docquantum/skrach-synth/code/skrach_core/skrach_core.runs/impl_1/.init_design.begin.rst

<?xml version="1.0"?>
<ProcessHandle Version="1" Minor="0">
    <Process Command=".planAhead." Owner="docquantum" Host="" Pid="888812">
    </Process>
</ProcessHandle>
