docquantum/skrach-synth/code/Skrach/Skrach.runs/skrach_design_axi_smc_0_synth_1/.vivado.begin.rst

<?xml version="1.0"?>
<ProcessHandle Version="1" Minor="0">
    <Process Command="vivado" Owner="docquantum" Host="QuantumNet-L4" Pid="184551" HostCore="8" HostMemory="16304656">
    </Process>
</ProcessHandle>
