docquantum/skrach-synth/code/Skrach/Skrach.runs/skrach_design_axi_uartlite_0_3_synth_1/.vivado.begin.rst

<?xml version="1.0"?>
<ProcessHandle Version="1" Minor="0">
    <Process Command="vivado" Owner="docquantum" Host="QuantumNet-L4" Pid="186545" HostCore="8" HostMemory="16304656">
    </Process>
</ProcessHandle>
