docquantum/skrach-synth/docs/img/datapath_control.odp

Nexys Video FPGA

(Block Design)

UARTLite

MicroBlaze

Control

Skrach Core (AXI Lite)

Operator

(12 ops@16bits)

Audio Codec

PMOD

ScanCode

32x8

phase

Oscillator

waveSel

Status

Q9.7

2

32

ADSR

ADSR

Console Output

8x4

Ampl

USB
UART

UARTLite

8

Mixer

L/R Out

Codec clocks, etc

DAC_DATA
