docquantum/skrach-synth/docs/img/level_1_diagram.odp

Audio to headphones or speaker

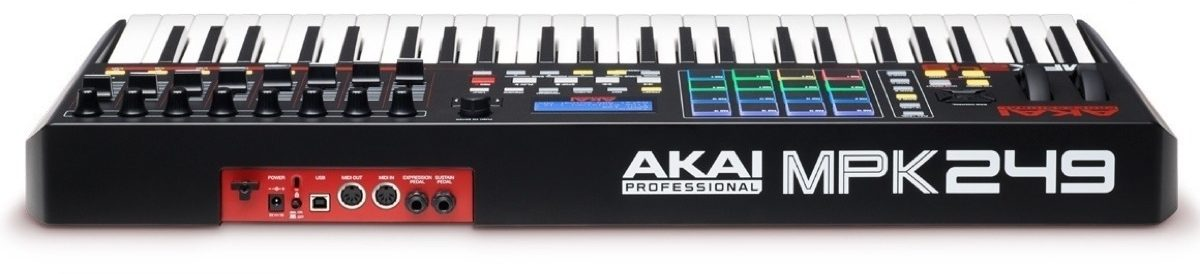
[picture p18: figure]
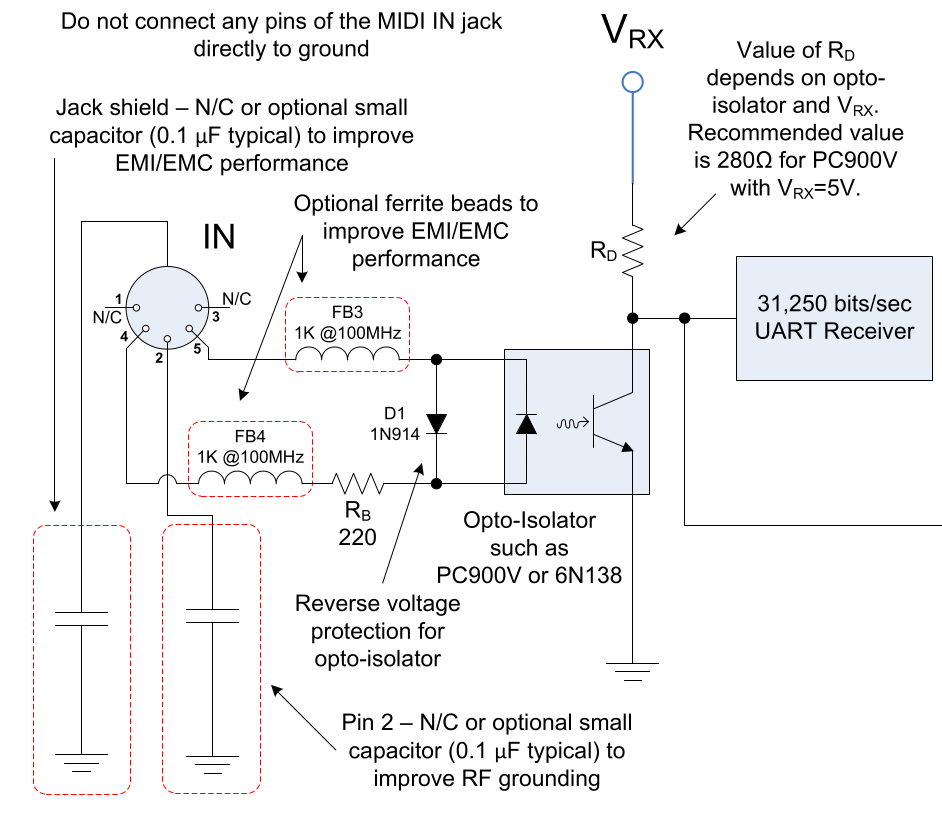
[picture p19: figure]
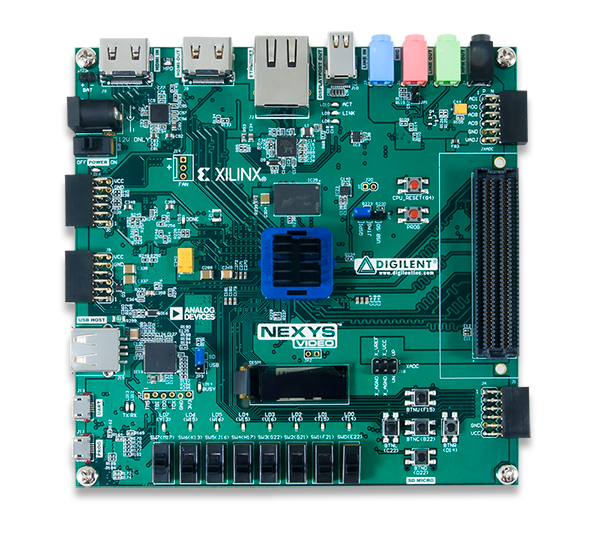
[picture p20: figure]

PMOD into board which implements the UART Receiver

Computer Control
