docquantum/skrach-synth/docs/img/fpga_connections.png

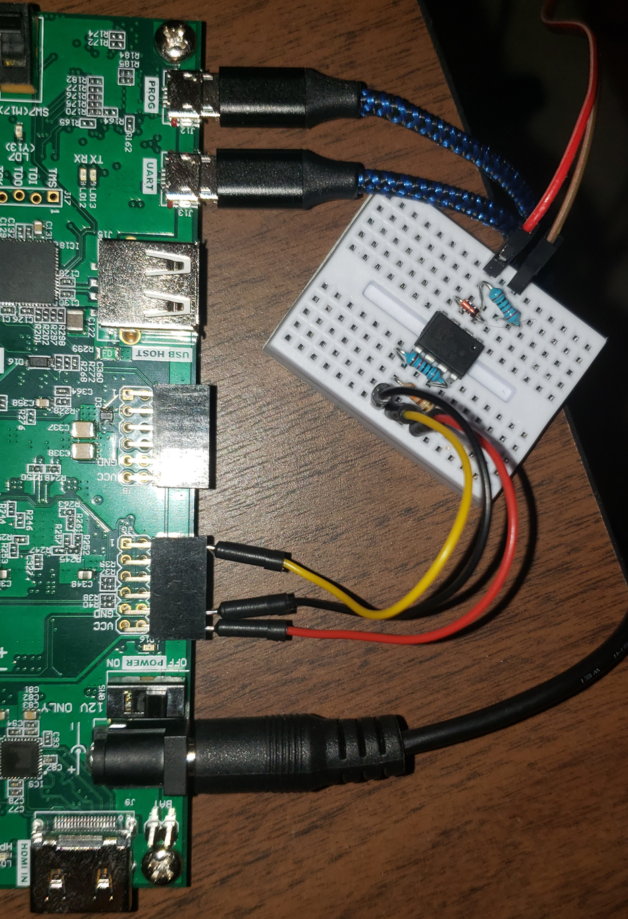
docs/img/fpga_connections.png
