docquantum/skrach-synth/(list of files, drawings)

Other design files:
docs/img/midiIn.fzz
