docquantum/skrach-synth/code/Skrach/Skrach.runs/skrach_design_axi_smc_0_synth_1/.Xil/skrach_design_axi_smc_0_propImpl.xdc

set_property SRC_FILE_INFO {cfile:/opt/Xilinx/Vivado/2019.1/data/ip/xpm/xpm_cdc/tcl/xpm_cdc_gray.tcl rfile:../../../../../../../../opt/Xilinx/Vivado/2019.1/data/ip/xpm/xpm_cdc/tcl/xpm_cdc_gray.tcl id:1 order:LATE scoped_inst:inst/m00_nodes/m00_ar_node/inst/inst_mi_handler/gen_normal_area.inst_fifo_node_payld/gen_xpm_memory_fifo.inst_fifo/gen_async_clocks.inst_cdc_addra_to_rd_clk unmanaged:yes} [current_design]
set_property SRC_FILE_INFO {cfile:/opt/Xilinx/Vivado/2019.1/data/ip/xpm/xpm_cdc/tcl/xpm_cdc_gray.tcl rfile:../../../../../../../../opt/Xilinx/Vivado/2019.1/data/ip/xpm/xpm_cdc/tcl/xpm_cdc_gray.tcl id:2 order:LATE scoped_inst:inst/m00_nodes/m00_ar_node/inst/inst_mi_handler/gen_normal_area.inst_fifo_node_payld/gen_xpm_memory_fifo.inst_fifo/gen_async_clocks.inst_cdc_addrb_to_wr_clk unmanaged:yes} [current_design]
set_property SRC_FILE_INFO {cfile:/opt/Xilinx/Vivado/2019.1/data/ip/xpm/xpm_cdc/tcl/xpm_cdc_gray.tcl rfile:../../../../../../../../opt/Xilinx/Vivado/2019.1/data/ip/xpm/xpm_cdc/tcl/xpm_cdc_gray.tcl id:3 order:LATE scoped_inst:inst/m00_nodes/m00_aw_node/inst/inst_mi_handler/gen_normal_area.inst_fifo_node_payld/gen_xpm_memory_fifo.inst_fifo/gen_async_clocks.inst_cdc_addra_to_rd_clk unmanaged:yes} [current_design]
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
set_property SRC_FILE_INFO {cfile:/opt/Xilinx/Vivado/2019.1/data/ip/xpm/xpm_memory/tcl/xpm_memory_xdc.tcl rfile:../../../../../../../../opt/Xilinx/Vivado/2019.1/data/ip/xpm/xpm_memory/tcl/xpm_memory_xdc.tcl id:22 order:LATE scoped_inst:{inst/m00_nodes/m00_w_node/inst/inst_si_handler/gen_si_handler.gen_request_fifos.gen_req_fifo[0].inst_req_fifo/gen_xpm_memory_fifo.inst_fifo/gen_mem_rep[0].inst_xpm_memory} unmanaged:yes} [current_design]
set_property SRC_FILE_INFO {cfile:/opt/Xilinx/Vivado/2019.1/data/ip/xpm/xpm_memory/tcl/xpm_memory_xdc.tcl rfile:../../../../../../../../opt/Xilinx/Vivado/2019.1/data/ip/xpm/xpm_memory/tcl/xpm_memory_xdc.tcl id:23 order:LATE scoped_inst:{inst/m00_nodes/m00_w_node/inst/inst_si_handler/gen_si_handler.gen_request_fifos.gen_req_fifo[1].inst_req_fifo/gen_xpm_memory_fifo.inst_fifo/gen_mem_rep[0].inst_xpm_memory} unmanaged:yes} [current_design]
set_property SRC_FILE_INFO {cfile:/opt/Xilinx/Vivado/2019.1/data/ip/xpm/xpm_memory/tcl/xpm_memory_xdc.tcl rfile:../../../../../../../../opt/Xilinx/Vivado/2019.1/data/ip/xpm/xpm_memory/tcl/xpm_memory_xdc.tcl id:24 order:LATE scoped_inst:{inst/m00_nodes/m00_w_node/inst/inst_mi_handler/gen_normal_area.inst_fifo_node_payld/gen_xpm_memory_fifo.inst_fifo/gen_mem_rep[0].inst_xpm_memory} unmanaged:yes} [current_design]
set_property SRC_FILE_INFO {cfile:/opt/Xilinx/Vivado/2019.1/data/ip/xpm/xpm_memory/tcl/xpm_memory_xdc.tcl rfile:../../../../../../../../opt/Xilinx/Vivado/2019.1/data/ip/xpm/xpm_memory/tcl/xpm_memory_xdc.tcl id:25 order:LATE scoped_inst:{inst/s00_nodes/s00_ar_node/inst/inst_mi_handler/gen_normal_area.gen_fifo_req.inst_fifo_req/gen_xpm_memory_fifo.inst_fifo/gen_mem_rep[0].inst_xpm_memory} unmanaged:yes} [current_design]
set_property SRC_FILE_INFO {cfile:/opt/Xilinx/Vivado/2019.1/data/ip/xpm/xpm_memory/tcl/xpm_memory_xdc.tcl rfile:../../../../../../../../opt/Xilinx/Vivado/2019.1/data/ip/xpm/xpm_memory/tcl/xpm_memory_xdc.tcl id:26 order:LATE scoped_inst:{inst/s00_nodes/s00_aw_node/inst/inst_mi_handler/gen_normal_area.gen_fifo_req.inst_fifo_req/gen_xpm_memory_fifo.inst_fifo/gen_mem_rep[0].inst_xpm_memory} unmanaged:yes} [current_design]
set_property SRC_FILE_INFO {cfile:/opt/Xilinx/Vivado/2019.1/data/ip/xpm/xpm_memory/tcl/xpm_memory_xdc.tcl rfile:../../../../../../../../opt/Xilinx/Vivado/2019.1/data/ip/xpm/xpm_memory/tcl/xpm_memory_xdc.tcl id:27 order:LATE scoped_inst:{inst/s00_nodes/s00_w_node/inst/inst_mi_handler/gen_normal_area.gen_fifo_req.inst_fifo_req/gen_xpm_memory_fifo.inst_fifo/gen_mem_rep[0].inst_xpm_memory} unmanaged:yes} [current_design]
set_property SRC_FILE_INFO {cfile:/opt/Xilinx/Vivado/2019.1/data/ip/xpm/xpm_memory/tcl/xpm_memory_xdc.tcl rfile:../../../../../../../../opt/Xilinx/Vivado/2019.1/data/ip/xpm/xpm_memory/tcl/xpm_memory_xdc.tcl id:28 order:LATE scoped_inst:{inst/s01_nodes/s01_ar_node/inst/inst_mi_handler/gen_normal_area.gen_fifo_req.inst_fifo_req/gen_xpm_memory_fifo.inst_fifo/gen_mem_rep[0].inst_xpm_memory} unmanaged:yes} [current_design]
set_property SRC_FILE_INFO {cfile:/opt/Xilinx/Vivado/2019.1/data/ip/xpm/xpm_memory/tcl/xpm_memory_xdc.tcl rfile:../../../../../../../../opt/Xilinx/Vivado/2019.1/data/ip/xpm/xpm_memory/tcl/xpm_memory_xdc.tcl id:29 order:LATE scoped_inst:{inst/s00_nodes/s00_ar_node/inst/inst_mi_handler/gen_normal_area.inst_fifo_node_payld/gen_xpm_memory_fifo.inst_fifo/gen_mem_rep[0].inst_xpm_memory} unmanaged:yes} [current_design]
set_property SRC_FILE_INFO {cfile:/opt/Xilinx/Vivado/2019.1/data/ip/xpm/xpm_memory/tcl/xpm_memory_xdc.tcl rfile:../../../../../../../../opt/Xilinx/Vivado/2019.1/data/ip/xpm/xpm_memory/tcl/xpm_memory_xdc.tcl id:30 order:LATE scoped_inst:{inst/s00_nodes/s00_aw_node/inst/inst_mi_handler/gen_normal_area.inst_fifo_node_payld/gen_xpm_memory_fifo.inst_fifo/gen_mem_rep[0].inst_xpm_memory} unmanaged:yes} [current_design]
set_property SRC_FILE_INFO {cfile:/opt/Xilinx/Vivado/2019.1/data/ip/xpm/xpm_memory/tcl/xpm_memory_xdc.tcl rfile:../../../../../../../../opt/Xilinx/Vivado/2019.1/data/ip/xpm/xpm_memory/tcl/xpm_memory_xdc.tcl id:31 order:LATE scoped_inst:{inst/s01_nodes/s01_ar_node/inst/inst_mi_handler/gen_normal_area.inst_fifo_node_payld/gen_xpm_memory_fifo.inst_fifo/gen_mem_rep[0].inst_xpm_memory} unmanaged:yes} [current_design]
set_property SRC_FILE_INFO {cfile:/opt/Xilinx/Vivado/2019.1/data/ip/xpm/xpm_memory/tcl/xpm_memory_xdc.tcl rfile:../../../../../../../../opt/Xilinx/Vivado/2019.1/data/ip/xpm/xpm_memory/tcl/xpm_memory_xdc.tcl id:32 order:LATE scoped_inst:{inst/s00_nodes/s00_b_node/inst/inst_mi_handler/gen_normal_area.gen_node_prog_full.inst_node_prog_full/gen_xpm_memory_fifo.inst_fifo/gen_mem_rep[0].inst_xpm_memory} unmanaged:yes} [current_design]
set_property SRC_FILE_INFO {cfile:/opt/Xilinx/Vivado/2019.1/data/ip/xpm/xpm_memory/tcl/xpm_memory_xdc.tcl rfile:../../../../../../../../opt/Xilinx/Vivado/2019.1/data/ip/xpm/xpm_memory/tcl/xpm_memory_xdc.tcl id:33 order:LATE scoped_inst:{inst/s00_nodes/s00_r_node/inst/inst_mi_handler/gen_normal_area.gen_node_prog_full.inst_node_prog_full/gen_xpm_memory_fifo.inst_fifo/gen_mem_rep[0].inst_xpm_memory} unmanaged:yes} [current_design]
set_property SRC_FILE_INFO {cfile:/opt/Xilinx/Vivado/2019.1/data/ip/xpm/xpm_memory/tcl/xpm_memory_xdc.tcl rfile:../../../../../../../../opt/Xilinx/Vivado/2019.1/data/ip/xpm/xpm_memory/tcl/xpm_memory_xdc.tcl id:34 order:LATE scoped_inst:{inst/s01_nodes/s01_r_node/inst/inst_mi_handler/gen_normal_area.gen_node_prog_full.inst_node_prog_full/gen_xpm_memory_fifo.inst_fifo/gen_mem_rep[0].inst_xpm_memory} unmanaged:yes} [current_design]
set_property SRC_FILE_INFO {cfile:/opt/Xilinx/Vivado/2019.1/data/ip/xpm/xpm_memory/tcl/xpm_memory_xdc.tcl rfile:../../../../../../../../opt/Xilinx/Vivado/2019.1/data/ip/xpm/xpm_memory/tcl/xpm_memory_xdc.tcl id:35 order:LATE scoped_inst:{inst/s00_nodes/s00_b_node/inst/inst_mi_handler/gen_normal_area.inst_fifo_node_payld/gen_xpm_memory_fifo.inst_fifo/gen_mem_rep[0].inst_xpm_memory} unmanaged:yes} [current_design]
set_property SRC_FILE_INFO {cfile:/opt/Xilinx/Vivado/2019.1/data/ip/xpm/xpm_memory/tcl/xpm_memory_xdc.tcl rfile:../../../../../../../../opt/Xilinx/Vivado/2019.1/data/ip/xpm/xpm_memory/tcl/xpm_memory_xdc.tcl id:36 order:LATE scoped_inst:{inst/s00_nodes/s00_r_node/inst/inst_mi_handler/gen_normal_area.inst_fifo_node_payld/gen_xpm_memory_fifo.inst_fifo/gen_mem_rep[0].inst_xpm_memory} unmanaged:yes} [current_design]
set_property SRC_FILE_INFO {cfile:/opt/Xilinx/Vivado/2019.1/data/ip/xpm/xpm_memory/tcl/xpm_memory_xdc.tcl rfile:../../../../../../../../opt/Xilinx/Vivado/2019.1/data/ip/xpm/xpm_memory/tcl/xpm_memory_xdc.tcl id:37 order:LATE scoped_inst:{inst/s01_nodes/s01_r_node/inst/inst_mi_handler/gen_normal_area.inst_fifo_node_payld/gen_xpm_memory_fifo.inst_fifo/gen_mem_rep[0].inst_xpm_memory} unmanaged:yes} [current_design]
current_instance inst/m00_nodes/m00_ar_node/inst/inst_mi_handler/gen_normal_area.inst_fifo_node_payld/gen_xpm_memory_fifo.inst_fifo/gen_async_clocks.inst_cdc_addra_to_rd_clk
set_property src_info {type:SCOPED_XDC file:1 line:23 export:INPUT save:NONE read:READ} [current_design]
create_waiver -internal -scoped -type CDC -id {CDC-6} -user "xpm_cdc" -tags "1009444" -desc "The CDC-6 warning is waived as it is safe in the context of XPM_CDC_GRAY." -from [get_pins -quiet {src_gray_ff_reg*/C}] -to [get_pins -quiet {dest_graysync_ff_reg*/D}]
current_instance
current_instance inst/m00_nodes/m00_ar_node/inst/inst_mi_handler/gen_normal_area.inst_fifo_node_payld/gen_xpm_memory_fifo.inst_fifo/gen_async_clocks.inst_cdc_addrb_to_wr_clk
set_property src_info {type:SCOPED_XDC file:2 line:23 export:INPUT save:NONE read:READ} [current_design]
create_waiver -internal -scoped -type CDC -id {CDC-6} -user "xpm_cdc" -tags "1009444" -desc "The CDC-6 warning is waived as it is safe in the context of XPM_CDC_GRAY." -from [get_pins -quiet {src_gray_ff_reg*/C}] -to [get_pins -quiet {dest_graysync_ff_reg*/D}]
current_instance
current_instance inst/m00_nodes/m00_aw_node/inst/inst_mi_handler/gen_normal_area.inst_fifo_node_payld/gen_xpm_memory_fifo.inst_fifo/gen_async_clocks.inst_cdc_addra_to_rd_clk
set_property src_info {type:SCOPED_XDC file:3 line:23 export:INPUT save:NONE read:READ} [current_design]
create_waiver -internal -scoped -type CDC -id {CDC-6} -user "xpm_cdc" -tags "1009444" -desc "The CDC-6 warning is waived as it is safe in the context of XPM_CDC_GRAY." -from [get_pins -quiet {src_gray_ff_reg*/C}] -to [get_pins -quiet {dest_graysync_ff_reg*/D}]
current_instance
current_instance inst/m00_nodes/m00_aw_node/inst/inst_mi_handler/gen_normal_area.inst_fifo_node_payld/gen_xpm_memory_fifo.inst_fifo/gen_async_clocks.inst_cdc_addrb_to_wr_clk
set_property src_info {type:SCOPED_XDC file:4 line:23 export:INPUT save:NONE read:READ} [current_design]
create_waiver -internal -scoped -type CDC -id {CDC-6} -user "xpm_cdc" -tags "1009444" -desc "The CDC-6 warning is waived as it is safe in the context of XPM_CDC_GRAY." -from [get_pins -quiet {src_gray_ff_reg*/C}] -to [get_pins -quiet {dest_graysync_ff_reg*/D}]
current_instance
current_instance inst/m00_nodes/m00_b_node/inst/inst_mi_handler/gen_normal_area.gen_fifo_req.inst_fifo_req/gen_xpm_memory_fifo.inst_fifo/gen_async_clocks.inst_cdc_addra_to_rd_clk
set_property src_info {type:SCOPED_XDC file:5 line:23 export:INPUT save:NONE read:READ} [current_design]
create_waiver -internal -scoped -type CDC -id {CDC-6} -user "xpm_cdc" -tags "1009444" -desc "The CDC-6 warning is waived as it is safe in the context of XPM_CDC_GRAY." -from [get_pins -quiet {src_gray_ff_reg*/C}] -to [get_pins -quiet {dest_graysync_ff_reg*/D}]
current_instance
current_instance inst/m00_nodes/m00_b_node/inst/inst_mi_handler/gen_normal_area.gen_fifo_req.inst_fifo_req/gen_xpm_memory_fifo.inst_fifo/gen_async_clocks.inst_cdc_addrb_to_wr_clk
set_property src_info {type:SCOPED_XDC file:6 line:23 export:INPUT save:NONE read:READ} [current_design]
create_waiver -internal -scoped -type CDC -id {CDC-6} -user "xpm_cdc" -tags "1009444" -desc "The CDC-6 warning is waived as it is safe in the context of XPM_CDC_GRAY." -from [get_pins -quiet {src_gray_ff_reg*/C}] -to [get_pins -quiet {dest_graysync_ff_reg*/D}]
current_instance
current_instance inst/m00_nodes/m00_b_node/inst/inst_mi_handler/gen_normal_area.inst_fifo_node_payld/gen_xpm_memory_fifo.inst_fifo/gen_async_clocks.inst_cdc_addra_to_rd_clk
set_property src_info {type:SCOPED_XDC file:7 line:23 export:INPUT save:NONE read:READ} [current_design]
create_waiver -internal -scoped -type CDC -id {CDC-6} -user "xpm_cdc" -tags "1009444" -desc "The CDC-6 warning is waived as it is safe in the context of XPM_CDC_GRAY." -from [get_pins -quiet {src_gray_ff_reg*/C}] -to [get_pins -quiet {dest_graysync_ff_reg*/D}]
current_instance
current_instance inst/m00_nodes/m00_b_node/inst/inst_mi_handler/gen_normal_area.inst_fifo_node_payld/gen_xpm_memory_fifo.inst_fifo/gen_async_clocks.inst_cdc_addrb_to_wr_clk
set_property src_info {type:SCOPED_XDC file:8 line:23 export:INPUT save:NONE read:READ} [current_design]
create_waiver -internal -scoped -type CDC -id {CDC-6} -user "xpm_cdc" -tags "1009444" -desc "The CDC-6 warning is waived as it is safe in the context of XPM_CDC_GRAY." -from [get_pins -quiet {src_gray_ff_reg*/C}] -to [get_pins -quiet {dest_graysync_ff_reg*/D}]
current_instance
current_instance inst/m00_nodes/m00_r_node/inst/inst_mi_handler/gen_normal_area.gen_fifo_req.inst_fifo_req/gen_xpm_memory_fifo.inst_fifo/gen_async_clocks.inst_cdc_addra_to_rd_clk
set_property src_info {type:SCOPED_XDC file:9 line:23 export:INPUT save:NONE read:READ} [current_design]
create_waiver -internal -scoped -type CDC -id {CDC-6} -user "xpm_cdc" -tags "1009444" -desc "The CDC-6 warning is waived as it is safe in the context of XPM_CDC_GRAY." -from [get_pins -quiet {src_gray_ff_reg*/C}] -to [get_pins -quiet {dest_graysync_ff_reg*/D}]
current_instance
current_instance inst/m00_nodes/m00_r_node/inst/inst_mi_handler/gen_normal_area.gen_fifo_req.inst_fifo_req/gen_xpm_memory_fifo.inst_fifo/gen_async_clocks.inst_cdc_addrb_to_wr_clk
set_property src_info {type:SCOPED_XDC file:10 line:23 export:INPUT save:NONE read:READ} [current_design]
create_waiver -internal -scoped -type CDC -id {CDC-6} -user "xpm_cdc" -tags "1009444" -desc "The CDC-6 warning is waived as it is safe in the context of XPM_CDC_GRAY." -from [get_pins -quiet {src_gray_ff_reg*/C}] -to [get_pins -quiet {dest_graysync_ff_reg*/D}]
current_instance
current_instance inst/m00_nodes/m00_r_node/inst/inst_mi_handler/gen_normal_area.inst_fifo_node_payld/gen_xpm_memory_fifo.inst_fifo/gen_async_clocks.inst_cdc_addra_to_rd_clk
set_property src_info {type:SCOPED_XDC file:11 line:23 export:INPUT save:NONE read:READ} [current_design]
create_waiver -internal -scoped -type CDC -id {CDC-6} -user "xpm_cdc" -tags "1009444" -desc "The CDC-6 warning is waived as it is safe in the context of XPM_CDC_GRAY." -from [get_pins -quiet {src_gray_ff_reg*/C}] -to [get_pins -quiet {dest_graysync_ff_reg*/D}]
current_instance
current_instance inst/m00_nodes/m00_r_node/inst/inst_mi_handler/gen_normal_area.inst_fifo_node_payld/gen_xpm_memory_fifo.inst_fifo/gen_async_clocks.inst_cdc_addrb_to_wr_clk
set_property src_info {type:SCOPED_XDC file:12 line:23 export:INPUT save:NONE read:READ} [current_design]
create_waiver -internal -scoped -type CDC -id {CDC-6} -user "xpm_cdc" -tags "1009444" -desc "The CDC-6 warning is waived as it is safe in the context of XPM_CDC_GRAY." -from [get_pins -quiet {src_gray_ff_reg*/C}] -to [get_pins -quiet {dest_graysync_ff_reg*/D}]
current_instance
current_instance inst/m00_nodes/m00_w_node/inst/inst_mi_handler/gen_normal_area.inst_fifo_node_payld/gen_xpm_memory_fifo.inst_fifo/gen_async_clocks.inst_cdc_addra_to_rd_clk
set_property src_info {type:SCOPED_XDC file:13 line:23 export:INPUT save:NONE read:READ} [current_design]
create_waiver -internal -scoped -type CDC -id {CDC-6} -user "xpm_cdc" -tags "1009444" -desc "The CDC-6 warning is waived as it is safe in the context of XPM_CDC_GRAY." -from [get_pins -quiet {src_gray_ff_reg*/C}] -to [get_pins -quiet {dest_graysync_ff_reg*/D}]
current_instance
current_instance inst/m00_nodes/m00_w_node/inst/inst_mi_handler/gen_normal_area.inst_fifo_node_payld/gen_xpm_memory_fifo.inst_fifo/gen_async_clocks.inst_cdc_addrb_to_wr_clk
set_property src_info {type:SCOPED_XDC file:14 line:23 export:INPUT save:NONE read:READ} [current_design]
create_waiver -internal -scoped -type CDC -id {CDC-6} -user "xpm_cdc" -tags "1009444" -desc "The CDC-6 warning is waived as it is safe in the context of XPM_CDC_GRAY." -from [get_pins -quiet {src_gray_ff_reg*/C}] -to [get_pins -quiet {dest_graysync_ff_reg*/D}]
current_instance
current_instance {inst/m00_nodes/m00_ar_node/inst/inst_mi_handler/gen_normal_area.inst_fifo_node_payld/gen_xpm_memory_fifo.inst_fifo/gen_mem_rep[0].inst_xpm_memory}
set_property src_info {type:SCOPED_XDC file:15 line:3 export:INPUT save:NONE read:READ} [current_design]
set my_var [get_property dram_emb_xdc [get_cells -hier  -filter {PRIMITIVE_SUBGROUP==LUTRAM || PRIMITIVE_SUBGROUP==dram || PRIMITIVE_SUBGROUP==uram || PRIMITIVE_SUBGROUP==BRAM}]]
current_instance
current_instance {inst/m00_nodes/m00_aw_node/inst/inst_mi_handler/gen_normal_area.inst_fifo_node_payld/gen_xpm_memory_fifo.inst_fifo/gen_mem_rep[0].inst_xpm_memory}
set_property src_info {type:SCOPED_XDC file:16 line:3 export:INPUT save:NONE read:READ} [current_design]
set my_var [get_property dram_emb_xdc [get_cells -hier  -filter {PRIMITIVE_SUBGROUP==LUTRAM || PRIMITIVE_SUBGROUP==dram || PRIMITIVE_SUBGROUP==uram || PRIMITIVE_SUBGROUP==BRAM}]]
current_instance
current_instance {inst/m00_nodes/m00_b_node/inst/inst_mi_handler/gen_normal_area.gen_fifo_req.inst_fifo_req/gen_xpm_memory_fifo.inst_fifo/gen_mem_rep[0].inst_xpm_memory}
set_property src_info {type:SCOPED_XDC file:17 line:3 export:INPUT save:NONE read:READ} [current_design]
set my_var [get_property dram_emb_xdc [get_cells -hier  -filter {PRIMITIVE_SUBGROUP==LUTRAM || PRIMITIVE_SUBGROUP==dram || PRIMITIVE_SUBGROUP==uram || PRIMITIVE_SUBGROUP==BRAM}]]
current_instance
current_instance {inst/m00_nodes/m00_r_node/inst/inst_mi_handler/gen_normal_area.gen_fifo_req.inst_fifo_req/gen_xpm_memory_fifo.inst_fifo/gen_mem_rep[0].inst_xpm_memory}
set_property src_info {type:SCOPED_XDC file:18 line:3 export:INPUT save:NONE read:READ} [current_design]
set my_var [get_property dram_emb_xdc [get_cells -hier  -filter {PRIMITIVE_SUBGROUP==LUTRAM || PRIMITIVE_SUBGROUP==dram || PRIMITIVE_SUBGROUP==uram || PRIMITIVE_SUBGROUP==BRAM}]]
current_instance
current_instance {inst/m00_nodes/m00_b_node/inst/inst_mi_handler/gen_normal_area.inst_fifo_node_payld/gen_xpm_memory_fifo.inst_fifo/gen_mem_rep[0].inst_xpm_memory}
set_property src_info {type:SCOPED_XDC file:19 line:3 export:INPUT save:NONE read:READ} [current_design]
set my_var [get_property dram_emb_xdc [get_cells -hier  -filter {PRIMITIVE_SUBGROUP==LUTRAM || PRIMITIVE_SUBGROUP==dram || PRIMITIVE_SUBGROUP==uram || PRIMITIVE_SUBGROUP==BRAM}]]
current_instance
current_instance {inst/s00_nodes/s00_w_node/inst/inst_mi_handler/gen_normal_area.inst_fifo_node_payld/gen_xpm_memory_fifo.inst_fifo/gen_mem_rep[0].inst_xpm_memory}
set_property src_info {type:SCOPED_XDC file:20 line:3 export:INPUT save:NONE read:READ} [current_design]
set my_var [get_property dram_emb_xdc [get_cells -hier  -filter {PRIMITIVE_SUBGROUP==LUTRAM || PRIMITIVE_SUBGROUP==dram || PRIMITIVE_SUBGROUP==uram || PRIMITIVE_SUBGROUP==BRAM}]]
current_instance
current_instance {inst/m00_nodes/m00_r_node/inst/inst_mi_handler/gen_normal_area.inst_fifo_node_payld/gen_xpm_memory_fifo.inst_fifo/gen_mem_rep[0].inst_xpm_memory}
set_property src_info {type:SCOPED_XDC file:21 line:3 export:INPUT save:NONE read:READ} [current_design]
set my_var [get_property dram_emb_xdc [get_cells -hier  -filter {PRIMITIVE_SUBGROUP==LUTRAM || PRIMITIVE_SUBGROUP==dram || PRIMITIVE_SUBGROUP==uram || PRIMITIVE_SUBGROUP==BRAM}]]
current_instance
current_instance {inst/m00_nodes/m00_w_node/inst/inst_si_handler/gen_si_handler.gen_request_fifos.gen_req_fifo[0].inst_req_fifo/gen_xpm_memory_fifo.inst_fifo/gen_mem_rep[0].inst_xpm_memory}
set_property src_info {type:SCOPED_XDC file:22 line:3 export:INPUT save:NONE read:READ} [current_design]
set my_var [get_property dram_emb_xdc [get_cells -hier  -filter {PRIMITIVE_SUBGROUP==LUTRAM || PRIMITIVE_SUBGROUP==dram || PRIMITIVE_SUBGROUP==uram || PRIMITIVE_SUBGROUP==BRAM}]]
current_instance
current_instance {inst/m00_nodes/m00_w_node/inst/inst_si_handler/gen_si_handler.gen_request_fifos.gen_req_fifo[1].inst_req_fifo/gen_xpm_memory_fifo.inst_fifo/gen_mem_rep[0].inst_xpm_memory}
set_property src_info {type:SCOPED_XDC file:23 line:3 export:INPUT save:NONE read:READ} [current_design]
set my_var [get_property dram_emb_xdc [get_cells -hier  -filter {PRIMITIVE_SUBGROUP==LUTRAM || PRIMITIVE_SUBGROUP==dram || PRIMITIVE_SUBGROUP==uram || PRIMITIVE_SUBGROUP==BRAM}]]
current_instance
current_instance {inst/m00_nodes/m00_w_node/inst/inst_mi_handler/gen_normal_area.inst_fifo_node_payld/gen_xpm_memory_fifo.inst_fifo/gen_mem_rep[0].inst_xpm_memory}
set_property src_info {type:SCOPED_XDC file:24 line:3 export:INPUT save:NONE read:READ} [current_design]
set my_var [get_property dram_emb_xdc [get_cells -hier  -filter {PRIMITIVE_SUBGROUP==LUTRAM || PRIMITIVE_SUBGROUP==dram || PRIMITIVE_SUBGROUP==uram || PRIMITIVE_SUBGROUP==BRAM}]]
current_instance
current_instance {inst/s00_nodes/s00_ar_node/inst/inst_mi_handler/gen_normal_area.gen_fifo_req.inst_fifo_req/gen_xpm_memory_fifo.inst_fifo/gen_mem_rep[0].inst_xpm_memory}
set_property src_info {type:SCOPED_XDC file:25 line:3 export:INPUT save:NONE read:READ} [current_design]
set my_var [get_property dram_emb_xdc [get_cells -hier  -filter {PRIMITIVE_SUBGROUP==LUTRAM || PRIMITIVE_SUBGROUP==dram || PRIMITIVE_SUBGROUP==uram || PRIMITIVE_SUBGROUP==BRAM}]]
current_instance
current_instance {inst/s00_nodes/s00_aw_node/inst/inst_mi_handler/gen_normal_area.gen_fifo_req.inst_fifo_req/gen_xpm_memory_fifo.inst_fifo/gen_mem_rep[0].inst_xpm_memory}
set_property src_info {type:SCOPED_XDC file:26 line:3 export:INPUT save:NONE read:READ} [current_design]
set my_var [get_property dram_emb_xdc [get_cells -hier  -filter {PRIMITIVE_SUBGROUP==LUTRAM || PRIMITIVE_SUBGROUP==dram || PRIMITIVE_SUBGROUP==uram || PRIMITIVE_SUBGROUP==BRAM}]]
current_instance
current_instance {inst/s00_nodes/s00_w_node/inst/inst_mi_handler/gen_normal_area.gen_fifo_req.inst_fifo_req/gen_xpm_memory_fifo.inst_fifo/gen_mem_rep[0].inst_xpm_memory}
set_property src_info {type:SCOPED_XDC file:27 line:3 export:INPUT save:NONE read:READ} [current_design]
set my_var [get_property dram_emb_xdc [get_cells -hier  -filter {PRIMITIVE_SUBGROUP==LUTRAM || PRIMITIVE_SUBGROUP==dram || PRIMITIVE_SUBGROUP==uram || PRIMITIVE_SUBGROUP==BRAM}]]
current_instance
current_instance {inst/s01_nodes/s01_ar_node/inst/inst_mi_handler/gen_normal_area.gen_fifo_req.inst_fifo_req/gen_xpm_memory_fifo.inst_fifo/gen_mem_rep[0].inst_xpm_memory}
set_property src_info {type:SCOPED_XDC file:28 line:3 export:INPUT save:NONE read:READ} [current_design]
set my_var [get_property dram_emb_xdc [get_cells -hier  -filter {PRIMITIVE_SUBGROUP==LUTRAM || PRIMITIVE_SUBGROUP==dram || PRIMITIVE_SUBGROUP==uram || PRIMITIVE_SUBGROUP==BRAM}]]
current_instance
current_instance {inst/s00_nodes/s00_ar_node/inst/inst_mi_handler/gen_normal_area.inst_fifo_node_payld/gen_xpm_memory_fifo.inst_fifo/gen_mem_rep[0].inst_xpm_memory}
set_property src_info {type:SCOPED_XDC file:29 line:3 export:INPUT save:NONE read:READ} [current_design]
set my_var [get_property dram_emb_xdc [get_cells -hier  -filter {PRIMITIVE_SUBGROUP==LUTRAM || PRIMITIVE_SUBGROUP==dram || PRIMITIVE_SUBGROUP==uram || PRIMITIVE_SUBGROUP==BRAM}]]
current_instance
current_instance {inst/s00_nodes/s00_aw_node/inst/inst_mi_handler/gen_normal_area.inst_fifo_node_payld/gen_xpm_memory_fifo.inst_fifo/gen_mem_rep[0].inst_xpm_memory}
set_property src_info {type:SCOPED_XDC file:30 line:3 export:INPUT save:NONE read:READ} [current_design]
set my_var [get_property dram_emb_xdc [get_cells -hier  -filter {PRIMITIVE_SUBGROUP==LUTRAM || PRIMITIVE_SUBGROUP==dram || PRIMITIVE_SUBGROUP==uram || PRIMITIVE_SUBGROUP==BRAM}]]
current_instance
current_instance {inst/s01_nodes/s01_ar_node/inst/inst_mi_handler/gen_normal_area.inst_fifo_node_payld/gen_xpm_memory_fifo.inst_fifo/gen_mem_rep[0].inst_xpm_memory}
set_property src_info {type:SCOPED_XDC file:31 line:3 export:INPUT save:NONE read:READ} [current_design]
set my_var [get_property dram_emb_xdc [get_cells -hier  -filter {PRIMITIVE_SUBGROUP==LUTRAM || PRIMITIVE_SUBGROUP==dram || PRIMITIVE_SUBGROUP==uram || PRIMITIVE_SUBGROUP==BRAM}]]
current_instance
current_instance {inst/s00_nodes/s00_b_node/inst/inst_mi_handler/gen_normal_area.gen_node_prog_full.inst_node_prog_full/gen_xpm_memory_fifo.inst_fifo/gen_mem_rep[0].inst_xpm_memory}
set_property src_info {type:SCOPED_XDC file:32 line:3 export:INPUT save:NONE read:READ} [current_design]
set my_var [get_property dram_emb_xdc [get_cells -hier  -filter {PRIMITIVE_SUBGROUP==LUTRAM || PRIMITIVE_SUBGROUP==dram || PRIMITIVE_SUBGROUP==uram || PRIMITIVE_SUBGROUP==BRAM}]]
current_instance
current_instance {inst/s00_nodes/s00_r_node/inst/inst_mi_handler/gen_normal_area.gen_node_prog_full.inst_node_prog_full/gen_xpm_memory_fifo.inst_fifo/gen_mem_rep[0].inst_xpm_memory}
set_property src_info {type:SCOPED_XDC file:33 line:3 export:INPUT save:NONE read:READ} [current_design]
set my_var [get_property dram_emb_xdc [get_cells -hier  -filter {PRIMITIVE_SUBGROUP==LUTRAM || PRIMITIVE_SUBGROUP==dram || PRIMITIVE_SUBGROUP==uram || PRIMITIVE_SUBGROUP==BRAM}]]
current_instance
current_instance {inst/s01_nodes/s01_r_node/inst/inst_mi_handler/gen_normal_area.gen_node_prog_full.inst_node_prog_full/gen_xpm_memory_fifo.inst_fifo/gen_mem_rep[0].inst_xpm_memory}
set_property src_info {type:SCOPED_XDC file:34 line:3 export:INPUT save:NONE read:READ} [current_design]
set my_var [get_property dram_emb_xdc [get_cells -hier  -filter {PRIMITIVE_SUBGROUP==LUTRAM || PRIMITIVE_SUBGROUP==dram || PRIMITIVE_SUBGROUP==uram || PRIMITIVE_SUBGROUP==BRAM}]]
current_instance
current_instance {inst/s00_nodes/s00_b_node/inst/inst_mi_handler/gen_normal_area.inst_fifo_node_payld/gen_xpm_memory_fifo.inst_fifo/gen_mem_rep[0].inst_xpm_memory}
set_property src_info {type:SCOPED_XDC file:35 line:3 export:INPUT save:NONE read:READ} [current_design]
set my_var [get_property dram_emb_xdc [get_cells -hier  -filter {PRIMITIVE_SUBGROUP==LUTRAM || PRIMITIVE_SUBGROUP==dram || PRIMITIVE_SUBGROUP==uram || PRIMITIVE_SUBGROUP==BRAM}]]
current_instance
current_instance {inst/s00_nodes/s00_r_node/inst/inst_mi_handler/gen_normal_area.inst_fifo_node_payld/gen_xpm_memory_fifo.inst_fifo/gen_mem_rep[0].inst_xpm_memory}
set_property src_info {type:SCOPED_XDC file:36 line:3 export:INPUT save:NONE read:READ} [current_design]
set my_var [get_property dram_emb_xdc [get_cells -hier  -filter {PRIMITIVE_SUBGROUP==LUTRAM || PRIMITIVE_SUBGROUP==dram || PRIMITIVE_SUBGROUP==uram || PRIMITIVE_SUBGROUP==BRAM}]]
current_instance
current_instance {inst/s01_nodes/s01_r_node/inst/inst_mi_handler/gen_normal_area.inst_fifo_node_payld/gen_xpm_memory_fifo.inst_fifo/gen_mem_rep[0].inst_xpm_memory}
set_property src_info {type:SCOPED_XDC file:37 line:3 export:INPUT save:NONE read:READ} [current_design]
set my_var [get_property dram_emb_xdc [get_cells -hier  -filter {PRIMITIVE_SUBGROUP==LUTRAM || PRIMITIVE_SUBGROUP==dram || PRIMITIVE_SUBGROUP==uram || PRIMITIVE_SUBGROUP==BRAM}]]
