docquantum/skrach-synth/code/Skrach/Skrach.runs/skrach_design_microblaze_0_3_synth_1/.Xil/skrach_design_microblaze_0_3_propImpl.xdc

set_property SRC_FILE_INFO {cfile:/home/docquantum/ce446_solovey/final/code/Skrach.srcs/sources_1/bd/skrach_design/ip/skrach_design_microblaze_0_3/skrach_design_microblaze_0_3.xdc rfile:../../../Skrach.srcs/sources_1/bd/skrach_design/ip/skrach_design_microblaze_0_3/skrach_design_microblaze_0_3.xdc id:1 order:EARLY scoped_inst:U0} [current_design]
current_instance U0
set_property src_info {type:SCOPED_XDC file:1 line:2 export:INPUT save:INPUT read:READ} [current_design]
create_waiver -internal -quiet -user microblaze -tags 12436 -type CDC -id CDC-26 -description "Invalid LUTRAM collision warning" -to [get_pins -quiet "LOCKSTEP_Out_reg\[*\]/R"]
set_property src_info {type:SCOPED_XDC file:1 line:4 export:INPUT save:INPUT read:READ} [current_design]
create_waiver -internal -quiet -user microblaze -tags 12436 -type CDC -id CDC-26 -description "Invalid LUTRAM collision warning" -to [get_pins -quiet "MicroBlaze_Core_I/*Interrupt_DFF/Single_Synchronize.use_sync_reset.sync_reg/D"]
set_property src_info {type:SCOPED_XDC file:1 line:8 export:INPUT save:INPUT read:READ} [current_design]
create_waiver -internal -quiet -user microblaze -tags 12436 -type DRC -id DPIP-2 -description "Non-pipelined by design" -objects [get_cells -hierarchical *DSP48E1_I1] -objects [get_pins -quiet -filter {REF_PIN_NAME=~A[*]} -of [get_cells -hierarchical *DSP48E1_I1]]
set_property src_info {type:SCOPED_XDC file:1 line:11 export:INPUT save:INPUT read:READ} [current_design]
create_waiver -internal -quiet -user microblaze -tags 12436 -type DRC -id DPIP-2 -description "Non-pipelined by design" -objects [get_cells -hierarchical *DSP48E1_I1] -objects [get_pins -quiet -filter {REF_PIN_NAME=~B[*]} -of [get_cells -hierarchical *DSP48E1_I1]]
set_property src_info {type:SCOPED_XDC file:1 line:14 export:INPUT save:INPUT read:READ} [current_design]
create_waiver -internal -quiet -user microblaze -tags 12436 -type DRC -id DPOP-3 -description "Non-pipelined by design" -objects [get_cells -hierarchical *DSP48E1_I1] -objects [get_pins -quiet -filter {REF_PIN_NAME=~P*} -of [get_cells -hierarchical *DSP48E1_I1]]
set_property src_info {type:SCOPED_XDC file:1 line:17 export:INPUT save:INPUT read:READ} [current_design]
create_waiver -internal -quiet -user microblaze -tags 12436 -type DRC -id DPOP-3 -description "Non-pipelined by design" -objects [get_cells -hierarchical *DSP48E1_I1] -objects [get_pins -quiet -filter {REF_PIN_NAME=~PATTERN*} -of [get_cells -hierarchical *DSP48E1_I1]]
set_property src_info {type:SCOPED_XDC file:1 line:20 export:INPUT save:INPUT read:READ} [current_design]
create_waiver -internal -quiet -user microblaze -tags 12436 -type DRC -id DPOP-3 -description "Non-pipelined by design" -objects [get_cells -hierarchical *DSP48E1_I1] -objects [get_pins -quiet -filter {REF_PIN_NAME=~*OUT*} -of [get_cells -hierarchical *DSP48E1_I1]]
set_property src_info {type:SCOPED_XDC file:1 line:23 export:INPUT save:INPUT read:READ} [current_design]
create_waiver -internal -quiet -user microblaze -tags 12436 -type DRC -id DPOP-4 -description "Non-pipelined by design" -objects [get_cells -hierarchical *DSP48E1_I1] -objects [get_pins -quiet -filter {REF_PIN_NAME=~P[*]} -of [get_cells -hierarchical *DSP48E1_I1]]
set_property src_info {type:SCOPED_XDC file:1 line:26 export:INPUT save:INPUT read:READ} [current_design]
create_waiver -internal -quiet -user microblaze -tags 12436 -type DRC -id DPOP-4 -description "Non-pipelined by design" -objects [get_cells -hierarchical *DSP48E1_I1] -objects [get_pins -quiet -filter {REF_PIN_NAME=~PATTERN*} -of [get_cells -hierarchical *DSP48E1_I1]]
set_property src_info {type:SCOPED_XDC file:1 line:29 export:INPUT save:INPUT read:READ} [current_design]
create_waiver -internal -quiet -user microblaze -tags 12436 -type DRC -id DPOP-4 -description "Non-pipelined by design" -objects [get_cells -hierarchical *DSP48E1_I1] -objects [get_pins -quiet -filter {REF_PIN_NAME=~*OUT*} -of [get_cells -hierarchical *DSP48E1_I1]]
set_property src_info {type:SCOPED_XDC file:1 line:34 export:INPUT save:INPUT read:READ} [current_design]
create_waiver -internal -quiet -user microblaze -tags 12436 -type CDC -id CDC-10 -description "Asynchronous reset" -to [get_pins -quiet "MicroBlaze_Core_I/Reset_DFF/Synchronize.use_sync_reset.sync_reg\[1\]/D"]
set_property src_info {type:SCOPED_XDC file:1 line:38 export:INPUT save:INPUT read:READ} [current_design]
create_waiver -internal -quiet -user microblaze -tags 12436 -type CDC -id CDC-1 -description "Debug protocol ensures stable signals" -from *PIN -to   [get_pins -quiet MicroBlaze_Core_I/*.Core/*Debug_Logic.Master_Core.Debug*/Serial_Dbg_Intf.capture_1_reg/D]
set_property src_info {type:SCOPED_XDC file:1 line:41 export:INPUT save:INPUT read:READ} [current_design]
create_waiver -internal -quiet -user microblaze -tags 12436 -type CDC -id CDC-1 -description "Debug protocol ensures stable signals" -from *PIN -to   [get_pins -quiet MicroBlaze_Core_I/*.Core/*Debug_Logic.Master_Core.Debug*/Serial_Dbg_Intf.data_read_reg_reg\[*\]/CE]
set_property src_info {type:SCOPED_XDC file:1 line:44 export:INPUT save:INPUT read:READ} [current_design]
create_waiver -internal -quiet -user microblaze -tags 12436 -type CDC -id CDC-1 -description "Debug protocol ensures stable signals" -from *PIN -to   [get_pins -quiet MicroBlaze_Core_I/*.Core/*Debug_Logic.Master_Core.Debug*/Serial_Dbg_Intf.instr_read_reg_reg\[*\]/CE]
set_property src_info {type:SCOPED_XDC file:1 line:47 export:INPUT save:INPUT read:READ} [current_design]
create_waiver -internal -quiet -user microblaze -tags 12436 -type CDC -id CDC-1 -description "Debug protocol ensures stable signals" -from *PIN -to   [get_pins -quiet MicroBlaze_Core_I/*.Core/*Debug_Logic.Master_Core.Debug*/Serial_Dbg_Intf.shift_count_reg\[*\]/D]
set_property src_info {type:SCOPED_XDC file:1 line:50 export:INPUT save:INPUT read:READ} [current_design]
create_waiver -internal -quiet -user microblaze -tags 12436 -type CDC -id CDC-1 -description "Debug protocol ensures stable signals" -from *PIN -to   [get_pins -quiet MicroBlaze_Core_I/*.Core/*Debug_Logic.Master_Core.Debug*/Serial_Dbg_Intf.status_reg_reg\[*\]/CE]
set_property src_info {type:SCOPED_XDC file:1 line:53 export:INPUT save:INPUT read:READ} [current_design]
create_waiver -internal -quiet -user microblaze -tags 12436 -type CDC -id CDC-1 -description "Debug protocol ensures stable signals" -from *PIN -to   [get_pins -quiet MicroBlaze_Core_I/*.Core/*Debug_Logic.Master_Core.Debug*/Serial_Dbg_Intf.Instr_Insert_Reg_En_1_reg/D]
set_property src_info {type:SCOPED_XDC file:1 line:56 export:INPUT save:INPUT read:READ} [current_design]
create_waiver -internal -quiet -user microblaze -tags 12436 -type CDC -id CDC-1 -description "Debug protocol ensures stable signals" -from *PIN -to   [get_pins -quiet MicroBlaze_Core_I/*.Core/*Debug_Logic.Master_Core.Debug*/Serial_Dbg_Intf.New_Dbg_Instr*_TCK_reg/D]
set_property src_info {type:SCOPED_XDC file:1 line:59 export:INPUT save:INPUT read:READ} [current_design]
create_waiver -internal -quiet -user microblaze -tags 12436 -type CDC -id CDC-1 -description "Debug protocol ensures stable signals" -from *PIN -to   [get_pins -quiet MicroBlaze_Core_I/*.Core/*Debug_Logic.Master_Core.Debug*/Serial_Dbg_Intf.New_Dbg_Instr_TCK_reg\[*\]/CE]
set_property src_info {type:SCOPED_XDC file:1 line:62 export:INPUT save:INPUT read:READ} [current_design]
create_waiver -internal -quiet -user microblaze -tags 12436 -type CDC -id CDC-1 -description "Debug protocol ensures stable signals" -from *PIN -to   [get_pins -quiet MicroBlaze_Core_I/*.Core/*Debug_Logic.Master_Core.Debug*/Serial_Dbg_Intf.unchanged_reg/D]
set_property src_info {type:SCOPED_XDC file:1 line:65 export:INPUT save:INPUT read:READ} [current_design]
create_waiver -internal -quiet -user microblaze -tags 12436 -type CDC -id CDC-1 -description "Debug protocol ensures stable signals" -from *PIN -to   [get_pins -quiet MicroBlaze_Core_I/*.Core/*Debug_Logic.Master_Core.Debug*/Serial_Dbg_Intf.command_reg_reg\[*\]/CE]
set_property src_info {type:SCOPED_XDC file:1 line:68 export:INPUT save:INPUT read:READ} [current_design]
create_waiver -internal -quiet -user microblaze -tags 12436 -type CDC -id CDC-1 -description "Debug protocol ensures stable signals" -from *PIN -to   [get_pins -quiet MicroBlaze_Core_I/*.Core/*Debug_Logic.Master_Core.Debug*/Serial_Dbg_Intf.continue_from_brk_TClk_reg/CE]
set_property src_info {type:SCOPED_XDC file:1 line:71 export:INPUT save:INPUT read:READ} [current_design]
create_waiver -internal -quiet -user microblaze -tags 12436 -type CDC -id CDC-1 -description "Debug protocol ensures stable signals" -from *PIN -to   [get_pins -quiet MicroBlaze_Core_I/*.Core/*Debug_Logic.Master_Core.Debug*/Serial_Dbg_Intf.control_reg_reg\[*\]/CE]
set_property src_info {type:SCOPED_XDC file:1 line:74 export:INPUT save:INPUT read:READ} [current_design]
create_waiver -internal -quiet -user microblaze -tags 12436 -type CDC -id CDC-1 -description "Debug protocol ensures stable signals" -from *PIN -to   [get_pins -quiet MicroBlaze_Core_I/*.Core/*Debug_Logic.Master_Core.Debug*/Serial_Dbg_Intf.dbg_wakeup_i_reg/CE]
set_property src_info {type:SCOPED_XDC file:1 line:77 export:INPUT save:INPUT read:READ} [current_design]
create_waiver -internal -quiet -user microblaze -tags 12436 -type CDC -id CDC-1 -description "Debug protocol ensures stable signals" -from *PIN -to   [get_pins -quiet MicroBlaze_Core_I/*.Core/*Debug_Logic.Master_Core.Debug*/Serial_Dbg_Intf.force_stop_TClk_reg/CE]
set_property src_info {type:SCOPED_XDC file:1 line:80 export:INPUT save:INPUT read:READ} [current_design]
create_waiver -internal -quiet -user microblaze -tags 12436 -type CDC -id CDC-1 -description "Debug protocol ensures stable signals" -from *PIN -to   [get_pins -quiet MicroBlaze_Core_I/*.Core/*Debug_Logic.Master_Core.Debug*/Serial_Dbg_Intf.normal_stop_TClk_reg/CE]
set_property src_info {type:SCOPED_XDC file:1 line:83 export:INPUT save:INPUT read:READ} [current_design]
create_waiver -internal -quiet -user microblaze -tags 12436 -type CDC -id CDC-1 -description "Debug protocol ensures stable signals" -from *PIN -to   [get_pins -quiet MicroBlaze_Core_I/*.Core/*Debug_Logic.Master_Core.Debug*/Serial_Dbg_Intf.single_Step_TClk_reg/CE]
set_property src_info {type:SCOPED_XDC file:1 line:86 export:INPUT save:INPUT read:READ} [current_design]
create_waiver -internal -quiet -user microblaze -tags 12436 -type CDC -id CDC-1 -description "Debug protocol ensures stable signals" -from [get_pins -quiet MicroBlaze_Core_I/*.Core/*Debug_Logic.Master_Core.Debug*/Serial_Dbg_Intf.Instr_Insert_Reg_En_1_reg/C] -to   [get_pins -quiet MicroBlaze_Core_I/*.Core/*Debug_Logic.Master_Core.Debug*/Serial_Dbg_Intf.new_dbg_instr_shifting_CLK_reg/D]
set_property src_info {type:SCOPED_XDC file:1 line:89 export:INPUT save:INPUT read:READ} [current_design]
create_waiver -internal -quiet -user microblaze -tags 12436 -type CDC -id CDC-1 -description "Debug protocol ensures stable signals" -from [get_pins -quiet MicroBlaze_Core_I/*.Core/*Debug_Logic.Master_Core.Debug*/Serial_Dbg_Intf.New_Instr_Reg_TCK_reg\[*\]/C] -to   *PIN
set_property src_info {type:SCOPED_XDC file:1 line:92 export:INPUT save:INPUT read:READ} [current_design]
create_waiver -internal -quiet -user microblaze -tags 12436 -type CDC -id CDC-1 -description "Debug protocol ensures stable signals" -from *PIN -to   [get_pins -quiet MicroBlaze_Core_I/*.Core/*Debug_Logic.Master_Core.Debug*/Serial_Dbg_Intf.New_Instr_Reg_TCK_reg\[*\]/CE]
set_property src_info {type:SCOPED_XDC file:1 line:95 export:INPUT save:INPUT read:READ} [current_design]
create_waiver -internal -quiet -user microblaze -tags 12436 -type CDC -id CDC-1 -description "Debug protocol ensures stable signals" -from [get_pins -quiet MicroBlaze_Core_I/*.Core/*Debug_Logic.Master_Core.Debug*/Serial_Dbg_Intf.control_reg_reg\[*\]/C] -to *PIN
set_property src_info {type:SCOPED_XDC file:1 line:98 export:INPUT save:INPUT read:READ} [current_design]
create_waiver -internal -quiet -user microblaze -tags 12436 -type CDC -id CDC-1 -description "Debug protocol ensures stable signals" -from *PIN -to   [get_pins -quiet MicroBlaze_Core_I/*.Core/*Debug_Logic.Master_Core.Debug*/Serial_Dbg_Intf.instr_read_reg_reg\[*\]/D]
set_property src_info {type:SCOPED_XDC file:1 line:101 export:INPUT save:INPUT read:READ} [current_design]
create_waiver -internal -quiet -user microblaze -tags 12436 -type CDC -id CDC-1 -description "Debug protocol ensures stable signals" -from *PIN -to   [get_pins -quiet MicroBlaze_Core_I/*.Core/*Debug_Logic.Master_Core.Debug*/Serial_Dbg_Intf.status_reg_reg\[*\]/D]
set_property src_info {type:SCOPED_XDC file:1 line:104 export:INPUT save:INPUT read:READ} [current_design]
create_waiver -internal -quiet -user microblaze -tags 12436 -type CDC -id CDC-1 -description "Debug protocol ensures stable signals" -from [get_pins -quiet MicroBlaze_Core_I/*.Core/*Debug_Logic.Master_Core.Debug*/running_clock_reg/C] -to   [get_pins -quiet MicroBlaze_Core_I/*.Core/*Debug_Logic.Master_Core.Debug*/Serial_Dbg_Intf.sync_running_clock/Single_Synchronize.use_async_reset.sync_reg/D]
set_property src_info {type:SCOPED_XDC file:1 line:107 export:INPUT save:INPUT read:READ} [current_design]
create_waiver -internal -quiet -user microblaze -tags 12436 -type CDC -id CDC-1 -description "Debug protocol ensures stable signals" -from [get_pins -quiet MicroBlaze_Core_I/*.Core/*Debug_Logic.Master_Core.Debug*/Serial_Dbg_Intf.dbg_wakeup_i_reg/C] -to   [get_pins -quiet MicroBlaze_Core_I/*.Core/*Debug_Logic.Master_Core.Debug*/Serial_Dbg_Intf.sync_dbg_wakeup/Single_Synchronize.use_sync_reset.sync_reg/D]
set_property src_info {type:SCOPED_XDC file:1 line:110 export:INPUT save:INPUT read:READ} [current_design]
create_waiver -internal -quiet -user microblaze -tags 12436 -type CDC -id CDC-1 -description "Debug protocol ensures stable signals" -from *PIN -to   [get_pins -quiet MicroBlaze_Core_I/*.Core/*Debug_Logic.Master_Core.Debug*/Serial_Dbg_Intf.sync_sleep/Single_Synchronize.use_async_reset.sync_reg/D]
set_property src_info {type:SCOPED_XDC file:1 line:113 export:INPUT save:INPUT read:READ} [current_design]
create_waiver -internal -quiet -user microblaze -tags 12436 -type CDC -id CDC-1 -description "Debug protocol ensures stable signals" -from [get_pins -quiet MicroBlaze_Core_I/*.Core/*Debug_Logic.Master_Core.Debug*/*Debug_Control.dbg_brki_hit_reg/C] -to   [get_pins -quiet MicroBlaze_Core_I/*.Core/*Debug_Logic.Master_Core.Debug*/Serial_Dbg_Intf.sync_dbg_brk_hit/Single_Synchronize.use_async_reset.sync_reg/D]
set_property src_info {type:SCOPED_XDC file:1 line:116 export:INPUT save:INPUT read:READ} [current_design]
create_waiver -internal -quiet -user microblaze -tags 12436 -type CDC -id CDC-1 -description "Debug protocol ensures stable signals" -from [get_pins -quiet MicroBlaze_Core_I/*.Core/*Debug_Logic.Master_Core.Debug*/*Debug_Control.dbg_hit_reg\[*\]/C] -to   [get_pins -quiet MicroBlaze_Core_I/*.Core/*Debug_Logic.Master_Core.Debug*/Serial_Dbg_Intf.sync_dbg_hit/*/Single_Synchronize.use_async_reset.sync_reg/D]
set_property src_info {type:SCOPED_XDC file:1 line:119 export:INPUT save:INPUT read:READ} [current_design]
create_waiver -internal -quiet -user microblaze -tags 12436 -type CDC -id CDC-1 -description "Debug protocol ensures stable signals" -from *PIN -to   [get_pins -quiet MicroBlaze_Core_I/*.Core/*Debug_Logic.Master_Core.Debug*/Serial_Dbg_Intf.shift_datain_reg\[*\]/D]
set_property src_info {type:SCOPED_XDC file:1 line:122 export:INPUT save:INPUT read:READ} [current_design]
create_waiver -internal -quiet -user microblaze -tags 12436 -type CDC -id CDC-1 -description "Debug protocol ensures stable signals" -from [get_pins -quiet MicroBlaze_Core_I/*.Core/*Debug_Logic.Master_Core.Debug*/*stack_violation_occurence_reg/C] -to   [get_pins -quiet MicroBlaze_Core_I/*.Core/*Debug_Logic.Master_Core.Debug*/Serial_Dbg_Intf.sync_stack_violation_occurence/Single_Synchronize.use_async_reset.sync_reg/D]
set_property src_info {type:SCOPED_XDC file:1 line:125 export:INPUT save:INPUT read:READ} [current_design]
create_waiver -internal -quiet -user microblaze -tags 12436 -type CDC -id CDC-4 -description "Debug protocol ensures stable signals" -from [get_pins -quiet MicroBlaze_Core_I/*.Core/*Debug_Logic.Master_Core.Debug*/data_rd_reg_reg\[*\]/C] -to   [get_pins -quiet MicroBlaze_Core_I/*.Core/*Debug_Logic.Master_Core.Debug*/Serial_Dbg_Intf.data_read_reg_reg\[*\]/D]
set_property src_info {type:SCOPED_XDC file:1 line:128 export:INPUT save:INPUT read:READ} [current_design]
create_waiver -internal -quiet -user microblaze -tags 12436 -type CDC -id CDC-7 -description "Debug protocol ensures stable signals" -from [get_pins -quiet MicroBlaze_Core_I/*.Core/*Debug_Logic.Master_Core.Debug*/Serial_Dbg_Intf.capture_1_reg/C] -to   [get_pins -quiet MicroBlaze_Core_I/*.Core/*Debug_Logic.Master_Core.Debug*/running_clock_reg/CLR]
set_property src_info {type:SCOPED_XDC file:1 line:131 export:INPUT save:INPUT read:READ} [current_design]
create_waiver -internal -quiet -user microblaze -tags 12436 -type CDC -id CDC-7 -description "Debug protocol ensures stable signals" -from [get_pins -quiet MicroBlaze_Core_I/*.Core/*Debug_Logic.Master_Core.Debug*/command_reg_clear_reg/C] -to   [get_pins -quiet MicroBlaze_Core_I/*.Core/*Debug_Logic.Master_Core.Debug*/Serial_Dbg_Intf.command_reg_reg\[*\]/CLR]
set_property src_info {type:SCOPED_XDC file:1 line:134 export:INPUT save:INPUT read:READ} [current_design]
create_waiver -internal -quiet -user microblaze -tags 12436 -type CDC -id CDC-7 -description "Debug protocol ensures stable signals" -from [get_pins -quiet MicroBlaze_Core_I/*.Core/*Debug_Logic.Master_Core.Debug*/Serial_Dbg_Intf.continue_from_brk_reg/C] -to   [get_pins -quiet MicroBlaze_Core_I/*.Core/*Debug_Logic.Master_Core.Debug*/Serial_Dbg_Intf.continue_from_brk_TClk_reg/CLR]
set_property src_info {type:SCOPED_XDC file:1 line:137 export:INPUT save:INPUT read:READ} [current_design]
create_waiver -internal -quiet -user microblaze -tags 12436 -type CDC -id CDC-7 -description "Debug protocol ensures stable signals" -from [get_pins -quiet MicroBlaze_Core_I/*.Core/*Debug_Logic.Master_Core.Debug*/start_single_step_reg/C] -to   [get_pins -quiet MicroBlaze_Core_I/*.Core/*Debug_Logic.Master_Core.Debug*/Serial_Dbg_Intf.single_Step_TClk_reg/CLR]
set_property src_info {type:SCOPED_XDC file:1 line:140 export:INPUT save:INPUT read:READ} [current_design]
create_waiver -internal -quiet -user microblaze -tags 12436 -type CDC -id CDC-7 -description "Debug protocol ensures stable signals" -from *PIN -to   [get_pins -quiet MicroBlaze_Core_I/*.Core/*Debug_Logic.Master_Core.Debug*/Serial_Dbg_Intf.dbg_wakeup_i_reg/CLR]
set_property src_info {type:SCOPED_XDC file:1 line:143 export:INPUT save:INPUT read:READ} [current_design]
create_waiver -internal -quiet -user microblaze -tags 12436 -type CDC -id CDC-7 -description "Debug protocol ensures stable signals" -from [get_pins -quiet MicroBlaze_Core_I/*.Core/*Debug_Logic.Master_Core.Debug*/Serial_Dbg_Intf.force_stop_cmd_i_reg/C] -to   [get_pins -quiet MicroBlaze_Core_I/*.Core/*Debug_Logic.Master_Core.Debug*/Serial_Dbg_Intf.force_stop_TClk_reg/CLR]
set_property src_info {type:SCOPED_XDC file:1 line:146 export:INPUT save:INPUT read:READ} [current_design]
create_waiver -internal -quiet -user microblaze -tags 12436 -type CDC -id CDC-7 -description "Debug protocol ensures stable signals" -from [get_pins -quiet MicroBlaze_Core_I/*.Core/*Debug_Logic.Master_Core.Debug*/Serial_Dbg_Intf.normal_stop_cmd_i_reg/C] -to   [get_pins -quiet MicroBlaze_Core_I/*.Core/*Debug_Logic.Master_Core.Debug*/Serial_Dbg_Intf.normal_stop_TClk_reg/CLR]
set_property src_info {type:SCOPED_XDC file:1 line:149 export:INPUT save:INPUT read:READ} [current_design]
create_waiver -internal -quiet -user microblaze -tags 12436 -type CDC -id CDC-13 -description "Debug protocol ensures stable signals" -from [get_pins -quiet MicroBlaze_Core_I/*.Core/*Debug_Logic.Master_Core.Debug*/Serial_Dbg_Intf.New_Instr_Reg_TCK_reg\[*\]/C] -to   *PIN
set_property src_info {type:SCOPED_XDC file:1 line:152 export:INPUT save:INPUT read:READ} [current_design]
create_waiver -internal -quiet -user microblaze -tags 12436 -type CDC -id CDC-15 -description "Debug protocol ensures stable signals" -from *PIN -to   [get_pins -quiet MicroBlaze_Core_I/*.Core/*Debug_Logic.Master_Core.Debug*/Serial_Dbg_Intf.command_reg_reg\[*\]/D]
set_property src_info {type:SCOPED_XDC file:1 line:155 export:INPUT save:INPUT read:READ} [current_design]
create_waiver -internal -quiet -user microblaze -tags 12436 -type CDC -id CDC-15 -description "Debug protocol ensures stable signals" -from *PIN -to   [get_pins -quiet MicroBlaze_Core_I/*.Core/*Debug_Logic.Master_Core.Debug*/Serial_Dbg_Intf.continue_from_brk_TClk_reg/D]
set_property src_info {type:SCOPED_XDC file:1 line:158 export:INPUT save:INPUT read:READ} [current_design]
create_waiver -internal -quiet -user microblaze -tags 12436 -type CDC -id CDC-15 -description "Debug protocol ensures stable signals" -from *PIN -to   [get_pins -quiet MicroBlaze_Core_I/*.Core/*Debug_Logic.Master_Core.Debug*/Serial_Dbg_Intf.control_reg_reg\[*\]/D]
set_property src_info {type:SCOPED_XDC file:1 line:161 export:INPUT save:INPUT read:READ} [current_design]
create_waiver -internal -quiet -user microblaze -tags 12436 -type CDC -id CDC-15 -description "Debug protocol ensures stable signals" -from *PIN -to   [get_pins -quiet MicroBlaze_Core_I/*.Core/*Debug_Logic.Master_Core.Debug*/Serial_Dbg_Intf.dbg_wakeup_i_reg/D]
set_property src_info {type:SCOPED_XDC file:1 line:164 export:INPUT save:INPUT read:READ} [current_design]
create_waiver -internal -quiet -user microblaze -tags 12436 -type CDC -id CDC-15 -description "Debug protocol ensures stable signals" -from *PIN -to   [get_pins -quiet MicroBlaze_Core_I/*.Core/*Debug_Logic.Master_Core.Debug*/Serial_Dbg_Intf.force_stop_TClk_reg/D]
set_property src_info {type:SCOPED_XDC file:1 line:167 export:INPUT save:INPUT read:READ} [current_design]
create_waiver -internal -quiet -user microblaze -tags 12436 -type CDC -id CDC-15 -description "Debug protocol ensures stable signals" -from *PIN -to   [get_pins -quiet MicroBlaze_Core_I/*.Core/*Debug_Logic.Master_Core.Debug*/Serial_Dbg_Intf.normal_stop_TClk_reg/D]
set_property src_info {type:SCOPED_XDC file:1 line:170 export:INPUT save:INPUT read:READ} [current_design]
create_waiver -internal -quiet -user microblaze -tags 12436 -type CDC -id CDC-15 -description "Debug protocol ensures stable signals" -from *PIN -to   [get_pins -quiet MicroBlaze_Core_I/*.Core/*Debug_Logic.Master_Core.Debug*/Serial_Dbg_Intf.single_Step_TClk_reg/D]
set_property src_info {type:SCOPED_XDC file:1 line:173 export:INPUT save:INPUT read:READ} [current_design]
create_waiver -internal -quiet -user microblaze -tags 12436 -type CDC -id CDC-15 -description "Debug protocol ensures stable signals" -from [get_pins -quiet MicroBlaze_Core_I/*.Core/*Debug_Logic.Master_Core.Debug*/Serial_Dbg_Intf.control_reg_reg\[*\]/C] -to   *PIN
set_property src_info {type:SCOPED_XDC file:1 line:176 export:INPUT save:INPUT read:READ} [current_design]
create_waiver -internal -quiet -user microblaze -tags 12436 -type CDC -id CDC-15 -description "Debug protocol ensures stable signals" -from [get_pins -quiet MicroBlaze_Core_I/*.Core/*Debug_Logic.Master_Core.Debug*/command_reg_clear_reg/C] -to   [get_pins -quiet MicroBlaze_Core_I/*.Core/*Debug_Logic.Master_Core.Debug*/Serial_Dbg_Intf.command_reg_reg\[*\]/CLR]
set_property src_info {type:SCOPED_XDC file:1 line:179 export:INPUT save:INPUT read:READ} [current_design]
create_waiver -internal -quiet -user microblaze -tags 12436 -type CDC -id CDC-15 -description "Debug protocol ensures stable signals" -from [get_pins -quiet MicroBlaze_Core_I/*.Core/*Debug_Logic.Master_Core.Debug*/Serial_Dbg_Intf.continue_from_brk_reg/C] -to   [get_pins -quiet MicroBlaze_Core_I/*.Core/*Debug_Logic.Master_Core.Debug*/Serial_Dbg_Intf.continue_from_brk_TClk_reg/CLR]
set_property src_info {type:SCOPED_XDC file:1 line:182 export:INPUT save:INPUT read:READ} [current_design]
create_waiver -internal -quiet -user microblaze -tags 12436 -type CDC -id CDC-15 -description "Debug protocol ensures stable signals" -from [get_pins -quiet MicroBlaze_Core_I/*.Core/*Debug_Logic.Master_Core.Debug*/Serial_Dbg_Intf.force_stop_cmd_i_reg/C] -to   [get_pins -quiet MicroBlaze_Core_I/*.Core/*Debug_Logic.Master_Core.Debug*/Serial_Dbg_Intf.force_stop_TClk_reg/CLR]
set_property src_info {type:SCOPED_XDC file:1 line:185 export:INPUT save:INPUT read:READ} [current_design]
create_waiver -internal -quiet -user microblaze -tags 12436 -type CDC -id CDC-15 -description "Debug protocol ensures stable signals" -from [get_pins -quiet MicroBlaze_Core_I/*.Core/*Debug_Logic.Master_Core.Debug*/Serial_Dbg_Intf.normal_stop_cmd_i_reg/C] -to   [get_pins -quiet MicroBlaze_Core_I/*.Core/*Debug_Logic.Master_Core.Debug*/Serial_Dbg_Intf.normal_stop_TClk_reg/CLR]
set_property src_info {type:SCOPED_XDC file:1 line:188 export:INPUT save:INPUT read:READ} [current_design]
create_waiver -internal -quiet -user microblaze -tags 12436 -type CDC -id CDC-15 -description "Debug protocol ensures stable signals" -from [get_pins -quiet MicroBlaze_Core_I/*.Core/*Debug_Logic.Master_Core.Debug*/start_single_step_reg/C] -to   [get_pins -quiet MicroBlaze_Core_I/*.Core/*Debug_Logic.Master_Core.Debug*/Serial_Dbg_Intf.single_Step_TClk_reg/CLR]
set_property src_info {type:SCOPED_XDC file:1 line:191 export:INPUT save:INPUT read:READ} [current_design]
create_waiver -internal -quiet -user microblaze -tags 12436 -type CDC -id CDC-15 -description "Debug protocol ensures stable signals" -from *PIN -to   [get_pins -quiet MicroBlaze_Core_I/*.Core/*Debug_Logic.Master_Core.Debug*/Serial_Dbg_Intf.dbg_wakeup_i_reg/CLR]
set_property src_info {type:SCOPED_XDC file:1 line:194 export:INPUT save:INPUT read:READ} [current_design]
create_waiver -internal -quiet -user microblaze -tags 12436 -type CDC -id CDC-15 -description "Debug protocol ensures stable signals" -from *PIN -to   [get_pins -quiet MicroBlaze_Core_I/*.Core/*Debug_Logic.Master_Core.Debug*/Serial_Dbg_Intf.New_Dbg_Instr_TCK_reg\[*\]/D]
set_property src_info {type:SCOPED_XDC file:1 line:197 export:INPUT save:INPUT read:READ} [current_design]
create_waiver -internal -quiet -user microblaze -tags 12436 -type CDC -id CDC-15 -description "Debug protocol ensures stable signals" -from *PIN -to   [get_pins -quiet MicroBlaze_Core_I/*.Core/*Debug_Logic.Master_Core.Debug*/Serial_Dbg_Intf.New_Instr_Reg_TCK_reg\[*\]/D]
set_property src_info {type:SCOPED_XDC file:1 line:200 export:INPUT save:INPUT read:READ} [current_design]
create_waiver -internal -quiet -user microblaze -tags 12436 -type CDC -id CDC-1 -description "Debug protocol ensures stable signals" -from [get_pins -quiet MicroBlaze_Core_I/*.Core/*Debug_Logic.Master_Core.Debug*/Using_*_Breakpoints.All_*\[*\].*/*Compare\[*\].*/*/CLK] -to   *PIN
set_property src_info {type:SCOPED_XDC file:1 line:203 export:INPUT save:INPUT read:READ} [current_design]
create_waiver -internal -quiet -user microblaze -tags 12436 -type CDC -id CDC-10 -description "Debug protocol ensures stable signals" -from [get_pins -quiet MicroBlaze_Core_I/*.Core/*Debug_Logic.Master_Core.Debug*/Using_*_Breakpoints.All_*\[*\].*/*Compare\[*\].*/*/CLK] -to   *PIN
set_property src_info {type:SCOPED_XDC file:1 line:206 export:INPUT save:INPUT read:READ} [current_design]
create_waiver -internal -quiet -user microblaze -tags 12436 -type CDC -id CDC-13 -description "Debug protocol ensures stable signals" -from [get_pins -quiet MicroBlaze_Core_I/*.Core/*Debug_Logic.Master_Core.Debug*/Using_*_Breakpoints.All_*\[*\].*/*Compare\[*\].*/*/CLK] -to   *PIN
set_property src_info {type:SCOPED_XDC file:1 line:209 export:INPUT save:INPUT read:READ} [current_design]
create_waiver -internal -quiet -user microblaze -tags 12436 -type CDC -id CDC-13 -description "Debug protocol ensures stable signals" -from *PIN -to   [get_pins -quiet MicroBlaze_Core_I/*.Core/*Debug_Logic.Master_Core.Debug*/Using_*_Breakpoints.All_*\[*\].*/*Compare\[*\].*/*/D]
set_property src_info {type:SCOPED_XDC file:1 line:212 export:INPUT save:INPUT read:READ} [current_design]
create_waiver -internal -quiet -user microblaze -tags 12436 -type CDC -id CDC-15 -description "Debug protocol ensures stable signals" -from [get_pins -quiet MicroBlaze_Core_I/*.Core/*Debug_Logic.Master_Core.Debug*/Using_*_Breakpoints.All_*\[*\].*/*Compare\[*\].*/*/CLK] -to   *PIN
set_property src_info {type:SCOPED_XDC file:1 line:215 export:INPUT save:INPUT read:READ} [current_design]
create_waiver -internal -quiet -user microblaze -tags 12436 -type CDC -id CDC-1 -description "Debug protocol ensures stable signals" -from [get_pins -quiet MicroBlaze_Core_I/Performance.Core/Decode_I/ex_sleep_i_reg/C] -to   [get_pins -quiet MicroBlaze_Core_I/*.Core/*Debug_Logic.Master_Core.Debug*/Serial_Dbg_Intf.sync_sleep/Single_Synchronize.use_async_reset.sync_reg/D]
set_property src_info {type:SCOPED_XDC file:1 line:218 export:INPUT save:INPUT read:READ} [current_design]
create_waiver -internal -quiet -user microblaze -tags 12436 -type CDC -id CDC-1 -description "Debug protocol ensures stable signals" -from [get_pins -quiet MicroBlaze_Core_I/*.Core/*Debug_Logic.Master_Core.Debug*/*Debug_Control.dbg_stop_instr_fetch_nohalt_reg/C] -to   [get_pins -quiet MicroBlaze_Core_I/*.Core/*Debug_Logic.Master_Core.Debug*/Serial_Dbg_Intf.sync_stop_CPU/Single_Synchronize.use_async_reset.sync_reg/D]
