docquantum/skrach-synth/code/Skrach/Skrach.runs/synth_1/.Xil/skrach_design_wrapper_propImpl.xdc

set_property SRC_FILE_INFO {cfile:/home/docquantum/ce446_solovey/final/code/Skrach.srcs/constrs_1/new/skrach.xdc rfile:../../../Skrach.srcs/constrs_1/new/skrach.xdc id:1} [current_design]
set_property src_info {type:XDC file:1 line:42 export:INPUT save:INPUT read:READ} [current_design]
set_property -dict { PACKAGE_PIN T4    IOSTANDARD LVCMOS33 } [get_ports { ac_adc_sdata_0 }]; #IO_L13N_T2_MRCC_34 Sch=ac_adc_sdata #SDATA_IN
set_property src_info {type:XDC file:1 line:43 export:INPUT save:INPUT read:READ} [current_design]
set_property -dict { PACKAGE_PIN T5    IOSTANDARD LVCMOS33 } [get_ports { ac_bclk_0 }]; #IO_L14P_T2_SRCC_34 Sch=ac_bclk #BIT_CLK
set_property src_info {type:XDC file:1 line:44 export:INPUT save:INPUT read:READ} [current_design]
set_property -dict { PACKAGE_PIN W6    IOSTANDARD LVCMOS33 } [get_ports { ac_dac_sdata_0 }]; #IO_L15P_T2_DQS_34 Sch=ac_dac_sdata #SDATA_OUT
set_property src_info {type:XDC file:1 line:45 export:INPUT save:INPUT read:READ} [current_design]
set_property -dict { PACKAGE_PIN U5    IOSTANDARD LVCMOS33 } [get_ports { ac_lrclk_0 }]; #IO_L14N_T2_SRCC_34 Sch=ac_lrclk #LRCLK
set_property src_info {type:XDC file:1 line:46 export:INPUT save:INPUT read:READ} [current_design]
set_property -dict { PACKAGE_PIN U6    IOSTANDARD LVCMOS33 } [get_ports { ac_mclk_0 }]; #IO_L16P_T2_34 Sch=ac_mclk #mclk
set_property src_info {type:XDC file:1 line:72 export:INPUT save:INPUT read:READ} [current_design]
set_property -dict { PACKAGE_PIN Y6    IOSTANDARD LVCMOS33 } [get_ports { rx_0 }]; #IO_L18P_T2_34 Sch=jc_p[1]
set_property src_info {type:XDC file:1 line:82 export:INPUT save:INPUT read:READ} [current_design]
set_property -dict {PACKAGE_PIN W5 IOSTANDARD LVCMOS33} [get_ports {scl_0}]
set_property src_info {type:XDC file:1 line:83 export:INPUT save:INPUT read:READ} [current_design]
set_property -dict {PACKAGE_PIN V5 IOSTANDARD LVCMOS33} [get_ports {sda_0}]
