docquantum/skrach-synth/code/Skrach/Skrach.srcs/sources_1/bd/skrach_design/ipshared/8f92/src/oscillator.vhd

--------------------------------------------------------------------------------
-- Name:	Daria Solovey
-- Updated:	2020/05/01
-- File:    oscillator.vhd
-- Module:	Skrach Core
-- Pupr:	Using LUTs and basic math, generates signals as output. Can create
--          Sine, Triangle, Saw, and Square data at 2048, 16 bit samples.
--
-- Notes:   With system clock rates, requires for the "nextSample" signal
--          to be high to increment throught the LUT or through processes for
--          the count. This is to match your Audio Codec's data rate or LRClock.
--          
--          Another aproach would be to set the input clock to the same rate
--          as the LRclock which is calcuted as:
--          SamplingRate * Bits per channel * no of channels.
-- 	
-- Academic Integrity Statement: I certify that, while others may have 
-- assisted me in brain storming, debugging and validating this program, 
-- the program itself is my own work. I understand that submitting code 
-- which is the work of other individuals is a violation of the honor   
-- code.  I also understand that if I knowingly give my original work to 
-- another individual is also a violation of the honor code. 
--------------------------------------------------------------------------------


library IEEE;
use IEEE.STD_LOGIC_1164.ALL;
use IEEE.NUMERIC_STD.ALL;

Library UNISIM;
use UNISIM.vcomponents.all;

Library UNIMACRO;
use UNIMACRO.vcomponents.all;

use work.skrach_parts.all;


entity oscillator is
    Port (
        -- 100 MHz clk
        clk: in std_logic;
        -- Active low reset, should be handled in sync with other OSCs
        reset_n: in std_logic;
        -- sine, triangle, saw, square
        waveSel: in std_logic_vector(1 downto 0);
        -- Q9.7, adjust the increment for sample data
        phaseInc: in unsigned(15 downto 0);
        -- read's next sample
        nextSample: in std_logic;
        -- Signed PCM data
        wavformOut: out signed(15 downto 0)
    );
end oscillator;

architecture implementation of oscillator is
    signal reset: std_logic := NOT reset_n;
    signal LUTSine: std_logic_vector(15 downto 0);
    signal LUTAddr: std_logic_vector(10 downto 0);
    signal sine, saw, triangle, square: signed(15 downto 0) := to_signed(0, 16);
    signal sampleCount, counterPhase: unsigned(17 downto 0); -- Q11.7
    signal counterCtrl: std_logic_vector(1 downto 0);
    signal triangle_sig: signed(31 downto 0):= to_signed(0, 32);
begin

    ----------------------------------------------------------------------------
    -- Waveform Mux: selects the desired waveform using 'waveSel' signal
    ----------------------------------------------------------------------------
    wavformOut <= 
        sine when waveSel = "00" else
        triangle when waveSel = "01" else
        saw when waveSel = "10" else
        square when waveSel = "11" else
        (others => '0');
    
    ----------------------------------------------------------------------------
    -- Sample Counter: increments when nextSample is high by the phaseInc value.
    ----------------------------------------------------------------------------
    counterPhase <= "00" & phaseInc;
    counterCtrl <= nextSample & '0';
    sample_counter: counter
    generic map (
        WIDTH => 18 -- Q11.7
    )
    port map (
        clk => clk,
        reset_n => reset_n,
        cw => counterCtrl,
        D => counterPhase,
        count => sampleCount
    );
    LUTAddr <= std_logic_vector(sampleCount(17 downto 7)); 
    ----------------------------------------------------------------------------
    -- Saw wave: Simply the sample counter's output 
    ----------------------------------------------------------------------------
    saw <= signed(sampleCount(17 downto 2) - 32768);
    
    ----------------------------------------------------------------------------
    -- Square wave: Low for 1024 samples, High for the other 1024
    ----------------------------------------------------------------------------
    square <=
        to_signed(-32767, 16) when (sampleCount < 2**17) else
        to_signed(32767, 16);
    
    ----------------------------------------------------------------------------
    -- Triangle wave: 2 * phaseInc up for 1024 samples, down for the other 1024
    ----------------------------------------------------------------------------
    triangle <= triangle_sig(15 downto 0) when (sampleCount < 2**17) else
        -triangle_sig(15 downto 0);
    triangle_sig <= signed(2*sampleCount(17 downto 2) - 32768);
    
    ----------------------------------------------------------------------------
    -- Sine wave: Grabs sample from look up table via sample count index
    ----------------------------------------------------------------------------

    sine_lut_inst: BRAM_SINGLE_MACRO
    generic map
    (
        BRAM_SIZE => "36Kb",
        DEVICE => "7SERIES",
        DO_REG => 0,
        INIT => x"0000",
        INIT_FILE => "NONE",
        WRITE_WIDTH => 16,
        READ_WIDTH => 16,
        SRVAL => x"0000",
        WRITE_MODE => "READ_FIRST",   
        INIT_00 => x"05E3057E051A04B6045103ED0388032402BF025B01F60192012D00C900640000",
        INIT_01 => x"0C270BC30B5F0AFB0A970A3209CE096A090608A1083D07D90774071006AC0647",
        INIT_02 => x"12641200119D113910D61072100E0FAB0F470EE30E7F0E1B0DB70D530CEF0C8B",
        INIT_03 => x"1895183317D0176D170A16A7164415E1157E151B14B8145513F2138E132B12C7",
        INIT_04 => x"1EB81E561DF41D931D311CCF1C6D1C0B1BA91B461AE41A821A2019BD195B18F8",
        INIT_05 => x"24C72467240623A6234522E42284222321C221612100209F203D1FDC1F7B1F19",
        INIT_06 => x"2AC02A612A0229A3294428E52885282627C62767270726A7264725E725872527",
        INIT_07 => x"309E30412FE42F862F292ECC2E6E2E102DB22D542CF62C982C3A2BDB2B7D2B1E",
        INIT_08 => x"365E360335A8354D34F13496343A33DE3382332632CA326D321131B4315830FB",
        INIT_09 => x"3BFD3BA43B4B3AF23A993A3F39E6398C393238D8387E382437C9376F371436B9",
        INIT_0A => x"4177412040CA4073401C3FC53F6E3F163EBF3E673E0F3DB73D5F3D073CAE3C56",
        INIT_0B => x"46C84674462045CC4578452344CF447A442543D0437A432542CF4279422341CD",
        INIT_0C => x"4BEE4B9D4B4C4AFA4AA94A574A0549B34961490E48BC4869481647C3476F471C",
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
        ADDR => LUTaddr,  -- Input address, width defined by read/write port depth
        CLK => clk,    -- 1-bit input clock
        DI => (others => '0'),      -- Input data port, width defined by WRITE_WIDTH parameter
        EN => '1',      -- 1-bit input RAM enable
        REGCE => '1', -- 1-bit input output register enable
        RST => reset,    -- 1-bit input reset
        WE => "00"       -- Input write enable, width defined by write port depth
    );
    
    sine <= signed(LUTSine);
    
end implementation;
