docquantum/skrach-synth/code/Skrach/Skrach.srcs/sources_1/bd/skrach_design/synth/skrach_design.vhd

--Copyright 1986-2019 Xilinx, Inc. All Rights Reserved.
----------------------------------------------------------------------------------
--Tool Version: Vivado v.2019.1 (lin64) Build 2552052 Fri May 24 14:47:09 MDT 2019
--Date        : Fri May  1 01:48:59 2020
--Host        : QuantumNet-L4 running 64-bit Arch Linux
--Command     : generate_target skrach_design.bd
--Design      : skrach_design
--Purpose     : IP block netlist
----------------------------------------------------------------------------------
library IEEE;
use IEEE.STD_LOGIC_1164.ALL;
library UNISIM;
use UNISIM.VCOMPONENTS.ALL;
entity m00_couplers_imp_C4LHUS is
  port (
    M_ACLK : in STD_LOGIC;
    M_ARESETN : in STD_LOGIC;
    M_AXI_araddr : out STD_LOGIC_VECTOR ( 31 downto 0 );
    M_AXI_arready : in STD_LOGIC_VECTOR ( 0 to 0 );
    M_AXI_arvalid : out STD_LOGIC_VECTOR ( 0 to 0 );
    M_AXI_awaddr : out STD_LOGIC_VECTOR ( 31 downto 0 );
    M_AXI_awready : in STD_LOGIC_VECTOR ( 0 to 0 );
    M_AXI_awvalid : out STD_LOGIC_VECTOR ( 0 to 0 );
    M_AXI_bready : out STD_LOGIC_VECTOR ( 0 to 0 );
    M_AXI_bresp : in STD_LOGIC_VECTOR ( 1 downto 0 );
    M_AXI_bvalid : in STD_LOGIC_VECTOR ( 0 to 0 );
    M_AXI_rdata : in STD_LOGIC_VECTOR ( 31 downto 0 );
    M_AXI_rready : out STD_LOGIC_VECTOR ( 0 to 0 );
    M_AXI_rresp : in STD_LOGIC_VECTOR ( 1 downto 0 );
    M_AXI_rvalid : in STD_LOGIC_VECTOR ( 0 to 0 );
    M_AXI_wdata : out STD_LOGIC_VECTOR ( 31 downto 0 );
    M_AXI_wready : in STD_LOGIC_VECTOR ( 0 to 0 );
    M_AXI_wstrb : out STD_LOGIC_VECTOR ( 3 downto 0 );
    M_AXI_wvalid : out STD_LOGIC_VECTOR ( 0 to 0 );
    S_ACLK : in STD_LOGIC;
    S_ARESETN : in STD_LOGIC;
    S_AXI_araddr : in STD_LOGIC_VECTOR ( 31 downto 0 );
    S_AXI_arready : out STD_LOGIC_VECTOR ( 0 to 0 );
    S_AXI_arvalid : in STD_LOGIC_VECTOR ( 0 to 0 );
    S_AXI_awaddr : in STD_LOGIC_VECTOR ( 31 downto 0 );
    S_AXI_awready : out STD_LOGIC_VECTOR ( 0 to 0 );
    S_AXI_awvalid : in STD_LOGIC_VECTOR ( 0 to 0 );
    S_AXI_bready : in STD_LOGIC_VECTOR ( 0 to 0 );
    S_AXI_bresp : out STD_LOGIC_VECTOR ( 1 downto 0 );
    S_AXI_bvalid : out STD_LOGIC_VECTOR ( 0 to 0 );
    S_AXI_rdata : out STD_LOGIC_VECTOR ( 31 downto 0 );
    S_AXI_rready : in STD_LOGIC_VECTOR ( 0 to 0 );
    S_AXI_rresp : out STD_LOGIC_VECTOR ( 1 downto 0 );
    S_AXI_rvalid : out STD_LOGIC_VECTOR ( 0 to 0 );
    S_AXI_wdata : in STD_LOGIC_VECTOR ( 31 downto 0 );
    S_AXI_wready : out STD_LOGIC_VECTOR ( 0 to 0 );
    S_AXI_wstrb : in STD_LOGIC_VECTOR ( 3 downto 0 );
    S_AXI_wvalid : in STD_LOGIC_VECTOR ( 0 to 0 )
  );
end m00_couplers_imp_C4LHUS;

architecture STRUCTURE of m00_couplers_imp_C4LHUS is
  signal m00_couplers_to_m00_couplers_ARADDR : STD_LOGIC_VECTOR ( 31 downto 0 );
  signal m00_couplers_to_m00_couplers_ARREADY : STD_LOGIC_VECTOR ( 0 to 0 );
  signal m00_couplers_to_m00_couplers_ARVALID : STD_LOGIC_VECTOR ( 0 to 0 );
  signal m00_couplers_to_m00_couplers_AWADDR : STD_LOGIC_VECTOR ( 31 downto 0 );
  signal m00_couplers_to_m00_couplers_AWREADY : STD_LOGIC_VECTOR ( 0 to 0 );
  signal m00_couplers_to_m00_couplers_AWVALID : STD_LOGIC_VECTOR ( 0 to 0 );
  signal m00_couplers_to_m00_couplers_BREADY : STD_LOGIC_VECTOR ( 0 to 0 );
  signal m00_couplers_to_m00_couplers_BRESP : STD_LOGIC_VECTOR ( 1 downto 0 );
  signal m00_couplers_to_m00_couplers_BVALID : STD_LOGIC_VECTOR ( 0 to 0 );
  signal m00_couplers_to_m00_couplers_RDATA : STD_LOGIC_VECTOR ( 31 downto 0 );
  signal m00_couplers_to_m00_couplers_RREADY : STD_LOGIC_VECTOR ( 0 to 0 );
  signal m00_couplers_to_m00_couplers_RRESP : STD_LOGIC_VECTOR ( 1 downto 0 );
  signal m00_couplers_to_m00_couplers_RVALID : STD_LOGIC_VECTOR ( 0 to 0 );
  signal m00_couplers_to_m00_couplers_WDATA : STD_LOGIC_VECTOR ( 31 downto 0 );
  signal m00_couplers_to_m00_couplers_WREADY : STD_LOGIC_VECTOR ( 0 to 0 );
  signal m00_couplers_to_m00_couplers_WSTRB : STD_LOGIC_VECTOR ( 3 downto 0 );
  signal m00_couplers_to_m00_couplers_WVALID : STD_LOGIC_VECTOR ( 0 to 0 );
begin
  M_AXI_araddr(31 downto 0) <= m00_couplers_to_m00_couplers_ARADDR(31 downto 0);
  M_AXI_arvalid(0) <= m00_couplers_to_m00_couplers_ARVALID(0);
  M_AXI_awaddr(31 downto 0) <= m00_couplers_to_m00_couplers_AWADDR(31 downto 0);
  M_AXI_awvalid(0) <= m00_couplers_to_m00_couplers_AWVALID(0);
  M_AXI_bready(0) <= m00_couplers_to_m00_couplers_BREADY(0);
  M_AXI_rready(0) <= m00_couplers_to_m00_couplers_RREADY(0);
  M_AXI_wdata(31 downto 0) <= m00_couplers_to_m00_couplers_WDATA(31 downto 0);
  M_AXI_wstrb(3 downto 0) <= m00_couplers_to_m00_couplers_WSTRB(3 downto 0);
  M_AXI_wvalid(0) <= m00_couplers_to_m00_couplers_WVALID(0);
  S_AXI_arready(0) <= m00_couplers_to_m00_couplers_ARREADY(0);
  S_AXI_awready(0) <= m00_couplers_to_m00_couplers_AWREADY(0);
  S_AXI_bresp(1 downto 0) <= m00_couplers_to_m00_couplers_BRESP(1 downto 0);
  S_AXI_bvalid(0) <= m00_couplers_to_m00_couplers_BVALID(0);
  S_AXI_rdata(31 downto 0) <= m00_couplers_to_m00_couplers_RDATA(31 downto 0);
  S_AXI_rresp(1 downto 0) <= m00_couplers_to_m00_couplers_RRESP(1 downto 0);
  S_AXI_rvalid(0) <= m00_couplers_to_m00_couplers_RVALID(0);
  S_AXI_wready(0) <= m00_couplers_to_m00_couplers_WREADY(0);
  m00_couplers_to_m00_couplers_ARADDR(31 downto 0) <= S_AXI_araddr(31 downto 0);
  m00_couplers_to_m00_couplers_ARREADY(0) <= M_AXI_arready(0);
  m00_couplers_to_m00_couplers_ARVALID(0) <= S_AXI_arvalid(0);
  m00_couplers_to_m00_couplers_AWADDR(31 downto 0) <= S_AXI_awaddr(31 downto 0);
  m00_couplers_to_m00_couplers_AWREADY(0) <= M_AXI_awready(0);
  m00_couplers_to_m00_couplers_AWVALID(0) <= S_AXI_awvalid(0);
  m00_couplers_to_m00_couplers_BREADY(0) <= S_AXI_bready(0);
  m00_couplers_to_m00_couplers_BRESP(1 downto 0) <= M_AXI_bresp(1 downto 0);
  m00_couplers_to_m00_couplers_BVALID(0) <= M_AXI_bvalid(0);
  m00_couplers_to_m00_couplers_RDATA(31 downto 0) <= M_AXI_rdata(31 downto 0);
  m00_couplers_to_m00_couplers_RREADY(0) <= S_AXI_rready(0);
  m00_couplers_to_m00_couplers_RRESP(1 downto 0) <= M_AXI_rresp(1 downto 0);
  m00_couplers_to_m00_couplers_RVALID(0) <= M_AXI_rvalid(0);
  m00_couplers_to_m00_couplers_WDATA(31 downto 0) <= S_AXI_wdata(31 downto 0);
  m00_couplers_to_m00_couplers_WREADY(0) <= M_AXI_wready(0);
  m00_couplers_to_m00_couplers_WSTRB(3 downto 0) <= S_AXI_wstrb(3 downto 0);
  m00_couplers_to_m00_couplers_WVALID(0) <= S_AXI_wvalid(0);
end STRUCTURE;
library IEEE;
use IEEE.STD_LOGIC_1164.ALL;
library UNISIM;
use UNISIM.VCOMPONENTS.ALL;
entity m01_couplers_imp_1D1R90W is
  port (
    M_ACLK : in STD_LOGIC;
    M_ARESETN : in STD_LOGIC;
    M_AXI_araddr : out STD_LOGIC_VECTOR ( 31 downto 0 );
    M_AXI_arready : in STD_LOGIC_VECTOR ( 0 to 0 );
    M_AXI_arvalid : out STD_LOGIC_VECTOR ( 0 to 0 );
    M_AXI_awaddr : out STD_LOGIC_VECTOR ( 31 downto 0 );
    M_AXI_awready : in STD_LOGIC_VECTOR ( 0 to 0 );
    M_AXI_awvalid : out STD_LOGIC_VECTOR ( 0 to 0 );
    M_AXI_bready : out STD_LOGIC_VECTOR ( 0 to 0 );
    M_AXI_bresp : in STD_LOGIC_VECTOR ( 1 downto 0 );
    M_AXI_bvalid : in STD_LOGIC_VECTOR ( 0 to 0 );
    M_AXI_rdata : in STD_LOGIC_VECTOR ( 31 downto 0 );
    M_AXI_rready : out STD_LOGIC_VECTOR ( 0 to 0 );
    M_AXI_rresp : in STD_LOGIC_VECTOR ( 1 downto 0 );
    M_AXI_rvalid : in STD_LOGIC_VECTOR ( 0 to 0 );
    M_AXI_wdata : out STD_LOGIC_VECTOR ( 31 downto 0 );
    M_AXI_wready : in STD_LOGIC_VECTOR ( 0 to 0 );
    M_AXI_wstrb : out STD_LOGIC_VECTOR ( 3 downto 0 );
    M_AXI_wvalid : out STD_LOGIC_VECTOR ( 0 to 0 );
    S_ACLK : in STD_LOGIC;
    S_ARESETN : in STD_LOGIC;
    S_AXI_araddr : in STD_LOGIC_VECTOR ( 31 downto 0 );
    S_AXI_arready : out STD_LOGIC_VECTOR ( 0 to 0 );
    S_AXI_arvalid : in STD_LOGIC_VECTOR ( 0 to 0 );
    S_AXI_awaddr : in STD_LOGIC_VECTOR ( 31 downto 0 );
    S_AXI_awready : out STD_LOGIC_VECTOR ( 0 to 0 );
    S_AXI_awvalid : in STD_LOGIC_VECTOR ( 0 to 0 );
    S_AXI_bready : in STD_LOGIC_VECTOR ( 0 to 0 );
    S_AXI_bresp : out STD_LOGIC_VECTOR ( 1 downto 0 );
    S_AXI_bvalid : out STD_LOGIC_VECTOR ( 0 to 0 );
    S_AXI_rdata : out STD_LOGIC_VECTOR ( 31 downto 0 );
    S_AXI_rready : in STD_LOGIC_VECTOR ( 0 to 0 );
    S_AXI_rresp : out STD_LOGIC_VECTOR ( 1 downto 0 );
    S_AXI_rvalid : out STD_LOGIC_VECTOR ( 0 to 0 );
    S_AXI_wdata : in STD_LOGIC_VECTOR ( 31 downto 0 );
    S_AXI_wready : out STD_LOGIC_VECTOR ( 0 to 0 );
    S_AXI_wstrb : in STD_LOGIC_VECTOR ( 3 downto 0 );
    S_AXI_wvalid : in STD_LOGIC_VECTOR ( 0 to 0 )
  );
end m01_couplers_imp_1D1R90W;

architecture STRUCTURE of m01_couplers_imp_1D1R90W is
  signal m01_couplers_to_m01_couplers_ARADDR : STD_LOGIC_VECTOR ( 31 downto 0 );
  signal m01_couplers_to_m01_couplers_ARREADY : STD_LOGIC_VECTOR ( 0 to 0 );
  signal m01_couplers_to_m01_couplers_ARVALID : STD_LOGIC_VECTOR ( 0 to 0 );
  signal m01_couplers_to_m01_couplers_AWADDR : STD_LOGIC_VECTOR ( 31 downto 0 );
  signal m01_couplers_to_m01_couplers_AWREADY : STD_LOGIC_VECTOR ( 0 to 0 );
  signal m01_couplers_to_m01_couplers_AWVALID : STD_LOGIC_VECTOR ( 0 to 0 );
  signal m01_couplers_to_m01_couplers_BREADY : STD_LOGIC_VECTOR ( 0 to 0 );
  signal m01_couplers_to_m01_couplers_BRESP : STD_LOGIC_VECTOR ( 1 downto 0 );
  signal m01_couplers_to_m01_couplers_BVALID : STD_LOGIC_VECTOR ( 0 to 0 );
  signal m01_couplers_to_m01_couplers_RDATA : STD_LOGIC_VECTOR ( 31 downto 0 );
  signal m01_couplers_to_m01_couplers_RREADY : STD_LOGIC_VECTOR ( 0 to 0 );
  signal m01_couplers_to_m01_couplers_RRESP : STD_LOGIC_VECTOR ( 1 downto 0 );
  signal m01_couplers_to_m01_couplers_RVALID : STD_LOGIC_VECTOR ( 0 to 0 );
  signal m01_couplers_to_m01_couplers_WDATA : STD_LOGIC_VECTOR ( 31 downto 0 );
  signal m01_couplers_to_m01_couplers_WREADY : STD_LOGIC_VECTOR ( 0 to 0 );
  signal m01_couplers_to_m01_couplers_WSTRB : STD_LOGIC_VECTOR ( 3 downto 0 );
  signal m01_couplers_to_m01_couplers_WVALID : STD_LOGIC_VECTOR ( 0 to 0 );
begin
  M_AXI_araddr(31 downto 0) <= m01_couplers_to_m01_couplers_ARADDR(31 downto 0);
  M_AXI_arvalid(0) <= m01_couplers_to_m01_couplers_ARVALID(0);
  M_AXI_awaddr(31 downto 0) <= m01_couplers_to_m01_couplers_AWADDR(31 downto 0);
  M_AXI_awvalid(0) <= m01_couplers_to_m01_couplers_AWVALID(0);
  M_AXI_bready(0) <= m01_couplers_to_m01_couplers_BREADY(0);
  M_AXI_rready(0) <= m01_couplers_to_m01_couplers_RREADY(0);
  M_AXI_wdata(31 downto 0) <= m01_couplers_to_m01_couplers_WDATA(31 downto 0);
  M_AXI_wstrb(3 downto 0) <= m01_couplers_to_m01_couplers_WSTRB(3 downto 0);
  M_AXI_wvalid(0) <= m01_couplers_to_m01_couplers_WVALID(0);
  S_AXI_arready(0) <= m01_couplers_to_m01_couplers_ARREADY(0);
  S_AXI_awready(0) <= m01_couplers_to_m01_couplers_AWREADY(0);
  S_AXI_bresp(1 downto 0) <= m01_couplers_to_m01_couplers_BRESP(1 downto 0);
  S_AXI_bvalid(0) <= m01_couplers_to_m01_couplers_BVALID(0);
  S_AXI_rdata(31 downto 0) <= m01_couplers_to_m01_couplers_RDATA(31 downto 0);
  S_AXI_rresp(1 downto 0) <= m01_couplers_to_m01_couplers_RRESP(1 downto 0);
  S_AXI_rvalid(0) <= m01_couplers_to_m01_couplers_RVALID(0);
  S_AXI_wready(0) <= m01_couplers_to_m01_couplers_WREADY(0);
  m01_couplers_to_m01_couplers_ARADDR(31 downto 0) <= S_AXI_araddr(31 downto 0);
  m01_couplers_to_m01_couplers_ARREADY(0) <= M_AXI_arready(0);
  m01_couplers_to_m01_couplers_ARVALID(0) <= S_AXI_arvalid(0);
  m01_couplers_to_m01_couplers_AWADDR(31 downto 0) <= S_AXI_awaddr(31 downto 0);
  m01_couplers_to_m01_couplers_AWREADY(0) <= M_AXI_awready(0);
  m01_couplers_to_m01_couplers_AWVALID(0) <= S_AXI_awvalid(0);
  m01_couplers_to_m01_couplers_BREADY(0) <= S_AXI_bready(0);
  m01_couplers_to_m01_couplers_BRESP(1 downto 0) <= M_AXI_bresp(1 downto 0);
  m01_couplers_to_m01_couplers_BVALID(0) <= M_AXI_bvalid(0);
  m01_couplers_to_m01_couplers_RDATA(31 downto 0) <= M_AXI_rdata(31 downto 0);
  m01_couplers_to_m01_couplers_RREADY(0) <= S_AXI_rready(0);
  m01_couplers_to_m01_couplers_RRESP(1 downto 0) <= M_AXI_rresp(1 downto 0);
  m01_couplers_to_m01_couplers_RVALID(0) <= M_AXI_rvalid(0);
  m01_couplers_to_m01_couplers_WDATA(31 downto 0) <= S_AXI_wdata(31 downto 0);
  m01_couplers_to_m01_couplers_WREADY(0) <= M_AXI_wready(0);
  m01_couplers_to_m01_couplers_WSTRB(3 downto 0) <= S_AXI_wstrb(3 downto 0);
  m01_couplers_to_m01_couplers_WVALID(0) <= S_AXI_wvalid(0);
end STRUCTURE;
library IEEE;
use IEEE.STD_LOGIC_1164.ALL;
library UNISIM;
use UNISIM.VCOMPONENTS.ALL;
entity m02_couplers_imp_1IZ57WT is
  port (
    M_ACLK : in STD_LOGIC;
    M_ARESETN : in STD_LOGIC;
    M_AXI_araddr : out STD_LOGIC_VECTOR ( 31 downto 0 );
    M_AXI_arprot : out STD_LOGIC_VECTOR ( 2 downto 0 );
    M_AXI_arready : in STD_LOGIC;
    M_AXI_arvalid : out STD_LOGIC;
    M_AXI_awaddr : out STD_LOGIC_VECTOR ( 31 downto 0 );
    M_AXI_awprot : out STD_LOGIC_VECTOR ( 2 downto 0 );
    M_AXI_awready : in STD_LOGIC;
    M_AXI_awvalid : out STD_LOGIC;
    M_AXI_bready : out STD_LOGIC;
    M_AXI_bresp : in STD_LOGIC_VECTOR ( 1 downto 0 );
    M_AXI_bvalid : in STD_LOGIC;
    M_AXI_rdata : in STD_LOGIC_VECTOR ( 31 downto 0 );
    M_AXI_rready : out STD_LOGIC;
    M_AXI_rresp : in STD_LOGIC_VECTOR ( 1 downto 0 );
    M_AXI_rvalid : in STD_LOGIC;
    M_AXI_wdata : out STD_LOGIC_VECTOR ( 31 downto 0 );
    M_AXI_wready : in STD_LOGIC;
    M_AXI_wstrb : out STD_LOGIC_VECTOR ( 3 downto 0 );
    M_AXI_wvalid : out STD_LOGIC;
    S_ACLK : in STD_LOGIC;
    S_ARESETN : in STD_LOGIC;
    S_AXI_araddr : in STD_LOGIC_VECTOR ( 31 downto 0 );
    S_AXI_arprot : in STD_LOGIC_VECTOR ( 2 downto 0 );
    S_AXI_arready : out STD_LOGIC;
    S_AXI_arvalid : in STD_LOGIC;
    S_AXI_awaddr : in STD_LOGIC_VECTOR ( 31 downto 0 );
    S_AXI_awprot : in STD_LOGIC_VECTOR ( 2 downto 0 );
    S_AXI_awready : out STD_LOGIC;
    S_AXI_awvalid : in STD_LOGIC;
    S_AXI_bready : in STD_LOGIC;
    S_AXI_bresp : out STD_LOGIC_VECTOR ( 1 downto 0 );
    S_AXI_bvalid : out STD_LOGIC;
    S_AXI_rdata : out STD_LOGIC_VECTOR ( 31 downto 0 );
    S_AXI_rready : in STD_LOGIC;
    S_AXI_rresp : out STD_LOGIC_VECTOR ( 1 downto 0 );
    S_AXI_rvalid : out STD_LOGIC;
    S_AXI_wdata : in STD_LOGIC_VECTOR ( 31 downto 0 );
    S_AXI_wready : out STD_LOGIC;
    S_AXI_wstrb : in STD_LOGIC_VECTOR ( 3 downto 0 );
    S_AXI_wvalid : in STD_LOGIC
  );
end m02_couplers_imp_1IZ57WT;

architecture STRUCTURE of m02_couplers_imp_1IZ57WT is
  signal m02_couplers_to_m02_couplers_ARADDR : STD_LOGIC_VECTOR ( 31 downto 0 );
  signal m02_couplers_to_m02_couplers_ARPROT : STD_LOGIC_VECTOR ( 2 downto 0 );
  signal m02_couplers_to_m02_couplers_ARREADY : STD_LOGIC;
  signal m02_couplers_to_m02_couplers_ARVALID : STD_LOGIC;
  signal m02_couplers_to_m02_couplers_AWADDR : STD_LOGIC_VECTOR ( 31 downto 0 );
  signal m02_couplers_to_m02_couplers_AWPROT : STD_LOGIC_VECTOR ( 2 downto 0 );
  signal m02_couplers_to_m02_couplers_AWREADY : STD_LOGIC;
  signal m02_couplers_to_m02_couplers_AWVALID : STD_LOGIC;
  signal m02_couplers_to_m02_couplers_BREADY : STD_LOGIC;
  signal m02_couplers_to_m02_couplers_BRESP : STD_LOGIC_VECTOR ( 1 downto 0 );
  signal m02_couplers_to_m02_couplers_BVALID : STD_LOGIC;
  signal m02_couplers_to_m02_couplers_RDATA : STD_LOGIC_VECTOR ( 31 downto 0 );
  signal m02_couplers_to_m02_couplers_RREADY : STD_LOGIC;
  signal m02_couplers_to_m02_couplers_RRESP : STD_LOGIC_VECTOR ( 1 downto 0 );
  signal m02_couplers_to_m02_couplers_RVALID : STD_LOGIC;
  signal m02_couplers_to_m02_couplers_WDATA : STD_LOGIC_VECTOR ( 31 downto 0 );
  signal m02_couplers_to_m02_couplers_WREADY : STD_LOGIC;
  signal m02_couplers_to_m02_couplers_WSTRB : STD_LOGIC_VECTOR ( 3 downto 0 );
  signal m02_couplers_to_m02_couplers_WVALID : STD_LOGIC;
begin
  M_AXI_araddr(31 downto 0) <= m02_couplers_to_m02_couplers_ARADDR(31 downto 0);
  M_AXI_arprot(2 downto 0) <= m02_couplers_to_m02_couplers_ARPROT(2 downto 0);
  M_AXI_arvalid <= m02_couplers_to_m02_couplers_ARVALID;
  M_AXI_awaddr(31 downto 0) <= m02_couplers_to_m02_couplers_AWADDR(31 downto 0);
  M_AXI_awprot(2 downto 0) <= m02_couplers_to_m02_couplers_AWPROT(2 downto 0);
  M_AXI_awvalid <= m02_couplers_to_m02_couplers_AWVALID;
  M_AXI_bready <= m02_couplers_to_m02_couplers_BREADY;
  M_AXI_rready <= m02_couplers_to_m02_couplers_RREADY;
  M_AXI_wdata(31 downto 0) <= m02_couplers_to_m02_couplers_WDATA(31 downto 0);
  M_AXI_wstrb(3 downto 0) <= m02_couplers_to_m02_couplers_WSTRB(3 downto 0);
  M_AXI_wvalid <= m02_couplers_to_m02_couplers_WVALID;
  S_AXI_arready <= m02_couplers_to_m02_couplers_ARREADY;
  S_AXI_awready <= m02_couplers_to_m02_couplers_AWREADY;
  S_AXI_bresp(1 downto 0) <= m02_couplers_to_m02_couplers_BRESP(1 downto 0);
  S_AXI_bvalid <= m02_couplers_to_m02_couplers_BVALID;
  S_AXI_rdata(31 downto 0) <= m02_couplers_to_m02_couplers_RDATA(31 downto 0);
  S_AXI_rresp(1 downto 0) <= m02_couplers_to_m02_couplers_RRESP(1 downto 0);
  S_AXI_rvalid <= m02_couplers_to_m02_couplers_RVALID;
  S_AXI_wready <= m02_couplers_to_m02_couplers_WREADY;
  m02_couplers_to_m02_couplers_ARADDR(31 downto 0) <= S_AXI_araddr(31 downto 0);
  m02_couplers_to_m02_couplers_ARPROT(2 downto 0) <= S_AXI_arprot(2 downto 0);
  m02_couplers_to_m02_couplers_ARREADY <= M_AXI_arready;
  m02_couplers_to_m02_couplers_ARVALID <= S_AXI_arvalid;
  m02_couplers_to_m02_couplers_AWADDR(31 downto 0) <= S_AXI_awaddr(31 downto 0);
  m02_couplers_to_m02_couplers_AWPROT(2 downto 0) <= S_AXI_awprot(2 downto 0);
  m02_couplers_to_m02_couplers_AWREADY <= M_AXI_awready;
  m02_couplers_to_m02_couplers_AWVALID <= S_AXI_awvalid;
  m02_couplers_to_m02_couplers_BREADY <= S_AXI_bready;
  m02_couplers_to_m02_couplers_BRESP(1 downto 0) <= M_AXI_bresp(1 downto 0);
  m02_couplers_to_m02_couplers_BVALID <= M_AXI_bvalid;
  m02_couplers_to_m02_couplers_RDATA(31 downto 0) <= M_AXI_rdata(31 downto 0);
  m02_couplers_to_m02_couplers_RREADY <= S_AXI_rready;
  m02_couplers_to_m02_couplers_RRESP(1 downto 0) <= M_AXI_rresp(1 downto 0);
  m02_couplers_to_m02_couplers_RVALID <= M_AXI_rvalid;
  m02_couplers_to_m02_couplers_WDATA(31 downto 0) <= S_AXI_wdata(31 downto 0);
  m02_couplers_to_m02_couplers_WREADY <= M_AXI_wready;
  m02_couplers_to_m02_couplers_WSTRB(3 downto 0) <= S_AXI_wstrb(3 downto 0);
  m02_couplers_to_m02_couplers_WVALID <= S_AXI_wvalid;
end STRUCTURE;
library IEEE;
use IEEE.STD_LOGIC_1164.ALL;
library UNISIM;
use UNISIM.VCOMPONENTS.ALL;
entity microblaze_0_local_memory_imp_1WC3RE7 is
  port (
    DLMB_abus : in STD_LOGIC_VECTOR ( 0 to 31 );
    DLMB_addrstrobe : in STD_LOGIC;
    DLMB_be : in STD_LOGIC_VECTOR ( 0 to 3 );
    DLMB_ce : out STD_LOGIC;
    DLMB_readdbus : out STD_LOGIC_VECTOR ( 0 to 31 );
    DLMB_readstrobe : in STD_LOGIC;
    DLMB_ready : out STD_LOGIC;
    DLMB_ue : out STD_LOGIC;
    DLMB_wait : out STD_LOGIC;
    DLMB_writedbus : in STD_LOGIC_VECTOR ( 0 to 31 );
    DLMB_writestrobe : in STD_LOGIC;
    ILMB_abus : in STD_LOGIC_VECTOR ( 0 to 31 );
    ILMB_addrstrobe : in STD_LOGIC;
    ILMB_ce : out STD_LOGIC;
    ILMB_readdbus : out STD_LOGIC_VECTOR ( 0 to 31 );
    ILMB_readstrobe : in STD_LOGIC;
    ILMB_ready : out STD_LOGIC;
    ILMB_ue : out STD_LOGIC;
    ILMB_wait : out STD_LOGIC;
    LMB_Clk : in STD_LOGIC;
    SYS_Rst : in STD_LOGIC
  );
end microblaze_0_local_memory_imp_1WC3RE7;

architecture STRUCTURE of microblaze_0_local_memory_imp_1WC3RE7 is
  component skrach_design_dlmb_v10_3 is
  port (
    LMB_Clk : in STD_LOGIC;
    SYS_Rst : in STD_LOGIC;
    LMB_Rst : out STD_LOGIC;
    M_ABus : in STD_LOGIC_VECTOR ( 0 to 31 );
    M_ReadStrobe : in STD_LOGIC;
    M_WriteStrobe : in STD_LOGIC;
    M_AddrStrobe : in STD_LOGIC;
    M_DBus : in STD_LOGIC_VECTOR ( 0 to 31 );
    M_BE : in STD_LOGIC_VECTOR ( 0 to 3 );
    Sl_DBus : in STD_LOGIC_VECTOR ( 0 to 31 );
    Sl_Ready : in STD_LOGIC_VECTOR ( 0 to 0 );
    Sl_Wait : in STD_LOGIC_VECTOR ( 0 to 0 );
    Sl_UE : in STD_LOGIC_VECTOR ( 0 to 0 );
    Sl_CE : in STD_LOGIC_VECTOR ( 0 to 0 );
    LMB_ABus : out STD_LOGIC_VECTOR ( 0 to 31 );
    LMB_ReadStrobe : out STD_LOGIC;
    LMB_WriteStrobe : out STD_LOGIC;
    LMB_AddrStrobe : out STD_LOGIC;
    LMB_ReadDBus : out STD_LOGIC_VECTOR ( 0 to 31 );
    LMB_WriteDBus : out STD_LOGIC_VECTOR ( 0 to 31 );
    LMB_Ready : out STD_LOGIC;
    LMB_Wait : out STD_LOGIC;
    LMB_UE : out STD_LOGIC;
    LMB_CE : out STD_LOGIC;
    LMB_BE : out STD_LOGIC_VECTOR ( 0 to 3 )
  );
  end component skrach_design_dlmb_v10_3;
  component skrach_design_ilmb_v10_3 is
  port (
    LMB_Clk : in STD_LOGIC;
    SYS_Rst : in STD_LOGIC;
    LMB_Rst : out STD_LOGIC;
    M_ABus : in STD_LOGIC_VECTOR ( 0 to 31 );
    M_ReadStrobe : in STD_LOGIC;
    M_WriteStrobe : in STD_LOGIC;
    M_AddrStrobe : in STD_LOGIC;
    M_DBus : in STD_LOGIC_VECTOR ( 0 to 31 );
    M_BE : in STD_LOGIC_VECTOR ( 0 to 3 );
    Sl_DBus : in STD_LOGIC_VECTOR ( 0 to 31 );
    Sl_Ready : in STD_LOGIC_VECTOR ( 0 to 0 );
    Sl_Wait : in STD_LOGIC_VECTOR ( 0 to 0 );
    Sl_UE : in STD_LOGIC_VECTOR ( 0 to 0 );
    Sl_CE : in STD_LOGIC_VECTOR ( 0 to 0 );
    LMB_ABus : out STD_LOGIC_VECTOR ( 0 to 31 );
    LMB_ReadStrobe : out STD_LOGIC;
    LMB_WriteStrobe : out STD_LOGIC;
    LMB_AddrStrobe : out STD_LOGIC;
    LMB_ReadDBus : out STD_LOGIC_VECTOR ( 0 to 31 );
    LMB_WriteDBus : out STD_LOGIC_VECTOR ( 0 to 31 );
    LMB_Ready : out STD_LOGIC;
    LMB_Wait : out STD_LOGIC;
    LMB_UE : out STD_LOGIC;
    LMB_CE : out STD_LOGIC;
    LMB_BE : out STD_LOGIC_VECTOR ( 0 to 3 )
  );
  end component skrach_design_ilmb_v10_3;
  component skrach_design_dlmb_bram_if_cntlr_3 is
  port (
    LMB_Clk : in STD_LOGIC;
    LMB_Rst : in STD_LOGIC;
    LMB_ABus : in STD_LOGIC_VECTOR ( 0 to 31 );
    LMB_WriteDBus : in STD_LOGIC_VECTOR ( 0 to 31 );
    LMB_AddrStrobe : in STD_LOGIC;
    LMB_ReadStrobe : in STD_LOGIC;
    LMB_WriteStrobe : in STD_LOGIC;
    LMB_BE : in STD_LOGIC_VECTOR ( 0 to 3 );
    Sl_DBus : out STD_LOGIC_VECTOR ( 0 to 31 );
    Sl_Ready : out STD_LOGIC;
    Sl_Wait : out STD_LOGIC;
    Sl_UE : out STD_LOGIC;
    Sl_CE : out STD_LOGIC;
    BRAM_Rst_A : out STD_LOGIC;
    BRAM_Clk_A : out STD_LOGIC;
    BRAM_Addr_A : out STD_LOGIC_VECTOR ( 0 to 31 );
    BRAM_EN_A : out STD_LOGIC;
    BRAM_WEN_A : out STD_LOGIC_VECTOR ( 0 to 3 );
    BRAM_Dout_A : out STD_LOGIC_VECTOR ( 0 to 31 );
    BRAM_Din_A : in STD_LOGIC_VECTOR ( 0 to 31 )
  );
  end component skrach_design_dlmb_bram_if_cntlr_3;
  component skrach_design_ilmb_bram_if_cntlr_3 is
  port (
    LMB_Clk : in STD_LOGIC;
    LMB_Rst : in STD_LOGIC;
    LMB_ABus : in STD_LOGIC_VECTOR ( 0 to 31 );
    LMB_WriteDBus : in STD_LOGIC_VECTOR ( 0 to 31 );
    LMB_AddrStrobe : in STD_LOGIC;
    LMB_ReadStrobe : in STD_LOGIC;
    LMB_WriteStrobe : in STD_LOGIC;
    LMB_BE : in STD_LOGIC_VECTOR ( 0 to 3 );
    Sl_DBus : out STD_LOGIC_VECTOR ( 0 to 31 );
    Sl_Ready : out STD_LOGIC;
    Sl_Wait : out STD_LOGIC;
    Sl_UE : out STD_LOGIC;
    Sl_CE : out STD_LOGIC;
    BRAM_Rst_A : out STD_LOGIC;
    BRAM_Clk_A : out STD_LOGIC;
    BRAM_Addr_A : out STD_LOGIC_VECTOR ( 0 to 31 );
    BRAM_EN_A : out STD_LOGIC;
    BRAM_WEN_A : out STD_LOGIC_VECTOR ( 0 to 3 );
    BRAM_Dout_A : out STD_LOGIC_VECTOR ( 0 to 31 );
    BRAM_Din_A : in STD_LOGIC_VECTOR ( 0 to 31 )
  );
  end component skrach_design_ilmb_bram_if_cntlr_3;
  component skrach_design_lmb_bram_3 is
  port (
    clka : in STD_LOGIC;
    rsta : in STD_LOGIC;
    ena : in STD_LOGIC;
    wea : in STD_LOGIC_VECTOR ( 3 downto 0 );
    addra : in STD_LOGIC_VECTOR ( 31 downto 0 );
    dina : in STD_LOGIC_VECTOR ( 31 downto 0 );
    douta : out STD_LOGIC_VECTOR ( 31 downto 0 );
    clkb : in STD_LOGIC;
    rstb : in STD_LOGIC;
    enb : in STD_LOGIC;
    web : in STD_LOGIC_VECTOR ( 3 downto 0 );
    addrb : in STD_LOGIC_VECTOR ( 31 downto 0 );
    dinb : in STD_LOGIC_VECTOR ( 31 downto 0 );
    doutb : out STD_LOGIC_VECTOR ( 31 downto 0 );
    rsta_busy : out STD_LOGIC;
    rstb_busy : out STD_LOGIC
  );
  end component skrach_design_lmb_bram_3;
  signal SYS_Rst_1 : STD_LOGIC;
  signal microblaze_0_Clk : STD_LOGIC;
  signal microblaze_0_dlmb_ABUS : STD_LOGIC_VECTOR ( 0 to 31 );
  signal microblaze_0_dlmb_ADDRSTROBE : STD_LOGIC;
  signal microblaze_0_dlmb_BE : STD_LOGIC_VECTOR ( 0 to 3 );
  signal microblaze_0_dlmb_CE : STD_LOGIC;
  signal microblaze_0_dlmb_READDBUS : STD_LOGIC_VECTOR ( 0 to 31 );
  signal microblaze_0_dlmb_READSTROBE : STD_LOGIC;
  signal microblaze_0_dlmb_READY : STD_LOGIC;
  signal microblaze_0_dlmb_UE : STD_LOGIC;
  signal microblaze_0_dlmb_WAIT : STD_LOGIC;
  signal microblaze_0_dlmb_WRITEDBUS : STD_LOGIC_VECTOR ( 0 to 31 );
  signal microblaze_0_dlmb_WRITESTROBE : STD_LOGIC;
  signal microblaze_0_dlmb_bus_ABUS : STD_LOGIC_VECTOR ( 0 to 31 );
  signal microblaze_0_dlmb_bus_ADDRSTROBE : STD_LOGIC;
  signal microblaze_0_dlmb_bus_BE : STD_LOGIC_VECTOR ( 0 to 3 );
  signal microblaze_0_dlmb_bus_CE : STD_LOGIC;
  signal microblaze_0_dlmb_bus_READDBUS : STD_LOGIC_VECTOR ( 0 to 31 );
  signal microblaze_0_dlmb_bus_READSTROBE : STD_LOGIC;
  signal microblaze_0_dlmb_bus_READY : STD_LOGIC;
  signal microblaze_0_dlmb_bus_UE : STD_LOGIC;
  signal microblaze_0_dlmb_bus_WAIT : STD_LOGIC;
  signal microblaze_0_dlmb_bus_WRITEDBUS : STD_LOGIC_VECTOR ( 0 to 31 );
  signal microblaze_0_dlmb_bus_WRITESTROBE : STD_LOGIC;
  signal microblaze_0_dlmb_cntlr_ADDR : STD_LOGIC_VECTOR ( 0 to 31 );
  signal microblaze_0_dlmb_cntlr_CLK : STD_LOGIC;
  signal microblaze_0_dlmb_cntlr_DIN : STD_LOGIC_VECTOR ( 0 to 31 );
  signal microblaze_0_dlmb_cntlr_DOUT : STD_LOGIC_VECTOR ( 31 downto 0 );
  signal microblaze_0_dlmb_cntlr_EN : STD_LOGIC;
  signal microblaze_0_dlmb_cntlr_RST : STD_LOGIC;
  signal microblaze_0_dlmb_cntlr_WE : STD_LOGIC_VECTOR ( 0 to 3 );
  signal microblaze_0_ilmb_ABUS : STD_LOGIC_VECTOR ( 0 to 31 );
  signal microblaze_0_ilmb_ADDRSTROBE : STD_LOGIC;
  signal microblaze_0_ilmb_CE : STD_LOGIC;
  signal microblaze_0_ilmb_READDBUS : STD_LOGIC_VECTOR ( 0 to 31 );
  signal microblaze_0_ilmb_READSTROBE : STD_LOGIC;
  signal microblaze_0_ilmb_READY : STD_LOGIC;
  signal microblaze_0_ilmb_UE : STD_LOGIC;
  signal microblaze_0_ilmb_WAIT : STD_LOGIC;
  signal microblaze_0_ilmb_bus_ABUS : STD_LOGIC_VECTOR ( 0 to 31 );
  signal microblaze_0_ilmb_bus_ADDRSTROBE : STD_LOGIC;
  signal microblaze_0_ilmb_bus_BE : STD_LOGIC_VECTOR ( 0 to 3 );
  signal microblaze_0_ilmb_bus_CE : STD_LOGIC;
  signal microblaze_0_ilmb_bus_READDBUS : STD_LOGIC_VECTOR ( 0 to 31 );
  signal microblaze_0_ilmb_bus_READSTROBE : STD_LOGIC;
  signal microblaze_0_ilmb_bus_READY : STD_LOGIC;
  signal microblaze_0_ilmb_bus_UE : STD_LOGIC;
  signal microblaze_0_ilmb_bus_WAIT : STD_LOGIC;
  signal microblaze_0_ilmb_bus_WRITEDBUS : STD_LOGIC_VECTOR ( 0 to 31 );
  signal microblaze_0_ilmb_bus_WRITESTROBE : STD_LOGIC;
  signal microblaze_0_ilmb_cntlr_ADDR : STD_LOGIC_VECTOR ( 0 to 31 );
  signal microblaze_0_ilmb_cntlr_CLK : STD_LOGIC;
  signal microblaze_0_ilmb_cntlr_DIN : STD_LOGIC_VECTOR ( 0 to 31 );
  signal microblaze_0_ilmb_cntlr_DOUT : STD_LOGIC_VECTOR ( 31 downto 0 );
  signal microblaze_0_ilmb_cntlr_EN : STD_LOGIC;
  signal microblaze_0_ilmb_cntlr_RST : STD_LOGIC;
  signal microblaze_0_ilmb_cntlr_WE : STD_LOGIC_VECTOR ( 0 to 3 );
  signal NLW_dlmb_v10_LMB_Rst_UNCONNECTED : STD_LOGIC;
  signal NLW_ilmb_v10_LMB_Rst_UNCONNECTED : STD_LOGIC;
  signal NLW_lmb_bram_rsta_busy_UNCONNECTED : STD_LOGIC;
  signal NLW_lmb_bram_rstb_busy_UNCONNECTED : STD_LOGIC;
  attribute BMM_INFO_ADDRESS_SPACE : string;
  attribute BMM_INFO_ADDRESS_SPACE of dlmb_bram_if_cntlr : label is "byte  0x00000000 32 > skrach_design microblaze_0_local_memory/lmb_bram";
  attribute KEEP_HIERARCHY : string;
  attribute KEEP_HIERARCHY of dlmb_bram_if_cntlr : label is "yes";
begin
  DLMB_ce <= microblaze_0_dlmb_CE;
  DLMB_readdbus(0 to 31) <= microblaze_0_dlmb_READDBUS(0 to 31);
  DLMB_ready <= microblaze_0_dlmb_READY;
  DLMB_ue <= microblaze_0_dlmb_UE;
  DLMB_wait <= microblaze_0_dlmb_WAIT;
  ILMB_ce <= microblaze_0_ilmb_CE;
  ILMB_readdbus(0 to 31) <= microblaze_0_ilmb_READDBUS(0 to 31);
  ILMB_ready <= microblaze_0_ilmb_READY;
  ILMB_ue <= microblaze_0_ilmb_UE;
  ILMB_wait <= microblaze_0_ilmb_WAIT;
  SYS_Rst_1 <= SYS_Rst;
  microblaze_0_Clk <= LMB_Clk;
  microblaze_0_dlmb_ABUS(0 to 31) <= DLMB_abus(0 to 31);
  microblaze_0_dlmb_ADDRSTROBE <= DLMB_addrstrobe;
  microblaze_0_dlmb_BE(0 to 3) <= DLMB_be(0 to 3);
  microblaze_0_dlmb_READSTROBE <= DLMB_readstrobe;
  microblaze_0_dlmb_WRITEDBUS(0 to 31) <= DLMB_writedbus(0 to 31);
  microblaze_0_dlmb_WRITESTROBE <= DLMB_writestrobe;
  microblaze_0_ilmb_ABUS(0 to 31) <= ILMB_abus(0 to 31);
  microblaze_0_ilmb_ADDRSTROBE <= ILMB_addrstrobe;
  microblaze_0_ilmb_READSTROBE <= ILMB_readstrobe;
dlmb_bram_if_cntlr: component skrach_design_dlmb_bram_if_cntlr_3
     port map (
      BRAM_Addr_A(0 to 31) => microblaze_0_dlmb_cntlr_ADDR(0 to 31),
      BRAM_Clk_A => microblaze_0_dlmb_cntlr_CLK,
      BRAM_Din_A(0) => microblaze_0_dlmb_cntlr_DOUT(31),
      BRAM_Din_A(1) => microblaze_0_dlmb_cntlr_DOUT(30),
      BRAM_Din_A(2) => microblaze_0_dlmb_cntlr_DOUT(29),
      BRAM_Din_A(3) => microblaze_0_dlmb_cntlr_DOUT(28),
      BRAM_Din_A(4) => microblaze_0_dlmb_cntlr_DOUT(27),
      BRAM_Din_A(5) => microblaze_0_dlmb_cntlr_DOUT(26),
      BRAM_Din_A(6) => microblaze_0_dlmb_cntlr_DOUT(25),
      BRAM_Din_A(7) => microblaze_0_dlmb_cntlr_DOUT(24),
      BRAM_Din_A(8) => microblaze_0_dlmb_cntlr_DOUT(23),
      BRAM_Din_A(9) => microblaze_0_dlmb_cntlr_DOUT(22),
      BRAM_Din_A(10) => microblaze_0_dlmb_cntlr_DOUT(21),
      BRAM_Din_A(11) => microblaze_0_dlmb_cntlr_DOUT(20),
      BRAM_Din_A(12) => microblaze_0_dlmb_cntlr_DOUT(19),
      BRAM_Din_A(13) => microblaze_0_dlmb_cntlr_DOUT(18),
      BRAM_Din_A(14) => microblaze_0_dlmb_cntlr_DOUT(17),
      BRAM_Din_A(15) => microblaze_0_dlmb_cntlr_DOUT(16),
      BRAM_Din_A(16) => microblaze_0_dlmb_cntlr_DOUT(15),
      BRAM_Din_A(17) => microblaze_0_dlmb_cntlr_DOUT(14),
      BRAM_Din_A(18) => microblaze_0_dlmb_cntlr_DOUT(13),
      BRAM_Din_A(19) => microblaze_0_dlmb_cntlr_DOUT(12),
      BRAM_Din_A(20) => microblaze_0_dlmb_cntlr_DOUT(11),
      BRAM_Din_A(21) => microblaze_0_dlmb_cntlr_DOUT(10),
      BRAM_Din_A(22) => microblaze_0_dlmb_cntlr_DOUT(9),
      BRAM_Din_A(23) => microblaze_0_dlmb_cntlr_DOUT(8),
      BRAM_Din_A(24) => microblaze_0_dlmb_cntlr_DOUT(7),
      BRAM_Din_A(25) => microblaze_0_dlmb_cntlr_DOUT(6),
      BRAM_Din_A(26) => microblaze_0_dlmb_cntlr_DOUT(5),
      BRAM_Din_A(27) => microblaze_0_dlmb_cntlr_DOUT(4),
      BRAM_Din_A(28) => microblaze_0_dlmb_cntlr_DOUT(3),
      BRAM_Din_A(29) => microblaze_0_dlmb_cntlr_DOUT(2),
      BRAM_Din_A(30) => microblaze_0_dlmb_cntlr_DOUT(1),
      BRAM_Din_A(31) => microblaze_0_dlmb_cntlr_DOUT(0),
      BRAM_Dout_A(0 to 31) => microblaze_0_dlmb_cntlr_DIN(0 to 31),
      BRAM_EN_A => microblaze_0_dlmb_cntlr_EN,
      BRAM_Rst_A => microblaze_0_dlmb_cntlr_RST,
      BRAM_WEN_A(0 to 3) => microblaze_0_dlmb_cntlr_WE(0 to 3),
      LMB_ABus(0 to 31) => microblaze_0_dlmb_bus_ABUS(0 to 31),
      LMB_AddrStrobe => microblaze_0_dlmb_bus_ADDRSTROBE,
      LMB_BE(0 to 3) => microblaze_0_dlmb_bus_BE(0 to 3),
      LMB_Clk => microblaze_0_Clk,
      LMB_ReadStrobe => microblaze_0_dlmb_bus_READSTROBE,
      LMB_Rst => SYS_Rst_1,
      LMB_WriteDBus(0 to 31) => microblaze_0_dlmb_bus_WRITEDBUS(0 to 31),
      LMB_WriteStrobe => microblaze_0_dlmb_bus_WRITESTROBE,
      Sl_CE => microblaze_0_dlmb_bus_CE,
      Sl_DBus(0 to 31) => microblaze_0_dlmb_bus_READDBUS(0 to 31),
      Sl_Ready => microblaze_0_dlmb_bus_READY,
      Sl_UE => microblaze_0_dlmb_bus_UE,
      Sl_Wait => microblaze_0_dlmb_bus_WAIT
    );
dlmb_v10: component skrach_design_dlmb_v10_3
     port map (
      LMB_ABus(0 to 31) => microblaze_0_dlmb_bus_ABUS(0 to 31),
      LMB_AddrStrobe => microblaze_0_dlmb_bus_ADDRSTROBE,
      LMB_BE(0 to 3) => microblaze_0_dlmb_bus_BE(0 to 3),
      LMB_CE => microblaze_0_dlmb_CE,
      LMB_Clk => microblaze_0_Clk,
      LMB_ReadDBus(0 to 31) => microblaze_0_dlmb_READDBUS(0 to 31),
      LMB_ReadStrobe => microblaze_0_dlmb_bus_READSTROBE,
      LMB_Ready => microblaze_0_dlmb_READY,
      LMB_Rst => NLW_dlmb_v10_LMB_Rst_UNCONNECTED,
      LMB_UE => microblaze_0_dlmb_UE,
      LMB_Wait => microblaze_0_dlmb_WAIT,
      LMB_WriteDBus(0 to 31) => microblaze_0_dlmb_bus_WRITEDBUS(0 to 31),
      LMB_WriteStrobe => microblaze_0_dlmb_bus_WRITESTROBE,
      M_ABus(0 to 31) => microblaze_0_dlmb_ABUS(0 to 31),
      M_AddrStrobe => microblaze_0_dlmb_ADDRSTROBE,
      M_BE(0 to 3) => microblaze_0_dlmb_BE(0 to 3),
      M_DBus(0 to 31) => microblaze_0_dlmb_WRITEDBUS(0 to 31),
      M_ReadStrobe => microblaze_0_dlmb_READSTROBE,
      M_WriteStrobe => microblaze_0_dlmb_WRITESTROBE,
      SYS_Rst => SYS_Rst_1,
      Sl_CE(0) => microblaze_0_dlmb_bus_CE,
      Sl_DBus(0 to 31) => microblaze_0_dlmb_bus_READDBUS(0 to 31),
      Sl_Ready(0) => microblaze_0_dlmb_bus_READY,
      Sl_UE(0) => microblaze_0_dlmb_bus_UE,
      Sl_Wait(0) => microblaze_0_dlmb_bus_WAIT
    );
ilmb_bram_if_cntlr: component skrach_design_ilmb_bram_if_cntlr_3
     port map (
      BRAM_Addr_A(0 to 31) => microblaze_0_ilmb_cntlr_ADDR(0 to 31),
      BRAM_Clk_A => microblaze_0_ilmb_cntlr_CLK,
      BRAM_Din_A(0) => microblaze_0_ilmb_cntlr_DOUT(31),
      BRAM_Din_A(1) => microblaze_0_ilmb_cntlr_DOUT(30),
      BRAM_Din_A(2) => microblaze_0_ilmb_cntlr_DOUT(29),
      BRAM_Din_A(3) => microblaze_0_ilmb_cntlr_DOUT(28),
      BRAM_Din_A(4) => microblaze_0_ilmb_cntlr_DOUT(27),
      BRAM_Din_A(5) => microblaze_0_ilmb_cntlr_DOUT(26),
      BRAM_Din_A(6) => microblaze_0_ilmb_cntlr_DOUT(25),
      BRAM_Din_A(7) => microblaze_0_ilmb_cntlr_DOUT(24),
      BRAM_Din_A(8) => microblaze_0_ilmb_cntlr_DOUT(23),
      BRAM_Din_A(9) => microblaze_0_ilmb_cntlr_DOUT(22),
      BRAM_Din_A(10) => microblaze_0_ilmb_cntlr_DOUT(21),
      BRAM_Din_A(11) => microblaze_0_ilmb_cntlr_DOUT(20),
      BRAM_Din_A(12) => microblaze_0_ilmb_cntlr_DOUT(19),
      BRAM_Din_A(13) => microblaze_0_ilmb_cntlr_DOUT(18),
      BRAM_Din_A(14) => microblaze_0_ilmb_cntlr_DOUT(17),
      BRAM_Din_A(15) => microblaze_0_ilmb_cntlr_DOUT(16),
      BRAM_Din_A(16) => microblaze_0_ilmb_cntlr_DOUT(15),
      BRAM_Din_A(17) => microblaze_0_ilmb_cntlr_DOUT(14),
      BRAM_Din_A(18) => microblaze_0_ilmb_cntlr_DOUT(13),
      BRAM_Din_A(19) => microblaze_0_ilmb_cntlr_DOUT(12),
      BRAM_Din_A(20) => microblaze_0_ilmb_cntlr_DOUT(11),
      BRAM_Din_A(21) => microblaze_0_ilmb_cntlr_DOUT(10),
      BRAM_Din_A(22) => microblaze_0_ilmb_cntlr_DOUT(9),
      BRAM_Din_A(23) => microblaze_0_ilmb_cntlr_DOUT(8),
      BRAM_Din_A(24) => microblaze_0_ilmb_cntlr_DOUT(7),
      BRAM_Din_A(25) => microblaze_0_ilmb_cntlr_DOUT(6),
      BRAM_Din_A(26) => microblaze_0_ilmb_cntlr_DOUT(5),
      BRAM_Din_A(27) => microblaze_0_ilmb_cntlr_DOUT(4),
      BRAM_Din_A(28) => microblaze_0_ilmb_cntlr_DOUT(3),
      BRAM_Din_A(29) => microblaze_0_ilmb_cntlr_DOUT(2),
      BRAM_Din_A(30) => microblaze_0_ilmb_cntlr_DOUT(1),
      BRAM_Din_A(31) => microblaze_0_ilmb_cntlr_DOUT(0),
      BRAM_Dout_A(0 to 31) => microblaze_0_ilmb_cntlr_DIN(0 to 31),
      BRAM_EN_A => microblaze_0_ilmb_cntlr_EN,
      BRAM_Rst_A => microblaze_0_ilmb_cntlr_RST,
      BRAM_WEN_A(0 to 3) => microblaze_0_ilmb_cntlr_WE(0 to 3),
      LMB_ABus(0 to 31) => microblaze_0_ilmb_bus_ABUS(0 to 31),
      LMB_AddrStrobe => microblaze_0_ilmb_bus_ADDRSTROBE,
      LMB_BE(0 to 3) => microblaze_0_ilmb_bus_BE(0 to 3),
      LMB_Clk => microblaze_0_Clk,
      LMB_ReadStrobe => microblaze_0_ilmb_bus_READSTROBE,
      LMB_Rst => SYS_Rst_1,
      LMB_WriteDBus(0 to 31) => microblaze_0_ilmb_bus_WRITEDBUS(0 to 31),
      LMB_WriteStrobe => microblaze_0_ilmb_bus_WRITESTROBE,
      Sl_CE => microblaze_0_ilmb_bus_CE,
      Sl_DBus(0 to 31) => microblaze_0_ilmb_bus_READDBUS(0 to 31),
      Sl_Ready => microblaze_0_ilmb_bus_READY,
      Sl_UE => microblaze_0_ilmb_bus_UE,
      Sl_Wait => microblaze_0_ilmb_bus_WAIT
    );
ilmb_v10: component skrach_design_ilmb_v10_3
     port map (
      LMB_ABus(0 to 31) => microblaze_0_ilmb_bus_ABUS(0 to 31),
      LMB_AddrStrobe => microblaze_0_ilmb_bus_ADDRSTROBE,
      LMB_BE(0 to 3) => microblaze_0_ilmb_bus_BE(0 to 3),
      LMB_CE => microblaze_0_ilmb_CE,
      LMB_Clk => microblaze_0_Clk,
      LMB_ReadDBus(0 to 31) => microblaze_0_ilmb_READDBUS(0 to 31),
      LMB_ReadStrobe => microblaze_0_ilmb_bus_READSTROBE,
      LMB_Ready => microblaze_0_ilmb_READY,
      LMB_Rst => NLW_ilmb_v10_LMB_Rst_UNCONNECTED,
      LMB_UE => microblaze_0_ilmb_UE,
      LMB_Wait => microblaze_0_ilmb_WAIT,
      LMB_WriteDBus(0 to 31) => microblaze_0_ilmb_bus_WRITEDBUS(0 to 31),
      LMB_WriteStrobe => microblaze_0_ilmb_bus_WRITESTROBE,
      M_ABus(0 to 31) => microblaze_0_ilmb_ABUS(0 to 31),
      M_AddrStrobe => microblaze_0_ilmb_ADDRSTROBE,
      M_BE(0 to 3) => B"0000",
      M_DBus(0 to 31) => B"00000000000000000000000000000000",
      M_ReadStrobe => microblaze_0_ilmb_READSTROBE,
      M_WriteStrobe => '0',
      SYS_Rst => SYS_Rst_1,
      Sl_CE(0) => microblaze_0_ilmb_bus_CE,
      Sl_DBus(0 to 31) => microblaze_0_ilmb_bus_READDBUS(0 to 31),
      Sl_Ready(0) => microblaze_0_ilmb_bus_READY,
      Sl_UE(0) => microblaze_0_ilmb_bus_UE,
      Sl_Wait(0) => microblaze_0_ilmb_bus_WAIT
    );
lmb_bram: component skrach_design_lmb_bram_3
     port map (
      addra(31) => microblaze_0_dlmb_cntlr_ADDR(0),
      addra(30) => microblaze_0_dlmb_cntlr_ADDR(1),
      addra(29) => microblaze_0_dlmb_cntlr_ADDR(2),
      addra(28) => microblaze_0_dlmb_cntlr_ADDR(3),
      addra(27) => microblaze_0_dlmb_cntlr_ADDR(4),
      addra(26) => microblaze_0_dlmb_cntlr_ADDR(5),
      addra(25) => microblaze_0_dlmb_cntlr_ADDR(6),
      addra(24) => microblaze_0_dlmb_cntlr_ADDR(7),
      addra(23) => microblaze_0_dlmb_cntlr_ADDR(8),
      addra(22) => microblaze_0_dlmb_cntlr_ADDR(9),
      addra(21) => microblaze_0_dlmb_cntlr_ADDR(10),
      addra(20) => microblaze_0_dlmb_cntlr_ADDR(11),
      addra(19) => microblaze_0_dlmb_cntlr_ADDR(12),
      addra(18) => microblaze_0_dlmb_cntlr_ADDR(13),
      addra(17) => microblaze_0_dlmb_cntlr_ADDR(14),
      addra(16) => microblaze_0_dlmb_cntlr_ADDR(15),
      addra(15) => microblaze_0_dlmb_cntlr_ADDR(16),
      addra(14) => microblaze_0_dlmb_cntlr_ADDR(17),
      addra(13) => microblaze_0_dlmb_cntlr_ADDR(18),
      addra(12) => microblaze_0_dlmb_cntlr_ADDR(19),
      addra(11) => microblaze_0_dlmb_cntlr_ADDR(20),
      addra(10) => microblaze_0_dlmb_cntlr_ADDR(21),
      addra(9) => microblaze_0_dlmb_cntlr_ADDR(22),
      addra(8) => microblaze_0_dlmb_cntlr_ADDR(23),
      addra(7) => microblaze_0_dlmb_cntlr_ADDR(24),
      addra(6) => microblaze_0_dlmb_cntlr_ADDR(25),
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
      dinb(20) => microblaze_0_ilmb_cntlr_DIN(11),
      dinb(19) => microblaze_0_ilmb_cntlr_DIN(12),
      dinb(18) => microblaze_0_ilmb_cntlr_DIN(13),
      dinb(17) => microblaze_0_ilmb_cntlr_DIN(14),
      dinb(16) => microblaze_0_ilmb_cntlr_DIN(15),
      dinb(15) => microblaze_0_ilmb_cntlr_DIN(16),
      dinb(14) => microblaze_0_ilmb_cntlr_DIN(17),
      dinb(13) => microblaze_0_ilmb_cntlr_DIN(18),
      dinb(12) => microblaze_0_ilmb_cntlr_DIN(19),
      dinb(11) => microblaze_0_ilmb_cntlr_DIN(20),
      dinb(10) => microblaze_0_ilmb_cntlr_DIN(21),
      dinb(9) => microblaze_0_ilmb_cntlr_DIN(22),
      dinb(8) => microblaze_0_ilmb_cntlr_DIN(23),
      dinb(7) => microblaze_0_ilmb_cntlr_DIN(24),
      dinb(6) => microblaze_0_ilmb_cntlr_DIN(25),
      dinb(5) => microblaze_0_ilmb_cntlr_DIN(26),
      dinb(4) => microblaze_0_ilmb_cntlr_DIN(27),
      dinb(3) => microblaze_0_ilmb_cntlr_DIN(28),
      dinb(2) => microblaze_0_ilmb_cntlr_DIN(29),
      dinb(1) => microblaze_0_ilmb_cntlr_DIN(30),
      dinb(0) => microblaze_0_ilmb_cntlr_DIN(31),
      douta(31 downto 0) => microblaze_0_dlmb_cntlr_DOUT(31 downto 0),
      doutb(31 downto 0) => microblaze_0_ilmb_cntlr_DOUT(31 downto 0),
      ena => microblaze_0_dlmb_cntlr_EN,
      enb => microblaze_0_ilmb_cntlr_EN,
      rsta => microblaze_0_dlmb_cntlr_RST,
      rsta_busy => NLW_lmb_bram_rsta_busy_UNCONNECTED,
      rstb => microblaze_0_ilmb_cntlr_RST,
      rstb_busy => NLW_lmb_bram_rstb_busy_UNCONNECTED,
      wea(3) => microblaze_0_dlmb_cntlr_WE(0),
      wea(2) => microblaze_0_dlmb_cntlr_WE(1),
      wea(1) => microblaze_0_dlmb_cntlr_WE(2),
      wea(0) => microblaze_0_dlmb_cntlr_WE(3),
      web(3) => microblaze_0_ilmb_cntlr_WE(0),
      web(2) => microblaze_0_ilmb_cntlr_WE(1),
      web(1) => microblaze_0_ilmb_cntlr_WE(2),
      web(0) => microblaze_0_ilmb_cntlr_WE(3)
    );
end STRUCTURE;
library IEEE;
use IEEE.STD_LOGIC_1164.ALL;
library UNISIM;
use UNISIM.VCOMPONENTS.ALL;
entity s00_couplers_imp_EJVIE3 is
  port (
    M_ACLK : in STD_LOGIC;
    M_ARESETN : in STD_LOGIC;
    M_AXI_araddr : out STD_LOGIC_VECTOR ( 31 downto 0 );
    M_AXI_arprot : out STD_LOGIC_VECTOR ( 2 downto 0 );
    M_AXI_arready : in STD_LOGIC_VECTOR ( 0 to 0 );
    M_AXI_arvalid : out STD_LOGIC_VECTOR ( 0 to 0 );
    M_AXI_awaddr : out STD_LOGIC_VECTOR ( 31 downto 0 );
    M_AXI_awprot : out STD_LOGIC_VECTOR ( 2 downto 0 );
    M_AXI_awready : in STD_LOGIC_VECTOR ( 0 to 0 );
    M_AXI_awvalid : out STD_LOGIC_VECTOR ( 0 to 0 );
    M_AXI_bready : out STD_LOGIC_VECTOR ( 0 to 0 );
    M_AXI_bresp : in STD_LOGIC_VECTOR ( 1 downto 0 );
    M_AXI_bvalid : in STD_LOGIC_VECTOR ( 0 to 0 );
    M_AXI_rdata : in STD_LOGIC_VECTOR ( 31 downto 0 );
    M_AXI_rready : out STD_LOGIC_VECTOR ( 0 to 0 );
    M_AXI_rresp : in STD_LOGIC_VECTOR ( 1 downto 0 );
    M_AXI_rvalid : in STD_LOGIC_VECTOR ( 0 to 0 );
    M_AXI_wdata : out STD_LOGIC_VECTOR ( 31 downto 0 );
    M_AXI_wready : in STD_LOGIC_VECTOR ( 0 to 0 );
    M_AXI_wstrb : out STD_LOGIC_VECTOR ( 3 downto 0 );
    M_AXI_wvalid : out STD_LOGIC_VECTOR ( 0 to 0 );
    S_ACLK : in STD_LOGIC;
    S_ARESETN : in STD_LOGIC;
    S_AXI_araddr : in STD_LOGIC_VECTOR ( 31 downto 0 );
    S_AXI_arprot : in STD_LOGIC_VECTOR ( 2 downto 0 );
    S_AXI_arready : out STD_LOGIC_VECTOR ( 0 to 0 );
    S_AXI_arvalid : in STD_LOGIC_VECTOR ( 0 to 0 );
    S_AXI_awaddr : in STD_LOGIC_VECTOR ( 31 downto 0 );
    S_AXI_awprot : in STD_LOGIC_VECTOR ( 2 downto 0 );
    S_AXI_awready : out STD_LOGIC_VECTOR ( 0 to 0 );
    S_AXI_awvalid : in STD_LOGIC_VECTOR ( 0 to 0 );
    S_AXI_bready : in STD_LOGIC_VECTOR ( 0 to 0 );
    S_AXI_bresp : out STD_LOGIC_VECTOR ( 1 downto 0 );
    S_AXI_bvalid : out STD_LOGIC_VECTOR ( 0 to 0 );
    S_AXI_rdata : out STD_LOGIC_VECTOR ( 31 downto 0 );
    S_AXI_rready : in STD_LOGIC_VECTOR ( 0 to 0 );
    S_AXI_rresp : out STD_LOGIC_VECTOR ( 1 downto 0 );
    S_AXI_rvalid : out STD_LOGIC_VECTOR ( 0 to 0 );
    S_AXI_wdata : in STD_LOGIC_VECTOR ( 31 downto 0 );
    S_AXI_wready : out STD_LOGIC_VECTOR ( 0 to 0 );
    S_AXI_wstrb : in STD_LOGIC_VECTOR ( 3 downto 0 );
    S_AXI_wvalid : in STD_LOGIC_VECTOR ( 0 to 0 )
  );
end s00_couplers_imp_EJVIE3;

architecture STRUCTURE of s00_couplers_imp_EJVIE3 is
  signal s00_couplers_to_s00_couplers_ARADDR : STD_LOGIC_VECTOR ( 31 downto 0 );
  signal s00_couplers_to_s00_couplers_ARPROT : STD_LOGIC_VECTOR ( 2 downto 0 );
  signal s00_couplers_to_s00_couplers_ARREADY : STD_LOGIC_VECTOR ( 0 to 0 );
  signal s00_couplers_to_s00_couplers_ARVALID : STD_LOGIC_VECTOR ( 0 to 0 );
  signal s00_couplers_to_s00_couplers_AWADDR : STD_LOGIC_VECTOR ( 31 downto 0 );
  signal s00_couplers_to_s00_couplers_AWPROT : STD_LOGIC_VECTOR ( 2 downto 0 );
  signal s00_couplers_to_s00_couplers_AWREADY : STD_LOGIC_VECTOR ( 0 to 0 );
  signal s00_couplers_to_s00_couplers_AWVALID : STD_LOGIC_VECTOR ( 0 to 0 );
  signal s00_couplers_to_s00_couplers_BREADY : STD_LOGIC_VECTOR ( 0 to 0 );
  signal s00_couplers_to_s00_couplers_BRESP : STD_LOGIC_VECTOR ( 1 downto 0 );
  signal s00_couplers_to_s00_couplers_BVALID : STD_LOGIC_VECTOR ( 0 to 0 );
  signal s00_couplers_to_s00_couplers_RDATA : STD_LOGIC_VECTOR ( 31 downto 0 );
  signal s00_couplers_to_s00_couplers_RREADY : STD_LOGIC_VECTOR ( 0 to 0 );
  signal s00_couplers_to_s00_couplers_RRESP : STD_LOGIC_VECTOR ( 1 downto 0 );
  signal s00_couplers_to_s00_couplers_RVALID : STD_LOGIC_VECTOR ( 0 to 0 );
  signal s00_couplers_to_s00_couplers_WDATA : STD_LOGIC_VECTOR ( 31 downto 0 );
  signal s00_couplers_to_s00_couplers_WREADY : STD_LOGIC_VECTOR ( 0 to 0 );
  signal s00_couplers_to_s00_couplers_WSTRB : STD_LOGIC_VECTOR ( 3 downto 0 );
  signal s00_couplers_to_s00_couplers_WVALID : STD_LOGIC_VECTOR ( 0 to 0 );
begin
  M_AXI_araddr(31 downto 0) <= s00_couplers_to_s00_couplers_ARADDR(31 downto 0);
  M_AXI_arprot(2 downto 0) <= s00_couplers_to_s00_couplers_ARPROT(2 downto 0);
  M_AXI_arvalid(0) <= s00_couplers_to_s00_couplers_ARVALID(0);
  M_AXI_awaddr(31 downto 0) <= s00_couplers_to_s00_couplers_AWADDR(31 downto 0);
  M_AXI_awprot(2 downto 0) <= s00_couplers_to_s00_couplers_AWPROT(2 downto 0);
  M_AXI_awvalid(0) <= s00_couplers_to_s00_couplers_AWVALID(0);
  M_AXI_bready(0) <= s00_couplers_to_s00_couplers_BREADY(0);
  M_AXI_rready(0) <= s00_couplers_to_s00_couplers_RREADY(0);
  M_AXI_wdata(31 downto 0) <= s00_couplers_to_s00_couplers_WDATA(31 downto 0);
  M_AXI_wstrb(3 downto 0) <= s00_couplers_to_s00_couplers_WSTRB(3 downto 0);
  M_AXI_wvalid(0) <= s00_couplers_to_s00_couplers_WVALID(0);
  S_AXI_arready(0) <= s00_couplers_to_s00_couplers_ARREADY(0);
  S_AXI_awready(0) <= s00_couplers_to_s00_couplers_AWREADY(0);
  S_AXI_bresp(1 downto 0) <= s00_couplers_to_s00_couplers_BRESP(1 downto 0);
  S_AXI_bvalid(0) <= s00_couplers_to_s00_couplers_BVALID(0);
  S_AXI_rdata(31 downto 0) <= s00_couplers_to_s00_couplers_RDATA(31 downto 0);
  S_AXI_rresp(1 downto 0) <= s00_couplers_to_s00_couplers_RRESP(1 downto 0);
  S_AXI_rvalid(0) <= s00_couplers_to_s00_couplers_RVALID(0);
  S_AXI_wready(0) <= s00_couplers_to_s00_couplers_WREADY(0);
  s00_couplers_to_s00_couplers_ARADDR(31 downto 0) <= S_AXI_araddr(31 downto 0);
  s00_couplers_to_s00_couplers_ARPROT(2 downto 0) <= S_AXI_arprot(2 downto 0);
  s00_couplers_to_s00_couplers_ARREADY(0) <= M_AXI_arready(0);
  s00_couplers_to_s00_couplers_ARVALID(0) <= S_AXI_arvalid(0);
  s00_couplers_to_s00_couplers_AWADDR(31 downto 0) <= S_AXI_awaddr(31 downto 0);
  s00_couplers_to_s00_couplers_AWPROT(2 downto 0) <= S_AXI_awprot(2 downto 0);
  s00_couplers_to_s00_couplers_AWREADY(0) <= M_AXI_awready(0);
  s00_couplers_to_s00_couplers_AWVALID(0) <= S_AXI_awvalid(0);
  s00_couplers_to_s00_couplers_BREADY(0) <= S_AXI_bready(0);
  s00_couplers_to_s00_couplers_BRESP(1 downto 0) <= M_AXI_bresp(1 downto 0);
  s00_couplers_to_s00_couplers_BVALID(0) <= M_AXI_bvalid(0);
  s00_couplers_to_s00_couplers_RDATA(31 downto 0) <= M_AXI_rdata(31 downto 0);
  s00_couplers_to_s00_couplers_RREADY(0) <= S_AXI_rready(0);
  s00_couplers_to_s00_couplers_RRESP(1 downto 0) <= M_AXI_rresp(1 downto 0);
  s00_couplers_to_s00_couplers_RVALID(0) <= M_AXI_rvalid(0);
  s00_couplers_to_s00_couplers_WDATA(31 downto 0) <= S_AXI_wdata(31 downto 0);
  s00_couplers_to_s00_couplers_WREADY(0) <= M_AXI_wready(0);
  s00_couplers_to_s00_couplers_WSTRB(3 downto 0) <= S_AXI_wstrb(3 downto 0);
  s00_couplers_to_s00_couplers_WVALID(0) <= S_AXI_wvalid(0);
end STRUCTURE;
library IEEE;
use IEEE.STD_LOGIC_1164.ALL;
library UNISIM;
use UNISIM.VCOMPONENTS.ALL;
entity skrach_design_microblaze_0_axi_periph_3 is
  port (
    ACLK : in STD_LOGIC;
    ARESETN : in STD_LOGIC;
    M00_ACLK : in STD_LOGIC;
    M00_ARESETN : in STD_LOGIC;
    M00_AXI_araddr : out STD_LOGIC_VECTOR ( 31 downto 0 );
    M00_AXI_arready : in STD_LOGIC_VECTOR ( 0 to 0 );
    M00_AXI_arvalid : out STD_LOGIC_VECTOR ( 0 to 0 );
    M00_AXI_awaddr : out STD_LOGIC_VECTOR ( 31 downto 0 );
    M00_AXI_awready : in STD_LOGIC_VECTOR ( 0 to 0 );
    M00_AXI_awvalid : out STD_LOGIC_VECTOR ( 0 to 0 );
    M00_AXI_bready : out STD_LOGIC_VECTOR ( 0 to 0 );
    M00_AXI_bresp : in STD_LOGIC_VECTOR ( 1 downto 0 );
    M00_AXI_bvalid : in STD_LOGIC_VECTOR ( 0 to 0 );
    M00_AXI_rdata : in STD_LOGIC_VECTOR ( 31 downto 0 );
    M00_AXI_rready : out STD_LOGIC_VECTOR ( 0 to 0 );
    M00_AXI_rresp : in STD_LOGIC_VECTOR ( 1 downto 0 );
    M00_AXI_rvalid : in STD_LOGIC_VECTOR ( 0 to 0 );
    M00_AXI_wdata : out STD_LOGIC_VECTOR ( 31 downto 0 );
    M00_AXI_wready : in STD_LOGIC_VECTOR ( 0 to 0 );
    M00_AXI_wstrb : out STD_LOGIC_VECTOR ( 3 downto 0 );
    M00_AXI_wvalid : out STD_LOGIC_VECTOR ( 0 to 0 );
    M01_ACLK : in STD_LOGIC;
    M01_ARESETN : in STD_LOGIC;
    M01_AXI_araddr : out STD_LOGIC_VECTOR ( 31 downto 0 );
    M01_AXI_arready : in STD_LOGIC_VECTOR ( 0 to 0 );
    M01_AXI_arvalid : out STD_LOGIC_VECTOR ( 0 to 0 );
    M01_AXI_awaddr : out STD_LOGIC_VECTOR ( 31 downto 0 );
    M01_AXI_awready : in STD_LOGIC_VECTOR ( 0 to 0 );
    M01_AXI_awvalid : out STD_LOGIC_VECTOR ( 0 to 0 );
    M01_AXI_bready : out STD_LOGIC_VECTOR ( 0 to 0 );
    M01_AXI_bresp : in STD_LOGIC_VECTOR ( 1 downto 0 );
    M01_AXI_bvalid : in STD_LOGIC_VECTOR ( 0 to 0 );
    M01_AXI_rdata : in STD_LOGIC_VECTOR ( 31 downto 0 );
    M01_AXI_rready : out STD_LOGIC_VECTOR ( 0 to 0 );
    M01_AXI_rresp : in STD_LOGIC_VECTOR ( 1 downto 0 );
    M01_AXI_rvalid : in STD_LOGIC_VECTOR ( 0 to 0 );
    M01_AXI_wdata : out STD_LOGIC_VECTOR ( 31 downto 0 );
    M01_AXI_wready : in STD_LOGIC_VECTOR ( 0 to 0 );
    M01_AXI_wstrb : out STD_LOGIC_VECTOR ( 3 downto 0 );
    M01_AXI_wvalid : out STD_LOGIC_VECTOR ( 0 to 0 );
    M02_ACLK : in STD_LOGIC;
    M02_ARESETN : in STD_LOGIC;
    M02_AXI_araddr : out STD_LOGIC_VECTOR ( 31 downto 0 );
    M02_AXI_arprot : out STD_LOGIC_VECTOR ( 2 downto 0 );
    M02_AXI_arready : in STD_LOGIC;
    M02_AXI_arvalid : out STD_LOGIC;
    M02_AXI_awaddr : out STD_LOGIC_VECTOR ( 31 downto 0 );
    M02_AXI_awprot : out STD_LOGIC_VECTOR ( 2 downto 0 );
    M02_AXI_awready : in STD_LOGIC;
    M02_AXI_awvalid : out STD_LOGIC;
    M02_AXI_bready : out STD_LOGIC;
    M02_AXI_bresp : in STD_LOGIC_VECTOR ( 1 downto 0 );
    M02_AXI_bvalid : in STD_LOGIC;
    M02_AXI_rdata : in STD_LOGIC_VECTOR ( 31 downto 0 );
    M02_AXI_rready : out STD_LOGIC;
    M02_AXI_rresp : in STD_LOGIC_VECTOR ( 1 downto 0 );
    M02_AXI_rvalid : in STD_LOGIC;
    M02_AXI_wdata : out STD_LOGIC_VECTOR ( 31 downto 0 );
    M02_AXI_wready : in STD_LOGIC;
    M02_AXI_wstrb : out STD_LOGIC_VECTOR ( 3 downto 0 );
    M02_AXI_wvalid : out STD_LOGIC;
    S00_ACLK : in STD_LOGIC;
    S00_ARESETN : in STD_LOGIC;
    S00_AXI_araddr : in STD_LOGIC_VECTOR ( 31 downto 0 );
    S00_AXI_arprot : in STD_LOGIC_VECTOR ( 2 downto 0 );
    S00_AXI_arready : out STD_LOGIC_VECTOR ( 0 to 0 );
    S00_AXI_arvalid : in STD_LOGIC_VECTOR ( 0 to 0 );
    S00_AXI_awaddr : in STD_LOGIC_VECTOR ( 31 downto 0 );
    S00_AXI_awprot : in STD_LOGIC_VECTOR ( 2 downto 0 );
    S00_AXI_awready : out STD_LOGIC_VECTOR ( 0 to 0 );
    S00_AXI_awvalid : in STD_LOGIC_VECTOR ( 0 to 0 );
    S00_AXI_bready : in STD_LOGIC_VECTOR ( 0 to 0 );
    S00_AXI_bresp : out STD_LOGIC_VECTOR ( 1 downto 0 );
    S00_AXI_bvalid : out STD_LOGIC_VECTOR ( 0 to 0 );
    S00_AXI_rdata : out STD_LOGIC_VECTOR ( 31 downto 0 );
    S00_AXI_rready : in STD_LOGIC_VECTOR ( 0 to 0 );
    S00_AXI_rresp : out STD_LOGIC_VECTOR ( 1 downto 0 );
    S00_AXI_rvalid : out STD_LOGIC_VECTOR ( 0 to 0 );
    S00_AXI_wdata : in STD_LOGIC_VECTOR ( 31 downto 0 );
    S00_AXI_wready : out STD_LOGIC_VECTOR ( 0 to 0 );
    S00_AXI_wstrb : in STD_LOGIC_VECTOR ( 3 downto 0 );
    S00_AXI_wvalid : in STD_LOGIC_VECTOR ( 0 to 0 )
  );
end skrach_design_microblaze_0_axi_periph_3;

architecture STRUCTURE of skrach_design_microblaze_0_axi_periph_3 is
  component skrach_design_xbar_3 is
  port (
    aclk : in STD_LOGIC;
    aresetn : in STD_LOGIC;
    s_axi_awaddr : in STD_LOGIC_VECTOR ( 31 downto 0 );
    s_axi_awprot : in STD_LOGIC_VECTOR ( 2 downto 0 );
    s_axi_awvalid : in STD_LOGIC_VECTOR ( 0 to 0 );
    s_axi_awready : out STD_LOGIC_VECTOR ( 0 to 0 );
    s_axi_wdata : in STD_LOGIC_VECTOR ( 31 downto 0 );
    s_axi_wstrb : in STD_LOGIC_VECTOR ( 3 downto 0 );
    s_axi_wvalid : in STD_LOGIC_VECTOR ( 0 to 0 );
    s_axi_wready : out STD_LOGIC_VECTOR ( 0 to 0 );
    s_axi_bresp : out STD_LOGIC_VECTOR ( 1 downto 0 );
    s_axi_bvalid : out STD_LOGIC_VECTOR ( 0 to 0 );
    s_axi_bready : in STD_LOGIC_VECTOR ( 0 to 0 );
    s_axi_araddr : in STD_LOGIC_VECTOR ( 31 downto 0 );
    s_axi_arprot : in STD_LOGIC_VECTOR ( 2 downto 0 );
    s_axi_arvalid : in STD_LOGIC_VECTOR ( 0 to 0 );
    s_axi_arready : out STD_LOGIC_VECTOR ( 0 to 0 );
    s_axi_rdata : out STD_LOGIC_VECTOR ( 31 downto 0 );
    s_axi_rresp : out STD_LOGIC_VECTOR ( 1 downto 0 );
    s_axi_rvalid : out STD_LOGIC_VECTOR ( 0 to 0 );
    s_axi_rready : in STD_LOGIC_VECTOR ( 0 to 0 );
    m_axi_awaddr : out STD_LOGIC_VECTOR ( 95 downto 0 );
    m_axi_awprot : out STD_LOGIC_VECTOR ( 8 downto 0 );
    m_axi_awvalid : out STD_LOGIC_VECTOR ( 2 downto 0 );
    m_axi_awready : in STD_LOGIC_VECTOR ( 2 downto 0 );
    m_axi_wdata : out STD_LOGIC_VECTOR ( 95 downto 0 );
    m_axi_wstrb : out STD_LOGIC_VECTOR ( 11 downto 0 );
    m_axi_wvalid : out STD_LOGIC_VECTOR ( 2 downto 0 );
    m_axi_wready : in STD_LOGIC_VECTOR ( 2 downto 0 );
    m_axi_bresp : in STD_LOGIC_VECTOR ( 5 downto 0 );
    m_axi_bvalid : in STD_LOGIC_VECTOR ( 2 downto 0 );
    m_axi_bready : out STD_LOGIC_VECTOR ( 2 downto 0 );
    m_axi_araddr : out STD_LOGIC_VECTOR ( 95 downto 0 );
    m_axi_arprot : out STD_LOGIC_VECTOR ( 8 downto 0 );
    m_axi_arvalid : out STD_LOGIC_VECTOR ( 2 downto 0 );
    m_axi_arready : in STD_LOGIC_VECTOR ( 2 downto 0 );
    m_axi_rdata : in STD_LOGIC_VECTOR ( 95 downto 0 );
    m_axi_rresp : in STD_LOGIC_VECTOR ( 5 downto 0 );
    m_axi_rvalid : in STD_LOGIC_VECTOR ( 2 downto 0 );
    m_axi_rready : out STD_LOGIC_VECTOR ( 2 downto 0 )
  );
  end component skrach_design_xbar_3;
  signal m00_couplers_to_microblaze_0_axi_periph_ARADDR : STD_LOGIC_VECTOR ( 31 downto 0 );
  signal m00_couplers_to_microblaze_0_axi_periph_ARREADY : STD_LOGIC_VECTOR ( 0 to 0 );
  signal m00_couplers_to_microblaze_0_axi_periph_ARVALID : STD_LOGIC_VECTOR ( 0 to 0 );
  signal m00_couplers_to_microblaze_0_axi_periph_AWADDR : STD_LOGIC_VECTOR ( 31 downto 0 );
  signal m00_couplers_to_microblaze_0_axi_periph_AWREADY : STD_LOGIC_VECTOR ( 0 to 0 );
  signal m00_couplers_to_microblaze_0_axi_periph_AWVALID : STD_LOGIC_VECTOR ( 0 to 0 );
  signal m00_couplers_to_microblaze_0_axi_periph_BREADY : STD_LOGIC_VECTOR ( 0 to 0 );
  signal m00_couplers_to_microblaze_0_axi_periph_BRESP : STD_LOGIC_VECTOR ( 1 downto 0 );
  signal m00_couplers_to_microblaze_0_axi_periph_BVALID : STD_LOGIC_VECTOR ( 0 to 0 );
  signal m00_couplers_to_microblaze_0_axi_periph_RDATA : STD_LOGIC_VECTOR ( 31 downto 0 );
  signal m00_couplers_to_microblaze_0_axi_periph_RREADY : STD_LOGIC_VECTOR ( 0 to 0 );
  signal m00_couplers_to_microblaze_0_axi_periph_RRESP : STD_LOGIC_VECTOR ( 1 downto 0 );
  signal m00_couplers_to_microblaze_0_axi_periph_RVALID : STD_LOGIC_VECTOR ( 0 to 0 );
  signal m00_couplers_to_microblaze_0_axi_periph_WDATA : STD_LOGIC_VECTOR ( 31 downto 0 );
  signal m00_couplers_to_microblaze_0_axi_periph_WREADY : STD_LOGIC_VECTOR ( 0 to 0 );
  signal m00_couplers_to_microblaze_0_axi_periph_WSTRB : STD_LOGIC_VECTOR ( 3 downto 0 );
  signal m00_couplers_to_microblaze_0_axi_periph_WVALID : STD_LOGIC_VECTOR ( 0 to 0 );
  signal m01_couplers_to_microblaze_0_axi_periph_ARADDR : STD_LOGIC_VECTOR ( 31 downto 0 );
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
  signal xbar_to_m00_couplers_WVALID : STD_LOGIC_VECTOR ( 0 to 0 );
  signal xbar_to_m01_couplers_ARADDR : STD_LOGIC_VECTOR ( 63 downto 32 );
  signal xbar_to_m01_couplers_ARREADY : STD_LOGIC_VECTOR ( 0 to 0 );
  signal xbar_to_m01_couplers_ARVALID : STD_LOGIC_VECTOR ( 1 to 1 );
  signal xbar_to_m01_couplers_AWADDR : STD_LOGIC_VECTOR ( 63 downto 32 );
  signal xbar_to_m01_couplers_AWREADY : STD_LOGIC_VECTOR ( 0 to 0 );
  signal xbar_to_m01_couplers_AWVALID : STD_LOGIC_VECTOR ( 1 to 1 );
  signal xbar_to_m01_couplers_BREADY : STD_LOGIC_VECTOR ( 1 to 1 );
  signal xbar_to_m01_couplers_BRESP : STD_LOGIC_VECTOR ( 1 downto 0 );
  signal xbar_to_m01_couplers_BVALID : STD_LOGIC_VECTOR ( 0 to 0 );
  signal xbar_to_m01_couplers_RDATA : STD_LOGIC_VECTOR ( 31 downto 0 );
  signal xbar_to_m01_couplers_RREADY : STD_LOGIC_VECTOR ( 1 to 1 );
  signal xbar_to_m01_couplers_RRESP : STD_LOGIC_VECTOR ( 1 downto 0 );
  signal xbar_to_m01_couplers_RVALID : STD_LOGIC_VECTOR ( 0 to 0 );
  signal xbar_to_m01_couplers_WDATA : STD_LOGIC_VECTOR ( 63 downto 32 );
  signal xbar_to_m01_couplers_WREADY : STD_LOGIC_VECTOR ( 0 to 0 );
  signal xbar_to_m01_couplers_WSTRB : STD_LOGIC_VECTOR ( 7 downto 4 );
  signal xbar_to_m01_couplers_WVALID : STD_LOGIC_VECTOR ( 1 to 1 );
  signal xbar_to_m02_couplers_ARADDR : STD_LOGIC_VECTOR ( 95 downto 64 );
  signal xbar_to_m02_couplers_ARPROT : STD_LOGIC_VECTOR ( 8 downto 6 );
  signal xbar_to_m02_couplers_ARREADY : STD_LOGIC;
  signal xbar_to_m02_couplers_ARVALID : STD_LOGIC_VECTOR ( 2 to 2 );
  signal xbar_to_m02_couplers_AWADDR : STD_LOGIC_VECTOR ( 95 downto 64 );
  signal xbar_to_m02_couplers_AWPROT : STD_LOGIC_VECTOR ( 8 downto 6 );
  signal xbar_to_m02_couplers_AWREADY : STD_LOGIC;
  signal xbar_to_m02_couplers_AWVALID : STD_LOGIC_VECTOR ( 2 to 2 );
  signal xbar_to_m02_couplers_BREADY : STD_LOGIC_VECTOR ( 2 to 2 );
  signal xbar_to_m02_couplers_BRESP : STD_LOGIC_VECTOR ( 1 downto 0 );
  signal xbar_to_m02_couplers_BVALID : STD_LOGIC;
  signal xbar_to_m02_couplers_RDATA : STD_LOGIC_VECTOR ( 31 downto 0 );
  signal xbar_to_m02_couplers_RREADY : STD_LOGIC_VECTOR ( 2 to 2 );
  signal xbar_to_m02_couplers_RRESP : STD_LOGIC_VECTOR ( 1 downto 0 );
  signal xbar_to_m02_couplers_RVALID : STD_LOGIC;
  signal xbar_to_m02_couplers_WDATA : STD_LOGIC_VECTOR ( 95 downto 64 );
  signal xbar_to_m02_couplers_WREADY : STD_LOGIC;
  signal xbar_to_m02_couplers_WSTRB : STD_LOGIC_VECTOR ( 11 downto 8 );
  signal xbar_to_m02_couplers_WVALID : STD_LOGIC_VECTOR ( 2 to 2 );
  signal NLW_xbar_m_axi_arprot_UNCONNECTED : STD_LOGIC_VECTOR ( 5 downto 0 );
  signal NLW_xbar_m_axi_awprot_UNCONNECTED : STD_LOGIC_VECTOR ( 5 downto 0 );
begin
  M00_AXI_araddr(31 downto 0) <= m00_couplers_to_microblaze_0_axi_periph_ARADDR(31 downto 0);
  M00_AXI_arvalid(0) <= m00_couplers_to_microblaze_0_axi_periph_ARVALID(0);
  M00_AXI_awaddr(31 downto 0) <= m00_couplers_to_microblaze_0_axi_periph_AWADDR(31 downto 0);
  M00_AXI_awvalid(0) <= m00_couplers_to_microblaze_0_axi_periph_AWVALID(0);
  M00_AXI_bready(0) <= m00_couplers_to_microblaze_0_axi_periph_BREADY(0);
  M00_AXI_rready(0) <= m00_couplers_to_microblaze_0_axi_periph_RREADY(0);
  M00_AXI_wdata(31 downto 0) <= m00_couplers_to_microblaze_0_axi_periph_WDATA(31 downto 0);
  M00_AXI_wstrb(3 downto 0) <= m00_couplers_to_microblaze_0_axi_periph_WSTRB(3 downto 0);
  M00_AXI_wvalid(0) <= m00_couplers_to_microblaze_0_axi_periph_WVALID(0);
  M01_AXI_araddr(31 downto 0) <= m01_couplers_to_microblaze_0_axi_periph_ARADDR(31 downto 0);
  M01_AXI_arvalid(0) <= m01_couplers_to_microblaze_0_axi_periph_ARVALID(0);
  M01_AXI_awaddr(31 downto 0) <= m01_couplers_to_microblaze_0_axi_periph_AWADDR(31 downto 0);
  M01_AXI_awvalid(0) <= m01_couplers_to_microblaze_0_axi_periph_AWVALID(0);
  M01_AXI_bready(0) <= m01_couplers_to_microblaze_0_axi_periph_BREADY(0);
  M01_AXI_rready(0) <= m01_couplers_to_microblaze_0_axi_periph_RREADY(0);
  M01_AXI_wdata(31 downto 0) <= m01_couplers_to_microblaze_0_axi_periph_WDATA(31 downto 0);
  M01_AXI_wstrb(3 downto 0) <= m01_couplers_to_microblaze_0_axi_periph_WSTRB(3 downto 0);
  M01_AXI_wvalid(0) <= m01_couplers_to_microblaze_0_axi_periph_WVALID(0);
  M02_AXI_araddr(31 downto 0) <= m02_couplers_to_microblaze_0_axi_periph_ARADDR(31 downto 0);
  M02_AXI_arprot(2 downto 0) <= m02_couplers_to_microblaze_0_axi_periph_ARPROT(2 downto 0);
  M02_AXI_arvalid <= m02_couplers_to_microblaze_0_axi_periph_ARVALID;
  M02_AXI_awaddr(31 downto 0) <= m02_couplers_to_microblaze_0_axi_periph_AWADDR(31 downto 0);
  M02_AXI_awprot(2 downto 0) <= m02_couplers_to_microblaze_0_axi_periph_AWPROT(2 downto 0);
  M02_AXI_awvalid <= m02_couplers_to_microblaze_0_axi_periph_AWVALID;
  M02_AXI_bready <= m02_couplers_to_microblaze_0_axi_periph_BREADY;
  M02_AXI_rready <= m02_couplers_to_microblaze_0_axi_periph_RREADY;
  M02_AXI_wdata(31 downto 0) <= m02_couplers_to_microblaze_0_axi_periph_WDATA(31 downto 0);
  M02_AXI_wstrb(3 downto 0) <= m02_couplers_to_microblaze_0_axi_periph_WSTRB(3 downto 0);
  M02_AXI_wvalid <= m02_couplers_to_microblaze_0_axi_periph_WVALID;
  S00_AXI_arready(0) <= microblaze_0_axi_periph_to_s00_couplers_ARREADY(0);
  S00_AXI_awready(0) <= microblaze_0_axi_periph_to_s00_couplers_AWREADY(0);
  S00_AXI_bresp(1 downto 0) <= microblaze_0_axi_periph_to_s00_couplers_BRESP(1 downto 0);
  S00_AXI_bvalid(0) <= microblaze_0_axi_periph_to_s00_couplers_BVALID(0);
  S00_AXI_rdata(31 downto 0) <= microblaze_0_axi_periph_to_s00_couplers_RDATA(31 downto 0);
  S00_AXI_rresp(1 downto 0) <= microblaze_0_axi_periph_to_s00_couplers_RRESP(1 downto 0);
  S00_AXI_rvalid(0) <= microblaze_0_axi_periph_to_s00_couplers_RVALID(0);
  S00_AXI_wready(0) <= microblaze_0_axi_periph_to_s00_couplers_WREADY(0);
  m00_couplers_to_microblaze_0_axi_periph_ARREADY(0) <= M00_AXI_arready(0);
  m00_couplers_to_microblaze_0_axi_periph_AWREADY(0) <= M00_AXI_awready(0);
  m00_couplers_to_microblaze_0_axi_periph_BRESP(1 downto 0) <= M00_AXI_bresp(1 downto 0);
  m00_couplers_to_microblaze_0_axi_periph_BVALID(0) <= M00_AXI_bvalid(0);
  m00_couplers_to_microblaze_0_axi_periph_RDATA(31 downto 0) <= M00_AXI_rdata(31 downto 0);
  m00_couplers_to_microblaze_0_axi_periph_RRESP(1 downto 0) <= M00_AXI_rresp(1 downto 0);
  m00_couplers_to_microblaze_0_axi_periph_RVALID(0) <= M00_AXI_rvalid(0);
  m00_couplers_to_microblaze_0_axi_periph_WREADY(0) <= M00_AXI_wready(0);
  m01_couplers_to_microblaze_0_axi_periph_ARREADY(0) <= M01_AXI_arready(0);
  m01_couplers_to_microblaze_0_axi_periph_AWREADY(0) <= M01_AXI_awready(0);
  m01_couplers_to_microblaze_0_axi_periph_BRESP(1 downto 0) <= M01_AXI_bresp(1 downto 0);
  m01_couplers_to_microblaze_0_axi_periph_BVALID(0) <= M01_AXI_bvalid(0);
  m01_couplers_to_microblaze_0_axi_periph_RDATA(31 downto 0) <= M01_AXI_rdata(31 downto 0);
  m01_couplers_to_microblaze_0_axi_periph_RRESP(1 downto 0) <= M01_AXI_rresp(1 downto 0);
  m01_couplers_to_microblaze_0_axi_periph_RVALID(0) <= M01_AXI_rvalid(0);
  m01_couplers_to_microblaze_0_axi_periph_WREADY(0) <= M01_AXI_wready(0);
  m02_couplers_to_microblaze_0_axi_periph_ARREADY <= M02_AXI_arready;
  m02_couplers_to_microblaze_0_axi_periph_AWREADY <= M02_AXI_awready;
  m02_couplers_to_microblaze_0_axi_periph_BRESP(1 downto 0) <= M02_AXI_bresp(1 downto 0);
  m02_couplers_to_microblaze_0_axi_periph_BVALID <= M02_AXI_bvalid;
  m02_couplers_to_microblaze_0_axi_periph_RDATA(31 downto 0) <= M02_AXI_rdata(31 downto 0);
  m02_couplers_to_microblaze_0_axi_periph_RRESP(1 downto 0) <= M02_AXI_rresp(1 downto 0);
  m02_couplers_to_microblaze_0_axi_periph_RVALID <= M02_AXI_rvalid;
  m02_couplers_to_microblaze_0_axi_periph_WREADY <= M02_AXI_wready;
  microblaze_0_axi_periph_ACLK_net <= ACLK;
  microblaze_0_axi_periph_ARESETN_net <= ARESETN;
  microblaze_0_axi_periph_to_s00_couplers_ARADDR(31 downto 0) <= S00_AXI_araddr(31 downto 0);
  microblaze_0_axi_periph_to_s00_couplers_ARPROT(2 downto 0) <= S00_AXI_arprot(2 downto 0);
  microblaze_0_axi_periph_to_s00_couplers_ARVALID(0) <= S00_AXI_arvalid(0);
  microblaze_0_axi_periph_to_s00_couplers_AWADDR(31 downto 0) <= S00_AXI_awaddr(31 downto 0);
  microblaze_0_axi_periph_to_s00_couplers_AWPROT(2 downto 0) <= S00_AXI_awprot(2 downto 0);
  microblaze_0_axi_periph_to_s00_couplers_AWVALID(0) <= S00_AXI_awvalid(0);
  microblaze_0_axi_periph_to_s00_couplers_BREADY(0) <= S00_AXI_bready(0);
  microblaze_0_axi_periph_to_s00_couplers_RREADY(0) <= S00_AXI_rready(0);
  microblaze_0_axi_periph_to_s00_couplers_WDATA(31 downto 0) <= S00_AXI_wdata(31 downto 0);
  microblaze_0_axi_periph_to_s00_couplers_WSTRB(3 downto 0) <= S00_AXI_wstrb(3 downto 0);
  microblaze_0_axi_periph_to_s00_couplers_WVALID(0) <= S00_AXI_wvalid(0);
m00_couplers: entity work.m00_couplers_imp_C4LHUS
     port map (
      M_ACLK => microblaze_0_axi_periph_ACLK_net,
      M_ARESETN => microblaze_0_axi_periph_ARESETN_net,
      M_AXI_araddr(31 downto 0) => m00_couplers_to_microblaze_0_axi_periph_ARADDR(31 downto 0),
      M_AXI_arready(0) => m00_couplers_to_microblaze_0_axi_periph_ARREADY(0),
      M_AXI_arvalid(0) => m00_couplers_to_microblaze_0_axi_periph_ARVALID(0),
      M_AXI_awaddr(31 downto 0) => m00_couplers_to_microblaze_0_axi_periph_AWADDR(31 downto 0),
      M_AXI_awready(0) => m00_couplers_to_microblaze_0_axi_periph_AWREADY(0),
      M_AXI_awvalid(0) => m00_couplers_to_microblaze_0_axi_periph_AWVALID(0),
      M_AXI_bready(0) => m00_couplers_to_microblaze_0_axi_periph_BREADY(0),
      M_AXI_bresp(1 downto 0) => m00_couplers_to_microblaze_0_axi_periph_BRESP(1 downto 0),
      M_AXI_bvalid(0) => m00_couplers_to_microblaze_0_axi_periph_BVALID(0),
      M_AXI_rdata(31 downto 0) => m00_couplers_to_microblaze_0_axi_periph_RDATA(31 downto 0),
      M_AXI_rready(0) => m00_couplers_to_microblaze_0_axi_periph_RREADY(0),
      M_AXI_rresp(1 downto 0) => m00_couplers_to_microblaze_0_axi_periph_RRESP(1 downto 0),
      M_AXI_rvalid(0) => m00_couplers_to_microblaze_0_axi_periph_RVALID(0),
      M_AXI_wdata(31 downto 0) => m00_couplers_to_microblaze_0_axi_periph_WDATA(31 downto 0),
      M_AXI_wready(0) => m00_couplers_to_microblaze_0_axi_periph_WREADY(0),
      M_AXI_wstrb(3 downto 0) => m00_couplers_to_microblaze_0_axi_periph_WSTRB(3 downto 0),
      M_AXI_wvalid(0) => m00_couplers_to_microblaze_0_axi_periph_WVALID(0),
      S_ACLK => microblaze_0_axi_periph_ACLK_net,
      S_ARESETN => microblaze_0_axi_periph_ARESETN_net,
      S_AXI_araddr(31 downto 0) => xbar_to_m00_couplers_ARADDR(31 downto 0),
      S_AXI_arready(0) => xbar_to_m00_couplers_ARREADY(0),
      S_AXI_arvalid(0) => xbar_to_m00_couplers_ARVALID(0),
      S_AXI_awaddr(31 downto 0) => xbar_to_m00_couplers_AWADDR(31 downto 0),
      S_AXI_awready(0) => xbar_to_m00_couplers_AWREADY(0),
      S_AXI_awvalid(0) => xbar_to_m00_couplers_AWVALID(0),
      S_AXI_bready(0) => xbar_to_m00_couplers_BREADY(0),
      S_AXI_bresp(1 downto 0) => xbar_to_m00_couplers_BRESP(1 downto 0),
      S_AXI_bvalid(0) => xbar_to_m00_couplers_BVALID(0),
      S_AXI_rdata(31 downto 0) => xbar_to_m00_couplers_RDATA(31 downto 0),
      S_AXI_rready(0) => xbar_to_m00_couplers_RREADY(0),
      S_AXI_rresp(1 downto 0) => xbar_to_m00_couplers_RRESP(1 downto 0),
      S_AXI_rvalid(0) => xbar_to_m00_couplers_RVALID(0),
      S_AXI_wdata(31 downto 0) => xbar_to_m00_couplers_WDATA(31 downto 0),
      S_AXI_wready(0) => xbar_to_m00_couplers_WREADY(0),
      S_AXI_wstrb(3 downto 0) => xbar_to_m00_couplers_WSTRB(3 downto 0),
      S_AXI_wvalid(0) => xbar_to_m00_couplers_WVALID(0)
    );
m01_couplers: entity work.m01_couplers_imp_1D1R90W
     port map (
      M_ACLK => microblaze_0_axi_periph_ACLK_net,
      M_ARESETN => microblaze_0_axi_periph_ARESETN_net,
      M_AXI_araddr(31 downto 0) => m01_couplers_to_microblaze_0_axi_periph_ARADDR(31 downto 0),
      M_AXI_arready(0) => m01_couplers_to_microblaze_0_axi_periph_ARREADY(0),
      M_AXI_arvalid(0) => m01_couplers_to_microblaze_0_axi_periph_ARVALID(0),
      M_AXI_awaddr(31 downto 0) => m01_couplers_to_microblaze_0_axi_periph_AWADDR(31 downto 0),
      M_AXI_awready(0) => m01_couplers_to_microblaze_0_axi_periph_AWREADY(0),
      M_AXI_awvalid(0) => m01_couplers_to_microblaze_0_axi_periph_AWVALID(0),
      M_AXI_bready(0) => m01_couplers_to_microblaze_0_axi_periph_BREADY(0),
      M_AXI_bresp(1 downto 0) => m01_couplers_to_microblaze_0_axi_periph_BRESP(1 downto 0),
      M_AXI_bvalid(0) => m01_couplers_to_microblaze_0_axi_periph_BVALID(0),
      M_AXI_rdata(31 downto 0) => m01_couplers_to_microblaze_0_axi_periph_RDATA(31 downto 0),
      M_AXI_rready(0) => m01_couplers_to_microblaze_0_axi_periph_RREADY(0),
      M_AXI_rresp(1 downto 0) => m01_couplers_to_microblaze_0_axi_periph_RRESP(1 downto 0),
      M_AXI_rvalid(0) => m01_couplers_to_microblaze_0_axi_periph_RVALID(0),
      M_AXI_wdata(31 downto 0) => m01_couplers_to_microblaze_0_axi_periph_WDATA(31 downto 0),
      M_AXI_wready(0) => m01_couplers_to_microblaze_0_axi_periph_WREADY(0),
      M_AXI_wstrb(3 downto 0) => m01_couplers_to_microblaze_0_axi_periph_WSTRB(3 downto 0),
      M_AXI_wvalid(0) => m01_couplers_to_microblaze_0_axi_periph_WVALID(0),
      S_ACLK => microblaze_0_axi_periph_ACLK_net,
      S_ARESETN => microblaze_0_axi_periph_ARESETN_net,
      S_AXI_araddr(31 downto 0) => xbar_to_m01_couplers_ARADDR(63 downto 32),
      S_AXI_arready(0) => xbar_to_m01_couplers_ARREADY(0),
      S_AXI_arvalid(0) => xbar_to_m01_couplers_ARVALID(1),
      S_AXI_awaddr(31 downto 0) => xbar_to_m01_couplers_AWADDR(63 downto 32),
      S_AXI_awready(0) => xbar_to_m01_couplers_AWREADY(0),
      S_AXI_awvalid(0) => xbar_to_m01_couplers_AWVALID(1),
      S_AXI_bready(0) => xbar_to_m01_couplers_BREADY(1),
      S_AXI_bresp(1 downto 0) => xbar_to_m01_couplers_BRESP(1 downto 0),
      S_AXI_bvalid(0) => xbar_to_m01_couplers_BVALID(0),
      S_AXI_rdata(31 downto 0) => xbar_to_m01_couplers_RDATA(31 downto 0),
      S_AXI_rready(0) => xbar_to_m01_couplers_RREADY(1),
      S_AXI_rresp(1 downto 0) => xbar_to_m01_couplers_RRESP(1 downto 0),
      S_AXI_rvalid(0) => xbar_to_m01_couplers_RVALID(0),
      S_AXI_wdata(31 downto 0) => xbar_to_m01_couplers_WDATA(63 downto 32),
      S_AXI_wready(0) => xbar_to_m01_couplers_WREADY(0),
      S_AXI_wstrb(3 downto 0) => xbar_to_m01_couplers_WSTRB(7 downto 4),
      S_AXI_wvalid(0) => xbar_to_m01_couplers_WVALID(1)
    );
m02_couplers: entity work.m02_couplers_imp_1IZ57WT
     port map (
      M_ACLK => microblaze_0_axi_periph_ACLK_net,
      M_ARESETN => microblaze_0_axi_periph_ARESETN_net,
      M_AXI_araddr(31 downto 0) => m02_couplers_to_microblaze_0_axi_periph_ARADDR(31 downto 0),
      M_AXI_arprot(2 downto 0) => m02_couplers_to_microblaze_0_axi_periph_ARPROT(2 downto 0),
      M_AXI_arready => m02_couplers_to_microblaze_0_axi_periph_ARREADY,
      M_AXI_arvalid => m02_couplers_to_microblaze_0_axi_periph_ARVALID,
      M_AXI_awaddr(31 downto 0) => m02_couplers_to_microblaze_0_axi_periph_AWADDR(31 downto 0),
      M_AXI_awprot(2 downto 0) => m02_couplers_to_microblaze_0_axi_periph_AWPROT(2 downto 0),
      M_AXI_awready => m02_couplers_to_microblaze_0_axi_periph_AWREADY,
      M_AXI_awvalid => m02_couplers_to_microblaze_0_axi_periph_AWVALID,
      M_AXI_bready => m02_couplers_to_microblaze_0_axi_periph_BREADY,
      M_AXI_bresp(1 downto 0) => m02_couplers_to_microblaze_0_axi_periph_BRESP(1 downto 0),
      M_AXI_bvalid => m02_couplers_to_microblaze_0_axi_periph_BVALID,
      M_AXI_rdata(31 downto 0) => m02_couplers_to_microblaze_0_axi_periph_RDATA(31 downto 0),
      M_AXI_rready => m02_couplers_to_microblaze_0_axi_periph_RREADY,
      M_AXI_rresp(1 downto 0) => m02_couplers_to_microblaze_0_axi_periph_RRESP(1 downto 0),
      M_AXI_rvalid => m02_couplers_to_microblaze_0_axi_periph_RVALID,
      M_AXI_wdata(31 downto 0) => m02_couplers_to_microblaze_0_axi_periph_WDATA(31 downto 0),
      M_AXI_wready => m02_couplers_to_microblaze_0_axi_periph_WREADY,
      M_AXI_wstrb(3 downto 0) => m02_couplers_to_microblaze_0_axi_periph_WSTRB(3 downto 0),
      M_AXI_wvalid => m02_couplers_to_microblaze_0_axi_periph_WVALID,
      S_ACLK => microblaze_0_axi_periph_ACLK_net,
      S_ARESETN => microblaze_0_axi_periph_ARESETN_net,
      S_AXI_araddr(31 downto 0) => xbar_to_m02_couplers_ARADDR(95 downto 64),
      S_AXI_arprot(2 downto 0) => xbar_to_m02_couplers_ARPROT(8 downto 6),
      S_AXI_arready => xbar_to_m02_couplers_ARREADY,
      S_AXI_arvalid => xbar_to_m02_couplers_ARVALID(2),
      S_AXI_awaddr(31 downto 0) => xbar_to_m02_couplers_AWADDR(95 downto 64),
      S_AXI_awprot(2 downto 0) => xbar_to_m02_couplers_AWPROT(8 downto 6),
      S_AXI_awready => xbar_to_m02_couplers_AWREADY,
      S_AXI_awvalid => xbar_to_m02_couplers_AWVALID(2),
      S_AXI_bready => xbar_to_m02_couplers_BREADY(2),
      S_AXI_bresp(1 downto 0) => xbar_to_m02_couplers_BRESP(1 downto 0),
      S_AXI_bvalid => xbar_to_m02_couplers_BVALID,
      S_AXI_rdata(31 downto 0) => xbar_to_m02_couplers_RDATA(31 downto 0),
      S_AXI_rready => xbar_to_m02_couplers_RREADY(2),
      S_AXI_rresp(1 downto 0) => xbar_to_m02_couplers_RRESP(1 downto 0),
      S_AXI_rvalid => xbar_to_m02_couplers_RVALID,
      S_AXI_wdata(31 downto 0) => xbar_to_m02_couplers_WDATA(95 downto 64),
      S_AXI_wready => xbar_to_m02_couplers_WREADY,
      S_AXI_wstrb(3 downto 0) => xbar_to_m02_couplers_WSTRB(11 downto 8),
      S_AXI_wvalid => xbar_to_m02_couplers_WVALID(2)
    );
s00_couplers: entity work.s00_couplers_imp_EJVIE3
     port map (
      M_ACLK => microblaze_0_axi_periph_ACLK_net,
      M_ARESETN => microblaze_0_axi_periph_ARESETN_net,
      M_AXI_araddr(31 downto 0) => s00_couplers_to_xbar_ARADDR(31 downto 0),
      M_AXI_arprot(2 downto 0) => s00_couplers_to_xbar_ARPROT(2 downto 0),
      M_AXI_arready(0) => s00_couplers_to_xbar_ARREADY(0),
      M_AXI_arvalid(0) => s00_couplers_to_xbar_ARVALID(0),
      M_AXI_awaddr(31 downto 0) => s00_couplers_to_xbar_AWADDR(31 downto 0),
      M_AXI_awprot(2 downto 0) => s00_couplers_to_xbar_AWPROT(2 downto 0),
      M_AXI_awready(0) => s00_couplers_to_xbar_AWREADY(0),
      M_AXI_awvalid(0) => s00_couplers_to_xbar_AWVALID(0),
      M_AXI_bready(0) => s00_couplers_to_xbar_BREADY(0),
      M_AXI_bresp(1 downto 0) => s00_couplers_to_xbar_BRESP(1 downto 0),
      M_AXI_bvalid(0) => s00_couplers_to_xbar_BVALID(0),
      M_AXI_rdata(31 downto 0) => s00_couplers_to_xbar_RDATA(31 downto 0),
      M_AXI_rready(0) => s00_couplers_to_xbar_RREADY(0),
      M_AXI_rresp(1 downto 0) => s00_couplers_to_xbar_RRESP(1 downto 0),
      M_AXI_rvalid(0) => s00_couplers_to_xbar_RVALID(0),
      M_AXI_wdata(31 downto 0) => s00_couplers_to_xbar_WDATA(31 downto 0),
      M_AXI_wready(0) => s00_couplers_to_xbar_WREADY(0),
      M_AXI_wstrb(3 downto 0) => s00_couplers_to_xbar_WSTRB(3 downto 0),
      M_AXI_wvalid(0) => s00_couplers_to_xbar_WVALID(0),
      S_ACLK => microblaze_0_axi_periph_ACLK_net,
      S_ARESETN => microblaze_0_axi_periph_ARESETN_net,
      S_AXI_araddr(31 downto 0) => microblaze_0_axi_periph_to_s00_couplers_ARADDR(31 downto 0),
      S_AXI_arprot(2 downto 0) => microblaze_0_axi_periph_to_s00_couplers_ARPROT(2 downto 0),
      S_AXI_arready(0) => microblaze_0_axi_periph_to_s00_couplers_ARREADY(0),
      S_AXI_arvalid(0) => microblaze_0_axi_periph_to_s00_couplers_ARVALID(0),
      S_AXI_awaddr(31 downto 0) => microblaze_0_axi_periph_to_s00_couplers_AWADDR(31 downto 0),
      S_AXI_awprot(2 downto 0) => microblaze_0_axi_periph_to_s00_couplers_AWPROT(2 downto 0),
      S_AXI_awready(0) => microblaze_0_axi_periph_to_s00_couplers_AWREADY(0),
      S_AXI_awvalid(0) => microblaze_0_axi_periph_to_s00_couplers_AWVALID(0),
      S_AXI_bready(0) => microblaze_0_axi_periph_to_s00_couplers_BREADY(0),
      S_AXI_bresp(1 downto 0) => microblaze_0_axi_periph_to_s00_couplers_BRESP(1 downto 0),
      S_AXI_bvalid(0) => microblaze_0_axi_periph_to_s00_couplers_BVALID(0),
      S_AXI_rdata(31 downto 0) => microblaze_0_axi_periph_to_s00_couplers_RDATA(31 downto 0),
      S_AXI_rready(0) => microblaze_0_axi_periph_to_s00_couplers_RREADY(0),
      S_AXI_rresp(1 downto 0) => microblaze_0_axi_periph_to_s00_couplers_RRESP(1 downto 0),
      S_AXI_rvalid(0) => microblaze_0_axi_periph_to_s00_couplers_RVALID(0),
      S_AXI_wdata(31 downto 0) => microblaze_0_axi_periph_to_s00_couplers_WDATA(31 downto 0),
      S_AXI_wready(0) => microblaze_0_axi_periph_to_s00_couplers_WREADY(0),
      S_AXI_wstrb(3 downto 0) => microblaze_0_axi_periph_to_s00_couplers_WSTRB(3 downto 0),
      S_AXI_wvalid(0) => microblaze_0_axi_periph_to_s00_couplers_WVALID(0)
    );
xbar: component skrach_design_xbar_3
     port map (
      aclk => microblaze_0_axi_periph_ACLK_net,
      aresetn => microblaze_0_axi_periph_ARESETN_net,
      m_axi_araddr(95 downto 64) => xbar_to_m02_couplers_ARADDR(95 downto 64),
      m_axi_araddr(63 downto 32) => xbar_to_m01_couplers_ARADDR(63 downto 32),
      m_axi_araddr(31 downto 0) => xbar_to_m00_couplers_ARADDR(31 downto 0),
      m_axi_arprot(8 downto 6) => xbar_to_m02_couplers_ARPROT(8 downto 6),
      m_axi_arprot(5 downto 0) => NLW_xbar_m_axi_arprot_UNCONNECTED(5 downto 0),
      m_axi_arready(2) => xbar_to_m02_couplers_ARREADY,
      m_axi_arready(1) => xbar_to_m01_couplers_ARREADY(0),
      m_axi_arready(0) => xbar_to_m00_couplers_ARREADY(0),
      m_axi_arvalid(2) => xbar_to_m02_couplers_ARVALID(2),
      m_axi_arvalid(1) => xbar_to_m01_couplers_ARVALID(1),
      m_axi_arvalid(0) => xbar_to_m00_couplers_ARVALID(0),
      m_axi_awaddr(95 downto 64) => xbar_to_m02_couplers_AWADDR(95 downto 64),
      m_axi_awaddr(63 downto 32) => xbar_to_m01_couplers_AWADDR(63 downto 32),
      m_axi_awaddr(31 downto 0) => xbar_to_m00_couplers_AWADDR(31 downto 0),
      m_axi_awprot(8 downto 6) => xbar_to_m02_couplers_AWPROT(8 downto 6),
      m_axi_awprot(5 downto 0) => NLW_xbar_m_axi_awprot_UNCONNECTED(5 downto 0),
      m_axi_awready(2) => xbar_to_m02_couplers_AWREADY,
      m_axi_awready(1) => xbar_to_m01_couplers_AWREADY(0),
      m_axi_awready(0) => xbar_to_m00_couplers_AWREADY(0),
      m_axi_awvalid(2) => xbar_to_m02_couplers_AWVALID(2),
      m_axi_awvalid(1) => xbar_to_m01_couplers_AWVALID(1),
      m_axi_awvalid(0) => xbar_to_m00_couplers_AWVALID(0),
      m_axi_bready(2) => xbar_to_m02_couplers_BREADY(2),
      m_axi_bready(1) => xbar_to_m01_couplers_BREADY(1),
      m_axi_bready(0) => xbar_to_m00_couplers_BREADY(0),
      m_axi_bresp(5 downto 4) => xbar_to_m02_couplers_BRESP(1 downto 0),
      m_axi_bresp(3 downto 2) => xbar_to_m01_couplers_BRESP(1 downto 0),
      m_axi_bresp(1 downto 0) => xbar_to_m00_couplers_BRESP(1 downto 0),
      m_axi_bvalid(2) => xbar_to_m02_couplers_BVALID,
      m_axi_bvalid(1) => xbar_to_m01_couplers_BVALID(0),
      m_axi_bvalid(0) => xbar_to_m00_couplers_BVALID(0),
      m_axi_rdata(95 downto 64) => xbar_to_m02_couplers_RDATA(31 downto 0),
      m_axi_rdata(63 downto 32) => xbar_to_m01_couplers_RDATA(31 downto 0),
      m_axi_rdata(31 downto 0) => xbar_to_m00_couplers_RDATA(31 downto 0),
      m_axi_rready(2) => xbar_to_m02_couplers_RREADY(2),
      m_axi_rready(1) => xbar_to_m01_couplers_RREADY(1),
      m_axi_rready(0) => xbar_to_m00_couplers_RREADY(0),
      m_axi_rresp(5 downto 4) => xbar_to_m02_couplers_RRESP(1 downto 0),
      m_axi_rresp(3 downto 2) => xbar_to_m01_couplers_RRESP(1 downto 0),
      m_axi_rresp(1 downto 0) => xbar_to_m00_couplers_RRESP(1 downto 0),
      m_axi_rvalid(2) => xbar_to_m02_couplers_RVALID,
      m_axi_rvalid(1) => xbar_to_m01_couplers_RVALID(0),
      m_axi_rvalid(0) => xbar_to_m00_couplers_RVALID(0),
      m_axi_wdata(95 downto 64) => xbar_to_m02_couplers_WDATA(95 downto 64),
      m_axi_wdata(63 downto 32) => xbar_to_m01_couplers_WDATA(63 downto 32),
      m_axi_wdata(31 downto 0) => xbar_to_m00_couplers_WDATA(31 downto 0),
      m_axi_wready(2) => xbar_to_m02_couplers_WREADY,
      m_axi_wready(1) => xbar_to_m01_couplers_WREADY(0),
      m_axi_wready(0) => xbar_to_m00_couplers_WREADY(0),
      m_axi_wstrb(11 downto 8) => xbar_to_m02_couplers_WSTRB(11 downto 8),
      m_axi_wstrb(7 downto 4) => xbar_to_m01_couplers_WSTRB(7 downto 4),
      m_axi_wstrb(3 downto 0) => xbar_to_m00_couplers_WSTRB(3 downto 0),
      m_axi_wvalid(2) => xbar_to_m02_couplers_WVALID(2),
      m_axi_wvalid(1) => xbar_to_m01_couplers_WVALID(1),
      m_axi_wvalid(0) => xbar_to_m00_couplers_WVALID(0),
      s_axi_araddr(31 downto 0) => s00_couplers_to_xbar_ARADDR(31 downto 0),
      s_axi_arprot(2 downto 0) => s00_couplers_to_xbar_ARPROT(2 downto 0),
      s_axi_arready(0) => s00_couplers_to_xbar_ARREADY(0),
      s_axi_arvalid(0) => s00_couplers_to_xbar_ARVALID(0),
      s_axi_awaddr(31 downto 0) => s00_couplers_to_xbar_AWADDR(31 downto 0),
      s_axi_awprot(2 downto 0) => s00_couplers_to_xbar_AWPROT(2 downto 0),
      s_axi_awready(0) => s00_couplers_to_xbar_AWREADY(0),
      s_axi_awvalid(0) => s00_couplers_to_xbar_AWVALID(0),
      s_axi_bready(0) => s00_couplers_to_xbar_BREADY(0),
      s_axi_bresp(1 downto 0) => s00_couplers_to_xbar_BRESP(1 downto 0),
      s_axi_bvalid(0) => s00_couplers_to_xbar_BVALID(0),
      s_axi_rdata(31 downto 0) => s00_couplers_to_xbar_RDATA(31 downto 0),
      s_axi_rready(0) => s00_couplers_to_xbar_RREADY(0),
      s_axi_rresp(1 downto 0) => s00_couplers_to_xbar_RRESP(1 downto 0),
      s_axi_rvalid(0) => s00_couplers_to_xbar_RVALID(0),
      s_axi_wdata(31 downto 0) => s00_couplers_to_xbar_WDATA(31 downto 0),
      s_axi_wready(0) => s00_couplers_to_xbar_WREADY(0),
      s_axi_wstrb(3 downto 0) => s00_couplers_to_xbar_WSTRB(3 downto 0),
      s_axi_wvalid(0) => s00_couplers_to_xbar_WVALID(0)
    );
end STRUCTURE;
library IEEE;
use IEEE.STD_LOGIC_1164.ALL;
library UNISIM;
use UNISIM.VCOMPONENTS.ALL;
entity skrach_design is
  port (
    DDR3_0_addr : out STD_LOGIC_VECTOR ( 14 downto 0 );
    DDR3_0_ba : out STD_LOGIC_VECTOR ( 2 downto 0 );
    DDR3_0_cas_n : out STD_LOGIC;
    DDR3_0_ck_n : out STD_LOGIC_VECTOR ( 0 to 0 );
    DDR3_0_ck_p : out STD_LOGIC_VECTOR ( 0 to 0 );
    DDR3_0_cke : out STD_LOGIC_VECTOR ( 0 to 0 );
    DDR3_0_dm : out STD_LOGIC_VECTOR ( 1 downto 0 );
    DDR3_0_dq : inout STD_LOGIC_VECTOR ( 15 downto 0 );
    DDR3_0_dqs_n : inout STD_LOGIC_VECTOR ( 1 downto 0 );
    DDR3_0_dqs_p : inout STD_LOGIC_VECTOR ( 1 downto 0 );
    DDR3_0_odt : out STD_LOGIC_VECTOR ( 0 to 0 );
    DDR3_0_ras_n : out STD_LOGIC;
    DDR3_0_reset_n : out STD_LOGIC;
    DDR3_0_we_n : out STD_LOGIC;
    ac_adc_sdata_0 : in STD_LOGIC;
    ac_bclk_0 : out STD_LOGIC;
    ac_dac_sdata_0 : out STD_LOGIC;
    ac_lrclk_0 : out STD_LOGIC;
    ac_mclk_0 : out STD_LOGIC;
    reset : in STD_LOGIC;
    rx_0 : in STD_LOGIC;
    scl_0 : inout STD_LOGIC;
    sda_0 : inout STD_LOGIC;
    sys_clock : in STD_LOGIC;
    usb_uart_rxd : in STD_LOGIC;
    usb_uart_txd : out STD_LOGIC
  );
  attribute CORE_GENERATION_INFO : string;
  attribute CORE_GENERATION_INFO of skrach_design : entity is "skrach_design,IP_Integrator,{x_ipVendor=xilinx.com,x_ipLibrary=BlockDiagram,x_ipName=skrach_design,x_ipVersion=1.00.a,x_ipLanguage=VHDL,numBlks=22,numReposBlks=16,numNonXlnxBlks=1,numHierBlks=6,maxHierDepth=1,numSysgenBlks=0,numHlsBlks=0,numHdlrefBlks=0,numPkgbdBlks=0,bdsource=USER,da_axi4_cnt=30,da_board_cnt=26,da_clkrst_cnt=9,da_mb_cnt=5,synth_mode=OOC_per_IP}";
  attribute HW_HANDOFF : string;
  attribute HW_HANDOFF of skrach_design : entity is "skrach_design.hwdef";
end skrach_design;
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
