docquantum/skrach-synth/code/Skrach/Skrach.srcs/sources_1/bd/skrach_design/ip/skrach_design_axi_smc_0/bd_0/synth/bd_cd63.v

//Copyright 1986-2019 Xilinx, Inc. All Rights Reserved.
//--------------------------------------------------------------------------------
//Command: generate_target bd_cd63.bd
//Design : bd_cd63
//Purpose: IP block netlist
//--------------------------------------------------------------------------------
`timescale 1 ps / 1 ps

(* CORE_GENERATION_INFO = "bd_cd63,IP_Integrator,{x_ipVendor=xilinx.com,x_ipLibrary=BlockDiagram,x_ipName=bd_cd63,x_ipVersion=1.00.a,x_ipLanguage=VERILOG,numBlks=39,numReposBlks=31,numNonXlnxBlks=0,numHierBlks=8,maxHierDepth=1,numSysgenBlks=0,numHlsBlks=0,numHdlrefBlks=0,numPkgbdBlks=0,bdsource=SBD,synth_mode=Global}" *) (* HW_HANDOFF = "skrach_design_axi_smc_0.hwdef" *) 
module bd_cd63
   (M00_AXI_araddr,
    M00_AXI_arburst,
    M00_AXI_arcache,
    M00_AXI_arlen,
    M00_AXI_arlock,
    M00_AXI_arprot,
    M00_AXI_arqos,
    M00_AXI_arready,
    M00_AXI_arsize,
    M00_AXI_arvalid,
    M00_AXI_awaddr,
    M00_AXI_awburst,
    M00_AXI_awcache,
    M00_AXI_awlen,
    M00_AXI_awlock,
    M00_AXI_awprot,
    M00_AXI_awqos,
    M00_AXI_awready,
    M00_AXI_awsize,
    M00_AXI_awvalid,
    M00_AXI_bready,
    M00_AXI_bresp,
    M00_AXI_bvalid,
    M00_AXI_rdata,
    M00_AXI_rlast,
    M00_AXI_rready,
    M00_AXI_rresp,
    M00_AXI_rvalid,
    M00_AXI_wdata,
    M00_AXI_wlast,
    M00_AXI_wready,
    M00_AXI_wstrb,
    M00_AXI_wvalid,
    S00_AXI_araddr,
    S00_AXI_arburst,
    S00_AXI_arcache,
    S00_AXI_arlen,
    S00_AXI_arlock,
    S00_AXI_arprot,
    S00_AXI_arqos,
    S00_AXI_arready,
    S00_AXI_arsize,
    S00_AXI_arvalid,
    S00_AXI_awaddr,
    S00_AXI_awburst,
    S00_AXI_awcache,
    S00_AXI_awlen,
    S00_AXI_awlock,
    S00_AXI_awprot,
    S00_AXI_awqos,
    S00_AXI_awready,
    S00_AXI_awsize,
    S00_AXI_awvalid,
    S00_AXI_bready,
    S00_AXI_bresp,
    S00_AXI_bvalid,
    S00_AXI_rdata,
    S00_AXI_rlast,
    S00_AXI_rready,
    S00_AXI_rresp,
    S00_AXI_rvalid,
    S00_AXI_wdata,
    S00_AXI_wlast,
    S00_AXI_wready,
    S00_AXI_wstrb,
    S00_AXI_wvalid,
    S01_AXI_araddr,
    S01_AXI_arburst,
    S01_AXI_arcache,
    S01_AXI_arlen,
    S01_AXI_arlock,
    S01_AXI_arprot,
    S01_AXI_arqos,
    S01_AXI_arready,
    S01_AXI_arsize,
    S01_AXI_arvalid,
    S01_AXI_rdata,
    S01_AXI_rlast,
    S01_AXI_rready,
    S01_AXI_rresp,
    S01_AXI_rvalid,
    aclk,
    aclk1,
    aresetn);
  (* X_INTERFACE_INFO = "xilinx.com:interface:aximm:1.0 M00_AXI ARADDR" *) (* X_INTERFACE_PARAMETER = "XIL_INTERFACENAME M00_AXI, ADDR_WIDTH 29, ARUSER_WIDTH 0, AWUSER_WIDTH 0, BUSER_WIDTH 0, CLK_DOMAIN skrach_design_mig_7series_0_3_ui_clk, DATA_WIDTH 32, FREQ_HZ 100000000, HAS_BRESP 1, HAS_BURST 1, HAS_CACHE 1, HAS_LOCK 1, HAS_PROT 1, HAS_QOS 1, HAS_REGION 0, HAS_RRESP 1, HAS_WSTRB 1, ID_WIDTH 0, INSERT_VIP 0, MAX_BURST_LENGTH 4, NUM_READ_OUTSTANDING 2, NUM_READ_THREADS 1, NUM_WRITE_OUTSTANDING 32, NUM_WRITE_THREADS 1, PHASE 0, PROTOCOL AXI4, READ_WRITE_MODE READ_WRITE, RUSER_BITS_PER_BYTE 0, RUSER_WIDTH 0, SUPPORTS_NARROW_BURST 0, WUSER_BITS_PER_BYTE 0, WUSER_WIDTH 0" *) output [28:0]M00_AXI_araddr;
  (* X_INTERFACE_INFO = "xilinx.com:interface:aximm:1.0 M00_AXI ARBURST" *) output [1:0]M00_AXI_arburst;
  (* X_INTERFACE_INFO = "xilinx.com:interface:aximm:1.0 M00_AXI ARCACHE" *) output [3:0]M00_AXI_arcache;
  (* X_INTERFACE_INFO = "xilinx.com:interface:aximm:1.0 M00_AXI ARLEN" *) output [7:0]M00_AXI_arlen;
  (* X_INTERFACE_INFO = "xilinx.com:interface:aximm:1.0 M00_AXI ARLOCK" *) output [0:0]M00_AXI_arlock;
  (* X_INTERFACE_INFO = "xilinx.com:interface:aximm:1.0 M00_AXI ARPROT" *) output [2:0]M00_AXI_arprot;
  (* X_INTERFACE_INFO = "xilinx.com:interface:aximm:1.0 M00_AXI ARQOS" *) output [3:0]M00_AXI_arqos;
  (* X_INTERFACE_INFO = "xilinx.com:interface:aximm:1.0 M00_AXI ARREADY" *) input M00_AXI_arready;
  (* X_INTERFACE_INFO = "xilinx.com:interface:aximm:1.0 M00_AXI ARSIZE" *) output [2:0]M00_AXI_arsize;
  (* X_INTERFACE_INFO = "xilinx.com:interface:aximm:1.0 M00_AXI ARVALID" *) output M00_AXI_arvalid;
  (* X_INTERFACE_INFO = "xilinx.com:interface:aximm:1.0 M00_AXI AWADDR" *) output [28:0]M00_AXI_awaddr;
  (* X_INTERFACE_INFO = "xilinx.com:interface:aximm:1.0 M00_AXI AWBURST" *) output [1:0]M00_AXI_awburst;
  (* X_INTERFACE_INFO = "xilinx.com:interface:aximm:1.0 M00_AXI AWCACHE" *) output [3:0]M00_AXI_awcache;
  (* X_INTERFACE_INFO = "xilinx.com:interface:aximm:1.0 M00_AXI AWLEN" *) output [7:0]M00_AXI_awlen;
  (* X_INTERFACE_INFO = "xilinx.com:interface:aximm:1.0 M00_AXI AWLOCK" *) output [0:0]M00_AXI_awlock;
  (* X_INTERFACE_INFO = "xilinx.com:interface:aximm:1.0 M00_AXI AWPROT" *) output [2:0]M00_AXI_awprot;
  (* X_INTERFACE_INFO = "xilinx.com:interface:aximm:1.0 M00_AXI AWQOS" *) output [3:0]M00_AXI_awqos;
  (* X_INTERFACE_INFO = "xilinx.com:interface:aximm:1.0 M00_AXI AWREADY" *) input M00_AXI_awready;
  (* X_INTERFACE_INFO = "xilinx.com:interface:aximm:1.0 M00_AXI AWSIZE" *) output [2:0]M00_AXI_awsize;
  (* X_INTERFACE_INFO = "xilinx.com:interface:aximm:1.0 M00_AXI AWVALID" *) output M00_AXI_awvalid;
  (* X_INTERFACE_INFO = "xilinx.com:interface:aximm:1.0 M00_AXI BREADY" *) output M00_AXI_bready;
  (* X_INTERFACE_INFO = "xilinx.com:interface:aximm:1.0 M00_AXI BRESP" *) input [1:0]M00_AXI_bresp;
  (* X_INTERFACE_INFO = "xilinx.com:interface:aximm:1.0 M00_AXI BVALID" *) input M00_AXI_bvalid;
  (* X_INTERFACE_INFO = "xilinx.com:interface:aximm:1.0 M00_AXI RDATA" *) input [31:0]M00_AXI_rdata;
  (* X_INTERFACE_INFO = "xilinx.com:interface:aximm:1.0 M00_AXI RLAST" *) input M00_AXI_rlast;
  (* X_INTERFACE_INFO = "xilinx.com:interface:aximm:1.0 M00_AXI RREADY" *) output M00_AXI_rready;
  (* X_INTERFACE_INFO = "xilinx.com:interface:aximm:1.0 M00_AXI RRESP" *) input [1:0]M00_AXI_rresp;
  (* X_INTERFACE_INFO = "xilinx.com:interface:aximm:1.0 M00_AXI RVALID" *) input M00_AXI_rvalid;
  (* X_INTERFACE_INFO = "xilinx.com:interface:aximm:1.0 M00_AXI WDATA" *) output [31:0]M00_AXI_wdata;
  (* X_INTERFACE_INFO = "xilinx.com:interface:aximm:1.0 M00_AXI WLAST" *) output M00_AXI_wlast;
  (* X_INTERFACE_INFO = "xilinx.com:interface:aximm:1.0 M00_AXI WREADY" *) input M00_AXI_wready;
  (* X_INTERFACE_INFO = "xilinx.com:interface:aximm:1.0 M00_AXI WSTRB" *) output [3:0]M00_AXI_wstrb;
  (* X_INTERFACE_INFO = "xilinx.com:interface:aximm:1.0 M00_AXI WVALID" *) output M00_AXI_wvalid;
  (* X_INTERFACE_INFO = "xilinx.com:interface:aximm:1.0 S00_AXI ARADDR" *) (* X_INTERFACE_PARAMETER = "XIL_INTERFACENAME S00_AXI, ADDR_WIDTH 32, ARUSER_WIDTH 0, AWUSER_WIDTH 0, BUSER_WIDTH 0, CLK_DOMAIN /clk_wiz_0_clk_out1, DATA_WIDTH 32, FREQ_HZ 100000000, HAS_BRESP 1, HAS_BURST 1, HAS_CACHE 1, HAS_LOCK 1, HAS_PROT 1, HAS_QOS 1, HAS_REGION 0, HAS_RRESP 1, HAS_WSTRB 1, ID_WIDTH 0, INSERT_VIP 0, MAX_BURST_LENGTH 4, NUM_READ_OUTSTANDING 2, NUM_READ_THREADS 1, NUM_WRITE_OUTSTANDING 32, NUM_WRITE_THREADS 1, PHASE 0.0, PROTOCOL AXI4, READ_WRITE_MODE READ_WRITE, RUSER_BITS_PER_BYTE 0, RUSER_WIDTH 0, SUPPORTS_NARROW_BURST 0, WUSER_BITS_PER_BYTE 0, WUSER_WIDTH 0" *) input [31:0]S00_AXI_araddr;
  (* X_INTERFACE_INFO = "xilinx.com:interface:aximm:1.0 S00_AXI ARBURST" *) input [1:0]S00_AXI_arburst;
  (* X_INTERFACE_INFO = "xilinx.com:interface:aximm:1.0 S00_AXI ARCACHE" *) input [3:0]S00_AXI_arcache;
  (* X_INTERFACE_INFO = "xilinx.com:interface:aximm:1.0 S00_AXI ARLEN" *) input [7:0]S00_AXI_arlen;
  (* X_INTERFACE_INFO = "xilinx.com:interface:aximm:1.0 S00_AXI ARLOCK" *) input [0:0]S00_AXI_arlock;
  (* X_INTERFACE_INFO = "xilinx.com:interface:aximm:1.0 S00_AXI ARPROT" *) input [2:0]S00_AXI_arprot;
  (* X_INTERFACE_INFO = "xilinx.com:interface:aximm:1.0 S00_AXI ARQOS" *) input [3:0]S00_AXI_arqos;
  (* X_INTERFACE_INFO = "xilinx.com:interface:aximm:1.0 S00_AXI ARREADY" *) output S00_AXI_arready;
  (* X_INTERFACE_INFO = "xilinx.com:interface:aximm:1.0 S00_AXI ARSIZE" *) input [2:0]S00_AXI_arsize;
  (* X_INTERFACE_INFO = "xilinx.com:interface:aximm:1.0 S00_AXI ARVALID" *) input S00_AXI_arvalid;
  (* X_INTERFACE_INFO = "xilinx.com:interface:aximm:1.0 S00_AXI AWADDR" *) input [31:0]S00_AXI_awaddr;
  (* X_INTERFACE_INFO = "xilinx.com:interface:aximm:1.0 S00_AXI AWBURST" *) input [1:0]S00_AXI_awburst;
  (* X_INTERFACE_INFO = "xilinx.com:interface:aximm:1.0 S00_AXI AWCACHE" *) input [3:0]S00_AXI_awcache;
  (* X_INTERFACE_INFO = "xilinx.com:interface:aximm:1.0 S00_AXI AWLEN" *) input [7:0]S00_AXI_awlen;
  (* X_INTERFACE_INFO = "xilinx.com:interface:aximm:1.0 S00_AXI AWLOCK" *) input [0:0]S00_AXI_awlock;
  (* X_INTERFACE_INFO = "xilinx.com:interface:aximm:1.0 S00_AXI AWPROT" *) input [2:0]S00_AXI_awprot;
  (* X_INTERFACE_INFO = "xilinx.com:interface:aximm:1.0 S00_AXI AWQOS" *) input [3:0]S00_AXI_awqos;
  (* X_INTERFACE_INFO = "xilinx.com:interface:aximm:1.0 S00_AXI AWREADY" *) output S00_AXI_awready;
  (* X_INTERFACE_INFO = "xilinx.com:interface:aximm:1.0 S00_AXI AWSIZE" *) input [2:0]S00_AXI_awsize;
  (* X_INTERFACE_INFO = "xilinx.com:interface:aximm:1.0 S00_AXI AWVALID" *) input S00_AXI_awvalid;
  (* X_INTERFACE_INFO = "xilinx.com:interface:aximm:1.0 S00_AXI BREADY" *) input S00_AXI_bready;
  (* X_INTERFACE_INFO = "xilinx.com:interface:aximm:1.0 S00_AXI BRESP" *) output [1:0]S00_AXI_bresp;
  (* X_INTERFACE_INFO = "xilinx.com:interface:aximm:1.0 S00_AXI BVALID" *) output S00_AXI_bvalid;
  (* X_INTERFACE_INFO = "xilinx.com:interface:aximm:1.0 S00_AXI RDATA" *) output [31:0]S00_AXI_rdata;
  (* X_INTERFACE_INFO = "xilinx.com:interface:aximm:1.0 S00_AXI RLAST" *) output S00_AXI_rlast;
  (* X_INTERFACE_INFO = "xilinx.com:interface:aximm:1.0 S00_AXI RREADY" *) input S00_AXI_rready;
  (* X_INTERFACE_INFO = "xilinx.com:interface:aximm:1.0 S00_AXI RRESP" *) output [1:0]S00_AXI_rresp;
  (* X_INTERFACE_INFO = "xilinx.com:interface:aximm:1.0 S00_AXI RVALID" *) output S00_AXI_rvalid;
  (* X_INTERFACE_INFO = "xilinx.com:interface:aximm:1.0 S00_AXI WDATA" *) input [31:0]S00_AXI_wdata;
  (* X_INTERFACE_INFO = "xilinx.com:interface:aximm:1.0 S00_AXI WLAST" *) input S00_AXI_wlast;
  (* X_INTERFACE_INFO = "xilinx.com:interface:aximm:1.0 S00_AXI WREADY" *) output S00_AXI_wready;
  (* X_INTERFACE_INFO = "xilinx.com:interface:aximm:1.0 S00_AXI WSTRB" *) input [3:0]S00_AXI_wstrb;
  (* X_INTERFACE_INFO = "xilinx.com:interface:aximm:1.0 S00_AXI WVALID" *) input S00_AXI_wvalid;
  (* X_INTERFACE_INFO = "xilinx.com:interface:aximm:1.0 S01_AXI ARADDR" *) (* X_INTERFACE_PARAMETER = "XIL_INTERFACENAME S01_AXI, ADDR_WIDTH 32, ARUSER_WIDTH 0, AWUSER_WIDTH 0, BUSER_WIDTH 0, CLK_DOMAIN /clk_wiz_0_clk_out1, DATA_WIDTH 32, FREQ_HZ 100000000, HAS_BRESP 0, HAS_BURST 1, HAS_CACHE 1, HAS_LOCK 0, HAS_PROT 1, HAS_QOS 1, HAS_REGION 0, HAS_RRESP 1, HAS_WSTRB 0, ID_WIDTH 0, INSERT_VIP 0, MAX_BURST_LENGTH 4, NUM_READ_OUTSTANDING 2, NUM_READ_THREADS 1, NUM_WRITE_OUTSTANDING 2, NUM_WRITE_THREADS 1, PHASE 0.0, PROTOCOL AXI4, READ_WRITE_MODE READ_ONLY, RUSER_BITS_PER_BYTE 0, RUSER_WIDTH 0, SUPPORTS_NARROW_BURST 0, WUSER_BITS_PER_BYTE 0, WUSER_WIDTH 0" *) input [31:0]S01_AXI_araddr;
  (* X_INTERFACE_INFO = "xilinx.com:interface:aximm:1.0 S01_AXI ARBURST" *) input [1:0]S01_AXI_arburst;
  (* X_INTERFACE_INFO = "xilinx.com:interface:aximm:1.0 S01_AXI ARCACHE" *) input [3:0]S01_AXI_arcache;
  (* X_INTERFACE_INFO = "xilinx.com:interface:aximm:1.0 S01_AXI ARLEN" *) input [7:0]S01_AXI_arlen;
  (* X_INTERFACE_INFO = "xilinx.com:interface:aximm:1.0 S01_AXI ARLOCK" *) input [0:0]S01_AXI_arlock;
  (* X_INTERFACE_INFO = "xilinx.com:interface:aximm:1.0 S01_AXI ARPROT" *) input [2:0]S01_AXI_arprot;
  (* X_INTERFACE_INFO = "xilinx.com:interface:aximm:1.0 S01_AXI ARQOS" *) input [3:0]S01_AXI_arqos;
  (* X_INTERFACE_INFO = "xilinx.com:interface:aximm:1.0 S01_AXI ARREADY" *) output S01_AXI_arready;
  (* X_INTERFACE_INFO = "xilinx.com:interface:aximm:1.0 S01_AXI ARSIZE" *) input [2:0]S01_AXI_arsize;
  (* X_INTERFACE_INFO = "xilinx.com:interface:aximm:1.0 S01_AXI ARVALID" *) input S01_AXI_arvalid;
  (* X_INTERFACE_INFO = "xilinx.com:interface:aximm:1.0 S01_AXI RDATA" *) output [31:0]S01_AXI_rdata;
  (* X_INTERFACE_INFO = "xilinx.com:interface:aximm:1.0 S01_AXI RLAST" *) output S01_AXI_rlast;
  (* X_INTERFACE_INFO = "xilinx.com:interface:aximm:1.0 S01_AXI RREADY" *) input S01_AXI_rready;
  (* X_INTERFACE_INFO = "xilinx.com:interface:aximm:1.0 S01_AXI RRESP" *) output [1:0]S01_AXI_rresp;
  (* X_INTERFACE_INFO = "xilinx.com:interface:aximm:1.0 S01_AXI RVALID" *) output S01_AXI_rvalid;
  (* X_INTERFACE_INFO = "xilinx.com:signal:clock:1.0 CLK.ACLK CLK" *) (* X_INTERFACE_PARAMETER = "XIL_INTERFACENAME CLK.ACLK, ASSOCIATED_BUSIF S00_AXI:S01_AXI, ASSOCIATED_CLKEN m_sc_aclken, CLK_DOMAIN /clk_wiz_0_clk_out1, FREQ_HZ 100000000, INSERT_VIP 0, PHASE 0.0" *) input aclk;
  (* X_INTERFACE_INFO = "xilinx.com:signal:clock:1.0 CLK.ACLK1 CLK" *) (* X_INTERFACE_PARAMETER = "XIL_INTERFACENAME CLK.ACLK1, ASSOCIATED_BUSIF M00_AXI, ASSOCIATED_CLKEN s_sc_aclken, CLK_DOMAIN skrach_design_mig_7series_0_3_ui_clk, FREQ_HZ 100000000, INSERT_VIP 0, PHASE 0" *) input aclk1;
  (* X_INTERFACE_INFO = "xilinx.com:signal:reset:1.0 RST.ARESETN RST" *) (* X_INTERFACE_PARAMETER = "XIL_INTERFACENAME RST.ARESETN, INSERT_VIP 0, POLARITY ACTIVE_LOW" *) input aresetn;

  wire [31:0]S00_AXI_1_ARADDR;
  wire [1:0]S00_AXI_1_ARBURST;
  wire [3:0]S00_AXI_1_ARCACHE;
  wire [7:0]S00_AXI_1_ARLEN;
  wire [0:0]S00_AXI_1_ARLOCK;
  wire [2:0]S00_AXI_1_ARPROT;
  wire [3:0]S00_AXI_1_ARQOS;
  wire S00_AXI_1_ARREADY;
  wire [2:0]S00_AXI_1_ARSIZE;
  wire S00_AXI_1_ARVALID;
  wire [31:0]S00_AXI_1_AWADDR;
  wire [1:0]S00_AXI_1_AWBURST;
  wire [3:0]S00_AXI_1_AWCACHE;
  wire [7:0]S00_AXI_1_AWLEN;
  wire [0:0]S00_AXI_1_AWLOCK;
  wire [2:0]S00_AXI_1_AWPROT;
  wire [3:0]S00_AXI_1_AWQOS;
  wire S00_AXI_1_AWREADY;
  wire [2:0]S00_AXI_1_AWSIZE;
  wire S00_AXI_1_AWVALID;
  wire S00_AXI_1_BREADY;
  wire [1:0]S00_AXI_1_BRESP;
  wire S00_AXI_1_BVALID;
  wire [31:0]S00_AXI_1_RDATA;
  wire S00_AXI_1_RLAST;
  wire S00_AXI_1_RREADY;
  wire [1:0]S00_AXI_1_RRESP;
  wire S00_AXI_1_RVALID;
  wire [31:0]S00_AXI_1_WDATA;
  wire S00_AXI_1_WLAST;
  wire S00_AXI_1_WREADY;
  wire [3:0]S00_AXI_1_WSTRB;
  wire S00_AXI_1_WVALID;
  wire [31:0]S01_AXI_1_ARADDR;
  wire [1:0]S01_AXI_1_ARBURST;
  wire [3:0]S01_AXI_1_ARCACHE;
  wire [7:0]S01_AXI_1_ARLEN;
  wire [0:0]S01_AXI_1_ARLOCK;
  wire [2:0]S01_AXI_1_ARPROT;
  wire [3:0]S01_AXI_1_ARQOS;
  wire S01_AXI_1_ARREADY;
  wire [2:0]S01_AXI_1_ARSIZE;
  wire S01_AXI_1_ARVALID;
  wire [31:0]S01_AXI_1_RDATA;
  wire S01_AXI_1_RLAST;
  wire S01_AXI_1_RREADY;
  wire [1:0]S01_AXI_1_RRESP;
  wire S01_AXI_1_RVALID;
  wire [0:0]S_SC_AR_1_INFO;
  wire [137:0]S_SC_AR_1_PAYLD;
  wire [0:0]S_SC_AR_1_RECV;
  wire S_SC_AR_1_REQ;
  wire S_SC_AR_1_SEND;
  wire [0:0]S_SC_AR_2_INFO;
  wire [137:0]S_SC_AR_2_PAYLD;
  wire [0:0]S_SC_AR_2_RECV;
  wire S_SC_AR_2_REQ;
  wire S_SC_AR_2_SEND;
  wire [1:0]S_SC_AR_3_INFO;
  wire [137:0]S_SC_AR_3_PAYLD;
  wire [1:0]S_SC_AR_3_RECV;
  wire [1:0]S_SC_AR_3_REQ;
  wire [1:0]S_SC_AR_3_SEND;
  wire [0:0]S_SC_AW_1_INFO;
  wire [137:0]S_SC_AW_1_PAYLD;
  wire [0:0]S_SC_AW_1_RECV;
  wire S_SC_AW_1_REQ;
  wire S_SC_AW_1_SEND;
  wire [1:0]S_SC_AW_2_INFO;
  wire [137:0]S_SC_AW_2_PAYLD;
  wire [1:0]S_SC_AW_2_RECV;
  wire [1:0]S_SC_AW_2_REQ;
  wire [1:0]S_SC_AW_2_SEND;
  wire [0:0]S_SC_B_1_INFO;
  wire [5:0]S_SC_B_1_PAYLD;
  wire [0:0]S_SC_B_1_RECV;
  wire [0:0]S_SC_B_1_REQ;
  wire [0:0]S_SC_B_1_SEND;
  wire [0:0]S_SC_B_2_INFO;
  wire [5:0]S_SC_B_2_PAYLD;
  wire [0:0]S_SC_B_2_RECV;
  wire S_SC_B_2_REQ;
  wire S_SC_B_2_SEND;
  wire [0:0]S_SC_R_1_INFO;
  wire [51:0]S_SC_R_1_PAYLD;
  wire [0:0]S_SC_R_1_RECV;
  wire [0:0]S_SC_R_1_REQ;
  wire [0:0]S_SC_R_1_SEND;
  wire [0:0]S_SC_R_2_INFO;
  wire [51:0]S_SC_R_2_PAYLD;
  wire [0:0]S_SC_R_2_RECV;
  wire [0:0]S_SC_R_2_REQ;
  wire [0:0]S_SC_R_2_SEND;
  wire [0:0]S_SC_R_3_INFO;
  wire [51:0]S_SC_R_3_PAYLD;
  wire [0:0]S_SC_R_3_RECV;
  wire S_SC_R_3_REQ;
  wire S_SC_R_3_SEND;
  wire [0:0]S_SC_W_1_INFO;
  wire [51:0]S_SC_W_1_PAYLD;
  wire [0:0]S_SC_W_1_RECV;
  wire S_SC_W_1_REQ;
  wire S_SC_W_1_SEND;
  wire [1:0]S_SC_W_2_INFO;
  wire [51:0]S_SC_W_2_PAYLD;
  wire [1:0]S_SC_W_2_RECV;
  wire [1:0]S_SC_W_2_REQ;
  wire [1:0]S_SC_W_2_SEND;
  wire aclk1_1;
  wire aclk_1;
  wire aclk_2;
  wire aclk_net;
  wire aresetn_1;
  wire [0:0]aresetn_2;
  wire [0:0]aresetn_3;
  wire aresetn_net;
  wire clk_map_M00_ACLK;
  wire [28:0]m00_exit_pipeline_m_axi_ARADDR;
  wire [1:0]m00_exit_pipeline_m_axi_ARBURST;
  wire [3:0]m00_exit_pipeline_m_axi_ARCACHE;
  wire [7:0]m00_exit_pipeline_m_axi_ARLEN;
  wire [0:0]m00_exit_pipeline_m_axi_ARLOCK;
  wire [2:0]m00_exit_pipeline_m_axi_ARPROT;
  wire [3:0]m00_exit_pipeline_m_axi_ARQOS;
  wire m00_exit_pipeline_m_axi_ARREADY;
  wire [2:0]m00_exit_pipeline_m_axi_ARSIZE;
  wire m00_exit_pipeline_m_axi_ARVALID;
  wire [28:0]m00_exit_pipeline_m_axi_AWADDR;
  wire [1:0]m00_exit_pipeline_m_axi_AWBURST;
  wire [3:0]m00_exit_pipeline_m_axi_AWCACHE;
  wire [7:0]m00_exit_pipeline_m_axi_AWLEN;
  wire [0:0]m00_exit_pipeline_m_axi_AWLOCK;
  wire [2:0]m00_exit_pipeline_m_axi_AWPROT;
  wire [3:0]m00_exit_pipeline_m_axi_AWQOS;
  wire m00_exit_pipeline_m_axi_AWREADY;
  wire [2:0]m00_exit_pipeline_m_axi_AWSIZE;
  wire m00_exit_pipeline_m_axi_AWVALID;
  wire m00_exit_pipeline_m_axi_BREADY;
  wire [1:0]m00_exit_pipeline_m_axi_BRESP;
  wire m00_exit_pipeline_m_axi_BVALID;
  wire [31:0]m00_exit_pipeline_m_axi_RDATA;
  wire m00_exit_pipeline_m_axi_RLAST;
  wire m00_exit_pipeline_m_axi_RREADY;
  wire [1:0]m00_exit_pipeline_m_axi_RRESP;
  wire m00_exit_pipeline_m_axi_RVALID;
  wire [31:0]m00_exit_pipeline_m_axi_WDATA;
  wire m00_exit_pipeline_m_axi_WLAST;
  wire m00_exit_pipeline_m_axi_WREADY;
  wire [3:0]m00_exit_pipeline_m_axi_WSTRB;
  wire m00_exit_pipeline_m_axi_WVALID;
  wire [0:0]m00_nodes_M_SC_AR_INFO;
  wire [137:0]m00_nodes_M_SC_AR_PAYLD;
  wire m00_nodes_M_SC_AR_RECV;
  wire [0:0]m00_nodes_M_SC_AR_REQ;
  wire [0:0]m00_nodes_M_SC_AR_SEND;
  wire [0:0]m00_nodes_M_SC_AW_INFO;
  wire [137:0]m00_nodes_M_SC_AW_PAYLD;
  wire m00_nodes_M_SC_AW_RECV;
  wire [0:0]m00_nodes_M_SC_AW_REQ;
  wire [0:0]m00_nodes_M_SC_AW_SEND;
  wire [1:0]m00_nodes_M_SC_B_INFO;
  wire [5:0]m00_nodes_M_SC_B_PAYLD;
  wire [1:0]m00_nodes_M_SC_B_RECV;
  wire [1:0]m00_nodes_M_SC_B_REQ;
  wire [1:0]m00_nodes_M_SC_B_SEND;
  wire [1:0]m00_nodes_M_SC_R_INFO;
  wire [51:0]m00_nodes_M_SC_R_PAYLD;
  wire [1:0]m00_nodes_M_SC_R_RECV;
  wire [1:0]m00_nodes_M_SC_R_REQ;
  wire [1:0]m00_nodes_M_SC_R_SEND;
  wire [0:0]m00_nodes_M_SC_W_INFO;
  wire [51:0]m00_nodes_M_SC_W_PAYLD;
  wire m00_nodes_M_SC_W_RECV;
  wire [0:0]m00_nodes_M_SC_W_REQ;
  wire [0:0]m00_nodes_M_SC_W_SEND;
  wire [28:0]m00_sc2axi_M_AXI_ARADDR;
  wire [3:0]m00_sc2axi_M_AXI_ARCACHE;
  wire [0:0]m00_sc2axi_M_AXI_ARID;
  wire [7:0]m00_sc2axi_M_AXI_ARLEN;
  wire [0:0]m00_sc2axi_M_AXI_ARLOCK;
  wire [2:0]m00_sc2axi_M_AXI_ARPROT;
  wire [3:0]m00_sc2axi_M_AXI_ARQOS;
  wire m00_sc2axi_M_AXI_ARREADY;
  wire [1023:0]m00_sc2axi_M_AXI_ARUSER;
  wire m00_sc2axi_M_AXI_ARVALID;
  wire [28:0]m00_sc2axi_M_AXI_AWADDR;
  wire [3:0]m00_sc2axi_M_AXI_AWCACHE;
  wire [0:0]m00_sc2axi_M_AXI_AWID;
  wire [7:0]m00_sc2axi_M_AXI_AWLEN;
  wire [0:0]m00_sc2axi_M_AXI_AWLOCK;
  wire [2:0]m00_sc2axi_M_AXI_AWPROT;
  wire [3:0]m00_sc2axi_M_AXI_AWQOS;
  wire m00_sc2axi_M_AXI_AWREADY;
  wire [1023:0]m00_sc2axi_M_AXI_AWUSER;
  wire m00_sc2axi_M_AXI_AWVALID;
  wire [0:0]m00_sc2axi_M_AXI_BID;
  wire m00_sc2axi_M_AXI_BREADY;
  wire [1:0]m00_sc2axi_M_AXI_BRESP;
  wire [1023:0]m00_sc2axi_M_AXI_BUSER;
  wire m00_sc2axi_M_AXI_BVALID;
  wire [31:0]m00_sc2axi_M_AXI_RDATA;
  wire [0:0]m00_sc2axi_M_AXI_RID;
  wire m00_sc2axi_M_AXI_RLAST;
  wire m00_sc2axi_M_AXI_RREADY;
  wire [1:0]m00_sc2axi_M_AXI_RRESP;
  wire [1023:0]m00_sc2axi_M_AXI_RUSER;
  wire m00_sc2axi_M_AXI_RVALID;
  wire [31:0]m00_sc2axi_M_AXI_WDATA;
  wire m00_sc2axi_M_AXI_WLAST;
  wire m00_sc2axi_M_AXI_WREADY;
  wire [3:0]m00_sc2axi_M_AXI_WSTRB;
  wire [1023:0]m00_sc2axi_M_AXI_WUSER;
  wire m00_sc2axi_M_AXI_WVALID;
  wire [0:0]m_axi_aresetn_1;
  wire [31:0]s00_entry_pipeline_m_axi_ARADDR;
  wire [3:0]s00_entry_pipeline_m_axi_ARCACHE;
  wire [0:0]s00_entry_pipeline_m_axi_ARID;
  wire [7:0]s00_entry_pipeline_m_axi_ARLEN;
  wire [0:0]s00_entry_pipeline_m_axi_ARLOCK;
  wire [2:0]s00_entry_pipeline_m_axi_ARPROT;
  wire [3:0]s00_entry_pipeline_m_axi_ARQOS;
  wire s00_entry_pipeline_m_axi_ARREADY;
  wire [1023:0]s00_entry_pipeline_m_axi_ARUSER;
  wire s00_entry_pipeline_m_axi_ARVALID;
  wire [31:0]s00_entry_pipeline_m_axi_AWADDR;
  wire [3:0]s00_entry_pipeline_m_axi_AWCACHE;
  wire [0:0]s00_entry_pipeline_m_axi_AWID;
  wire [7:0]s00_entry_pipeline_m_axi_AWLEN;
  wire [0:0]s00_entry_pipeline_m_axi_AWLOCK;
  wire [2:0]s00_entry_pipeline_m_axi_AWPROT;
  wire [3:0]s00_entry_pipeline_m_axi_AWQOS;
  wire s00_entry_pipeline_m_axi_AWREADY;
  wire [1023:0]s00_entry_pipeline_m_axi_AWUSER;
  wire s00_entry_pipeline_m_axi_AWVALID;
  wire [0:0]s00_entry_pipeline_m_axi_BID;
  wire s00_entry_pipeline_m_axi_BREADY;
  wire [1:0]s00_entry_pipeline_m_axi_BRESP;
  wire [1023:0]s00_entry_pipeline_m_axi_BUSER;
  wire s00_entry_pipeline_m_axi_BVALID;
  wire [31:0]s00_entry_pipeline_m_axi_RDATA;
  wire [0:0]s00_entry_pipeline_m_axi_RID;
  wire s00_entry_pipeline_m_axi_RLAST;
  wire s00_entry_pipeline_m_axi_RREADY;
  wire [1:0]s00_entry_pipeline_m_axi_RRESP;
  wire [1023:0]s00_entry_pipeline_m_axi_RUSER;
  wire s00_entry_pipeline_m_axi_RVALID;
  wire [31:0]s00_entry_pipeline_m_axi_WDATA;
  wire s00_entry_pipeline_m_axi_WLAST;
  wire s00_entry_pipeline_m_axi_WREADY;
  wire [3:0]s00_entry_pipeline_m_axi_WSTRB;
  wire [1023:0]s00_entry_pipeline_m_axi_WUSER;
  wire s00_entry_pipeline_m_axi_WVALID;
  wire [0:0]s00_nodes_M_SC_AR_INFO;
  wire [137:0]s00_nodes_M_SC_AR_PAYLD;
  wire [0:0]s00_nodes_M_SC_AR_RECV;
  wire [0:0]s00_nodes_M_SC_AR_REQ;
  wire [0:0]s00_nodes_M_SC_AR_SEND;
  wire [0:0]s00_nodes_M_SC_AW_INFO;
  wire [137:0]s00_nodes_M_SC_AW_PAYLD;
  wire [0:0]s00_nodes_M_SC_AW_RECV;
  wire [0:0]s00_nodes_M_SC_AW_REQ;
  wire [0:0]s00_nodes_M_SC_AW_SEND;
  wire [0:0]s00_nodes_M_SC_B_INFO;
  wire [5:0]s00_nodes_M_SC_B_PAYLD;
  wire s00_nodes_M_SC_B_RECV;
  wire [0:0]s00_nodes_M_SC_B_REQ;
  wire [0:0]s00_nodes_M_SC_B_SEND;
  wire [0:0]s00_nodes_M_SC_R_INFO;
  wire [51:0]s00_nodes_M_SC_R_PAYLD;
  wire s00_nodes_M_SC_R_RECV;
  wire [0:0]s00_nodes_M_SC_R_REQ;
  wire [0:0]s00_nodes_M_SC_R_SEND;
  wire [0:0]s00_nodes_M_SC_W_INFO;
  wire [51:0]s00_nodes_M_SC_W_PAYLD;
  wire [0:0]s00_nodes_M_SC_W_RECV;
  wire [0:0]s00_nodes_M_SC_W_REQ;
  wire [0:0]s00_nodes_M_SC_W_SEND;
  wire [31:0]s01_entry_pipeline_m_axi_ARADDR;
  wire [3:0]s01_entry_pipeline_m_axi_ARCACHE;
  wire [0:0]s01_entry_pipeline_m_axi_ARID;
  wire [7:0]s01_entry_pipeline_m_axi_ARLEN;
  wire [0:0]s01_entry_pipeline_m_axi_ARLOCK;
  wire [2:0]s01_entry_pipeline_m_axi_ARPROT;
  wire [3:0]s01_entry_pipeline_m_axi_ARQOS;
  wire s01_entry_pipeline_m_axi_ARREADY;
  wire [1023:0]s01_entry_pipeline_m_axi_ARUSER;
  wire s01_entry_pipeline_m_axi_ARVALID;
  wire [31:0]s01_entry_pipeline_m_axi_RDATA;
  wire [0:0]s01_entry_pipeline_m_axi_RID;
  wire s01_entry_pipeline_m_axi_RLAST;
  wire s01_entry_pipeline_m_axi_RREADY;
  wire [1:0]s01_entry_pipeline_m_axi_RRESP;
  wire [1023:0]s01_entry_pipeline_m_axi_RUSER;
  wire s01_entry_pipeline_m_axi_RVALID;
  wire [0:0]s01_nodes_M_SC_AR_INFO;
  wire [137:0]s01_nodes_M_SC_AR_PAYLD;
  wire [0:0]s01_nodes_M_SC_AR_RECV;
  wire [0:0]s01_nodes_M_SC_AR_REQ;
  wire [0:0]s01_nodes_M_SC_AR_SEND;
  wire [0:0]s01_nodes_M_SC_R_INFO;
  wire [51:0]s01_nodes_M_SC_R_PAYLD;
  wire s01_nodes_M_SC_R_RECV;
  wire [0:0]s01_nodes_M_SC_R_REQ;
  wire [0:0]s01_nodes_M_SC_R_SEND;
  wire swbd_aclk_net;
  wire [0:0]swbd_aresetn_net;

  assign M00_AXI_araddr[28:0] = m00_exit_pipeline_m_axi_ARADDR;
  assign M00_AXI_arburst[1:0] = m00_exit_pipeline_m_axi_ARBURST;
  assign M00_AXI_arcache[3:0] = m00_exit_pipeline_m_axi_ARCACHE;
  assign M00_AXI_arlen[7:0] = m00_exit_pipeline_m_axi_ARLEN;
  assign M00_AXI_arlock[0] = m00_exit_pipeline_m_axi_ARLOCK;
  assign M00_AXI_arprot[2:0] = m00_exit_pipeline_m_axi_ARPROT;
  assign M00_AXI_arqos[3:0] = m00_exit_pipeline_m_axi_ARQOS;
  assign M00_AXI_arsize[2:0] = m00_exit_pipeline_m_axi_ARSIZE;
  assign M00_AXI_arvalid = m00_exit_pipeline_m_axi_ARVALID;
  assign M00_AXI_awaddr[28:0] = m00_exit_pipeline_m_axi_AWADDR;
  assign M00_AXI_awburst[1:0] = m00_exit_pipeline_m_axi_AWBURST;
  assign M00_AXI_awcache[3:0] = m00_exit_pipeline_m_axi_AWCACHE;
  assign M00_AXI_awlen[7:0] = m00_exit_pipeline_m_axi_AWLEN;
  assign M00_AXI_awlock[0] = m00_exit_pipeline_m_axi_AWLOCK;
  assign M00_AXI_awprot[2:0] = m00_exit_pipeline_m_axi_AWPROT;
  assign M00_AXI_awqos[3:0] = m00_exit_pipeline_m_axi_AWQOS;
  assign M00_AXI_awsize[2:0] = m00_exit_pipeline_m_axi_AWSIZE;
  assign M00_AXI_awvalid = m00_exit_pipeline_m_axi_AWVALID;
  assign M00_AXI_bready = m00_exit_pipeline_m_axi_BREADY;
  assign M00_AXI_rready = m00_exit_pipeline_m_axi_RREADY;
  assign M00_AXI_wdata[31:0] = m00_exit_pipeline_m_axi_WDATA;
  assign M00_AXI_wlast = m00_exit_pipeline_m_axi_WLAST;
  assign M00_AXI_wstrb[3:0] = m00_exit_pipeline_m_axi_WSTRB;
  assign M00_AXI_wvalid = m00_exit_pipeline_m_axi_WVALID;
  assign S00_AXI_1_ARADDR = S00_AXI_araddr[31:0];
  assign S00_AXI_1_ARBURST = S00_AXI_arburst[1:0];
  assign S00_AXI_1_ARCACHE = S00_AXI_arcache[3:0];
  assign S00_AXI_1_ARLEN = S00_AXI_arlen[7:0];
  assign S00_AXI_1_ARLOCK = S00_AXI_arlock[0];
  assign S00_AXI_1_ARPROT = S00_AXI_arprot[2:0];
  assign S00_AXI_1_ARQOS = S00_AXI_arqos[3:0];
  assign S00_AXI_1_ARSIZE = S00_AXI_arsize[2:0];
  assign S00_AXI_1_ARVALID = S00_AXI_arvalid;
  assign S00_AXI_1_AWADDR = S00_AXI_awaddr[31:0];
  assign S00_AXI_1_AWBURST = S00_AXI_awburst[1:0];
  assign S00_AXI_1_AWCACHE = S00_AXI_awcache[3:0];
  assign S00_AXI_1_AWLEN = S00_AXI_awlen[7:0];
  assign S00_AXI_1_AWLOCK = S00_AXI_awlock[0];
  assign S00_AXI_1_AWPROT = S00_AXI_awprot[2:0];
  assign S00_AXI_1_AWQOS = S00_AXI_awqos[3:0];
  assign S00_AXI_1_AWSIZE = S00_AXI_awsize[2:0];
  assign S00_AXI_1_AWVALID = S00_AXI_awvalid;
  assign S00_AXI_1_BREADY = S00_AXI_bready;
  assign S00_AXI_1_RREADY = S00_AXI_rready;
  assign S00_AXI_1_WDATA = S00_AXI_wdata[31:0];
  assign S00_AXI_1_WLAST = S00_AXI_wlast;
  assign S00_AXI_1_WSTRB = S00_AXI_wstrb[3:0];
  assign S00_AXI_1_WVALID = S00_AXI_wvalid;
  assign S00_AXI_arready = S00_AXI_1_ARREADY;
  assign S00_AXI_awready = S00_AXI_1_AWREADY;
  assign S00_AXI_bresp[1:0] = S00_AXI_1_BRESP;
  assign S00_AXI_bvalid = S00_AXI_1_BVALID;
  assign S00_AXI_rdata[31:0] = S00_AXI_1_RDATA;
  assign S00_AXI_rlast = S00_AXI_1_RLAST;
  assign S00_AXI_rresp[1:0] = S00_AXI_1_RRESP;
  assign S00_AXI_rvalid = S00_AXI_1_RVALID;
  assign S00_AXI_wready = S00_AXI_1_WREADY;
  assign S01_AXI_1_ARADDR = S01_AXI_araddr[31:0];
  assign S01_AXI_1_ARBURST = S01_AXI_arburst[1:0];
  assign S01_AXI_1_ARCACHE = S01_AXI_arcache[3:0];
  assign S01_AXI_1_ARLEN = S01_AXI_arlen[7:0];
  assign S01_AXI_1_ARLOCK = S01_AXI_arlock[0];
  assign S01_AXI_1_ARPROT = S01_AXI_arprot[2:0];
  assign S01_AXI_1_ARQOS = S01_AXI_arqos[3:0];
  assign S01_AXI_1_ARSIZE = S01_AXI_arsize[2:0];
  assign S01_AXI_1_ARVALID = S01_AXI_arvalid;
  assign S01_AXI_1_RREADY = S01_AXI_rready;
  assign S01_AXI_arready = S01_AXI_1_ARREADY;
  assign S01_AXI_rdata[31:0] = S01_AXI_1_RDATA;
  assign S01_AXI_rlast = S01_AXI_1_RLAST;
  assign S01_AXI_rresp[1:0] = S01_AXI_1_RRESP;
  assign S01_AXI_rvalid = S01_AXI_1_RVALID;
  assign aclk1_1 = aclk1;
  assign aclk_net = aclk;
  assign aresetn_1 = aresetn;
  assign m00_exit_pipeline_m_axi_ARREADY = M00_AXI_arready;
  assign m00_exit_pipeline_m_axi_AWREADY = M00_AXI_awready;
  assign m00_exit_pipeline_m_axi_BRESP = M00_AXI_bresp[1:0];
  assign m00_exit_pipeline_m_axi_BVALID = M00_AXI_bvalid;
  assign m00_exit_pipeline_m_axi_RDATA = M00_AXI_rdata[31:0];
  assign m00_exit_pipeline_m_axi_RLAST = M00_AXI_rlast;
  assign m00_exit_pipeline_m_axi_RRESP = M00_AXI_rresp[1:0];
  assign m00_exit_pipeline_m_axi_RVALID = M00_AXI_rvalid;
  assign m00_exit_pipeline_m_axi_WREADY = M00_AXI_wready;
  clk_map_imp_Y6LIBS clk_map
       (.M00_ACLK(clk_map_M00_ACLK),
        .M00_ARESETN(m_axi_aresetn_1),
        .S00_ACLK(aclk_1),
        .S00_ARESETN(aresetn_2),
        .S01_ACLK(aclk_2),
        .S01_ARESETN(aresetn_3),
        .aclk(aclk_net),
        .aclk1(aclk1_1),
        .aresetn(aresetn_1),
        .aresetn_out(aresetn_net),
        .swbd_aclk(swbd_aclk_net),
        .swbd_aresetn(swbd_aresetn_net));
  m00_exit_pipeline_imp_10IOOUR m00_exit_pipeline
       (.aclk(clk_map_M00_ACLK),
        .aresetn(m_axi_aresetn_1),
        .m_axi_araddr(m00_exit_pipeline_m_axi_ARADDR),
        .m_axi_arburst(m00_exit_pipeline_m_axi_ARBURST),
        .m_axi_arcache(m00_exit_pipeline_m_axi_ARCACHE),
        .m_axi_arlen(m00_exit_pipeline_m_axi_ARLEN),
        .m_axi_arlock(m00_exit_pipeline_m_axi_ARLOCK),
        .m_axi_arprot(m00_exit_pipeline_m_axi_ARPROT),
        .m_axi_arqos(m00_exit_pipeline_m_axi_ARQOS),
        .m_axi_arready(m00_exit_pipeline_m_axi_ARREADY),
        .m_axi_arsize(m00_exit_pipeline_m_axi_ARSIZE),
        .m_axi_arvalid(m00_exit_pipeline_m_axi_ARVALID),
        .m_axi_awaddr(m00_exit_pipeline_m_axi_AWADDR),
        .m_axi_awburst(m00_exit_pipeline_m_axi_AWBURST),
        .m_axi_awcache(m00_exit_pipeline_m_axi_AWCACHE),
        .m_axi_awlen(m00_exit_pipeline_m_axi_AWLEN),
        .m_axi_awlock(m00_exit_pipeline_m_axi_AWLOCK),
        .m_axi_awprot(m00_exit_pipeline_m_axi_AWPROT),
        .m_axi_awqos(m00_exit_pipeline_m_axi_AWQOS),
        .m_axi_awready(m00_exit_pipeline_m_axi_AWREADY),
        .m_axi_awsize(m00_exit_pipeline_m_axi_AWSIZE),
        .m_axi_awvalid(m00_exit_pipeline_m_axi_AWVALID),
        .m_axi_bready(m00_exit_pipeline_m_axi_BREADY),
        .m_axi_bresp(m00_exit_pipeline_m_axi_BRESP),
        .m_axi_bvalid(m00_exit_pipeline_m_axi_BVALID),
        .m_axi_rdata(m00_exit_pipeline_m_axi_RDATA),
        .m_axi_rlast(m00_exit_pipeline_m_axi_RLAST),
        .m_axi_rready(m00_exit_pipeline_m_axi_RREADY),
        .m_axi_rresp(m00_exit_pipeline_m_axi_RRESP),
        .m_axi_rvalid(m00_exit_pipeline_m_axi_RVALID),
        .m_axi_wdata(m00_exit_pipeline_m_axi_WDATA),
        .m_axi_wlast(m00_exit_pipeline_m_axi_WLAST),
        .m_axi_wready(m00_exit_pipeline_m_axi_WREADY),
        .m_axi_wstrb(m00_exit_pipeline_m_axi_WSTRB),
        .m_axi_wvalid(m00_exit_pipeline_m_axi_WVALID),
        .s_axi_araddr(m00_sc2axi_M_AXI_ARADDR),
        .s_axi_arcache(m00_sc2axi_M_AXI_ARCACHE),
        .s_axi_arid(m00_sc2axi_M_AXI_ARID),
        .s_axi_arlen(m00_sc2axi_M_AXI_ARLEN),
        .s_axi_arlock(m00_sc2axi_M_AXI_ARLOCK),
        .s_axi_arprot(m00_sc2axi_M_AXI_ARPROT),
        .s_axi_arqos(m00_sc2axi_M_AXI_ARQOS),
        .s_axi_arready(m00_sc2axi_M_AXI_ARREADY),
        .s_axi_aruser(m00_sc2axi_M_AXI_ARUSER),
        .s_axi_arvalid(m00_sc2axi_M_AXI_ARVALID),
        .s_axi_awaddr(m00_sc2axi_M_AXI_AWADDR),
        .s_axi_awcache(m00_sc2axi_M_AXI_AWCACHE),
        .s_axi_awid(m00_sc2axi_M_AXI_AWID),
        .s_axi_awlen(m00_sc2axi_M_AXI_AWLEN),
        .s_axi_awlock(m00_sc2axi_M_AXI_AWLOCK),
        .s_axi_awprot(m00_sc2axi_M_AXI_AWPROT),
        .s_axi_awqos(m00_sc2axi_M_AXI_AWQOS),
        .s_axi_awready(m00_sc2axi_M_AXI_AWREADY),
        .s_axi_awuser(m00_sc2axi_M_AXI_AWUSER),
        .s_axi_awvalid(m00_sc2axi_M_AXI_AWVALID),
        .s_axi_bid(m00_sc2axi_M_AXI_BID),
        .s_axi_bready(m00_sc2axi_M_AXI_BREADY),
        .s_axi_bresp(m00_sc2axi_M_AXI_BRESP),
        .s_axi_buser(m00_sc2axi_M_AXI_BUSER),
        .s_axi_bvalid(m00_sc2axi_M_AXI_BVALID),
        .s_axi_rdata(m00_sc2axi_M_AXI_RDATA),
        .s_axi_rid(m00_sc2axi_M_AXI_RID),
        .s_axi_rlast(m00_sc2axi_M_AXI_RLAST),
        .s_axi_rready(m00_sc2axi_M_AXI_RREADY),
        .s_axi_rresp(m00_sc2axi_M_AXI_RRESP),
        .s_axi_ruser(m00_sc2axi_M_AXI_RUSER),
        .s_axi_rvalid(m00_sc2axi_M_AXI_RVALID),
        .s_axi_wdata(m00_sc2axi_M_AXI_WDATA),
        .s_axi_wlast(m00_sc2axi_M_AXI_WLAST),
        .s_axi_wready(m00_sc2axi_M_AXI_WREADY),
        .s_axi_wstrb(m00_sc2axi_M_AXI_WSTRB),
        .s_axi_wuser(m00_sc2axi_M_AXI_WUSER),
        .s_axi_wvalid(m00_sc2axi_M_AXI_WVALID));
  m00_nodes_imp_1MQ73SV m00_nodes
       (.M_SC_AR_info(m00_nodes_M_SC_AR_INFO),
        .M_SC_AR_payld(m00_nodes_M_SC_AR_PAYLD),
        .M_SC_AR_recv(m00_nodes_M_SC_AR_RECV),
        .M_SC_AR_req(m00_nodes_M_SC_AR_REQ),
        .M_SC_AR_send(m00_nodes_M_SC_AR_SEND),
        .M_SC_AW_info(m00_nodes_M_SC_AW_INFO),
        .M_SC_AW_payld(m00_nodes_M_SC_AW_PAYLD),
        .M_SC_AW_recv(m00_nodes_M_SC_AW_RECV),
        .M_SC_AW_req(m00_nodes_M_SC_AW_REQ),
        .M_SC_AW_send(m00_nodes_M_SC_AW_SEND),
        .M_SC_B_info(m00_nodes_M_SC_B_INFO),
        .M_SC_B_payld(m00_nodes_M_SC_B_PAYLD),
        .M_SC_B_recv(m00_nodes_M_SC_B_RECV),
        .M_SC_B_req(m00_nodes_M_SC_B_REQ),
        .M_SC_B_send(m00_nodes_M_SC_B_SEND),
        .M_SC_R_info(m00_nodes_M_SC_R_INFO),
        .M_SC_R_payld(m00_nodes_M_SC_R_PAYLD),
        .M_SC_R_recv(m00_nodes_M_SC_R_RECV),
        .M_SC_R_req(m00_nodes_M_SC_R_REQ),
        .M_SC_R_send(m00_nodes_M_SC_R_SEND),
        .M_SC_W_info(m00_nodes_M_SC_W_INFO),
        .M_SC_W_payld(m00_nodes_M_SC_W_PAYLD),
        .M_SC_W_recv(m00_nodes_M_SC_W_RECV),
        .M_SC_W_req(m00_nodes_M_SC_W_REQ),
        .M_SC_W_send(m00_nodes_M_SC_W_SEND),
        .S_SC_AR_info(S_SC_AR_3_INFO),
        .S_SC_AR_payld(S_SC_AR_3_PAYLD),
        .S_SC_AR_recv(S_SC_AR_3_RECV),
        .S_SC_AR_req(S_SC_AR_3_REQ),
        .S_SC_AR_send(S_SC_AR_3_SEND),
        .S_SC_AW_info(S_SC_AW_2_INFO),
        .S_SC_AW_payld(S_SC_AW_2_PAYLD),
        .S_SC_AW_recv(S_SC_AW_2_RECV),
        .S_SC_AW_req(S_SC_AW_2_REQ),
        .S_SC_AW_send(S_SC_AW_2_SEND),
        .S_SC_B_info(S_SC_B_2_INFO),
        .S_SC_B_payld(S_SC_B_2_PAYLD),
        .S_SC_B_recv(S_SC_B_2_RECV),
        .S_SC_B_req(S_SC_B_2_REQ),
        .S_SC_B_send(S_SC_B_2_SEND),
        .S_SC_R_info(S_SC_R_3_INFO),
        .S_SC_R_payld(S_SC_R_3_PAYLD),
        .S_SC_R_recv(S_SC_R_3_RECV),
        .S_SC_R_req(S_SC_R_3_REQ),
        .S_SC_R_send(S_SC_R_3_SEND),
        .S_SC_W_info(S_SC_W_2_INFO),
        .S_SC_W_payld(S_SC_W_2_PAYLD),
        .S_SC_W_recv(S_SC_W_2_RECV),
        .S_SC_W_req(S_SC_W_2_REQ),
        .S_SC_W_send(S_SC_W_2_SEND),
        .m_axi_aclk(clk_map_M00_ACLK),
        .m_axi_aresetn(m_axi_aresetn_1),
        .s_axi_aclk(swbd_aclk_net),
        .s_axi_aresetn(swbd_aresetn_net));
  bd_cd63_m00s2a_0 m00_sc2axi
       (.aclk(clk_map_M00_ACLK),
        .m_axi_araddr(m00_sc2axi_M_AXI_ARADDR),
        .m_axi_arcache(m00_sc2axi_M_AXI_ARCACHE),
        .m_axi_arid(m00_sc2axi_M_AXI_ARID),
        .m_axi_arlen(m00_sc2axi_M_AXI_ARLEN),
        .m_axi_arlock(m00_sc2axi_M_AXI_ARLOCK),
        .m_axi_arprot(m00_sc2axi_M_AXI_ARPROT),
        .m_axi_arqos(m00_sc2axi_M_AXI_ARQOS),
        .m_axi_arready(m00_sc2axi_M_AXI_ARREADY),
        .m_axi_aruser(m00_sc2axi_M_AXI_ARUSER),
        .m_axi_arvalid(m00_sc2axi_M_AXI_ARVALID),
        .m_axi_awaddr(m00_sc2axi_M_AXI_AWADDR),
        .m_axi_awcache(m00_sc2axi_M_AXI_AWCACHE),
        .m_axi_awid(m00_sc2axi_M_AXI_AWID),
        .m_axi_awlen(m00_sc2axi_M_AXI_AWLEN),
        .m_axi_awlock(m00_sc2axi_M_AXI_AWLOCK),
        .m_axi_awprot(m00_sc2axi_M_AXI_AWPROT),
        .m_axi_awqos(m00_sc2axi_M_AXI_AWQOS),
        .m_axi_awready(m00_sc2axi_M_AXI_AWREADY),
        .m_axi_awuser(m00_sc2axi_M_AXI_AWUSER),
        .m_axi_awvalid(m00_sc2axi_M_AXI_AWVALID),
        .m_axi_bid(m00_sc2axi_M_AXI_BID),
        .m_axi_bready(m00_sc2axi_M_AXI_BREADY),
        .m_axi_bresp(m00_sc2axi_M_AXI_BRESP),
        .m_axi_buser(m00_sc2axi_M_AXI_BUSER),
        .m_axi_bvalid(m00_sc2axi_M_AXI_BVALID),
        .m_axi_rdata(m00_sc2axi_M_AXI_RDATA),
        .m_axi_rid(m00_sc2axi_M_AXI_RID),
        .m_axi_rlast(m00_sc2axi_M_AXI_RLAST),
        .m_axi_rready(m00_sc2axi_M_AXI_RREADY),
        .m_axi_rresp(m00_sc2axi_M_AXI_RRESP),
        .m_axi_ruser(m00_sc2axi_M_AXI_RUSER),
        .m_axi_rvalid(m00_sc2axi_M_AXI_RVALID),
        .m_axi_wdata(m00_sc2axi_M_AXI_WDATA),
        .m_axi_wlast(m00_sc2axi_M_AXI_WLAST),
        .m_axi_wready(m00_sc2axi_M_AXI_WREADY),
        .m_axi_wstrb(m00_sc2axi_M_AXI_WSTRB),
        .m_axi_wuser(m00_sc2axi_M_AXI_WUSER),
        .m_axi_wvalid(m00_sc2axi_M_AXI_WVALID),
        .m_sc_b_info(S_SC_B_2_INFO),
        .m_sc_b_payld(S_SC_B_2_PAYLD),
        .m_sc_b_recv(S_SC_B_2_RECV),
        .m_sc_b_req(S_SC_B_2_REQ),
        .m_sc_b_send(S_SC_B_2_SEND),
        .m_sc_r_info(S_SC_R_3_INFO),
        .m_sc_r_payld(S_SC_R_3_PAYLD),
        .m_sc_r_recv(S_SC_R_3_RECV),
        .m_sc_r_req(S_SC_R_3_REQ),
        .m_sc_r_send(S_SC_R_3_SEND),
        .s_sc_ar_info(m00_nodes_M_SC_AR_INFO),
        .s_sc_ar_payld(m00_nodes_M_SC_AR_PAYLD),
        .s_sc_ar_recv(m00_nodes_M_SC_AR_RECV),
        .s_sc_ar_req(m00_nodes_M_SC_AR_REQ),
        .s_sc_ar_send(m00_nodes_M_SC_AR_SEND),
        .s_sc_aw_info(m00_nodes_M_SC_AW_INFO),
        .s_sc_aw_payld(m00_nodes_M_SC_AW_PAYLD),
        .s_sc_aw_recv(m00_nodes_M_SC_AW_RECV),
        .s_sc_aw_req(m00_nodes_M_SC_AW_REQ),
        .s_sc_aw_send(m00_nodes_M_SC_AW_SEND),
        .s_sc_w_info(m00_nodes_M_SC_W_INFO),
        .s_sc_w_payld(m00_nodes_M_SC_W_PAYLD),
        .s_sc_w_recv(m00_nodes_M_SC_W_RECV),
        .s_sc_w_req(m00_nodes_M_SC_W_REQ),
        .s_sc_w_send(m00_nodes_M_SC_W_SEND));
  bd_cd63_s00a2s_0 s00_axi2sc
       (.aclk(aclk_1),
        .m_sc_ar_info(S_SC_AR_1_INFO),
        .m_sc_ar_payld(S_SC_AR_1_PAYLD),
        .m_sc_ar_recv(S_SC_AR_1_RECV),
        .m_sc_ar_req(S_SC_AR_1_REQ),
        .m_sc_ar_send(S_SC_AR_1_SEND),
        .m_sc_aw_info(S_SC_AW_1_INFO),
        .m_sc_aw_payld(S_SC_AW_1_PAYLD),
        .m_sc_aw_recv(S_SC_AW_1_RECV),
        .m_sc_aw_req(S_SC_AW_1_REQ),
        .m_sc_aw_send(S_SC_AW_1_SEND),
        .m_sc_w_info(S_SC_W_1_INFO),
        .m_sc_w_payld(S_SC_W_1_PAYLD),
        .m_sc_w_recv(S_SC_W_1_RECV),
        .m_sc_w_req(S_SC_W_1_REQ),
        .m_sc_w_send(S_SC_W_1_SEND),
        .s_axi_araddr(s00_entry_pipeline_m_axi_ARADDR),
        .s_axi_arcache(s00_entry_pipeline_m_axi_ARCACHE),
        .s_axi_arid(s00_entry_pipeline_m_axi_ARID),
        .s_axi_arlen(s00_entry_pipeline_m_axi_ARLEN),
        .s_axi_arlock(s00_entry_pipeline_m_axi_ARLOCK),
        .s_axi_arprot(s00_entry_pipeline_m_axi_ARPROT),
        .s_axi_arqos(s00_entry_pipeline_m_axi_ARQOS),
        .s_axi_arready(s00_entry_pipeline_m_axi_ARREADY),
        .s_axi_aruser(s00_entry_pipeline_m_axi_ARUSER),
        .s_axi_arvalid(s00_entry_pipeline_m_axi_ARVALID),
        .s_axi_awaddr(s00_entry_pipeline_m_axi_AWADDR),
        .s_axi_awcache(s00_entry_pipeline_m_axi_AWCACHE),
        .s_axi_awid(s00_entry_pipeline_m_axi_AWID),
        .s_axi_awlen(s00_entry_pipeline_m_axi_AWLEN),
        .s_axi_awlock(s00_entry_pipeline_m_axi_AWLOCK),
        .s_axi_awprot(s00_entry_pipeline_m_axi_AWPROT),
        .s_axi_awqos(s00_entry_pipeline_m_axi_AWQOS),
        .s_axi_awready(s00_entry_pipeline_m_axi_AWREADY),
        .s_axi_awuser(s00_entry_pipeline_m_axi_AWUSER),
        .s_axi_awvalid(s00_entry_pipeline_m_axi_AWVALID),
        .s_axi_bid(s00_entry_pipeline_m_axi_BID),
        .s_axi_bready(s00_entry_pipeline_m_axi_BREADY),
        .s_axi_bresp(s00_entry_pipeline_m_axi_BRESP),
        .s_axi_buser(s00_entry_pipeline_m_axi_BUSER),
        .s_axi_bvalid(s00_entry_pipeline_m_axi_BVALID),
        .s_axi_rdata(s00_entry_pipeline_m_axi_RDATA),
        .s_axi_rid(s00_entry_pipeline_m_axi_RID),
        .s_axi_rlast(s00_entry_pipeline_m_axi_RLAST),
        .s_axi_rready(s00_entry_pipeline_m_axi_RREADY),
        .s_axi_rresp(s00_entry_pipeline_m_axi_RRESP),
        .s_axi_ruser(s00_entry_pipeline_m_axi_RUSER),
        .s_axi_rvalid(s00_entry_pipeline_m_axi_RVALID),
        .s_axi_wdata(s00_entry_pipeline_m_axi_WDATA),
        .s_axi_wlast(s00_entry_pipeline_m_axi_WLAST),
        .s_axi_wready(s00_entry_pipeline_m_axi_WREADY),
        .s_axi_wstrb(s00_entry_pipeline_m_axi_WSTRB),
        .s_axi_wuser(s00_entry_pipeline_m_axi_WUSER),
        .s_axi_wvalid(s00_entry_pipeline_m_axi_WVALID),
        .s_sc_b_info(s00_nodes_M_SC_B_INFO),
        .s_sc_b_payld(s00_nodes_M_SC_B_PAYLD),
        .s_sc_b_recv(s00_nodes_M_SC_B_RECV),
        .s_sc_b_req(s00_nodes_M_SC_B_REQ),
        .s_sc_b_send(s00_nodes_M_SC_B_SEND),
        .s_sc_r_info(s00_nodes_M_SC_R_INFO),
        .s_sc_r_payld(s00_nodes_M_SC_R_PAYLD),
        .s_sc_r_recv(s00_nodes_M_SC_R_RECV),
        .s_sc_r_req(s00_nodes_M_SC_R_REQ),
        .s_sc_r_send(s00_nodes_M_SC_R_SEND));
  s00_entry_pipeline_imp_70YJ4 s00_entry_pipeline
       (.aclk(aclk_1),
        .aresetn(aresetn_2),
        .m_axi_araddr(s00_entry_pipeline_m_axi_ARADDR),
        .m_axi_arcache(s00_entry_pipeline_m_axi_ARCACHE),
        .m_axi_arid(s00_entry_pipeline_m_axi_ARID),
        .m_axi_arlen(s00_entry_pipeline_m_axi_ARLEN),
        .m_axi_arlock(s00_entry_pipeline_m_axi_ARLOCK),
        .m_axi_arprot(s00_entry_pipeline_m_axi_ARPROT),
        .m_axi_arqos(s00_entry_pipeline_m_axi_ARQOS),
        .m_axi_arready(s00_entry_pipeline_m_axi_ARREADY),
        .m_axi_aruser(s00_entry_pipeline_m_axi_ARUSER),
        .m_axi_arvalid(s00_entry_pipeline_m_axi_ARVALID),
        .m_axi_awaddr(s00_entry_pipeline_m_axi_AWADDR),
        .m_axi_awcache(s00_entry_pipeline_m_axi_AWCACHE),
        .m_axi_awid(s00_entry_pipeline_m_axi_AWID),
        .m_axi_awlen(s00_entry_pipeline_m_axi_AWLEN),
        .m_axi_awlock(s00_entry_pipeline_m_axi_AWLOCK),
        .m_axi_awprot(s00_entry_pipeline_m_axi_AWPROT),
        .m_axi_awqos(s00_entry_pipeline_m_axi_AWQOS),
        .m_axi_awready(s00_entry_pipeline_m_axi_AWREADY),
        .m_axi_awuser(s00_entry_pipeline_m_axi_AWUSER),
        .m_axi_awvalid(s00_entry_pipeline_m_axi_AWVALID),
        .m_axi_bid(s00_entry_pipeline_m_axi_BID),
        .m_axi_bready(s00_entry_pipeline_m_axi_BREADY),
        .m_axi_bresp(s00_entry_pipeline_m_axi_BRESP),
        .m_axi_buser(s00_entry_pipeline_m_axi_BUSER),
        .m_axi_bvalid(s00_entry_pipeline_m_axi_BVALID),
        .m_axi_rdata(s00_entry_pipeline_m_axi_RDATA),
        .m_axi_rid(s00_entry_pipeline_m_axi_RID),
        .m_axi_rlast(s00_entry_pipeline_m_axi_RLAST),
        .m_axi_rready(s00_entry_pipeline_m_axi_RREADY),
        .m_axi_rresp(s00_entry_pipeline_m_axi_RRESP),
        .m_axi_ruser(s00_entry_pipeline_m_axi_RUSER),
        .m_axi_rvalid(s00_entry_pipeline_m_axi_RVALID),
        .m_axi_wdata(s00_entry_pipeline_m_axi_WDATA),
        .m_axi_wlast(s00_entry_pipeline_m_axi_WLAST),
        .m_axi_wready(s00_entry_pipeline_m_axi_WREADY),
        .m_axi_wstrb(s00_entry_pipeline_m_axi_WSTRB),
        .m_axi_wuser(s00_entry_pipeline_m_axi_WUSER),
        .m_axi_wvalid(s00_entry_pipeline_m_axi_WVALID),
        .s_axi_araddr(S00_AXI_1_ARADDR),
        .s_axi_arburst(S00_AXI_1_ARBURST),
        .s_axi_arcache(S00_AXI_1_ARCACHE),
        .s_axi_arlen(S00_AXI_1_ARLEN),
        .s_axi_arlock(S00_AXI_1_ARLOCK),
        .s_axi_arprot(S00_AXI_1_ARPROT),
        .s_axi_arqos(S00_AXI_1_ARQOS),
        .s_axi_arready(S00_AXI_1_ARREADY),
        .s_axi_arsize(S00_AXI_1_ARSIZE),
        .s_axi_arvalid(S00_AXI_1_ARVALID),
        .s_axi_awaddr(S00_AXI_1_AWADDR),
        .s_axi_awburst(S00_AXI_1_AWBURST),
        .s_axi_awcache(S00_AXI_1_AWCACHE),
        .s_axi_awlen(S00_AXI_1_AWLEN),
        .s_axi_awlock(S00_AXI_1_AWLOCK),
        .s_axi_awprot(S00_AXI_1_AWPROT),
        .s_axi_awqos(S00_AXI_1_AWQOS),
        .s_axi_awready(S00_AXI_1_AWREADY),
        .s_axi_awsize(S00_AXI_1_AWSIZE),
        .s_axi_awvalid(S00_AXI_1_AWVALID),
        .s_axi_bready(S00_AXI_1_BREADY),
        .s_axi_bresp(S00_AXI_1_BRESP),
        .s_axi_bvalid(S00_AXI_1_BVALID),
        .s_axi_rdata(S00_AXI_1_RDATA),
        .s_axi_rlast(S00_AXI_1_RLAST),
        .s_axi_rready(S00_AXI_1_RREADY),
        .s_axi_rresp(S00_AXI_1_RRESP),
        .s_axi_rvalid(S00_AXI_1_RVALID),
        .s_axi_wdata(S00_AXI_1_WDATA),
        .s_axi_wlast(S00_AXI_1_WLAST),
        .s_axi_wready(S00_AXI_1_WREADY),
        .s_axi_wstrb(S00_AXI_1_WSTRB),
        .s_axi_wvalid(S00_AXI_1_WVALID));
  s00_nodes_imp_5UA7YI s00_nodes
       (.M_SC_AR_info(s00_nodes_M_SC_AR_INFO),
        .M_SC_AR_payld(s00_nodes_M_SC_AR_PAYLD),
        .M_SC_AR_recv(s00_nodes_M_SC_AR_RECV),
        .M_SC_AR_req(s00_nodes_M_SC_AR_REQ),
        .M_SC_AR_send(s00_nodes_M_SC_AR_SEND),
        .M_SC_AW_info(s00_nodes_M_SC_AW_INFO),
        .M_SC_AW_payld(s00_nodes_M_SC_AW_PAYLD),
        .M_SC_AW_recv(s00_nodes_M_SC_AW_RECV),
        .M_SC_AW_req(s00_nodes_M_SC_AW_REQ),
        .M_SC_AW_send(s00_nodes_M_SC_AW_SEND),
        .M_SC_B_info(s00_nodes_M_SC_B_INFO),
        .M_SC_B_payld(s00_nodes_M_SC_B_PAYLD),
        .M_SC_B_recv(s00_nodes_M_SC_B_RECV),
        .M_SC_B_req(s00_nodes_M_SC_B_REQ),
        .M_SC_B_send(s00_nodes_M_SC_B_SEND),
        .M_SC_R_info(s00_nodes_M_SC_R_INFO),
        .M_SC_R_payld(s00_nodes_M_SC_R_PAYLD),
        .M_SC_R_recv(s00_nodes_M_SC_R_RECV),
        .M_SC_R_req(s00_nodes_M_SC_R_REQ),
        .M_SC_R_send(s00_nodes_M_SC_R_SEND),
        .M_SC_W_info(s00_nodes_M_SC_W_INFO),
        .M_SC_W_payld(s00_nodes_M_SC_W_PAYLD),
        .M_SC_W_recv(s00_nodes_M_SC_W_RECV),
        .M_SC_W_req(s00_nodes_M_SC_W_REQ),
        .M_SC_W_send(s00_nodes_M_SC_W_SEND),
        .S_SC_AR_info(S_SC_AR_1_INFO),
        .S_SC_AR_payld(S_SC_AR_1_PAYLD),
        .S_SC_AR_recv(S_SC_AR_1_RECV),
        .S_SC_AR_req(S_SC_AR_1_REQ),
        .S_SC_AR_send(S_SC_AR_1_SEND),
        .S_SC_AW_info(S_SC_AW_1_INFO),
        .S_SC_AW_payld(S_SC_AW_1_PAYLD),
        .S_SC_AW_recv(S_SC_AW_1_RECV),
        .S_SC_AW_req(S_SC_AW_1_REQ),
        .S_SC_AW_send(S_SC_AW_1_SEND),
        .S_SC_B_info(S_SC_B_1_INFO),
        .S_SC_B_payld(S_SC_B_1_PAYLD),
        .S_SC_B_recv(S_SC_B_1_RECV),
        .S_SC_B_req(S_SC_B_1_REQ),
        .S_SC_B_send(S_SC_B_1_SEND),
        .S_SC_R_info(S_SC_R_1_INFO),
        .S_SC_R_payld(S_SC_R_1_PAYLD),
        .S_SC_R_recv(S_SC_R_1_RECV),
        .S_SC_R_req(S_SC_R_1_REQ),
        .S_SC_R_send(S_SC_R_1_SEND),
        .S_SC_W_info(S_SC_W_1_INFO),
        .S_SC_W_payld(S_SC_W_1_PAYLD),
        .S_SC_W_recv(S_SC_W_1_RECV),
        .S_SC_W_req(S_SC_W_1_REQ),
        .S_SC_W_send(S_SC_W_1_SEND),
        .m_sc_clk(swbd_aclk_net),
        .m_sc_resetn(swbd_aresetn_net),
        .s_sc_clk(aclk_1),
        .s_sc_resetn(aresetn_2));
  bd_cd63_s01a2s_0 s01_axi2sc
       (.aclk(aclk_2),
        .m_sc_ar_info(S_SC_AR_2_INFO),
        .m_sc_ar_payld(S_SC_AR_2_PAYLD),
        .m_sc_ar_recv(S_SC_AR_2_RECV),
        .m_sc_ar_req(S_SC_AR_2_REQ),
        .m_sc_ar_send(S_SC_AR_2_SEND),
        .s_axi_araddr(s01_entry_pipeline_m_axi_ARADDR),
        .s_axi_arcache(s01_entry_pipeline_m_axi_ARCACHE),
        .s_axi_arid(s01_entry_pipeline_m_axi_ARID),
        .s_axi_arlen(s01_entry_pipeline_m_axi_ARLEN),
        .s_axi_arlock(s01_entry_pipeline_m_axi_ARLOCK),
        .s_axi_arprot(s01_entry_pipeline_m_axi_ARPROT),
        .s_axi_arqos(s01_entry_pipeline_m_axi_ARQOS),
        .s_axi_arready(s01_entry_pipeline_m_axi_ARREADY),
        .s_axi_aruser(s01_entry_pipeline_m_axi_ARUSER),
        .s_axi_arvalid(s01_entry_pipeline_m_axi_ARVALID),
        .s_axi_rdata(s01_entry_pipeline_m_axi_RDATA),
        .s_axi_rid(s01_entry_pipeline_m_axi_RID),
        .s_axi_rlast(s01_entry_pipeline_m_axi_RLAST),
        .s_axi_rready(s01_entry_pipeline_m_axi_RREADY),
        .s_axi_rresp(s01_entry_pipeline_m_axi_RRESP),
        .s_axi_ruser(s01_entry_pipeline_m_axi_RUSER),
        .s_axi_rvalid(s01_entry_pipeline_m_axi_RVALID),
        .s_sc_r_info(s01_nodes_M_SC_R_INFO),
        .s_sc_r_payld(s01_nodes_M_SC_R_PAYLD),
        .s_sc_r_recv(s01_nodes_M_SC_R_RECV),
        .s_sc_r_req(s01_nodes_M_SC_R_REQ),
        .s_sc_r_send(s01_nodes_M_SC_R_SEND));
  s01_entry_pipeline_imp_1781ZPG s01_entry_pipeline
       (.aclk(aclk_2),
        .aresetn(aresetn_3),
        .m_axi_araddr(s01_entry_pipeline_m_axi_ARADDR),
        .m_axi_arcache(s01_entry_pipeline_m_axi_ARCACHE),
        .m_axi_arid(s01_entry_pipeline_m_axi_ARID),
        .m_axi_arlen(s01_entry_pipeline_m_axi_ARLEN),
        .m_axi_arlock(s01_entry_pipeline_m_axi_ARLOCK),
        .m_axi_arprot(s01_entry_pipeline_m_axi_ARPROT),
        .m_axi_arqos(s01_entry_pipeline_m_axi_ARQOS),
        .m_axi_arready(s01_entry_pipeline_m_axi_ARREADY),
        .m_axi_aruser(s01_entry_pipeline_m_axi_ARUSER),
        .m_axi_arvalid(s01_entry_pipeline_m_axi_ARVALID),
        .m_axi_rdata(s01_entry_pipeline_m_axi_RDATA),
        .m_axi_rid(s01_entry_pipeline_m_axi_RID),
        .m_axi_rlast(s01_entry_pipeline_m_axi_RLAST),
        .m_axi_rready(s01_entry_pipeline_m_axi_RREADY),
        .m_axi_rresp(s01_entry_pipeline_m_axi_RRESP),
        .m_axi_ruser(s01_entry_pipeline_m_axi_RUSER),
        .m_axi_rvalid(s01_entry_pipeline_m_axi_RVALID),
        .s_axi_araddr(S01_AXI_1_ARADDR),
        .s_axi_arburst(S01_AXI_1_ARBURST),
        .s_axi_arcache(S01_AXI_1_ARCACHE),
        .s_axi_arlen(S01_AXI_1_ARLEN),
        .s_axi_arlock(S01_AXI_1_ARLOCK),
        .s_axi_arprot(S01_AXI_1_ARPROT),
        .s_axi_arqos(S01_AXI_1_ARQOS),
        .s_axi_arready(S01_AXI_1_ARREADY),
        .s_axi_arsize(S01_AXI_1_ARSIZE),
        .s_axi_arvalid(S01_AXI_1_ARVALID),
        .s_axi_rdata(S01_AXI_1_RDATA),
        .s_axi_rlast(S01_AXI_1_RLAST),
        .s_axi_rready(S01_AXI_1_RREADY),
        .s_axi_rresp(S01_AXI_1_RRESP),
        .s_axi_rvalid(S01_AXI_1_RVALID));
  s01_nodes_imp_11QKLVG s01_nodes
       (.M_SC_AR_info(s01_nodes_M_SC_AR_INFO),
        .M_SC_AR_payld(s01_nodes_M_SC_AR_PAYLD),
        .M_SC_AR_recv(s01_nodes_M_SC_AR_RECV),
        .M_SC_AR_req(s01_nodes_M_SC_AR_REQ),
        .M_SC_AR_send(s01_nodes_M_SC_AR_SEND),
        .M_SC_R_info(s01_nodes_M_SC_R_INFO),
        .M_SC_R_payld(s01_nodes_M_SC_R_PAYLD),
        .M_SC_R_recv(s01_nodes_M_SC_R_RECV),
        .M_SC_R_req(s01_nodes_M_SC_R_REQ),
        .M_SC_R_send(s01_nodes_M_SC_R_SEND),
        .S_SC_AR_info(S_SC_AR_2_INFO),
        .S_SC_AR_payld(S_SC_AR_2_PAYLD),
        .S_SC_AR_recv(S_SC_AR_2_RECV),
        .S_SC_AR_req(S_SC_AR_2_REQ),
        .S_SC_AR_send(S_SC_AR_2_SEND),
        .S_SC_R_info(S_SC_R_2_INFO),
        .S_SC_R_payld(S_SC_R_2_PAYLD),
        .S_SC_R_recv(S_SC_R_2_RECV),
        .S_SC_R_req(S_SC_R_2_REQ),
        .S_SC_R_send(S_SC_R_2_SEND),
        .m_sc_clk(swbd_aclk_net),
        .m_sc_resetn(swbd_aresetn_net),
        .s_sc_clk(aclk_2),
        .s_sc_resetn(aresetn_3));
  switchboards_imp_Z8D6FY switchboards
       (.M00_SC_AR_info(S_SC_AR_3_INFO),
        .M00_SC_AR_payld(S_SC_AR_3_PAYLD),
        .M00_SC_AR_recv(S_SC_AR_3_RECV),
        .M00_SC_AR_req(S_SC_AR_3_REQ),
        .M00_SC_AR_send(S_SC_AR_3_SEND),
        .M00_SC_AW_info(S_SC_AW_2_INFO),
        .M00_SC_AW_payld(S_SC_AW_2_PAYLD),
        .M00_SC_AW_recv(S_SC_AW_2_RECV),
        .M00_SC_AW_req(S_SC_AW_2_REQ),
        .M00_SC_AW_send(S_SC_AW_2_SEND),
        .M00_SC_B_info(S_SC_B_1_INFO),
        .M00_SC_B_payld(S_SC_B_1_PAYLD),
        .M00_SC_B_recv(S_SC_B_1_RECV),
        .M00_SC_B_req(S_SC_B_1_REQ),
        .M00_SC_B_send(S_SC_B_1_SEND),
        .M00_SC_R_info(S_SC_R_1_INFO),
        .M00_SC_R_payld(S_SC_R_1_PAYLD),
        .M00_SC_R_recv(S_SC_R_1_RECV),
        .M00_SC_R_req(S_SC_R_1_REQ),
        .M00_SC_R_send(S_SC_R_1_SEND),
        .M00_SC_W_info(S_SC_W_2_INFO),
        .M00_SC_W_payld(S_SC_W_2_PAYLD),
        .M00_SC_W_recv(S_SC_W_2_RECV),
        .M00_SC_W_req(S_SC_W_2_REQ),
        .M00_SC_W_send(S_SC_W_2_SEND),
        .M01_SC_B_recv(1'b0),
        .M01_SC_R_info(S_SC_R_2_INFO),
        .M01_SC_R_payld(S_SC_R_2_PAYLD),
        .M01_SC_R_recv(S_SC_R_2_RECV),
        .M01_SC_R_req(S_SC_R_2_REQ),
        .M01_SC_R_send(S_SC_R_2_SEND),
        .S00_SC_AR_info(s00_nodes_M_SC_AR_INFO),
        .S00_SC_AR_payld(s00_nodes_M_SC_AR_PAYLD),
        .S00_SC_AR_recv(s00_nodes_M_SC_AR_RECV),
        .S00_SC_AR_req(s00_nodes_M_SC_AR_REQ),
        .S00_SC_AR_send(s00_nodes_M_SC_AR_SEND),
        .S00_SC_AW_info(s00_nodes_M_SC_AW_INFO),
        .S00_SC_AW_payld(s00_nodes_M_SC_AW_PAYLD),
        .S00_SC_AW_recv(s00_nodes_M_SC_AW_RECV),
        .S00_SC_AW_req(s00_nodes_M_SC_AW_REQ),
        .S00_SC_AW_send(s00_nodes_M_SC_AW_SEND),
        .S00_SC_B_info(m00_nodes_M_SC_B_INFO),
        .S00_SC_B_payld(m00_nodes_M_SC_B_PAYLD),
        .S00_SC_B_recv(m00_nodes_M_SC_B_RECV),
        .S00_SC_B_req(m00_nodes_M_SC_B_REQ),
        .S00_SC_B_send(m00_nodes_M_SC_B_SEND),
        .S00_SC_R_info(m00_nodes_M_SC_R_INFO),
        .S00_SC_R_payld(m00_nodes_M_SC_R_PAYLD),
        .S00_SC_R_recv(m00_nodes_M_SC_R_RECV),
        .S00_SC_R_req(m00_nodes_M_SC_R_REQ),
        .S00_SC_R_send(m00_nodes_M_SC_R_SEND),
        .S00_SC_W_info(s00_nodes_M_SC_W_INFO),
        .S00_SC_W_payld(s00_nodes_M_SC_W_PAYLD),
        .S00_SC_W_recv(s00_nodes_M_SC_W_RECV),
        .S00_SC_W_req(s00_nodes_M_SC_W_REQ),
        .S00_SC_W_send(s00_nodes_M_SC_W_SEND),
        .S01_SC_AR_info(s01_nodes_M_SC_AR_INFO),
        .S01_SC_AR_payld(s01_nodes_M_SC_AR_PAYLD),
        .S01_SC_AR_recv(s01_nodes_M_SC_AR_RECV),
        .S01_SC_AR_req(s01_nodes_M_SC_AR_REQ),
        .S01_SC_AR_send(s01_nodes_M_SC_AR_SEND),
        .S01_SC_AW_info(1'b0),
        .S01_SC_AW_payld(1'b0),
        .S01_SC_AW_req(1'b0),
        .S01_SC_AW_send(1'b0),
        .S01_SC_W_info(1'b0),
        .S01_SC_W_payld(1'b0),
        .S01_SC_W_req(1'b0),
        .S01_SC_W_send(1'b0),
        .aclk(swbd_aclk_net),
        .aresetn(swbd_aresetn_net));
endmodule

module clk_map_imp_Y6LIBS
   (M00_ACLK,
    M00_ARESETN,
    S00_ACLK,
    S00_ARESETN,
    S01_ACLK,
    S01_ARESETN,
    aclk,
    aclk1,
    aresetn,
    aresetn_out,
    swbd_aclk,
    swbd_aresetn);
  output M00_ACLK;
  output [0:0]M00_ARESETN;
  output S00_ACLK;
  output [0:0]S00_ARESETN;
  output S01_ACLK;
  output [0:0]S01_ARESETN;
  input aclk;
  input aclk1;
  input aresetn;
  output aresetn_out;
  output swbd_aclk;
  output [0:0]swbd_aresetn;

  wire clk_map_aclk1_net;
  wire clk_map_aclk_net;
  wire clk_map_aresetn_net;
  wire [0:0]one_dout;
  wire [0:0]psr0_interconnect_aresetn;
  wire [0:0]psr_aclk1_interconnect_aresetn;
  wire [0:0]psr_aclk_interconnect_aresetn;

  assign M00_ACLK = clk_map_aclk1_net;
  assign M00_ARESETN[0] = psr_aclk1_interconnect_aresetn;
  assign S00_ACLK = clk_map_aclk_net;
  assign S00_ARESETN[0] = psr_aclk_interconnect_aresetn;
  assign S01_ACLK = clk_map_aclk_net;
  assign S01_ARESETN[0] = psr_aclk_interconnect_aresetn;
  assign clk_map_aclk1_net = aclk1;
  assign clk_map_aclk_net = aclk;
  assign clk_map_aresetn_net = aresetn;
  assign swbd_aclk = clk_map_aclk_net;
  assign swbd_aresetn[0] = psr_aclk_interconnect_aresetn;
  bd_cd63_one_0 one
       (.dout(one_dout));
  bd_cd63_psr0_0 psr0
       (.aux_reset_in(clk_map_aresetn_net),
        .dcm_locked(1'b1),
        .ext_reset_in(one_dout),
        .interconnect_aresetn(psr0_interconnect_aresetn),
        .mb_debug_sys_rst(1'b0),
        .slowest_sync_clk(clk_map_aclk1_net));
  bd_cd63_psr_aclk_0 psr_aclk
       (.aux_reset_in(clk_map_aresetn_net),
        .dcm_locked(1'b1),
        .ext_reset_in(psr0_interconnect_aresetn),
        .interconnect_aresetn(psr_aclk_interconnect_aresetn),
        .mb_debug_sys_rst(1'b0),
        .slowest_sync_clk(clk_map_aclk_net));
  bd_cd63_psr_aclk1_0 psr_aclk1
       (.aux_reset_in(clk_map_aresetn_net),
        .dcm_locked(1'b1),
        .ext_reset_in(psr0_interconnect_aresetn),
        .interconnect_aresetn(psr_aclk1_interconnect_aresetn),
        .mb_debug_sys_rst(1'b0),
        .slowest_sync_clk(clk_map_aclk1_net));
endmodule

module m00_exit_pipeline_imp_10IOOUR
   (aclk,
    aresetn,
    m_axi_araddr,
    m_axi_arburst,
    m_axi_arcache,
    m_axi_arlen,
    m_axi_arlock,
    m_axi_arprot,
    m_axi_arqos,
    m_axi_arready,
    m_axi_arsize,
    m_axi_arvalid,
    m_axi_awaddr,
    m_axi_awburst,
    m_axi_awcache,
    m_axi_awlen,
    m_axi_awlock,
    m_axi_awprot,
    m_axi_awqos,
    m_axi_awready,
    m_axi_awsize,
    m_axi_awvalid,
    m_axi_bready,
    m_axi_bresp,
    m_axi_bvalid,
    m_axi_rdata,
    m_axi_rlast,
    m_axi_rready,
    m_axi_rresp,
    m_axi_rvalid,
    m_axi_wdata,
    m_axi_wlast,
    m_axi_wready,
    m_axi_wstrb,
    m_axi_wvalid,
    s_axi_araddr,
    s_axi_arcache,
    s_axi_arid,
    s_axi_arlen,
    s_axi_arlock,
    s_axi_arprot,
    s_axi_arqos,
    s_axi_arready,
    s_axi_aruser,
    s_axi_arvalid,
    s_axi_awaddr,
    s_axi_awcache,
    s_axi_awid,
    s_axi_awlen,
    s_axi_awlock,
    s_axi_awprot,
    s_axi_awqos,
    s_axi_awready,
    s_axi_awuser,
    s_axi_awvalid,
    s_axi_bid,
    s_axi_bready,
    s_axi_bresp,
    s_axi_buser,
    s_axi_bvalid,
    s_axi_rdata,
    s_axi_rid,
    s_axi_rlast,
    s_axi_rready,
    s_axi_rresp,
    s_axi_ruser,
    s_axi_rvalid,
    s_axi_wdata,
    s_axi_wlast,
    s_axi_wready,
    s_axi_wstrb,
    s_axi_wuser,
    s_axi_wvalid);
  input aclk;
  input aresetn;
  output [28:0]m_axi_araddr;
  output [1:0]m_axi_arburst;
  output [3:0]m_axi_arcache;
  output [7:0]m_axi_arlen;
  output [0:0]m_axi_arlock;
  output [2:0]m_axi_arprot;
  output [3:0]m_axi_arqos;
  input m_axi_arready;
  output [2:0]m_axi_arsize;
  output m_axi_arvalid;
  output [28:0]m_axi_awaddr;
  output [1:0]m_axi_awburst;
  output [3:0]m_axi_awcache;
  output [7:0]m_axi_awlen;
  output [0:0]m_axi_awlock;
  output [2:0]m_axi_awprot;
  output [3:0]m_axi_awqos;
  input m_axi_awready;
  output [2:0]m_axi_awsize;
  output m_axi_awvalid;
  output m_axi_bready;
  input [1:0]m_axi_bresp;
  input m_axi_bvalid;
  input [31:0]m_axi_rdata;
  input m_axi_rlast;
  output m_axi_rready;
  input [1:0]m_axi_rresp;
  input m_axi_rvalid;
  output [31:0]m_axi_wdata;
  output m_axi_wlast;
  input m_axi_wready;
  output [3:0]m_axi_wstrb;
  output m_axi_wvalid;
  input [28:0]s_axi_araddr;
  input [3:0]s_axi_arcache;
  input [0:0]s_axi_arid;
  input [7:0]s_axi_arlen;
  input [0:0]s_axi_arlock;
  input [2:0]s_axi_arprot;
  input [3:0]s_axi_arqos;
  output s_axi_arready;
  input [1023:0]s_axi_aruser;
  input s_axi_arvalid;
  input [28:0]s_axi_awaddr;
  input [3:0]s_axi_awcache;
  input [0:0]s_axi_awid;
  input [7:0]s_axi_awlen;
  input [0:0]s_axi_awlock;
  input [2:0]s_axi_awprot;
  input [3:0]s_axi_awqos;
  output s_axi_awready;
  input [1023:0]s_axi_awuser;
  input s_axi_awvalid;
  output [0:0]s_axi_bid;
  input s_axi_bready;
  output [1:0]s_axi_bresp;
  output [1023:0]s_axi_buser;
  output s_axi_bvalid;
  output [31:0]s_axi_rdata;
  output [0:0]s_axi_rid;
  output s_axi_rlast;
  input s_axi_rready;
  output [1:0]s_axi_rresp;
  output [1023:0]s_axi_ruser;
  output s_axi_rvalid;
  input [31:0]s_axi_wdata;
  input s_axi_wlast;
  output s_axi_wready;
  input [3:0]s_axi_wstrb;
  input [1023:0]s_axi_wuser;
  input s_axi_wvalid;

  wire aclk_1;
  wire aresetn_1;
  wire [28:0]m00_exit_M_AXI_ARADDR;
  wire [1:0]m00_exit_M_AXI_ARBURST;
  wire [3:0]m00_exit_M_AXI_ARCACHE;
  wire [7:0]m00_exit_M_AXI_ARLEN;
  wire [0:0]m00_exit_M_AXI_ARLOCK;
  wire [2:0]m00_exit_M_AXI_ARPROT;
  wire [3:0]m00_exit_M_AXI_ARQOS;
  wire m00_exit_M_AXI_ARREADY;
  wire [2:0]m00_exit_M_AXI_ARSIZE;
  wire m00_exit_M_AXI_ARVALID;
  wire [28:0]m00_exit_M_AXI_AWADDR;
  wire [1:0]m00_exit_M_AXI_AWBURST;
  wire [3:0]m00_exit_M_AXI_AWCACHE;
  wire [7:0]m00_exit_M_AXI_AWLEN;
  wire [0:0]m00_exit_M_AXI_AWLOCK;
  wire [2:0]m00_exit_M_AXI_AWPROT;
  wire [3:0]m00_exit_M_AXI_AWQOS;
  wire m00_exit_M_AXI_AWREADY;
  wire [2:0]m00_exit_M_AXI_AWSIZE;
  wire m00_exit_M_AXI_AWVALID;
  wire m00_exit_M_AXI_BREADY;
  wire [1:0]m00_exit_M_AXI_BRESP;
  wire m00_exit_M_AXI_BVALID;
  wire [31:0]m00_exit_M_AXI_RDATA;
  wire m00_exit_M_AXI_RLAST;
  wire m00_exit_M_AXI_RREADY;
  wire [1:0]m00_exit_M_AXI_RRESP;
  wire m00_exit_M_AXI_RVALID;
  wire [31:0]m00_exit_M_AXI_WDATA;
  wire m00_exit_M_AXI_WLAST;
  wire m00_exit_M_AXI_WREADY;
  wire [3:0]m00_exit_M_AXI_WSTRB;
  wire m00_exit_M_AXI_WVALID;
  wire [28:0]s_axi_1_ARADDR;
  wire [3:0]s_axi_1_ARCACHE;
  wire [0:0]s_axi_1_ARID;
  wire [7:0]s_axi_1_ARLEN;
  wire [0:0]s_axi_1_ARLOCK;
  wire [2:0]s_axi_1_ARPROT;
  wire [3:0]s_axi_1_ARQOS;
  wire s_axi_1_ARREADY;
  wire [1023:0]s_axi_1_ARUSER;
  wire s_axi_1_ARVALID;
  wire [28:0]s_axi_1_AWADDR;
  wire [3:0]s_axi_1_AWCACHE;
  wire [0:0]s_axi_1_AWID;
  wire [7:0]s_axi_1_AWLEN;
  wire [0:0]s_axi_1_AWLOCK;
  wire [2:0]s_axi_1_AWPROT;
  wire [3:0]s_axi_1_AWQOS;
  wire s_axi_1_AWREADY;
  wire [1023:0]s_axi_1_AWUSER;
  wire s_axi_1_AWVALID;
  wire [0:0]s_axi_1_BID;
  wire s_axi_1_BREADY;
  wire [1:0]s_axi_1_BRESP;
  wire [1023:0]s_axi_1_BUSER;
  wire s_axi_1_BVALID;
  wire [31:0]s_axi_1_RDATA;
  wire [0:0]s_axi_1_RID;
  wire s_axi_1_RLAST;
  wire s_axi_1_RREADY;
  wire [1:0]s_axi_1_RRESP;
  wire [1023:0]s_axi_1_RUSER;
  wire s_axi_1_RVALID;
  wire [31:0]s_axi_1_WDATA;
  wire s_axi_1_WLAST;
  wire s_axi_1_WREADY;
  wire [3:0]s_axi_1_WSTRB;
  wire [1023:0]s_axi_1_WUSER;
  wire s_axi_1_WVALID;

  assign aclk_1 = aclk;
  assign aresetn_1 = aresetn;
  assign m00_exit_M_AXI_ARREADY = m_axi_arready;
  assign m00_exit_M_AXI_AWREADY = m_axi_awready;
  assign m00_exit_M_AXI_BRESP = m_axi_bresp[1:0];
  assign m00_exit_M_AXI_BVALID = m_axi_bvalid;
  assign m00_exit_M_AXI_RDATA = m_axi_rdata[31:0];
  assign m00_exit_M_AXI_RLAST = m_axi_rlast;
  assign m00_exit_M_AXI_RRESP = m_axi_rresp[1:0];
  assign m00_exit_M_AXI_RVALID = m_axi_rvalid;
  assign m00_exit_M_AXI_WREADY = m_axi_wready;
  assign m_axi_araddr[28:0] = m00_exit_M_AXI_ARADDR;
  assign m_axi_arburst[1:0] = m00_exit_M_AXI_ARBURST;
  assign m_axi_arcache[3:0] = m00_exit_M_AXI_ARCACHE;
  assign m_axi_arlen[7:0] = m00_exit_M_AXI_ARLEN;
  assign m_axi_arlock[0] = m00_exit_M_AXI_ARLOCK;
  assign m_axi_arprot[2:0] = m00_exit_M_AXI_ARPROT;
  assign m_axi_arqos[3:0] = m00_exit_M_AXI_ARQOS;
  assign m_axi_arsize[2:0] = m00_exit_M_AXI_ARSIZE;
  assign m_axi_arvalid = m00_exit_M_AXI_ARVALID;
  assign m_axi_awaddr[28:0] = m00_exit_M_AXI_AWADDR;
  assign m_axi_awburst[1:0] = m00_exit_M_AXI_AWBURST;
  assign m_axi_awcache[3:0] = m00_exit_M_AXI_AWCACHE;
  assign m_axi_awlen[7:0] = m00_exit_M_AXI_AWLEN;
  assign m_axi_awlock[0] = m00_exit_M_AXI_AWLOCK;
  assign m_axi_awprot[2:0] = m00_exit_M_AXI_AWPROT;
  assign m_axi_awqos[3:0] = m00_exit_M_AXI_AWQOS;
  assign m_axi_awsize[2:0] = m00_exit_M_AXI_AWSIZE;
  assign m_axi_awvalid = m00_exit_M_AXI_AWVALID;
  assign m_axi_bready = m00_exit_M_AXI_BREADY;
  assign m_axi_rready = m00_exit_M_AXI_RREADY;
  assign m_axi_wdata[31:0] = m00_exit_M_AXI_WDATA;
  assign m_axi_wlast = m00_exit_M_AXI_WLAST;
  assign m_axi_wstrb[3:0] = m00_exit_M_AXI_WSTRB;
  assign m_axi_wvalid = m00_exit_M_AXI_WVALID;
  assign s_axi_1_ARADDR = s_axi_araddr[28:0];
  assign s_axi_1_ARCACHE = s_axi_arcache[3:0];
  assign s_axi_1_ARID = s_axi_arid[0];
  assign s_axi_1_ARLEN = s_axi_arlen[7:0];
  assign s_axi_1_ARLOCK = s_axi_arlock[0];
  assign s_axi_1_ARPROT = s_axi_arprot[2:0];
  assign s_axi_1_ARQOS = s_axi_arqos[3:0];
  assign s_axi_1_ARUSER = s_axi_aruser[1023:0];
  assign s_axi_1_ARVALID = s_axi_arvalid;
  assign s_axi_1_AWADDR = s_axi_awaddr[28:0];
  assign s_axi_1_AWCACHE = s_axi_awcache[3:0];
  assign s_axi_1_AWID = s_axi_awid[0];
  assign s_axi_1_AWLEN = s_axi_awlen[7:0];
  assign s_axi_1_AWLOCK = s_axi_awlock[0];
  assign s_axi_1_AWPROT = s_axi_awprot[2:0];
  assign s_axi_1_AWQOS = s_axi_awqos[3:0];
  assign s_axi_1_AWUSER = s_axi_awuser[1023:0];
  assign s_axi_1_AWVALID = s_axi_awvalid;
  assign s_axi_1_BREADY = s_axi_bready;
  assign s_axi_1_RREADY = s_axi_rready;
  assign s_axi_1_WDATA = s_axi_wdata[31:0];
  assign s_axi_1_WLAST = s_axi_wlast;
  assign s_axi_1_WSTRB = s_axi_wstrb[3:0];
  assign s_axi_1_WUSER = s_axi_wuser[1023:0];
  assign s_axi_1_WVALID = s_axi_wvalid;
  assign s_axi_arready = s_axi_1_ARREADY;
  assign s_axi_awready = s_axi_1_AWREADY;
  assign s_axi_bid[0] = s_axi_1_BID;
  assign s_axi_bresp[1:0] = s_axi_1_BRESP;
  assign s_axi_buser[1023:0] = s_axi_1_BUSER;
  assign s_axi_bvalid = s_axi_1_BVALID;
  assign s_axi_rdata[31:0] = s_axi_1_RDATA;
  assign s_axi_rid[0] = s_axi_1_RID;
  assign s_axi_rlast = s_axi_1_RLAST;
  assign s_axi_rresp[1:0] = s_axi_1_RRESP;
  assign s_axi_ruser[1023:0] = s_axi_1_RUSER;
  assign s_axi_rvalid = s_axi_1_RVALID;
  assign s_axi_wready = s_axi_1_WREADY;
  bd_cd63_m00e_0 m00_exit
       (.aclk(aclk_1),
        .aresetn(aresetn_1),
        .m_axi_araddr(m00_exit_M_AXI_ARADDR),
        .m_axi_arburst(m00_exit_M_AXI_ARBURST),
        .m_axi_arcache(m00_exit_M_AXI_ARCACHE),
        .m_axi_arlen(m00_exit_M_AXI_ARLEN),
        .m_axi_arlock(m00_exit_M_AXI_ARLOCK),
        .m_axi_arprot(m00_exit_M_AXI_ARPROT),
        .m_axi_arqos(m00_exit_M_AXI_ARQOS),
        .m_axi_arready(m00_exit_M_AXI_ARREADY),
        .m_axi_arsize(m00_exit_M_AXI_ARSIZE),
        .m_axi_arvalid(m00_exit_M_AXI_ARVALID),
        .m_axi_awaddr(m00_exit_M_AXI_AWADDR),
        .m_axi_awburst(m00_exit_M_AXI_AWBURST),
        .m_axi_awcache(m00_exit_M_AXI_AWCACHE),
        .m_axi_awlen(m00_exit_M_AXI_AWLEN),
        .m_axi_awlock(m00_exit_M_AXI_AWLOCK),
        .m_axi_awprot(m00_exit_M_AXI_AWPROT),
        .m_axi_awqos(m00_exit_M_AXI_AWQOS),
        .m_axi_awready(m00_exit_M_AXI_AWREADY),
        .m_axi_awsize(m00_exit_M_AXI_AWSIZE),
        .m_axi_awvalid(m00_exit_M_AXI_AWVALID),
        .m_axi_bready(m00_exit_M_AXI_BREADY),
        .m_axi_bresp(m00_exit_M_AXI_BRESP),
        .m_axi_bvalid(m00_exit_M_AXI_BVALID),
        .m_axi_rdata(m00_exit_M_AXI_RDATA),
        .m_axi_rlast(m00_exit_M_AXI_RLAST),
        .m_axi_rready(m00_exit_M_AXI_RREADY),
        .m_axi_rresp(m00_exit_M_AXI_RRESP),
        .m_axi_rvalid(m00_exit_M_AXI_RVALID),
        .m_axi_wdata(m00_exit_M_AXI_WDATA),
        .m_axi_wlast(m00_exit_M_AXI_WLAST),
        .m_axi_wready(m00_exit_M_AXI_WREADY),
        .m_axi_wstrb(m00_exit_M_AXI_WSTRB),
        .m_axi_wvalid(m00_exit_M_AXI_WVALID),
        .s_axi_araddr(s_axi_1_ARADDR),
        .s_axi_arcache(s_axi_1_ARCACHE),
        .s_axi_arid(s_axi_1_ARID),
        .s_axi_arlen(s_axi_1_ARLEN),
        .s_axi_arlock(s_axi_1_ARLOCK),
        .s_axi_arprot(s_axi_1_ARPROT),
        .s_axi_arqos(s_axi_1_ARQOS),
        .s_axi_arready(s_axi_1_ARREADY),
        .s_axi_aruser(s_axi_1_ARUSER),
        .s_axi_arvalid(s_axi_1_ARVALID),
        .s_axi_awaddr(s_axi_1_AWADDR),
        .s_axi_awcache(s_axi_1_AWCACHE),
        .s_axi_awid(s_axi_1_AWID),
        .s_axi_awlen(s_axi_1_AWLEN),
        .s_axi_awlock(s_axi_1_AWLOCK),
        .s_axi_awprot(s_axi_1_AWPROT),
        .s_axi_awqos(s_axi_1_AWQOS),
        .s_axi_awready(s_axi_1_AWREADY),
        .s_axi_awuser(s_axi_1_AWUSER),
        .s_axi_awvalid(s_axi_1_AWVALID),
        .s_axi_bid(s_axi_1_BID),
        .s_axi_bready(s_axi_1_BREADY),
        .s_axi_bresp(s_axi_1_BRESP),
        .s_axi_buser(s_axi_1_BUSER),
        .s_axi_bvalid(s_axi_1_BVALID),
        .s_axi_rdata(s_axi_1_RDATA),
        .s_axi_rid(s_axi_1_RID),
        .s_axi_rlast(s_axi_1_RLAST),
        .s_axi_rready(s_axi_1_RREADY),
        .s_axi_rresp(s_axi_1_RRESP),
        .s_axi_ruser(s_axi_1_RUSER),
        .s_axi_rvalid(s_axi_1_RVALID),
        .s_axi_wdata(s_axi_1_WDATA),
        .s_axi_wlast(s_axi_1_WLAST),
        .s_axi_wready(s_axi_1_WREADY),
        .s_axi_wstrb(s_axi_1_WSTRB),
        .s_axi_wuser(s_axi_1_WUSER),
        .s_axi_wvalid(s_axi_1_WVALID));
endmodule

module m00_nodes_imp_1MQ73SV
   (M_SC_AR_info,
    M_SC_AR_payld,
    M_SC_AR_recv,
    M_SC_AR_req,
    M_SC_AR_send,
    M_SC_AW_info,
    M_SC_AW_payld,
    M_SC_AW_recv,
    M_SC_AW_req,
    M_SC_AW_send,
    M_SC_B_info,
    M_SC_B_payld,
    M_SC_B_recv,
    M_SC_B_req,
    M_SC_B_send,
    M_SC_R_info,
    M_SC_R_payld,
    M_SC_R_recv,
    M_SC_R_req,
    M_SC_R_send,
    M_SC_W_info,
    M_SC_W_payld,
    M_SC_W_recv,
    M_SC_W_req,
    M_SC_W_send,
    S_SC_AR_info,
    S_SC_AR_payld,
    S_SC_AR_recv,
    S_SC_AR_req,
    S_SC_AR_send,
    S_SC_AW_info,
    S_SC_AW_payld,
    S_SC_AW_recv,
    S_SC_AW_req,
    S_SC_AW_send,
    S_SC_B_info,
    S_SC_B_payld,
    S_SC_B_recv,
    S_SC_B_req,
    S_SC_B_send,
    S_SC_R_info,
    S_SC_R_payld,
    S_SC_R_recv,
    S_SC_R_req,
    S_SC_R_send,
    S_SC_W_info,
    S_SC_W_payld,
    S_SC_W_recv,
    S_SC_W_req,
    S_SC_W_send,
    m_axi_aclk,
    m_axi_aresetn,
    s_axi_aclk,
    s_axi_aresetn);
  output [0:0]M_SC_AR_info;
  output [137:0]M_SC_AR_payld;
  input [0:0]M_SC_AR_recv;
  output [0:0]M_SC_AR_req;
  output [0:0]M_SC_AR_send;
  output [0:0]M_SC_AW_info;
  output [137:0]M_SC_AW_payld;
  input [0:0]M_SC_AW_recv;
  output [0:0]M_SC_AW_req;
  output [0:0]M_SC_AW_send;
  output [1:0]M_SC_B_info;
  output [5:0]M_SC_B_payld;
  input [1:0]M_SC_B_recv;
  output [1:0]M_SC_B_req;
  output [1:0]M_SC_B_send;
  output [1:0]M_SC_R_info;
  output [51:0]M_SC_R_payld;
  input [1:0]M_SC_R_recv;
  output [1:0]M_SC_R_req;
  output [1:0]M_SC_R_send;
  output [0:0]M_SC_W_info;
  output [51:0]M_SC_W_payld;
  input [0:0]M_SC_W_recv;
  output [0:0]M_SC_W_req;
  output [0:0]M_SC_W_send;
  input [1:0]S_SC_AR_info;
  input [137:0]S_SC_AR_payld;
  output [1:0]S_SC_AR_recv;
  input [1:0]S_SC_AR_req;
  input [1:0]S_SC_AR_send;
  input [1:0]S_SC_AW_info;
  input [137:0]S_SC_AW_payld;
  output [1:0]S_SC_AW_recv;
  input [1:0]S_SC_AW_req;
  input [1:0]S_SC_AW_send;
  input [0:0]S_SC_B_info;
  input [5:0]S_SC_B_payld;
  output [0:0]S_SC_B_recv;
  input [0:0]S_SC_B_req;
  input [0:0]S_SC_B_send;
  input [0:0]S_SC_R_info;
  input [51:0]S_SC_R_payld;
  output [0:0]S_SC_R_recv;
  input [0:0]S_SC_R_req;
  input [0:0]S_SC_R_send;
  input [1:0]S_SC_W_info;
  input [51:0]S_SC_W_payld;
  output [1:0]S_SC_W_recv;
  input [1:0]S_SC_W_req;
  input [1:0]S_SC_W_send;
  input m_axi_aclk;
  input m_axi_aresetn;
  input s_axi_aclk;
  input s_axi_aresetn;

  wire [1:0]S_SC_AR_1_INFO;
  wire [137:0]S_SC_AR_1_PAYLD;
  wire [1:0]S_SC_AR_1_RECV;
  wire [1:0]S_SC_AR_1_REQ;
  wire [1:0]S_SC_AR_1_SEND;
  wire [1:0]S_SC_AW_1_INFO;
  wire [137:0]S_SC_AW_1_PAYLD;
  wire [1:0]S_SC_AW_1_RECV;
  wire [1:0]S_SC_AW_1_REQ;
  wire [1:0]S_SC_AW_1_SEND;
  wire [0:0]S_SC_B_1_INFO;
  wire [5:0]S_SC_B_1_PAYLD;
  wire [0:0]S_SC_B_1_RECV;
  wire [0:0]S_SC_B_1_REQ;
  wire [0:0]S_SC_B_1_SEND;
  wire [0:0]S_SC_R_1_INFO;
  wire [51:0]S_SC_R_1_PAYLD;
  wire [0:0]S_SC_R_1_RECV;
  wire [0:0]S_SC_R_1_REQ;
  wire [0:0]S_SC_R_1_SEND;
  wire [1:0]S_SC_W_1_INFO;
  wire [51:0]S_SC_W_1_PAYLD;
  wire [1:0]S_SC_W_1_RECV;
  wire [1:0]S_SC_W_1_REQ;
  wire [1:0]S_SC_W_1_SEND;
  wire [0:0]m00_ar_node_M_SC_INFO;
  wire [137:0]m00_ar_node_M_SC_PAYLD;
  wire [0:0]m00_ar_node_M_SC_RECV;
  wire [0:0]m00_ar_node_M_SC_REQ;
  wire [0:0]m00_ar_node_M_SC_SEND;
  wire [15:0]m00_aw_node_M_AXIS_ARB_TDATA;
  wire m00_aw_node_M_AXIS_ARB_TREADY;
  wire m00_aw_node_M_AXIS_ARB_TVALID;
  wire [0:0]m00_aw_node_M_SC_INFO;
  wire [137:0]m00_aw_node_M_SC_PAYLD;
  wire [0:0]m00_aw_node_M_SC_RECV;
  wire [0:0]m00_aw_node_M_SC_REQ;
  wire [0:0]m00_aw_node_M_SC_SEND;
  wire [1:0]m00_b_node_M_SC_INFO;
  wire [5:0]m00_b_node_M_SC_PAYLD;
  wire [1:0]m00_b_node_M_SC_RECV;
  wire [1:0]m00_b_node_M_SC_REQ;
  wire [1:0]m00_b_node_M_SC_SEND;
  wire [1:0]m00_r_node_M_SC_INFO;
  wire [51:0]m00_r_node_M_SC_PAYLD;
  wire [1:0]m00_r_node_M_SC_RECV;
  wire [1:0]m00_r_node_M_SC_REQ;
  wire [1:0]m00_r_node_M_SC_SEND;
  wire [0:0]m00_w_node_M_SC_INFO;
  wire [51:0]m00_w_node_M_SC_PAYLD;
  wire [0:0]m00_w_node_M_SC_RECV;
  wire [0:0]m00_w_node_M_SC_REQ;
  wire [0:0]m00_w_node_M_SC_SEND;
  wire m_axi_aclk_1;
  wire m_axi_aresetn_1;
  wire s_axi_aclk_1;
  wire s_axi_aresetn_1;

  assign M_SC_AR_info[0] = m00_ar_node_M_SC_INFO;
  assign M_SC_AR_payld[137:0] = m00_ar_node_M_SC_PAYLD;
  assign M_SC_AR_req[0] = m00_ar_node_M_SC_REQ;
  assign M_SC_AR_send[0] = m00_ar_node_M_SC_SEND;
  assign M_SC_AW_info[0] = m00_aw_node_M_SC_INFO;
  assign M_SC_AW_payld[137:0] = m00_aw_node_M_SC_PAYLD;
  assign M_SC_AW_req[0] = m00_aw_node_M_SC_REQ;
  assign M_SC_AW_send[0] = m00_aw_node_M_SC_SEND;
  assign M_SC_B_info[1:0] = m00_b_node_M_SC_INFO;
  assign M_SC_B_payld[5:0] = m00_b_node_M_SC_PAYLD;
  assign M_SC_B_req[1:0] = m00_b_node_M_SC_REQ;
  assign M_SC_B_send[1:0] = m00_b_node_M_SC_SEND;
  assign M_SC_R_info[1:0] = m00_r_node_M_SC_INFO;
  assign M_SC_R_payld[51:0] = m00_r_node_M_SC_PAYLD;
  assign M_SC_R_req[1:0] = m00_r_node_M_SC_REQ;
  assign M_SC_R_send[1:0] = m00_r_node_M_SC_SEND;
  assign M_SC_W_info[0] = m00_w_node_M_SC_INFO;
  assign M_SC_W_payld[51:0] = m00_w_node_M_SC_PAYLD;
  assign M_SC_W_req[0] = m00_w_node_M_SC_REQ;
  assign M_SC_W_send[0] = m00_w_node_M_SC_SEND;
  assign S_SC_AR_1_INFO = S_SC_AR_info[1:0];
  assign S_SC_AR_1_PAYLD = S_SC_AR_payld[137:0];
  assign S_SC_AR_1_REQ = S_SC_AR_req[1:0];
  assign S_SC_AR_1_SEND = S_SC_AR_send[1:0];
  assign S_SC_AR_recv[1:0] = S_SC_AR_1_RECV;
  assign S_SC_AW_1_INFO = S_SC_AW_info[1:0];
  assign S_SC_AW_1_PAYLD = S_SC_AW_payld[137:0];
  assign S_SC_AW_1_REQ = S_SC_AW_req[1:0];
  assign S_SC_AW_1_SEND = S_SC_AW_send[1:0];
  assign S_SC_AW_recv[1:0] = S_SC_AW_1_RECV;
  assign S_SC_B_1_INFO = S_SC_B_info[0];
  assign S_SC_B_1_PAYLD = S_SC_B_payld[5:0];
  assign S_SC_B_1_REQ = S_SC_B_req[0];
  assign S_SC_B_1_SEND = S_SC_B_send[0];
  assign S_SC_B_recv[0] = S_SC_B_1_RECV;
  assign S_SC_R_1_INFO = S_SC_R_info[0];
  assign S_SC_R_1_PAYLD = S_SC_R_payld[51:0];
  assign S_SC_R_1_REQ = S_SC_R_req[0];
  assign S_SC_R_1_SEND = S_SC_R_send[0];
  assign S_SC_R_recv[0] = S_SC_R_1_RECV;
  assign S_SC_W_1_INFO = S_SC_W_info[1:0];
  assign S_SC_W_1_PAYLD = S_SC_W_payld[51:0];
  assign S_SC_W_1_REQ = S_SC_W_req[1:0];
  assign S_SC_W_1_SEND = S_SC_W_send[1:0];
  assign S_SC_W_recv[1:0] = S_SC_W_1_RECV;
  assign m00_ar_node_M_SC_RECV = M_SC_AR_recv[0];
  assign m00_aw_node_M_SC_RECV = M_SC_AW_recv[0];
  assign m00_b_node_M_SC_RECV = M_SC_B_recv[1:0];
  assign m00_r_node_M_SC_RECV = M_SC_R_recv[1:0];
  assign m00_w_node_M_SC_RECV = M_SC_W_recv[0];
  assign m_axi_aclk_1 = m_axi_aclk;
  assign m_axi_aresetn_1 = m_axi_aresetn;
  assign s_axi_aclk_1 = s_axi_aclk;
  assign s_axi_aresetn_1 = s_axi_aresetn;
  bd_cd63_m00arn_0 m00_ar_node
       (.m_sc_aclk(m_axi_aclk_1),
        .m_sc_aresetn(m_axi_aresetn_1),
        .m_sc_info(m00_ar_node_M_SC_INFO),
        .m_sc_payld(m00_ar_node_M_SC_PAYLD),
        .m_sc_recv(m00_ar_node_M_SC_RECV),
        .m_sc_req(m00_ar_node_M_SC_REQ),
        .m_sc_send(m00_ar_node_M_SC_SEND),
        .s_sc_aclk(s_axi_aclk_1),
        .s_sc_aresetn(s_axi_aresetn_1),
        .s_sc_info(S_SC_AR_1_INFO),
        .s_sc_payld(S_SC_AR_1_PAYLD),
        .s_sc_recv(S_SC_AR_1_RECV),
        .s_sc_req(S_SC_AR_1_REQ),
        .s_sc_send(S_SC_AR_1_SEND));
  bd_cd63_m00awn_0 m00_aw_node
       (.m_axis_arb_tdata(m00_aw_node_M_AXIS_ARB_TDATA),
        .m_axis_arb_tready(m00_aw_node_M_AXIS_ARB_TREADY),
        .m_axis_arb_tvalid(m00_aw_node_M_AXIS_ARB_TVALID),
        .m_sc_aclk(m_axi_aclk_1),
        .m_sc_aresetn(m_axi_aresetn_1),
        .m_sc_info(m00_aw_node_M_SC_INFO),
        .m_sc_payld(m00_aw_node_M_SC_PAYLD),
        .m_sc_recv(m00_aw_node_M_SC_RECV),
        .m_sc_req(m00_aw_node_M_SC_REQ),
        .m_sc_send(m00_aw_node_M_SC_SEND),
        .s_sc_aclk(s_axi_aclk_1),
        .s_sc_aresetn(s_axi_aresetn_1),
        .s_sc_info(S_SC_AW_1_INFO),
        .s_sc_payld(S_SC_AW_1_PAYLD),
        .s_sc_recv(S_SC_AW_1_RECV),
        .s_sc_req(S_SC_AW_1_REQ),
        .s_sc_send(S_SC_AW_1_SEND));
  bd_cd63_m00bn_0 m00_b_node
       (.m_sc_aclk(s_axi_aclk_1),
        .m_sc_aresetn(s_axi_aresetn_1),
        .m_sc_info(m00_b_node_M_SC_INFO),
        .m_sc_payld(m00_b_node_M_SC_PAYLD),
        .m_sc_recv(m00_b_node_M_SC_RECV),
        .m_sc_req(m00_b_node_M_SC_REQ),
        .m_sc_send(m00_b_node_M_SC_SEND),
        .s_sc_aclk(m_axi_aclk_1),
        .s_sc_aresetn(m_axi_aresetn_1),
        .s_sc_info(S_SC_B_1_INFO),
        .s_sc_payld(S_SC_B_1_PAYLD),
        .s_sc_recv(S_SC_B_1_RECV),
        .s_sc_req(S_SC_B_1_REQ),
        .s_sc_send(S_SC_B_1_SEND));
  bd_cd63_m00rn_0 m00_r_node
       (.m_sc_aclk(s_axi_aclk_1),
        .m_sc_aresetn(s_axi_aresetn_1),
        .m_sc_info(m00_r_node_M_SC_INFO),
        .m_sc_payld(m00_r_node_M_SC_PAYLD),
        .m_sc_recv(m00_r_node_M_SC_RECV),
        .m_sc_req(m00_r_node_M_SC_REQ),
        .m_sc_send(m00_r_node_M_SC_SEND),
        .s_sc_aclk(m_axi_aclk_1),
        .s_sc_aresetn(m_axi_aresetn_1),
        .s_sc_info(S_SC_R_1_INFO),
        .s_sc_payld(S_SC_R_1_PAYLD),
        .s_sc_recv(S_SC_R_1_RECV),
        .s_sc_req(S_SC_R_1_REQ),
        .s_sc_send(S_SC_R_1_SEND));
  bd_cd63_m00wn_0 m00_w_node
       (.m_sc_aclk(m_axi_aclk_1),
        .m_sc_aresetn(m_axi_aresetn_1),
        .m_sc_info(m00_w_node_M_SC_INFO),
        .m_sc_payld(m00_w_node_M_SC_PAYLD),
        .m_sc_recv(m00_w_node_M_SC_RECV),
        .m_sc_req(m00_w_node_M_SC_REQ),
        .m_sc_send(m00_w_node_M_SC_SEND),
        .s_axis_arb_tdata(m00_aw_node_M_AXIS_ARB_TDATA),
        .s_axis_arb_tready(m00_aw_node_M_AXIS_ARB_TREADY),
        .s_axis_arb_tvalid(m00_aw_node_M_AXIS_ARB_TVALID),
        .s_sc_aclk(s_axi_aclk_1),
        .s_sc_aresetn(s_axi_aresetn_1),
        .s_sc_info(S_SC_W_1_INFO),
        .s_sc_payld(S_SC_W_1_PAYLD),
        .s_sc_recv(S_SC_W_1_RECV),
        .s_sc_req(S_SC_W_1_REQ),
        .s_sc_send(S_SC_W_1_SEND));
endmodule

module s00_entry_pipeline_imp_70YJ4
   (aclk,
    aresetn,
    m_axi_araddr,
    m_axi_arcache,
    m_axi_arid,
    m_axi_arlen,
    m_axi_arlock,
    m_axi_arprot,
    m_axi_arqos,
    m_axi_arready,
    m_axi_aruser,
    m_axi_arvalid,
    m_axi_awaddr,
    m_axi_awcache,
    m_axi_awid,
    m_axi_awlen,
    m_axi_awlock,
    m_axi_awprot,
    m_axi_awqos,
    m_axi_awready,
    m_axi_awuser,
    m_axi_awvalid,
    m_axi_bid,
    m_axi_bready,
    m_axi_bresp,
    m_axi_buser,
    m_axi_bvalid,
    m_axi_rdata,
    m_axi_rid,
    m_axi_rlast,
    m_axi_rready,
    m_axi_rresp,
    m_axi_ruser,
    m_axi_rvalid,
    m_axi_wdata,
    m_axi_wlast,
    m_axi_wready,
    m_axi_wstrb,
    m_axi_wuser,
    m_axi_wvalid,
    s_axi_araddr,
    s_axi_arburst,
    s_axi_arcache,
    s_axi_arlen,
    s_axi_arlock,
    s_axi_arprot,
    s_axi_arqos,
    s_axi_arready,
    s_axi_arsize,
    s_axi_arvalid,
    s_axi_awaddr,
    s_axi_awburst,
    s_axi_awcache,
    s_axi_awlen,
    s_axi_awlock,
    s_axi_awprot,
    s_axi_awqos,
    s_axi_awready,
    s_axi_awsize,
    s_axi_awvalid,
    s_axi_bready,
    s_axi_bresp,
    s_axi_bvalid,
    s_axi_rdata,
    s_axi_rlast,
    s_axi_rready,
    s_axi_rresp,
    s_axi_rvalid,
    s_axi_wdata,
    s_axi_wlast,
    s_axi_wready,
    s_axi_wstrb,
    s_axi_wvalid);
  input aclk;
  input aresetn;
  output [31:0]m_axi_araddr;
  output [3:0]m_axi_arcache;
  output [0:0]m_axi_arid;
  output [7:0]m_axi_arlen;
  output [0:0]m_axi_arlock;
  output [2:0]m_axi_arprot;
  output [3:0]m_axi_arqos;
  input m_axi_arready;
  output [1023:0]m_axi_aruser;
  output m_axi_arvalid;
  output [31:0]m_axi_awaddr;
  output [3:0]m_axi_awcache;
  output [0:0]m_axi_awid;
  output [7:0]m_axi_awlen;
  output [0:0]m_axi_awlock;
  output [2:0]m_axi_awprot;
  output [3:0]m_axi_awqos;
  input m_axi_awready;
  output [1023:0]m_axi_awuser;
  output m_axi_awvalid;
  input [0:0]m_axi_bid;
  output m_axi_bready;
  input [1:0]m_axi_bresp;
  input [1023:0]m_axi_buser;
  input m_axi_bvalid;
  input [31:0]m_axi_rdata;
  input [0:0]m_axi_rid;
  input m_axi_rlast;
  output m_axi_rready;
  input [1:0]m_axi_rresp;
  input [1023:0]m_axi_ruser;
  input m_axi_rvalid;
  output [31:0]m_axi_wdata;
  output m_axi_wlast;
  input m_axi_wready;
  output [3:0]m_axi_wstrb;
  output [1023:0]m_axi_wuser;
  output m_axi_wvalid;
  input [31:0]s_axi_araddr;
  input [1:0]s_axi_arburst;
  input [3:0]s_axi_arcache;
  input [7:0]s_axi_arlen;
  input [0:0]s_axi_arlock;
  input [2:0]s_axi_arprot;
  input [3:0]s_axi_arqos;
  output s_axi_arready;
  input [2:0]s_axi_arsize;
  input s_axi_arvalid;
  input [31:0]s_axi_awaddr;
  input [1:0]s_axi_awburst;
  input [3:0]s_axi_awcache;
  input [7:0]s_axi_awlen;
  input [0:0]s_axi_awlock;
  input [2:0]s_axi_awprot;
  input [3:0]s_axi_awqos;
  output s_axi_awready;
  input [2:0]s_axi_awsize;
  input s_axi_awvalid;
  input s_axi_bready;
  output [1:0]s_axi_bresp;
  output s_axi_bvalid;
  output [31:0]s_axi_rdata;
  output s_axi_rlast;
  input s_axi_rready;
  output [1:0]s_axi_rresp;
  output s_axi_rvalid;
  input [31:0]s_axi_wdata;
  input s_axi_wlast;
  output s_axi_wready;
  input [3:0]s_axi_wstrb;
  input s_axi_wvalid;

  wire aclk_1;
  wire aresetn_1;
  wire [31:0]s00_mmu_M_AXI_ARADDR;
  wire [1:0]s00_mmu_M_AXI_ARBURST;
  wire [3:0]s00_mmu_M_AXI_ARCACHE;
  wire [7:0]s00_mmu_M_AXI_ARLEN;
  wire [0:0]s00_mmu_M_AXI_ARLOCK;
  wire [2:0]s00_mmu_M_AXI_ARPROT;
  wire [3:0]s00_mmu_M_AXI_ARQOS;
  wire s00_mmu_M_AXI_ARREADY;
  wire [2:0]s00_mmu_M_AXI_ARSIZE;
  wire [1023:0]s00_mmu_M_AXI_ARUSER;
  wire s00_mmu_M_AXI_ARVALID;
  wire [31:0]s00_mmu_M_AXI_AWADDR;
  wire [1:0]s00_mmu_M_AXI_AWBURST;
  wire [3:0]s00_mmu_M_AXI_AWCACHE;
  wire [7:0]s00_mmu_M_AXI_AWLEN;
  wire [0:0]s00_mmu_M_AXI_AWLOCK;
  wire [2:0]s00_mmu_M_AXI_AWPROT;
  wire [3:0]s00_mmu_M_AXI_AWQOS;
  wire s00_mmu_M_AXI_AWREADY;
  wire [2:0]s00_mmu_M_AXI_AWSIZE;
  wire [1023:0]s00_mmu_M_AXI_AWUSER;
  wire s00_mmu_M_AXI_AWVALID;
  wire s00_mmu_M_AXI_BREADY;
  wire [1:0]s00_mmu_M_AXI_BRESP;
  wire [1023:0]s00_mmu_M_AXI_BUSER;
  wire s00_mmu_M_AXI_BVALID;
  wire [31:0]s00_mmu_M_AXI_RDATA;
  wire s00_mmu_M_AXI_RLAST;
  wire s00_mmu_M_AXI_RREADY;
  wire [1:0]s00_mmu_M_AXI_RRESP;
  wire [1023:0]s00_mmu_M_AXI_RUSER;
  wire s00_mmu_M_AXI_RVALID;
  wire [31:0]s00_mmu_M_AXI_WDATA;
  wire s00_mmu_M_AXI_WLAST;
  wire s00_mmu_M_AXI_WREADY;
  wire [3:0]s00_mmu_M_AXI_WSTRB;
  wire [1023:0]s00_mmu_M_AXI_WUSER;
  wire s00_mmu_M_AXI_WVALID;
  wire [31:0]s00_si_converter_M_AXI_ARADDR;
  wire [3:0]s00_si_converter_M_AXI_ARCACHE;
  wire [0:0]s00_si_converter_M_AXI_ARID;
  wire [7:0]s00_si_converter_M_AXI_ARLEN;
  wire [0:0]s00_si_converter_M_AXI_ARLOCK;
  wire [2:0]s00_si_converter_M_AXI_ARPROT;
  wire [3:0]s00_si_converter_M_AXI_ARQOS;
  wire s00_si_converter_M_AXI_ARREADY;
  wire [1023:0]s00_si_converter_M_AXI_ARUSER;
  wire s00_si_converter_M_AXI_ARVALID;
  wire [31:0]s00_si_converter_M_AXI_AWADDR;
  wire [3:0]s00_si_converter_M_AXI_AWCACHE;
  wire [0:0]s00_si_converter_M_AXI_AWID;
  wire [7:0]s00_si_converter_M_AXI_AWLEN;
  wire [0:0]s00_si_converter_M_AXI_AWLOCK;
  wire [2:0]s00_si_converter_M_AXI_AWPROT;
  wire [3:0]s00_si_converter_M_AXI_AWQOS;
  wire s00_si_converter_M_AXI_AWREADY;
  wire [1023:0]s00_si_converter_M_AXI_AWUSER;
  wire s00_si_converter_M_AXI_AWVALID;
  wire [0:0]s00_si_converter_M_AXI_BID;
  wire s00_si_converter_M_AXI_BREADY;
  wire [1:0]s00_si_converter_M_AXI_BRESP;
  wire [1023:0]s00_si_converter_M_AXI_BUSER;
  wire s00_si_converter_M_AXI_BVALID;
  wire [31:0]s00_si_converter_M_AXI_RDATA;
  wire [0:0]s00_si_converter_M_AXI_RID;
  wire s00_si_converter_M_AXI_RLAST;
  wire s00_si_converter_M_AXI_RREADY;
  wire [1:0]s00_si_converter_M_AXI_RRESP;
  wire [1023:0]s00_si_converter_M_AXI_RUSER;
  wire s00_si_converter_M_AXI_RVALID;
  wire [31:0]s00_si_converter_M_AXI_WDATA;
  wire s00_si_converter_M_AXI_WLAST;
  wire s00_si_converter_M_AXI_WREADY;
  wire [3:0]s00_si_converter_M_AXI_WSTRB;
  wire [1023:0]s00_si_converter_M_AXI_WUSER;
  wire s00_si_converter_M_AXI_WVALID;
  wire [31:0]s00_transaction_regulator_M_AXI_ARADDR;
  wire [1:0]s00_transaction_regulator_M_AXI_ARBURST;
  wire [3:0]s00_transaction_regulator_M_AXI_ARCACHE;
  wire [0:0]s00_transaction_regulator_M_AXI_ARID;
  wire [7:0]s00_transaction_regulator_M_AXI_ARLEN;
  wire [0:0]s00_transaction_regulator_M_AXI_ARLOCK;
  wire [2:0]s00_transaction_regulator_M_AXI_ARPROT;
  wire [3:0]s00_transaction_regulator_M_AXI_ARQOS;
  wire s00_transaction_regulator_M_AXI_ARREADY;
  wire [2:0]s00_transaction_regulator_M_AXI_ARSIZE;
  wire [1023:0]s00_transaction_regulator_M_AXI_ARUSER;
  wire s00_transaction_regulator_M_AXI_ARVALID;
  wire [31:0]s00_transaction_regulator_M_AXI_AWADDR;
  wire [1:0]s00_transaction_regulator_M_AXI_AWBURST;
  wire [3:0]s00_transaction_regulator_M_AXI_AWCACHE;
  wire [0:0]s00_transaction_regulator_M_AXI_AWID;
  wire [7:0]s00_transaction_regulator_M_AXI_AWLEN;
  wire [0:0]s00_transaction_regulator_M_AXI_AWLOCK;
  wire [2:0]s00_transaction_regulator_M_AXI_AWPROT;
  wire [3:0]s00_transaction_regulator_M_AXI_AWQOS;
  wire s00_transaction_regulator_M_AXI_AWREADY;
  wire [2:0]s00_transaction_regulator_M_AXI_AWSIZE;
  wire [1023:0]s00_transaction_regulator_M_AXI_AWUSER;
  wire s00_transaction_regulator_M_AXI_AWVALID;
  wire [0:0]s00_transaction_regulator_M_AXI_BID;
  wire s00_transaction_regulator_M_AXI_BREADY;
  wire [1:0]s00_transaction_regulator_M_AXI_BRESP;
  wire [1023:0]s00_transaction_regulator_M_AXI_BUSER;
  wire s00_transaction_regulator_M_AXI_BVALID;
  wire [31:0]s00_transaction_regulator_M_AXI_RDATA;
  wire [0:0]s00_transaction_regulator_M_AXI_RID;
  wire s00_transaction_regulator_M_AXI_RLAST;
  wire s00_transaction_regulator_M_AXI_RREADY;
  wire [1:0]s00_transaction_regulator_M_AXI_RRESP;
  wire [1023:0]s00_transaction_regulator_M_AXI_RUSER;
  wire s00_transaction_regulator_M_AXI_RVALID;
  wire [31:0]s00_transaction_regulator_M_AXI_WDATA;
  wire s00_transaction_regulator_M_AXI_WLAST;
  wire s00_transaction_regulator_M_AXI_WREADY;
  wire [3:0]s00_transaction_regulator_M_AXI_WSTRB;
  wire [1023:0]s00_transaction_regulator_M_AXI_WUSER;
  wire s00_transaction_regulator_M_AXI_WVALID;
  wire [31:0]s_axi_1_ARADDR;
  wire [1:0]s_axi_1_ARBURST;
  wire [3:0]s_axi_1_ARCACHE;
  wire [7:0]s_axi_1_ARLEN;
  wire [0:0]s_axi_1_ARLOCK;
  wire [2:0]s_axi_1_ARPROT;
  wire [3:0]s_axi_1_ARQOS;
  wire s_axi_1_ARREADY;
  wire [2:0]s_axi_1_ARSIZE;
  wire s_axi_1_ARVALID;
  wire [31:0]s_axi_1_AWADDR;
  wire [1:0]s_axi_1_AWBURST;
  wire [3:0]s_axi_1_AWCACHE;
  wire [7:0]s_axi_1_AWLEN;
  wire [0:0]s_axi_1_AWLOCK;
  wire [2:0]s_axi_1_AWPROT;
  wire [3:0]s_axi_1_AWQOS;
  wire s_axi_1_AWREADY;
  wire [2:0]s_axi_1_AWSIZE;
  wire s_axi_1_AWVALID;
  wire s_axi_1_BREADY;
  wire [1:0]s_axi_1_BRESP;
  wire s_axi_1_BVALID;
  wire [31:0]s_axi_1_RDATA;
  wire s_axi_1_RLAST;
  wire s_axi_1_RREADY;
  wire [1:0]s_axi_1_RRESP;
  wire s_axi_1_RVALID;
  wire [31:0]s_axi_1_WDATA;
  wire s_axi_1_WLAST;
  wire s_axi_1_WREADY;
  wire [3:0]s_axi_1_WSTRB;
  wire s_axi_1_WVALID;

  assign aclk_1 = aclk;
  assign aresetn_1 = aresetn;
  assign m_axi_araddr[31:0] = s00_si_converter_M_AXI_ARADDR;
  assign m_axi_arcache[3:0] = s00_si_converter_M_AXI_ARCACHE;
  assign m_axi_arid[0] = s00_si_converter_M_AXI_ARID;
  assign m_axi_arlen[7:0] = s00_si_converter_M_AXI_ARLEN;
  assign m_axi_arlock[0] = s00_si_converter_M_AXI_ARLOCK;
  assign m_axi_arprot[2:0] = s00_si_converter_M_AXI_ARPROT;
  assign m_axi_arqos[3:0] = s00_si_converter_M_AXI_ARQOS;
  assign m_axi_aruser[1023:0] = s00_si_converter_M_AXI_ARUSER;
  assign m_axi_arvalid = s00_si_converter_M_AXI_ARVALID;
  assign m_axi_awaddr[31:0] = s00_si_converter_M_AXI_AWADDR;
  assign m_axi_awcache[3:0] = s00_si_converter_M_AXI_AWCACHE;
  assign m_axi_awid[0] = s00_si_converter_M_AXI_AWID;
  assign m_axi_awlen[7:0] = s00_si_converter_M_AXI_AWLEN;
  assign m_axi_awlock[0] = s00_si_converter_M_AXI_AWLOCK;
  assign m_axi_awprot[2:0] = s00_si_converter_M_AXI_AWPROT;
  assign m_axi_awqos[3:0] = s00_si_converter_M_AXI_AWQOS;
  assign m_axi_awuser[1023:0] = s00_si_converter_M_AXI_AWUSER;
  assign m_axi_awvalid = s00_si_converter_M_AXI_AWVALID;
  assign m_axi_bready = s00_si_converter_M_AXI_BREADY;
  assign m_axi_rready = s00_si_converter_M_AXI_RREADY;
  assign m_axi_wdata[31:0] = s00_si_converter_M_AXI_WDATA;
  assign m_axi_wlast = s00_si_converter_M_AXI_WLAST;
  assign m_axi_wstrb[3:0] = s00_si_converter_M_AXI_WSTRB;
  assign m_axi_wuser[1023:0] = s00_si_converter_M_AXI_WUSER;
  assign m_axi_wvalid = s00_si_converter_M_AXI_WVALID;
  assign s00_si_converter_M_AXI_ARREADY = m_axi_arready;
  assign s00_si_converter_M_AXI_AWREADY = m_axi_awready;
  assign s00_si_converter_M_AXI_BID = m_axi_bid[0];
  assign s00_si_converter_M_AXI_BRESP = m_axi_bresp[1:0];
  assign s00_si_converter_M_AXI_BUSER = m_axi_buser[1023:0];
  assign s00_si_converter_M_AXI_BVALID = m_axi_bvalid;
  assign s00_si_converter_M_AXI_RDATA = m_axi_rdata[31:0];
  assign s00_si_converter_M_AXI_RID = m_axi_rid[0];
  assign s00_si_converter_M_AXI_RLAST = m_axi_rlast;
  assign s00_si_converter_M_AXI_RRESP = m_axi_rresp[1:0];
  assign s00_si_converter_M_AXI_RUSER = m_axi_ruser[1023:0];
  assign s00_si_converter_M_AXI_RVALID = m_axi_rvalid;
  assign s00_si_converter_M_AXI_WREADY = m_axi_wready;
  assign s_axi_1_ARADDR = s_axi_araddr[31:0];
  assign s_axi_1_ARBURST = s_axi_arburst[1:0];
  assign s_axi_1_ARCACHE = s_axi_arcache[3:0];
  assign s_axi_1_ARLEN = s_axi_arlen[7:0];
  assign s_axi_1_ARLOCK = s_axi_arlock[0];
  assign s_axi_1_ARPROT = s_axi_arprot[2:0];
  assign s_axi_1_ARQOS = s_axi_arqos[3:0];
  assign s_axi_1_ARSIZE = s_axi_arsize[2:0];
  assign s_axi_1_ARVALID = s_axi_arvalid;
  assign s_axi_1_AWADDR = s_axi_awaddr[31:0];
  assign s_axi_1_AWBURST = s_axi_awburst[1:0];
  assign s_axi_1_AWCACHE = s_axi_awcache[3:0];
  assign s_axi_1_AWLEN = s_axi_awlen[7:0];
  assign s_axi_1_AWLOCK = s_axi_awlock[0];
  assign s_axi_1_AWPROT = s_axi_awprot[2:0];
  assign s_axi_1_AWQOS = s_axi_awqos[3:0];
  assign s_axi_1_AWSIZE = s_axi_awsize[2:0];
  assign s_axi_1_AWVALID = s_axi_awvalid;
  assign s_axi_1_BREADY = s_axi_bready;
  assign s_axi_1_RREADY = s_axi_rready;
  assign s_axi_1_WDATA = s_axi_wdata[31:0];
  assign s_axi_1_WLAST = s_axi_wlast;
  assign s_axi_1_WSTRB = s_axi_wstrb[3:0];
  assign s_axi_1_WVALID = s_axi_wvalid;
  assign s_axi_arready = s_axi_1_ARREADY;
  assign s_axi_awready = s_axi_1_AWREADY;
  assign s_axi_bresp[1:0] = s_axi_1_BRESP;
  assign s_axi_bvalid = s_axi_1_BVALID;
  assign s_axi_rdata[31:0] = s_axi_1_RDATA;
  assign s_axi_rlast = s_axi_1_RLAST;
  assign s_axi_rresp[1:0] = s_axi_1_RRESP;
  assign s_axi_rvalid = s_axi_1_RVALID;
  assign s_axi_wready = s_axi_1_WREADY;
  bd_cd63_s00mmu_0 s00_mmu
       (.aclk(aclk_1),
        .aresetn(aresetn_1),
        .m_axi_araddr(s00_mmu_M_AXI_ARADDR),
        .m_axi_arburst(s00_mmu_M_AXI_ARBURST),
        .m_axi_arcache(s00_mmu_M_AXI_ARCACHE),
        .m_axi_arlen(s00_mmu_M_AXI_ARLEN),
        .m_axi_arlock(s00_mmu_M_AXI_ARLOCK),
        .m_axi_arprot(s00_mmu_M_AXI_ARPROT),
        .m_axi_arqos(s00_mmu_M_AXI_ARQOS),
        .m_axi_arready(s00_mmu_M_AXI_ARREADY),
        .m_axi_arsize(s00_mmu_M_AXI_ARSIZE),
        .m_axi_aruser(s00_mmu_M_AXI_ARUSER),
        .m_axi_arvalid(s00_mmu_M_AXI_ARVALID),
        .m_axi_awaddr(s00_mmu_M_AXI_AWADDR),
        .m_axi_awburst(s00_mmu_M_AXI_AWBURST),
        .m_axi_awcache(s00_mmu_M_AXI_AWCACHE),
        .m_axi_awlen(s00_mmu_M_AXI_AWLEN),
        .m_axi_awlock(s00_mmu_M_AXI_AWLOCK),
        .m_axi_awprot(s00_mmu_M_AXI_AWPROT),
        .m_axi_awqos(s00_mmu_M_AXI_AWQOS),
        .m_axi_awready(s00_mmu_M_AXI_AWREADY),
        .m_axi_awsize(s00_mmu_M_AXI_AWSIZE),
        .m_axi_awuser(s00_mmu_M_AXI_AWUSER),
        .m_axi_awvalid(s00_mmu_M_AXI_AWVALID),
        .m_axi_bready(s00_mmu_M_AXI_BREADY),
        .m_axi_bresp(s00_mmu_M_AXI_BRESP),
        .m_axi_buser(s00_mmu_M_AXI_BUSER),
        .m_axi_bvalid(s00_mmu_M_AXI_BVALID),
        .m_axi_rdata(s00_mmu_M_AXI_RDATA),
        .m_axi_rlast(s00_mmu_M_AXI_RLAST),
        .m_axi_rready(s00_mmu_M_AXI_RREADY),
        .m_axi_rresp(s00_mmu_M_AXI_RRESP),
        .m_axi_ruser(s00_mmu_M_AXI_RUSER),
        .m_axi_rvalid(s00_mmu_M_AXI_RVALID),
        .m_axi_wdata(s00_mmu_M_AXI_WDATA),
        .m_axi_wlast(s00_mmu_M_AXI_WLAST),
        .m_axi_wready(s00_mmu_M_AXI_WREADY),
        .m_axi_wstrb(s00_mmu_M_AXI_WSTRB),
        .m_axi_wuser(s00_mmu_M_AXI_WUSER),
        .m_axi_wvalid(s00_mmu_M_AXI_WVALID),
        .s_axi_araddr(s_axi_1_ARADDR),
        .s_axi_arburst(s_axi_1_ARBURST),
        .s_axi_arcache(s_axi_1_ARCACHE),
        .s_axi_arlen(s_axi_1_ARLEN),
        .s_axi_arlock(s_axi_1_ARLOCK),
        .s_axi_arprot(s_axi_1_ARPROT),
        .s_axi_arqos(s_axi_1_ARQOS),
        .s_axi_arready(s_axi_1_ARREADY),
        .s_axi_arsize(s_axi_1_ARSIZE),
        .s_axi_arvalid(s_axi_1_ARVALID),
        .s_axi_awaddr(s_axi_1_AWADDR),
        .s_axi_awburst(s_axi_1_AWBURST),
        .s_axi_awcache(s_axi_1_AWCACHE),
        .s_axi_awlen(s_axi_1_AWLEN),
        .s_axi_awlock(s_axi_1_AWLOCK),
        .s_axi_awprot(s_axi_1_AWPROT),
        .s_axi_awqos(s_axi_1_AWQOS),
        .s_axi_awready(s_axi_1_AWREADY),
        .s_axi_awsize(s_axi_1_AWSIZE),
        .s_axi_awvalid(s_axi_1_AWVALID),
        .s_axi_bready(s_axi_1_BREADY),
        .s_axi_bresp(s_axi_1_BRESP),
        .s_axi_bvalid(s_axi_1_BVALID),
        .s_axi_rdata(s_axi_1_RDATA),
        .s_axi_rlast(s_axi_1_RLAST),
        .s_axi_rready(s_axi_1_RREADY),
        .s_axi_rresp(s_axi_1_RRESP),
        .s_axi_rvalid(s_axi_1_RVALID),
        .s_axi_wdata(s_axi_1_WDATA),
        .s_axi_wlast(s_axi_1_WLAST),
        .s_axi_wready(s_axi_1_WREADY),
        .s_axi_wstrb(s_axi_1_WSTRB),
        .s_axi_wvalid(s_axi_1_WVALID));
  bd_cd63_s00sic_0 s00_si_converter
       (.aclk(aclk_1),
        .aresetn(aresetn_1),
        .m_axi_araddr(s00_si_converter_M_AXI_ARADDR),
        .m_axi_arcache(s00_si_converter_M_AXI_ARCACHE),
        .m_axi_arid(s00_si_converter_M_AXI_ARID),
        .m_axi_arlen(s00_si_converter_M_AXI_ARLEN),
        .m_axi_arlock(s00_si_converter_M_AXI_ARLOCK),
        .m_axi_arprot(s00_si_converter_M_AXI_ARPROT),
        .m_axi_arqos(s00_si_converter_M_AXI_ARQOS),
        .m_axi_arready(s00_si_converter_M_AXI_ARREADY),
        .m_axi_aruser(s00_si_converter_M_AXI_ARUSER),
        .m_axi_arvalid(s00_si_converter_M_AXI_ARVALID),
        .m_axi_awaddr(s00_si_converter_M_AXI_AWADDR),
        .m_axi_awcache(s00_si_converter_M_AXI_AWCACHE),
        .m_axi_awid(s00_si_converter_M_AXI_AWID),
        .m_axi_awlen(s00_si_converter_M_AXI_AWLEN),
        .m_axi_awlock(s00_si_converter_M_AXI_AWLOCK),
        .m_axi_awprot(s00_si_converter_M_AXI_AWPROT),
        .m_axi_awqos(s00_si_converter_M_AXI_AWQOS),
        .m_axi_awready(s00_si_converter_M_AXI_AWREADY),
        .m_axi_awuser(s00_si_converter_M_AXI_AWUSER),
        .m_axi_awvalid(s00_si_converter_M_AXI_AWVALID),
        .m_axi_bid(s00_si_converter_M_AXI_BID),
        .m_axi_bready(s00_si_converter_M_AXI_BREADY),
        .m_axi_bresp(s00_si_converter_M_AXI_BRESP),
        .m_axi_buser(s00_si_converter_M_AXI_BUSER),
        .m_axi_bvalid(s00_si_converter_M_AXI_BVALID),
        .m_axi_rdata(s00_si_converter_M_AXI_RDATA),
        .m_axi_rid(s00_si_converter_M_AXI_RID),
        .m_axi_rlast(s00_si_converter_M_AXI_RLAST),
        .m_axi_rready(s00_si_converter_M_AXI_RREADY),
        .m_axi_rresp(s00_si_converter_M_AXI_RRESP),
        .m_axi_ruser(s00_si_converter_M_AXI_RUSER),
        .m_axi_rvalid(s00_si_converter_M_AXI_RVALID),
        .m_axi_wdata(s00_si_converter_M_AXI_WDATA),
        .m_axi_wlast(s00_si_converter_M_AXI_WLAST),
        .m_axi_wready(s00_si_converter_M_AXI_WREADY),
        .m_axi_wstrb(s00_si_converter_M_AXI_WSTRB),
        .m_axi_wuser(s00_si_converter_M_AXI_WUSER),
        .m_axi_wvalid(s00_si_converter_M_AXI_WVALID),
        .s_axi_araddr(s00_transaction_regulator_M_AXI_ARADDR),
        .s_axi_arburst(s00_transaction_regulator_M_AXI_ARBURST),
        .s_axi_arcache(s00_transaction_regulator_M_AXI_ARCACHE),
        .s_axi_arid(s00_transaction_regulator_M_AXI_ARID),
        .s_axi_arlen(s00_transaction_regulator_M_AXI_ARLEN),
        .s_axi_arlock(s00_transaction_regulator_M_AXI_ARLOCK),
        .s_axi_arprot(s00_transaction_regulator_M_AXI_ARPROT),
        .s_axi_arqos(s00_transaction_regulator_M_AXI_ARQOS),
        .s_axi_arready(s00_transaction_regulator_M_AXI_ARREADY),
        .s_axi_arsize(s00_transaction_regulator_M_AXI_ARSIZE),
        .s_axi_aruser(s00_transaction_regulator_M_AXI_ARUSER),
        .s_axi_arvalid(s00_transaction_regulator_M_AXI_ARVALID),
        .s_axi_awaddr(s00_transaction_regulator_M_AXI_AWADDR),
        .s_axi_awburst(s00_transaction_regulator_M_AXI_AWBURST),
        .s_axi_awcache(s00_transaction_regulator_M_AXI_AWCACHE),
        .s_axi_awid(s00_transaction_regulator_M_AXI_AWID),
        .s_axi_awlen(s00_transaction_regulator_M_AXI_AWLEN),
        .s_axi_awlock(s00_transaction_regulator_M_AXI_AWLOCK),
        .s_axi_awprot(s00_transaction_regulator_M_AXI_AWPROT),
        .s_axi_awqos(s00_transaction_regulator_M_AXI_AWQOS),
        .s_axi_awready(s00_transaction_regulator_M_AXI_AWREADY),
        .s_axi_awsize(s00_transaction_regulator_M_AXI_AWSIZE),
        .s_axi_awuser(s00_transaction_regulator_M_AXI_AWUSER),
        .s_axi_awvalid(s00_transaction_regulator_M_AXI_AWVALID),
        .s_axi_bid(s00_transaction_regulator_M_AXI_BID),
        .s_axi_bready(s00_transaction_regulator_M_AXI_BREADY),
        .s_axi_bresp(s00_transaction_regulator_M_AXI_BRESP),
        .s_axi_buser(s00_transaction_regulator_M_AXI_BUSER),
        .s_axi_bvalid(s00_transaction_regulator_M_AXI_BVALID),
        .s_axi_rdata(s00_transaction_regulator_M_AXI_RDATA),
        .s_axi_rid(s00_transaction_regulator_M_AXI_RID),
        .s_axi_rlast(s00_transaction_regulator_M_AXI_RLAST),
        .s_axi_rready(s00_transaction_regulator_M_AXI_RREADY),
        .s_axi_rresp(s00_transaction_regulator_M_AXI_RRESP),
        .s_axi_ruser(s00_transaction_regulator_M_AXI_RUSER),
        .s_axi_rvalid(s00_transaction_regulator_M_AXI_RVALID),
        .s_axi_wdata(s00_transaction_regulator_M_AXI_WDATA),
        .s_axi_wlast(s00_transaction_regulator_M_AXI_WLAST),
        .s_axi_wready(s00_transaction_regulator_M_AXI_WREADY),
        .s_axi_wstrb(s00_transaction_regulator_M_AXI_WSTRB),
        .s_axi_wuser(s00_transaction_regulator_M_AXI_WUSER),
        .s_axi_wvalid(s00_transaction_regulator_M_AXI_WVALID));
  bd_cd63_s00tr_0 s00_transaction_regulator
       (.aclk(aclk_1),
        .aresetn(aresetn_1),
        .m_axi_araddr(s00_transaction_regulator_M_AXI_ARADDR),
        .m_axi_arburst(s00_transaction_regulator_M_AXI_ARBURST),
        .m_axi_arcache(s00_transaction_regulator_M_AXI_ARCACHE),
        .m_axi_arid(s00_transaction_regulator_M_AXI_ARID),
        .m_axi_arlen(s00_transaction_regulator_M_AXI_ARLEN),
        .m_axi_arlock(s00_transaction_regulator_M_AXI_ARLOCK),
        .m_axi_arprot(s00_transaction_regulator_M_AXI_ARPROT),
        .m_axi_arqos(s00_transaction_regulator_M_AXI_ARQOS),
        .m_axi_arready(s00_transaction_regulator_M_AXI_ARREADY),
        .m_axi_arsize(s00_transaction_regulator_M_AXI_ARSIZE),
        .m_axi_aruser(s00_transaction_regulator_M_AXI_ARUSER),
        .m_axi_arvalid(s00_transaction_regulator_M_AXI_ARVALID),
        .m_axi_awaddr(s00_transaction_regulator_M_AXI_AWADDR),
        .m_axi_awburst(s00_transaction_regulator_M_AXI_AWBURST),
        .m_axi_awcache(s00_transaction_regulator_M_AXI_AWCACHE),
        .m_axi_awid(s00_transaction_regulator_M_AXI_AWID),
        .m_axi_awlen(s00_transaction_regulator_M_AXI_AWLEN),
        .m_axi_awlock(s00_transaction_regulator_M_AXI_AWLOCK),
        .m_axi_awprot(s00_transaction_regulator_M_AXI_AWPROT),
        .m_axi_awqos(s00_transaction_regulator_M_AXI_AWQOS),
        .m_axi_awready(s00_transaction_regulator_M_AXI_AWREADY),
        .m_axi_awsize(s00_transaction_regulator_M_AXI_AWSIZE),
        .m_axi_awuser(s00_transaction_regulator_M_AXI_AWUSER),
        .m_axi_awvalid(s00_transaction_regulator_M_AXI_AWVALID),
        .m_axi_bid(s00_transaction_regulator_M_AXI_BID),
        .m_axi_bready(s00_transaction_regulator_M_AXI_BREADY),
        .m_axi_bresp(s00_transaction_regulator_M_AXI_BRESP),
        .m_axi_buser(s00_transaction_regulator_M_AXI_BUSER),
        .m_axi_bvalid(s00_transaction_regulator_M_AXI_BVALID),
        .m_axi_rdata(s00_transaction_regulator_M_AXI_RDATA),
        .m_axi_rid(s00_transaction_regulator_M_AXI_RID),
        .m_axi_rlast(s00_transaction_regulator_M_AXI_RLAST),
        .m_axi_rready(s00_transaction_regulator_M_AXI_RREADY),
        .m_axi_rresp(s00_transaction_regulator_M_AXI_RRESP),
        .m_axi_ruser(s00_transaction_regulator_M_AXI_RUSER),
        .m_axi_rvalid(s00_transaction_regulator_M_AXI_RVALID),
        .m_axi_wdata(s00_transaction_regulator_M_AXI_WDATA),
        .m_axi_wlast(s00_transaction_regulator_M_AXI_WLAST),
        .m_axi_wready(s00_transaction_regulator_M_AXI_WREADY),
        .m_axi_wstrb(s00_transaction_regulator_M_AXI_WSTRB),
        .m_axi_wuser(s00_transaction_regulator_M_AXI_WUSER),
        .m_axi_wvalid(s00_transaction_regulator_M_AXI_WVALID),
        .s_axi_araddr(s00_mmu_M_AXI_ARADDR),
        .s_axi_arburst(s00_mmu_M_AXI_ARBURST),
        .s_axi_arcache(s00_mmu_M_AXI_ARCACHE),
        .s_axi_arlen(s00_mmu_M_AXI_ARLEN),
        .s_axi_arlock(s00_mmu_M_AXI_ARLOCK),
        .s_axi_arprot(s00_mmu_M_AXI_ARPROT),
        .s_axi_arqos(s00_mmu_M_AXI_ARQOS),
        .s_axi_arready(s00_mmu_M_AXI_ARREADY),
        .s_axi_arsize(s00_mmu_M_AXI_ARSIZE),
        .s_axi_aruser(s00_mmu_M_AXI_ARUSER),
        .s_axi_arvalid(s00_mmu_M_AXI_ARVALID),
        .s_axi_awaddr(s00_mmu_M_AXI_AWADDR),
        .s_axi_awburst(s00_mmu_M_AXI_AWBURST),
        .s_axi_awcache(s00_mmu_M_AXI_AWCACHE),
        .s_axi_awlen(s00_mmu_M_AXI_AWLEN),
        .s_axi_awlock(s00_mmu_M_AXI_AWLOCK),
        .s_axi_awprot(s00_mmu_M_AXI_AWPROT),
        .s_axi_awqos(s00_mmu_M_AXI_AWQOS),
        .s_axi_awready(s00_mmu_M_AXI_AWREADY),
        .s_axi_awsize(s00_mmu_M_AXI_AWSIZE),
        .s_axi_awuser(s00_mmu_M_AXI_AWUSER),
        .s_axi_awvalid(s00_mmu_M_AXI_AWVALID),
        .s_axi_bready(s00_mmu_M_AXI_BREADY),
        .s_axi_bresp(s00_mmu_M_AXI_BRESP),
        .s_axi_buser(s00_mmu_M_AXI_BUSER),
        .s_axi_bvalid(s00_mmu_M_AXI_BVALID),
        .s_axi_rdata(s00_mmu_M_AXI_RDATA),
        .s_axi_rlast(s00_mmu_M_AXI_RLAST),
        .s_axi_rready(s00_mmu_M_AXI_RREADY),
        .s_axi_rresp(s00_mmu_M_AXI_RRESP),
        .s_axi_ruser(s00_mmu_M_AXI_RUSER),
        .s_axi_rvalid(s00_mmu_M_AXI_RVALID),
        .s_axi_wdata(s00_mmu_M_AXI_WDATA),
        .s_axi_wlast(s00_mmu_M_AXI_WLAST),
        .s_axi_wready(s00_mmu_M_AXI_WREADY),
        .s_axi_wstrb(s00_mmu_M_AXI_WSTRB),
        .s_axi_wuser(s00_mmu_M_AXI_WUSER),
        .s_axi_wvalid(s00_mmu_M_AXI_WVALID));
endmodule

module s00_nodes_imp_5UA7YI
   (M_SC_AR_info,
    M_SC_AR_payld,
    M_SC_AR_recv,
    M_SC_AR_req,
    M_SC_AR_send,
    M_SC_AW_info,
    M_SC_AW_payld,
    M_SC_AW_recv,
    M_SC_AW_req,
    M_SC_AW_send,
    M_SC_B_info,
    M_SC_B_payld,
    M_SC_B_recv,
    M_SC_B_req,
    M_SC_B_send,
    M_SC_R_info,
    M_SC_R_payld,
    M_SC_R_recv,
    M_SC_R_req,
    M_SC_R_send,
    M_SC_W_info,
    M_SC_W_payld,
    M_SC_W_recv,
    M_SC_W_req,
    M_SC_W_send,
    S_SC_AR_info,
    S_SC_AR_payld,
    S_SC_AR_recv,
    S_SC_AR_req,
    S_SC_AR_send,
    S_SC_AW_info,
    S_SC_AW_payld,
    S_SC_AW_recv,
    S_SC_AW_req,
    S_SC_AW_send,
    S_SC_B_info,
    S_SC_B_payld,
    S_SC_B_recv,
    S_SC_B_req,
    S_SC_B_send,
    S_SC_R_info,
    S_SC_R_payld,
    S_SC_R_recv,
    S_SC_R_req,
    S_SC_R_send,
    S_SC_W_info,
    S_SC_W_payld,
    S_SC_W_recv,
    S_SC_W_req,
    S_SC_W_send,
    m_sc_clk,
    m_sc_resetn,
    s_sc_clk,
    s_sc_resetn);
  output [0:0]M_SC_AR_info;
  output [137:0]M_SC_AR_payld;
  input [0:0]M_SC_AR_recv;
  output [0:0]M_SC_AR_req;
  output [0:0]M_SC_AR_send;
  output [0:0]M_SC_AW_info;
  output [137:0]M_SC_AW_payld;
  input [0:0]M_SC_AW_recv;
  output [0:0]M_SC_AW_req;
  output [0:0]M_SC_AW_send;
  output [0:0]M_SC_B_info;
  output [5:0]M_SC_B_payld;
  input [0:0]M_SC_B_recv;
  output [0:0]M_SC_B_req;
  output [0:0]M_SC_B_send;
  output [0:0]M_SC_R_info;
  output [51:0]M_SC_R_payld;
  input [0:0]M_SC_R_recv;
  output [0:0]M_SC_R_req;
  output [0:0]M_SC_R_send;
  output [0:0]M_SC_W_info;
  output [51:0]M_SC_W_payld;
  input [0:0]M_SC_W_recv;
  output [0:0]M_SC_W_req;
  output [0:0]M_SC_W_send;
  input [0:0]S_SC_AR_info;
  input [137:0]S_SC_AR_payld;
  output [0:0]S_SC_AR_recv;
  input [0:0]S_SC_AR_req;
  input [0:0]S_SC_AR_send;
  input [0:0]S_SC_AW_info;
  input [137:0]S_SC_AW_payld;
  output [0:0]S_SC_AW_recv;
  input [0:0]S_SC_AW_req;
  input [0:0]S_SC_AW_send;
  input [0:0]S_SC_B_info;
  input [5:0]S_SC_B_payld;
  output [0:0]S_SC_B_recv;
  input [0:0]S_SC_B_req;
  input [0:0]S_SC_B_send;
  input [0:0]S_SC_R_info;
  input [51:0]S_SC_R_payld;
  output [0:0]S_SC_R_recv;
  input [0:0]S_SC_R_req;
  input [0:0]S_SC_R_send;
  input [0:0]S_SC_W_info;
  input [51:0]S_SC_W_payld;
  output [0:0]S_SC_W_recv;
  input [0:0]S_SC_W_req;
  input [0:0]S_SC_W_send;
  input m_sc_clk;
  input m_sc_resetn;
  input s_sc_clk;
  input s_sc_resetn;

  wire [0:0]S_SC_AR_1_INFO;
  wire [137:0]S_SC_AR_1_PAYLD;
  wire [0:0]S_SC_AR_1_RECV;
  wire [0:0]S_SC_AR_1_REQ;
  wire [0:0]S_SC_AR_1_SEND;
  wire [0:0]S_SC_AW_1_INFO;
  wire [137:0]S_SC_AW_1_PAYLD;
  wire [0:0]S_SC_AW_1_RECV;
  wire [0:0]S_SC_AW_1_REQ;
  wire [0:0]S_SC_AW_1_SEND;
  wire [0:0]S_SC_B_1_INFO;
  wire [5:0]S_SC_B_1_PAYLD;
  wire [0:0]S_SC_B_1_RECV;
  wire [0:0]S_SC_B_1_REQ;
  wire [0:0]S_SC_B_1_SEND;
  wire [0:0]S_SC_R_1_INFO;
  wire [51:0]S_SC_R_1_PAYLD;
  wire [0:0]S_SC_R_1_RECV;
  wire [0:0]S_SC_R_1_REQ;
  wire [0:0]S_SC_R_1_SEND;
  wire [0:0]S_SC_W_1_INFO;
  wire [51:0]S_SC_W_1_PAYLD;
  wire [0:0]S_SC_W_1_RECV;
  wire [0:0]S_SC_W_1_REQ;
  wire [0:0]S_SC_W_1_SEND;
  wire m_sc_clk_1;
  wire m_sc_resetn_1;
  wire [0:0]s00_ar_node_M_SC_INFO;
  wire [137:0]s00_ar_node_M_SC_PAYLD;
  wire [0:0]s00_ar_node_M_SC_RECV;
  wire [0:0]s00_ar_node_M_SC_REQ;
  wire [0:0]s00_ar_node_M_SC_SEND;
  wire [0:0]s00_aw_node_M_SC_INFO;
  wire [137:0]s00_aw_node_M_SC_PAYLD;
  wire [0:0]s00_aw_node_M_SC_RECV;
  wire [0:0]s00_aw_node_M_SC_REQ;
  wire [0:0]s00_aw_node_M_SC_SEND;
  wire [0:0]s00_b_node_M_SC_INFO;
  wire [5:0]s00_b_node_M_SC_PAYLD;
  wire [0:0]s00_b_node_M_SC_RECV;
  wire [0:0]s00_b_node_M_SC_REQ;
  wire [0:0]s00_b_node_M_SC_SEND;
  wire [0:0]s00_r_node_M_SC_INFO;
  wire [51:0]s00_r_node_M_SC_PAYLD;
  wire [0:0]s00_r_node_M_SC_RECV;
  wire [0:0]s00_r_node_M_SC_REQ;
  wire [0:0]s00_r_node_M_SC_SEND;
  wire [0:0]s00_w_node_M_SC_INFO;
  wire [51:0]s00_w_node_M_SC_PAYLD;
  wire [0:0]s00_w_node_M_SC_RECV;
  wire [0:0]s00_w_node_M_SC_REQ;
  wire [0:0]s00_w_node_M_SC_SEND;
  wire s_sc_clk_1;
  wire s_sc_resetn_1;

  assign M_SC_AR_info[0] = s00_ar_node_M_SC_INFO;
  assign M_SC_AR_payld[137:0] = s00_ar_node_M_SC_PAYLD;
  assign M_SC_AR_req[0] = s00_ar_node_M_SC_REQ;
  assign M_SC_AR_send[0] = s00_ar_node_M_SC_SEND;
  assign M_SC_AW_info[0] = s00_aw_node_M_SC_INFO;
  assign M_SC_AW_payld[137:0] = s00_aw_node_M_SC_PAYLD;
  assign M_SC_AW_req[0] = s00_aw_node_M_SC_REQ;
  assign M_SC_AW_send[0] = s00_aw_node_M_SC_SEND;
  assign M_SC_B_info[0] = s00_b_node_M_SC_INFO;
  assign M_SC_B_payld[5:0] = s00_b_node_M_SC_PAYLD;
  assign M_SC_B_req[0] = s00_b_node_M_SC_REQ;
  assign M_SC_B_send[0] = s00_b_node_M_SC_SEND;
  assign M_SC_R_info[0] = s00_r_node_M_SC_INFO;
  assign M_SC_R_payld[51:0] = s00_r_node_M_SC_PAYLD;
  assign M_SC_R_req[0] = s00_r_node_M_SC_REQ;
  assign M_SC_R_send[0] = s00_r_node_M_SC_SEND;
  assign M_SC_W_info[0] = s00_w_node_M_SC_INFO;
  assign M_SC_W_payld[51:0] = s00_w_node_M_SC_PAYLD;
  assign M_SC_W_req[0] = s00_w_node_M_SC_REQ;
  assign M_SC_W_send[0] = s00_w_node_M_SC_SEND;
  assign S_SC_AR_1_INFO = S_SC_AR_info[0];
  assign S_SC_AR_1_PAYLD = S_SC_AR_payld[137:0];
  assign S_SC_AR_1_REQ = S_SC_AR_req[0];
  assign S_SC_AR_1_SEND = S_SC_AR_send[0];
  assign S_SC_AR_recv[0] = S_SC_AR_1_RECV;
  assign S_SC_AW_1_INFO = S_SC_AW_info[0];
  assign S_SC_AW_1_PAYLD = S_SC_AW_payld[137:0];
  assign S_SC_AW_1_REQ = S_SC_AW_req[0];
  assign S_SC_AW_1_SEND = S_SC_AW_send[0];
  assign S_SC_AW_recv[0] = S_SC_AW_1_RECV;
  assign S_SC_B_1_INFO = S_SC_B_info[0];
  assign S_SC_B_1_PAYLD = S_SC_B_payld[5:0];
  assign S_SC_B_1_REQ = S_SC_B_req[0];
  assign S_SC_B_1_SEND = S_SC_B_send[0];
  assign S_SC_B_recv[0] = S_SC_B_1_RECV;
  assign S_SC_R_1_INFO = S_SC_R_info[0];
  assign S_SC_R_1_PAYLD = S_SC_R_payld[51:0];
  assign S_SC_R_1_REQ = S_SC_R_req[0];
  assign S_SC_R_1_SEND = S_SC_R_send[0];
  assign S_SC_R_recv[0] = S_SC_R_1_RECV;
  assign S_SC_W_1_INFO = S_SC_W_info[0];
  assign S_SC_W_1_PAYLD = S_SC_W_payld[51:0];
  assign S_SC_W_1_REQ = S_SC_W_req[0];
  assign S_SC_W_1_SEND = S_SC_W_send[0];
  assign S_SC_W_recv[0] = S_SC_W_1_RECV;
  assign m_sc_clk_1 = m_sc_clk;
  assign m_sc_resetn_1 = m_sc_resetn;
  assign s00_ar_node_M_SC_RECV = M_SC_AR_recv[0];
  assign s00_aw_node_M_SC_RECV = M_SC_AW_recv[0];
  assign s00_b_node_M_SC_RECV = M_SC_B_recv[0];
  assign s00_r_node_M_SC_RECV = M_SC_R_recv[0];
  assign s00_w_node_M_SC_RECV = M_SC_W_recv[0];
  assign s_sc_clk_1 = s_sc_clk;
  assign s_sc_resetn_1 = s_sc_resetn;
  bd_cd63_sarn_0 s00_ar_node
       (.m_sc_aclk(m_sc_clk_1),
        .m_sc_aresetn(m_sc_resetn_1),
        .m_sc_info(s00_ar_node_M_SC_INFO),
        .m_sc_payld(s00_ar_node_M_SC_PAYLD),
        .m_sc_recv(s00_ar_node_M_SC_RECV),
        .m_sc_req(s00_ar_node_M_SC_REQ),
        .m_sc_send(s00_ar_node_M_SC_SEND),
        .s_sc_aclk(s_sc_clk_1),
        .s_sc_aresetn(s_sc_resetn_1),
        .s_sc_info(S_SC_AR_1_INFO),
        .s_sc_payld(S_SC_AR_1_PAYLD),
        .s_sc_recv(S_SC_AR_1_RECV),
        .s_sc_req(S_SC_AR_1_REQ),
        .s_sc_send(S_SC_AR_1_SEND));
  bd_cd63_sawn_0 s00_aw_node
       (.m_sc_aclk(m_sc_clk_1),
        .m_sc_aresetn(m_sc_resetn_1),
        .m_sc_info(s00_aw_node_M_SC_INFO),
        .m_sc_payld(s00_aw_node_M_SC_PAYLD),
        .m_sc_recv(s00_aw_node_M_SC_RECV),
        .m_sc_req(s00_aw_node_M_SC_REQ),
        .m_sc_send(s00_aw_node_M_SC_SEND),
        .s_sc_aclk(s_sc_clk_1),
        .s_sc_aresetn(s_sc_resetn_1),
        .s_sc_info(S_SC_AW_1_INFO),
        .s_sc_payld(S_SC_AW_1_PAYLD),
        .s_sc_recv(S_SC_AW_1_RECV),
        .s_sc_req(S_SC_AW_1_REQ),
        .s_sc_send(S_SC_AW_1_SEND));
  bd_cd63_sbn_0 s00_b_node
       (.m_sc_aclk(s_sc_clk_1),
        .m_sc_aresetn(s_sc_resetn_1),
        .m_sc_info(s00_b_node_M_SC_INFO),
        .m_sc_payld(s00_b_node_M_SC_PAYLD),
        .m_sc_recv(s00_b_node_M_SC_RECV),
        .m_sc_req(s00_b_node_M_SC_REQ),
        .m_sc_send(s00_b_node_M_SC_SEND),
        .s_sc_aclk(m_sc_clk_1),
        .s_sc_aresetn(m_sc_resetn_1),
        .s_sc_info(S_SC_B_1_INFO),
        .s_sc_payld(S_SC_B_1_PAYLD),
        .s_sc_recv(S_SC_B_1_RECV),
        .s_sc_req(S_SC_B_1_REQ),
        .s_sc_send(S_SC_B_1_SEND));
  bd_cd63_srn_0 s00_r_node
       (.m_sc_aclk(s_sc_clk_1),
        .m_sc_aresetn(s_sc_resetn_1),
        .m_sc_info(s00_r_node_M_SC_INFO),
        .m_sc_payld(s00_r_node_M_SC_PAYLD),
        .m_sc_recv(s00_r_node_M_SC_RECV),
        .m_sc_req(s00_r_node_M_SC_REQ),
        .m_sc_send(s00_r_node_M_SC_SEND),
        .s_sc_aclk(m_sc_clk_1),
        .s_sc_aresetn(m_sc_resetn_1),
        .s_sc_info(S_SC_R_1_INFO),
        .s_sc_payld(S_SC_R_1_PAYLD),
        .s_sc_recv(S_SC_R_1_RECV),
        .s_sc_req(S_SC_R_1_REQ),
        .s_sc_send(S_SC_R_1_SEND));
  bd_cd63_swn_0 s00_w_node
       (.m_sc_aclk(m_sc_clk_1),
        .m_sc_aresetn(m_sc_resetn_1),
        .m_sc_info(s00_w_node_M_SC_INFO),
        .m_sc_payld(s00_w_node_M_SC_PAYLD),
        .m_sc_recv(s00_w_node_M_SC_RECV),
        .m_sc_req(s00_w_node_M_SC_REQ),
        .m_sc_send(s00_w_node_M_SC_SEND),
        .s_sc_aclk(s_sc_clk_1),
        .s_sc_aresetn(s_sc_resetn_1),
        .s_sc_info(S_SC_W_1_INFO),
        .s_sc_payld(S_SC_W_1_PAYLD),
        .s_sc_recv(S_SC_W_1_RECV),
        .s_sc_req(S_SC_W_1_REQ),
        .s_sc_send(S_SC_W_1_SEND));
endmodule
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
