docquantum/skrach-synth/code/Skrach/Skrach.srcs/sources_1/bd/skrach_design/ip/skrach_design_axi_smc_0/bd_0/hdl/bd_cd63_wrapper.v

//Copyright 1986-2019 Xilinx, Inc. All Rights Reserved.
//--------------------------------------------------------------------------------
//Command: generate_target bd_cd63_wrapper.bd
//Design : bd_cd63_wrapper
//Purpose: IP block netlist
//--------------------------------------------------------------------------------
`timescale 1 ps / 1 ps

module bd_cd63_wrapper
   (M00_AXI_araddr,
    M00_AXI_arburst,
    M00_AXI_arcache,
    M00_AXI_arlen,
    M00_AXI_arlock,
    M00_AXI_arprot,
    M00_AXI_arqos,
    M00_AXI_arready,
    M00_AXI_arsize,
    M00_AXI_arvalid,
    M00_AXI_awaddr,
    M00_AXI_awburst,
    M00_AXI_awcache,
    M00_AXI_awlen,
    M00_AXI_awlock,
    M00_AXI_awprot,
    M00_AXI_awqos,
    M00_AXI_awready,
    M00_AXI_awsize,
    M00_AXI_awvalid,
    M00_AXI_bready,
    M00_AXI_bresp,
    M00_AXI_bvalid,
    M00_AXI_rdata,
    M00_AXI_rlast,
    M00_AXI_rready,
    M00_AXI_rresp,
    M00_AXI_rvalid,
    M00_AXI_wdata,
    M00_AXI_wlast,
    M00_AXI_wready,
    M00_AXI_wstrb,
    M00_AXI_wvalid,
    S00_AXI_araddr,
    S00_AXI_arburst,
    S00_AXI_arcache,
    S00_AXI_arlen,
    S00_AXI_arlock,
    S00_AXI_arprot,
    S00_AXI_arqos,
    S00_AXI_arready,
    S00_AXI_arsize,
    S00_AXI_arvalid,
    S00_AXI_awaddr,
    S00_AXI_awburst,
    S00_AXI_awcache,
    S00_AXI_awlen,
    S00_AXI_awlock,
    S00_AXI_awprot,
    S00_AXI_awqos,
    S00_AXI_awready,
    S00_AXI_awsize,
    S00_AXI_awvalid,
    S00_AXI_bready,
    S00_AXI_bresp,
    S00_AXI_bvalid,
    S00_AXI_rdata,
    S00_AXI_rlast,
    S00_AXI_rready,
    S00_AXI_rresp,
    S00_AXI_rvalid,
    S00_AXI_wdata,
    S00_AXI_wlast,
    S00_AXI_wready,
    S00_AXI_wstrb,
    S00_AXI_wvalid,
    S01_AXI_araddr,
    S01_AXI_arburst,
    S01_AXI_arcache,
    S01_AXI_arlen,
    S01_AXI_arlock,
    S01_AXI_arprot,
    S01_AXI_arqos,
    S01_AXI_arready,
    S01_AXI_arsize,
    S01_AXI_arvalid,
    S01_AXI_rdata,
    S01_AXI_rlast,
    S01_AXI_rready,
    S01_AXI_rresp,
    S01_AXI_rvalid,
    aclk,
    aclk1,
    aresetn);
  output [28:0]M00_AXI_araddr;
  output [1:0]M00_AXI_arburst;
  output [3:0]M00_AXI_arcache;
  output [7:0]M00_AXI_arlen;
  output [0:0]M00_AXI_arlock;
  output [2:0]M00_AXI_arprot;
  output [3:0]M00_AXI_arqos;
  input M00_AXI_arready;
  output [2:0]M00_AXI_arsize;
  output M00_AXI_arvalid;
  output [28:0]M00_AXI_awaddr;
  output [1:0]M00_AXI_awburst;
  output [3:0]M00_AXI_awcache;
  output [7:0]M00_AXI_awlen;
  output [0:0]M00_AXI_awlock;
  output [2:0]M00_AXI_awprot;
  output [3:0]M00_AXI_awqos;
  input M00_AXI_awready;
  output [2:0]M00_AXI_awsize;
  output M00_AXI_awvalid;
  output M00_AXI_bready;
  input [1:0]M00_AXI_bresp;
  input M00_AXI_bvalid;
  input [31:0]M00_AXI_rdata;
  input M00_AXI_rlast;
  output M00_AXI_rready;
  input [1:0]M00_AXI_rresp;
  input M00_AXI_rvalid;
  output [31:0]M00_AXI_wdata;
  output M00_AXI_wlast;
  input M00_AXI_wready;
  output [3:0]M00_AXI_wstrb;
  output M00_AXI_wvalid;
  input [31:0]S00_AXI_araddr;
  input [1:0]S00_AXI_arburst;
  input [3:0]S00_AXI_arcache;
  input [7:0]S00_AXI_arlen;
  input [0:0]S00_AXI_arlock;
  input [2:0]S00_AXI_arprot;
  input [3:0]S00_AXI_arqos;
  output S00_AXI_arready;
  input [2:0]S00_AXI_arsize;
  input S00_AXI_arvalid;
  input [31:0]S00_AXI_awaddr;
  input [1:0]S00_AXI_awburst;
  input [3:0]S00_AXI_awcache;
  input [7:0]S00_AXI_awlen;
  input [0:0]S00_AXI_awlock;
  input [2:0]S00_AXI_awprot;
  input [3:0]S00_AXI_awqos;
  output S00_AXI_awready;
  input [2:0]S00_AXI_awsize;
  input S00_AXI_awvalid;
  input S00_AXI_bready;
  output [1:0]S00_AXI_bresp;
  output S00_AXI_bvalid;
  output [31:0]S00_AXI_rdata;
  output S00_AXI_rlast;
  input S00_AXI_rready;
  output [1:0]S00_AXI_rresp;
  output S00_AXI_rvalid;
  input [31:0]S00_AXI_wdata;
  input S00_AXI_wlast;
  output S00_AXI_wready;
  input [3:0]S00_AXI_wstrb;
  input S00_AXI_wvalid;
  input [31:0]S01_AXI_araddr;
  input [1:0]S01_AXI_arburst;
  input [3:0]S01_AXI_arcache;
  input [7:0]S01_AXI_arlen;
  input [0:0]S01_AXI_arlock;
  input [2:0]S01_AXI_arprot;
  input [3:0]S01_AXI_arqos;
  output S01_AXI_arready;
  input [2:0]S01_AXI_arsize;
  input S01_AXI_arvalid;
  output [31:0]S01_AXI_rdata;
  output S01_AXI_rlast;
  input S01_AXI_rready;
  output [1:0]S01_AXI_rresp;
  output S01_AXI_rvalid;
  input aclk;
  input aclk1;
  input aresetn;

  wire [28:0]M00_AXI_araddr;
  wire [1:0]M00_AXI_arburst;
  wire [3:0]M00_AXI_arcache;
  wire [7:0]M00_AXI_arlen;
  wire [0:0]M00_AXI_arlock;
  wire [2:0]M00_AXI_arprot;
  wire [3:0]M00_AXI_arqos;
  wire M00_AXI_arready;
  wire [2:0]M00_AXI_arsize;
  wire M00_AXI_arvalid;
  wire [28:0]M00_AXI_awaddr;
  wire [1:0]M00_AXI_awburst;
  wire [3:0]M00_AXI_awcache;
  wire [7:0]M00_AXI_awlen;
  wire [0:0]M00_AXI_awlock;
  wire [2:0]M00_AXI_awprot;
  wire [3:0]M00_AXI_awqos;
  wire M00_AXI_awready;
  wire [2:0]M00_AXI_awsize;
  wire M00_AXI_awvalid;
  wire M00_AXI_bready;
  wire [1:0]M00_AXI_bresp;
  wire M00_AXI_bvalid;
  wire [31:0]M00_AXI_rdata;
  wire M00_AXI_rlast;
  wire M00_AXI_rready;
  wire [1:0]M00_AXI_rresp;
  wire M00_AXI_rvalid;
  wire [31:0]M00_AXI_wdata;
  wire M00_AXI_wlast;
  wire M00_AXI_wready;
  wire [3:0]M00_AXI_wstrb;
  wire M00_AXI_wvalid;
  wire [31:0]S00_AXI_araddr;
  wire [1:0]S00_AXI_arburst;
  wire [3:0]S00_AXI_arcache;
  wire [7:0]S00_AXI_arlen;
  wire [0:0]S00_AXI_arlock;
  wire [2:0]S00_AXI_arprot;
  wire [3:0]S00_AXI_arqos;
  wire S00_AXI_arready;
  wire [2:0]S00_AXI_arsize;
  wire S00_AXI_arvalid;
  wire [31:0]S00_AXI_awaddr;
  wire [1:0]S00_AXI_awburst;
  wire [3:0]S00_AXI_awcache;
  wire [7:0]S00_AXI_awlen;
  wire [0:0]S00_AXI_awlock;
  wire [2:0]S00_AXI_awprot;
  wire [3:0]S00_AXI_awqos;
  wire S00_AXI_awready;
  wire [2:0]S00_AXI_awsize;
  wire S00_AXI_awvalid;
  wire S00_AXI_bready;
  wire [1:0]S00_AXI_bresp;
  wire S00_AXI_bvalid;
  wire [31:0]S00_AXI_rdata;
  wire S00_AXI_rlast;
  wire S00_AXI_rready;
  wire [1:0]S00_AXI_rresp;
  wire S00_AXI_rvalid;
  wire [31:0]S00_AXI_wdata;
  wire S00_AXI_wlast;
  wire S00_AXI_wready;
  wire [3:0]S00_AXI_wstrb;
  wire S00_AXI_wvalid;
  wire [31:0]S01_AXI_araddr;
  wire [1:0]S01_AXI_arburst;
  wire [3:0]S01_AXI_arcache;
  wire [7:0]S01_AXI_arlen;
  wire [0:0]S01_AXI_arlock;
  wire [2:0]S01_AXI_arprot;
  wire [3:0]S01_AXI_arqos;
  wire S01_AXI_arready;
  wire [2:0]S01_AXI_arsize;
  wire S01_AXI_arvalid;
  wire [31:0]S01_AXI_rdata;
  wire S01_AXI_rlast;
  wire S01_AXI_rready;
  wire [1:0]S01_AXI_rresp;
  wire S01_AXI_rvalid;
  wire aclk;
  wire aclk1;
  wire aresetn;

  bd_cd63 bd_cd63_i
       (.M00_AXI_araddr(M00_AXI_araddr),
        .M00_AXI_arburst(M00_AXI_arburst),
        .M00_AXI_arcache(M00_AXI_arcache),
        .M00_AXI_arlen(M00_AXI_arlen),
        .M00_AXI_arlock(M00_AXI_arlock),
        .M00_AXI_arprot(M00_AXI_arprot),
        .M00_AXI_arqos(M00_AXI_arqos),
        .M00_AXI_arready(M00_AXI_arready),
        .M00_AXI_arsize(M00_AXI_arsize),
        .M00_AXI_arvalid(M00_AXI_arvalid),
        .M00_AXI_awaddr(M00_AXI_awaddr),
        .M00_AXI_awburst(M00_AXI_awburst),
        .M00_AXI_awcache(M00_AXI_awcache),
        .M00_AXI_awlen(M00_AXI_awlen),
        .M00_AXI_awlock(M00_AXI_awlock),
        .M00_AXI_awprot(M00_AXI_awprot),
        .M00_AXI_awqos(M00_AXI_awqos),
        .M00_AXI_awready(M00_AXI_awready),
        .M00_AXI_awsize(M00_AXI_awsize),
        .M00_AXI_awvalid(M00_AXI_awvalid),
        .M00_AXI_bready(M00_AXI_bready),
        .M00_AXI_bresp(M00_AXI_bresp),
        .M00_AXI_bvalid(M00_AXI_bvalid),
        .M00_AXI_rdata(M00_AXI_rdata),
        .M00_AXI_rlast(M00_AXI_rlast),
        .M00_AXI_rready(M00_AXI_rready),
        .M00_AXI_rresp(M00_AXI_rresp),
        .M00_AXI_rvalid(M00_AXI_rvalid),
        .M00_AXI_wdata(M00_AXI_wdata),
        .M00_AXI_wlast(M00_AXI_wlast),
        .M00_AXI_wready(M00_AXI_wready),
        .M00_AXI_wstrb(M00_AXI_wstrb),
        .M00_AXI_wvalid(M00_AXI_wvalid),
        .S00_AXI_araddr(S00_AXI_araddr),
        .S00_AXI_arburst(S00_AXI_arburst),
        .S00_AXI_arcache(S00_AXI_arcache),
        .S00_AXI_arlen(S00_AXI_arlen),
        .S00_AXI_arlock(S00_AXI_arlock),
        .S00_AXI_arprot(S00_AXI_arprot),
        .S00_AXI_arqos(S00_AXI_arqos),
        .S00_AXI_arready(S00_AXI_arready),
        .S00_AXI_arsize(S00_AXI_arsize),
        .S00_AXI_arvalid(S00_AXI_arvalid),
        .S00_AXI_awaddr(S00_AXI_awaddr),
        .S00_AXI_awburst(S00_AXI_awburst),
        .S00_AXI_awcache(S00_AXI_awcache),
        .S00_AXI_awlen(S00_AXI_awlen),
        .S00_AXI_awlock(S00_AXI_awlock),
        .S00_AXI_awprot(S00_AXI_awprot),
        .S00_AXI_awqos(S00_AXI_awqos),
        .S00_AXI_awready(S00_AXI_awready),
        .S00_AXI_awsize(S00_AXI_awsize),
        .S00_AXI_awvalid(S00_AXI_awvalid),
        .S00_AXI_bready(S00_AXI_bready),
        .S00_AXI_bresp(S00_AXI_bresp),
        .S00_AXI_bvalid(S00_AXI_bvalid),
        .S00_AXI_rdata(S00_AXI_rdata),
        .S00_AXI_rlast(S00_AXI_rlast),
        .S00_AXI_rready(S00_AXI_rready),
        .S00_AXI_rresp(S00_AXI_rresp),
        .S00_AXI_rvalid(S00_AXI_rvalid),
        .S00_AXI_wdata(S00_AXI_wdata),
        .S00_AXI_wlast(S00_AXI_wlast),
        .S00_AXI_wready(S00_AXI_wready),
        .S00_AXI_wstrb(S00_AXI_wstrb),
        .S00_AXI_wvalid(S00_AXI_wvalid),
        .S01_AXI_araddr(S01_AXI_araddr),
        .S01_AXI_arburst(S01_AXI_arburst),
        .S01_AXI_arcache(S01_AXI_arcache),
        .S01_AXI_arlen(S01_AXI_arlen),
        .S01_AXI_arlock(S01_AXI_arlock),
        .S01_AXI_arprot(S01_AXI_arprot),
        .S01_AXI_arqos(S01_AXI_arqos),
        .S01_AXI_arready(S01_AXI_arready),
        .S01_AXI_arsize(S01_AXI_arsize),
        .S01_AXI_arvalid(S01_AXI_arvalid),
        .S01_AXI_rdata(S01_AXI_rdata),
        .S01_AXI_rlast(S01_AXI_rlast),
        .S01_AXI_rready(S01_AXI_rready),
        .S01_AXI_rresp(S01_AXI_rresp),
        .S01_AXI_rvalid(S01_AXI_rvalid),
        .aclk(aclk),
        .aclk1(aclk1),
        .aresetn(aresetn));
endmodule
