docquantum/skrach-synth/code/Skrach/Skrach.srcs/sources_1/bd/skrach_design/ip/skrach_design_axi_smc_0/synth/skrach_design_axi_smc_0.v

// (c) Copyright 1995-2020 Xilinx, Inc. All rights reserved.
// 
// This file contains confidential and proprietary information
// of Xilinx, Inc. and is protected under U.S. and
// international copyright and other intellectual property
// laws.
// 
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
// CRITICAL APPLICATIONS
// Xilinx products are not designed or intended to be fail-
// safe, or for use in any application requiring fail-safe
// performance, such as life-support or safety devices or
// systems, Class III medical devices, nuclear facilities,
// applications related to the deployment of airbags, or any
// other applications that could lead to death, personal
// injury, or severe property or environmental damage
// (individually and collectively, "Critical
// Applications"). Customer assumes the sole risk and
// liability of any use of Xilinx products in Critical
// Applications, subject only to applicable laws and
// regulations governing limitations on product liability.
// 
// THIS COPYRIGHT NOTICE AND DISCLAIMER MUST BE RETAINED AS
// PART OF THIS FILE AT ALL TIMES.
// 
// DO NOT MODIFY THIS FILE.


// IP VLNV: xilinx.com:ip:smartconnect:1.0
// IP Revision: 11

(* X_CORE_INFO = "bd_cd63,Vivado 2019.1" *)
(* CHECK_LICENSE_TYPE = "skrach_design_axi_smc_0,bd_cd63,{}" *)
(* CORE_GENERATION_INFO = "skrach_design_axi_smc_0,bd_cd63,{x_ipProduct=Vivado 2019.1,x_ipVendor=xilinx.com,x_ipLibrary=ip,x_ipName=smartconnect,x_ipVersion=1.0,x_ipCoreRevision=11,x_ipLanguage=VHDL,x_ipSimLanguage=MIXED,NUM_MI=1,NUM_SI=2,NUM_CLKS=2,HAS_ARESETN=1,ADVANCED_PROPERTIES=0,Component_Name=skrach_design_axi_smc_0}" *)
(* DowngradeIPIdentifiedWarnings = "yes" *)
module skrach_design_axi_smc_0 (
  aclk,
  aclk1,
  aresetn,
  S00_AXI_awaddr,
  S00_AXI_awlen,
  S00_AXI_awsize,
  S00_AXI_awburst,
  S00_AXI_awlock,
  S00_AXI_awcache,
  S00_AXI_awprot,
  S00_AXI_awqos,
  S00_AXI_awvalid,
  S00_AXI_awready,
  S00_AXI_wdata,
  S00_AXI_wstrb,
  S00_AXI_wlast,
  S00_AXI_wvalid,
  S00_AXI_wready,
  S00_AXI_bresp,
  S00_AXI_bvalid,
  S00_AXI_bready,
  S00_AXI_araddr,
  S00_AXI_arlen,
  S00_AXI_arsize,
  S00_AXI_arburst,
  S00_AXI_arlock,
  S00_AXI_arcache,
  S00_AXI_arprot,
  S00_AXI_arqos,
  S00_AXI_arvalid,
  S00_AXI_arready,
  S00_AXI_rdata,
  S00_AXI_rresp,
  S00_AXI_rlast,
  S00_AXI_rvalid,
  S00_AXI_rready,
  S01_AXI_araddr,
  S01_AXI_arlen,
  S01_AXI_arsize,
  S01_AXI_arburst,
  S01_AXI_arlock,
  S01_AXI_arcache,
  S01_AXI_arprot,
  S01_AXI_arqos,
  S01_AXI_arvalid,
  S01_AXI_arready,
  S01_AXI_rdata,
  S01_AXI_rresp,
  S01_AXI_rlast,
  S01_AXI_rvalid,
  S01_AXI_rready,
  M00_AXI_awaddr,
  M00_AXI_awlen,
  M00_AXI_awsize,
  M00_AXI_awburst,
  M00_AXI_awlock,
  M00_AXI_awcache,
  M00_AXI_awprot,
  M00_AXI_awqos,
  M00_AXI_awvalid,
  M00_AXI_awready,
  M00_AXI_wdata,
  M00_AXI_wstrb,
  M00_AXI_wlast,
  M00_AXI_wvalid,
  M00_AXI_wready,
  M00_AXI_bresp,
  M00_AXI_bvalid,
  M00_AXI_bready,
  M00_AXI_araddr,
  M00_AXI_arlen,
  M00_AXI_arsize,
  M00_AXI_arburst,
  M00_AXI_arlock,
  M00_AXI_arcache,
  M00_AXI_arprot,
  M00_AXI_arqos,
  M00_AXI_arvalid,
  M00_AXI_arready,
  M00_AXI_rdata,
  M00_AXI_rresp,
  M00_AXI_rlast,
  M00_AXI_rvalid,
  M00_AXI_rready
);

(* X_INTERFACE_PARAMETER = "XIL_INTERFACENAME CLK.aclk, FREQ_HZ 100000000, PHASE 0.0, CLK_DOMAIN /clk_wiz_1_clk_out1, ASSOCIATED_BUSIF S00_AXI:S01_AXI, INSERT_VIP 0, ASSOCIATED_CLKEN m_sc_aclken" *)
(* X_INTERFACE_INFO = "xilinx.com:signal:clock:1.0 CLK.aclk CLK" *)
input wire aclk;
(* X_INTERFACE_PARAMETER = "XIL_INTERFACENAME CLK.aclk1, FREQ_HZ 100000000, PHASE 0, CLK_DOMAIN skrach_design_mig_7series_0_3_ui_clk, ASSOCIATED_BUSIF M00_AXI, INSERT_VIP 0, ASSOCIATED_CLKEN s_sc_aclken" *)
(* X_INTERFACE_INFO = "xilinx.com:signal:clock:1.0 CLK.aclk1 CLK" *)
input wire aclk1;
(* X_INTERFACE_PARAMETER = "XIL_INTERFACENAME RST.aresetn, POLARITY ACTIVE_LOW, INSERT_VIP 0" *)
(* X_INTERFACE_INFO = "xilinx.com:signal:reset:1.0 RST.aresetn RST" *)
input wire aresetn;
(* X_INTERFACE_INFO = "xilinx.com:interface:aximm:1.0 S00_AXI AWADDR" *)
input wire [31 : 0] S00_AXI_awaddr;
(* X_INTERFACE_INFO = "xilinx.com:interface:aximm:1.0 S00_AXI AWLEN" *)
input wire [7 : 0] S00_AXI_awlen;
(* X_INTERFACE_INFO = "xilinx.com:interface:aximm:1.0 S00_AXI AWSIZE" *)
input wire [2 : 0] S00_AXI_awsize;
(* X_INTERFACE_INFO = "xilinx.com:interface:aximm:1.0 S00_AXI AWBURST" *)
input wire [1 : 0] S00_AXI_awburst;
(* X_INTERFACE_INFO = "xilinx.com:interface:aximm:1.0 S00_AXI AWLOCK" *)
input wire [0 : 0] S00_AXI_awlock;
(* X_INTERFACE_INFO = "xilinx.com:interface:aximm:1.0 S00_AXI AWCACHE" *)
input wire [3 : 0] S00_AXI_awcache;
(* X_INTERFACE_INFO = "xilinx.com:interface:aximm:1.0 S00_AXI AWPROT" *)
input wire [2 : 0] S00_AXI_awprot;
(* X_INTERFACE_INFO = "xilinx.com:interface:aximm:1.0 S00_AXI AWQOS" *)
input wire [3 : 0] S00_AXI_awqos;
(* X_INTERFACE_INFO = "xilinx.com:interface:aximm:1.0 S00_AXI AWVALID" *)
input wire S00_AXI_awvalid;
(* X_INTERFACE_INFO = "xilinx.com:interface:aximm:1.0 S00_AXI AWREADY" *)
output wire S00_AXI_awready;
(* X_INTERFACE_INFO = "xilinx.com:interface:aximm:1.0 S00_AXI WDATA" *)
input wire [31 : 0] S00_AXI_wdata;
(* X_INTERFACE_INFO = "xilinx.com:interface:aximm:1.0 S00_AXI WSTRB" *)
input wire [3 : 0] S00_AXI_wstrb;
(* X_INTERFACE_INFO = "xilinx.com:interface:aximm:1.0 S00_AXI WLAST" *)
input wire S00_AXI_wlast;
(* X_INTERFACE_INFO = "xilinx.com:interface:aximm:1.0 S00_AXI WVALID" *)
input wire S00_AXI_wvalid;
(* X_INTERFACE_INFO = "xilinx.com:interface:aximm:1.0 S00_AXI WREADY" *)
output wire S00_AXI_wready;
(* X_INTERFACE_INFO = "xilinx.com:interface:aximm:1.0 S00_AXI BRESP" *)
output wire [1 : 0] S00_AXI_bresp;
(* X_INTERFACE_INFO = "xilinx.com:interface:aximm:1.0 S00_AXI BVALID" *)
output wire S00_AXI_bvalid;
(* X_INTERFACE_INFO = "xilinx.com:interface:aximm:1.0 S00_AXI BREADY" *)
input wire S00_AXI_bready;
(* X_INTERFACE_INFO = "xilinx.com:interface:aximm:1.0 S00_AXI ARADDR" *)
input wire [31 : 0] S00_AXI_araddr;
(* X_INTERFACE_INFO = "xilinx.com:interface:aximm:1.0 S00_AXI ARLEN" *)
input wire [7 : 0] S00_AXI_arlen;
(* X_INTERFACE_INFO = "xilinx.com:interface:aximm:1.0 S00_AXI ARSIZE" *)
input wire [2 : 0] S00_AXI_arsize;
(* X_INTERFACE_INFO = "xilinx.com:interface:aximm:1.0 S00_AXI ARBURST" *)
input wire [1 : 0] S00_AXI_arburst;
(* X_INTERFACE_INFO = "xilinx.com:interface:aximm:1.0 S00_AXI ARLOCK" *)
input wire [0 : 0] S00_AXI_arlock;
(* X_INTERFACE_INFO = "xilinx.com:interface:aximm:1.0 S00_AXI ARCACHE" *)
input wire [3 : 0] S00_AXI_arcache;
(* X_INTERFACE_INFO = "xilinx.com:interface:aximm:1.0 S00_AXI ARPROT" *)
input wire [2 : 0] S00_AXI_arprot;
(* X_INTERFACE_INFO = "xilinx.com:interface:aximm:1.0 S00_AXI ARQOS" *)
input wire [3 : 0] S00_AXI_arqos;
(* X_INTERFACE_INFO = "xilinx.com:interface:aximm:1.0 S00_AXI ARVALID" *)
input wire S00_AXI_arvalid;
(* X_INTERFACE_INFO = "xilinx.com:interface:aximm:1.0 S00_AXI ARREADY" *)
output wire S00_AXI_arready;
(* X_INTERFACE_INFO = "xilinx.com:interface:aximm:1.0 S00_AXI RDATA" *)
output wire [31 : 0] S00_AXI_rdata;
(* X_INTERFACE_INFO = "xilinx.com:interface:aximm:1.0 S00_AXI RRESP" *)
output wire [1 : 0] S00_AXI_rresp;
(* X_INTERFACE_INFO = "xilinx.com:interface:aximm:1.0 S00_AXI RLAST" *)
output wire S00_AXI_rlast;
(* X_INTERFACE_INFO = "xilinx.com:interface:aximm:1.0 S00_AXI RVALID" *)
output wire S00_AXI_rvalid;
(* X_INTERFACE_PARAMETER = "XIL_INTERFACENAME S00_AXI, DATA_WIDTH 32, PROTOCOL AXI4, FREQ_HZ 100000000, ID_WIDTH 0, ADDR_WIDTH 32, AWUSER_WIDTH 0, ARUSER_WIDTH 0, WUSER_WIDTH 0, RUSER_WIDTH 0, BUSER_WIDTH 0, READ_WRITE_MODE READ_WRITE, HAS_BURST 1, HAS_LOCK 1, HAS_PROT 1, HAS_CACHE 1, HAS_QOS 1, HAS_REGION 0, HAS_WSTRB 1, HAS_BRESP 1, HAS_RRESP 1, SUPPORTS_NARROW_BURST 0, NUM_READ_OUTSTANDING 2, NUM_WRITE_OUTSTANDING 32, MAX_BURST_LENGTH 4, PHASE 0.0, CLK_DOMAIN /clk_wiz_1_clk_out1, NUM_READ_THREADS 1, NUM_WRITE_THREADS 1,\
 RUSER_BITS_PER_BYTE 0, WUSER_BITS_PER_BYTE 0, INSERT_VIP 0" *)
(* X_INTERFACE_INFO = "xilinx.com:interface:aximm:1.0 S00_AXI RREADY" *)
input wire S00_AXI_rready;
(* X_INTERFACE_INFO = "xilinx.com:interface:aximm:1.0 S01_AXI ARADDR" *)
input wire [31 : 0] S01_AXI_araddr;
(* X_INTERFACE_INFO = "xilinx.com:interface:aximm:1.0 S01_AXI ARLEN" *)
input wire [7 : 0] S01_AXI_arlen;
(* X_INTERFACE_INFO = "xilinx.com:interface:aximm:1.0 S01_AXI ARSIZE" *)
input wire [2 : 0] S01_AXI_arsize;
(* X_INTERFACE_INFO = "xilinx.com:interface:aximm:1.0 S01_AXI ARBURST" *)
input wire [1 : 0] S01_AXI_arburst;
(* X_INTERFACE_INFO = "xilinx.com:interface:aximm:1.0 S01_AXI ARLOCK" *)
input wire [0 : 0] S01_AXI_arlock;
(* X_INTERFACE_INFO = "xilinx.com:interface:aximm:1.0 S01_AXI ARCACHE" *)
input wire [3 : 0] S01_AXI_arcache;
(* X_INTERFACE_INFO = "xilinx.com:interface:aximm:1.0 S01_AXI ARPROT" *)
input wire [2 : 0] S01_AXI_arprot;
(* X_INTERFACE_INFO = "xilinx.com:interface:aximm:1.0 S01_AXI ARQOS" *)
input wire [3 : 0] S01_AXI_arqos;
(* X_INTERFACE_INFO = "xilinx.com:interface:aximm:1.0 S01_AXI ARVALID" *)
input wire S01_AXI_arvalid;
(* X_INTERFACE_INFO = "xilinx.com:interface:aximm:1.0 S01_AXI ARREADY" *)
output wire S01_AXI_arready;
(* X_INTERFACE_INFO = "xilinx.com:interface:aximm:1.0 S01_AXI RDATA" *)
output wire [31 : 0] S01_AXI_rdata;
(* X_INTERFACE_INFO = "xilinx.com:interface:aximm:1.0 S01_AXI RRESP" *)
output wire [1 : 0] S01_AXI_rresp;
(* X_INTERFACE_INFO = "xilinx.com:interface:aximm:1.0 S01_AXI RLAST" *)
output wire S01_AXI_rlast;
(* X_INTERFACE_INFO = "xilinx.com:interface:aximm:1.0 S01_AXI RVALID" *)
output wire S01_AXI_rvalid;
(* X_INTERFACE_PARAMETER = "XIL_INTERFACENAME S01_AXI, DATA_WIDTH 32, PROTOCOL AXI4, FREQ_HZ 100000000, ID_WIDTH 0, ADDR_WIDTH 32, AWUSER_WIDTH 0, ARUSER_WIDTH 0, WUSER_WIDTH 0, RUSER_WIDTH 0, BUSER_WIDTH 0, READ_WRITE_MODE READ_ONLY, HAS_BURST 1, HAS_LOCK 0, HAS_PROT 1, HAS_CACHE 1, HAS_QOS 1, HAS_REGION 0, HAS_WSTRB 0, HAS_BRESP 0, HAS_RRESP 1, SUPPORTS_NARROW_BURST 0, NUM_READ_OUTSTANDING 2, NUM_WRITE_OUTSTANDING 2, MAX_BURST_LENGTH 4, PHASE 0.0, CLK_DOMAIN /clk_wiz_1_clk_out1, NUM_READ_THREADS 1, NUM_WRITE_THREADS 1, R\
USER_BITS_PER_BYTE 0, WUSER_BITS_PER_BYTE 0, INSERT_VIP 0" *)
(* X_INTERFACE_INFO = "xilinx.com:interface:aximm:1.0 S01_AXI RREADY" *)
input wire S01_AXI_rready;
(* X_INTERFACE_INFO = "xilinx.com:interface:aximm:1.0 M00_AXI AWADDR" *)
output wire [28 : 0] M00_AXI_awaddr;
(* X_INTERFACE_INFO = "xilinx.com:interface:aximm:1.0 M00_AXI AWLEN" *)
output wire [7 : 0] M00_AXI_awlen;
(* X_INTERFACE_INFO = "xilinx.com:interface:aximm:1.0 M00_AXI AWSIZE" *)
output wire [2 : 0] M00_AXI_awsize;
(* X_INTERFACE_INFO = "xilinx.com:interface:aximm:1.0 M00_AXI AWBURST" *)
output wire [1 : 0] M00_AXI_awburst;
(* X_INTERFACE_INFO = "xilinx.com:interface:aximm:1.0 M00_AXI AWLOCK" *)
output wire [0 : 0] M00_AXI_awlock;
(* X_INTERFACE_INFO = "xilinx.com:interface:aximm:1.0 M00_AXI AWCACHE" *)
output wire [3 : 0] M00_AXI_awcache;
(* X_INTERFACE_INFO = "xilinx.com:interface:aximm:1.0 M00_AXI AWPROT" *)
output wire [2 : 0] M00_AXI_awprot;
(* X_INTERFACE_INFO = "xilinx.com:interface:aximm:1.0 M00_AXI AWQOS" *)
output wire [3 : 0] M00_AXI_awqos;
(* X_INTERFACE_INFO = "xilinx.com:interface:aximm:1.0 M00_AXI AWVALID" *)
output wire M00_AXI_awvalid;
(* X_INTERFACE_INFO = "xilinx.com:interface:aximm:1.0 M00_AXI AWREADY" *)
input wire M00_AXI_awready;
(* X_INTERFACE_INFO = "xilinx.com:interface:aximm:1.0 M00_AXI WDATA" *)
output wire [31 : 0] M00_AXI_wdata;
(* X_INTERFACE_INFO = "xilinx.com:interface:aximm:1.0 M00_AXI WSTRB" *)
output wire [3 : 0] M00_AXI_wstrb;
(* X_INTERFACE_INFO = "xilinx.com:interface:aximm:1.0 M00_AXI WLAST" *)
output wire M00_AXI_wlast;
(* X_INTERFACE_INFO = "xilinx.com:interface:aximm:1.0 M00_AXI WVALID" *)
output wire M00_AXI_wvalid;
(* X_INTERFACE_INFO = "xilinx.com:interface:aximm:1.0 M00_AXI WREADY" *)
input wire M00_AXI_wready;
(* X_INTERFACE_INFO = "xilinx.com:interface:aximm:1.0 M00_AXI BRESP" *)
input wire [1 : 0] M00_AXI_bresp;
(* X_INTERFACE_INFO = "xilinx.com:interface:aximm:1.0 M00_AXI BVALID" *)
input wire M00_AXI_bvalid;
(* X_INTERFACE_INFO = "xilinx.com:interface:aximm:1.0 M00_AXI BREADY" *)
output wire M00_AXI_bready;
(* X_INTERFACE_INFO = "xilinx.com:interface:aximm:1.0 M00_AXI ARADDR" *)
output wire [28 : 0] M00_AXI_araddr;
(* X_INTERFACE_INFO = "xilinx.com:interface:aximm:1.0 M00_AXI ARLEN" *)
output wire [7 : 0] M00_AXI_arlen;
(* X_INTERFACE_INFO = "xilinx.com:interface:aximm:1.0 M00_AXI ARSIZE" *)
output wire [2 : 0] M00_AXI_arsize;
(* X_INTERFACE_INFO = "xilinx.com:interface:aximm:1.0 M00_AXI ARBURST" *)
output wire [1 : 0] M00_AXI_arburst;
(* X_INTERFACE_INFO = "xilinx.com:interface:aximm:1.0 M00_AXI ARLOCK" *)
output wire [0 : 0] M00_AXI_arlock;
(* X_INTERFACE_INFO = "xilinx.com:interface:aximm:1.0 M00_AXI ARCACHE" *)
output wire [3 : 0] M00_AXI_arcache;
(* X_INTERFACE_INFO = "xilinx.com:interface:aximm:1.0 M00_AXI ARPROT" *)
output wire [2 : 0] M00_AXI_arprot;
(* X_INTERFACE_INFO = "xilinx.com:interface:aximm:1.0 M00_AXI ARQOS" *)
output wire [3 : 0] M00_AXI_arqos;
(* X_INTERFACE_INFO = "xilinx.com:interface:aximm:1.0 M00_AXI ARVALID" *)
output wire M00_AXI_arvalid;
(* X_INTERFACE_INFO = "xilinx.com:interface:aximm:1.0 M00_AXI ARREADY" *)
input wire M00_AXI_arready;
(* X_INTERFACE_INFO = "xilinx.com:interface:aximm:1.0 M00_AXI RDATA" *)
input wire [31 : 0] M00_AXI_rdata;
(* X_INTERFACE_INFO = "xilinx.com:interface:aximm:1.0 M00_AXI RRESP" *)
input wire [1 : 0] M00_AXI_rresp;
(* X_INTERFACE_INFO = "xilinx.com:interface:aximm:1.0 M00_AXI RLAST" *)
input wire M00_AXI_rlast;
(* X_INTERFACE_INFO = "xilinx.com:interface:aximm:1.0 M00_AXI RVALID" *)
input wire M00_AXI_rvalid;
(* X_INTERFACE_PARAMETER = "XIL_INTERFACENAME M00_AXI, DATA_WIDTH 32, PROTOCOL AXI4, FREQ_HZ 100000000, ID_WIDTH 0, ADDR_WIDTH 29, AWUSER_WIDTH 0, ARUSER_WIDTH 0, WUSER_WIDTH 0, RUSER_WIDTH 0, BUSER_WIDTH 0, READ_WRITE_MODE READ_WRITE, HAS_BURST 1, HAS_LOCK 1, HAS_PROT 1, HAS_CACHE 1, HAS_QOS 1, HAS_REGION 0, HAS_WSTRB 1, HAS_BRESP 1, HAS_RRESP 1, SUPPORTS_NARROW_BURST 0, NUM_READ_OUTSTANDING 2, NUM_WRITE_OUTSTANDING 32, MAX_BURST_LENGTH 4, PHASE 0, CLK_DOMAIN skrach_design_mig_7series_0_3_ui_clk, NUM_READ_THREADS 1, NUM_W\
RITE_THREADS 1, RUSER_BITS_PER_BYTE 0, WUSER_BITS_PER_BYTE 0, INSERT_VIP 0" *)
(* X_INTERFACE_INFO = "xilinx.com:interface:aximm:1.0 M00_AXI RREADY" *)
output wire M00_AXI_rready;

  bd_cd63 inst (
    .aclk(aclk),
    .aclk1(aclk1),
    .aresetn(aresetn),
    .S00_AXI_awaddr(S00_AXI_awaddr),
    .S00_AXI_awlen(S00_AXI_awlen),
    .S00_AXI_awsize(S00_AXI_awsize),
    .S00_AXI_awburst(S00_AXI_awburst),
    .S00_AXI_awlock(S00_AXI_awlock),
    .S00_AXI_awcache(S00_AXI_awcache),
    .S00_AXI_awprot(S00_AXI_awprot),
    .S00_AXI_awqos(S00_AXI_awqos),
    .S00_AXI_awvalid(S00_AXI_awvalid),
    .S00_AXI_awready(S00_AXI_awready),
    .S00_AXI_wdata(S00_AXI_wdata),
    .S00_AXI_wstrb(S00_AXI_wstrb),
    .S00_AXI_wlast(S00_AXI_wlast),
    .S00_AXI_wvalid(S00_AXI_wvalid),
    .S00_AXI_wready(S00_AXI_wready),
    .S00_AXI_bresp(S00_AXI_bresp),
    .S00_AXI_bvalid(S00_AXI_bvalid),
    .S00_AXI_bready(S00_AXI_bready),
    .S00_AXI_araddr(S00_AXI_araddr),
    .S00_AXI_arlen(S00_AXI_arlen),
    .S00_AXI_arsize(S00_AXI_arsize),
    .S00_AXI_arburst(S00_AXI_arburst),
    .S00_AXI_arlock(S00_AXI_arlock),
    .S00_AXI_arcache(S00_AXI_arcache),
    .S00_AXI_arprot(S00_AXI_arprot),
    .S00_AXI_arqos(S00_AXI_arqos),
    .S00_AXI_arvalid(S00_AXI_arvalid),
    .S00_AXI_arready(S00_AXI_arready),
    .S00_AXI_rdata(S00_AXI_rdata),
    .S00_AXI_rresp(S00_AXI_rresp),
    .S00_AXI_rlast(S00_AXI_rlast),
    .S00_AXI_rvalid(S00_AXI_rvalid),
    .S00_AXI_rready(S00_AXI_rready),
    .S01_AXI_araddr(S01_AXI_araddr),
    .S01_AXI_arlen(S01_AXI_arlen),
    .S01_AXI_arsize(S01_AXI_arsize),
    .S01_AXI_arburst(S01_AXI_arburst),
    .S01_AXI_arlock(S01_AXI_arlock),
    .S01_AXI_arcache(S01_AXI_arcache),
    .S01_AXI_arprot(S01_AXI_arprot),
    .S01_AXI_arqos(S01_AXI_arqos),
    .S01_AXI_arvalid(S01_AXI_arvalid),
    .S01_AXI_arready(S01_AXI_arready),
    .S01_AXI_rdata(S01_AXI_rdata),
    .S01_AXI_rresp(S01_AXI_rresp),
    .S01_AXI_rlast(S01_AXI_rlast),
    .S01_AXI_rvalid(S01_AXI_rvalid),
    .S01_AXI_rready(S01_AXI_rready),
    .M00_AXI_awaddr(M00_AXI_awaddr),
    .M00_AXI_awlen(M00_AXI_awlen),
    .M00_AXI_awsize(M00_AXI_awsize),
    .M00_AXI_awburst(M00_AXI_awburst),
    .M00_AXI_awlock(M00_AXI_awlock),
    .M00_AXI_awcache(M00_AXI_awcache),
    .M00_AXI_awprot(M00_AXI_awprot),
    .M00_AXI_awqos(M00_AXI_awqos),
    .M00_AXI_awvalid(M00_AXI_awvalid),
    .M00_AXI_awready(M00_AXI_awready),
    .M00_AXI_wdata(M00_AXI_wdata),
    .M00_AXI_wstrb(M00_AXI_wstrb),
    .M00_AXI_wlast(M00_AXI_wlast),
    .M00_AXI_wvalid(M00_AXI_wvalid),
    .M00_AXI_wready(M00_AXI_wready),
    .M00_AXI_bresp(M00_AXI_bresp),
    .M00_AXI_bvalid(M00_AXI_bvalid),
    .M00_AXI_bready(M00_AXI_bready),
    .M00_AXI_araddr(M00_AXI_araddr),
    .M00_AXI_arlen(M00_AXI_arlen),
    .M00_AXI_arsize(M00_AXI_arsize),
    .M00_AXI_arburst(M00_AXI_arburst),
    .M00_AXI_arlock(M00_AXI_arlock),
    .M00_AXI_arcache(M00_AXI_arcache),
    .M00_AXI_arprot(M00_AXI_arprot),
    .M00_AXI_arqos(M00_AXI_arqos),
    .M00_AXI_arvalid(M00_AXI_arvalid),
    .M00_AXI_arready(M00_AXI_arready),
    .M00_AXI_rdata(M00_AXI_rdata),
    .M00_AXI_rresp(M00_AXI_rresp),
    .M00_AXI_rlast(M00_AXI_rlast),
    .M00_AXI_rvalid(M00_AXI_rvalid),
    .M00_AXI_rready(M00_AXI_rready)
  );
endmodule
