docquantum/skrach-synth/code/Skrach/Skrach.srcs/sources_1/bd/skrach_design/ip/skrach_design_mdm_1_3/synth/skrach_design_mdm_1_3.vhd

-- (c) Copyright 1995-2020 Xilinx, Inc. All rights reserved.
-- 
-- This file contains confidential and proprietary information
-- of Xilinx, Inc. and is protected under U.S. and
-- international copyright and other intellectual property
-- laws.
-- 
-- DISCLAIMER
-- This disclaimer is not a license and does not grant any
-- rights to the materials distributed herewith. Except as
-- otherwise provided in a valid license issued to you by
-- Xilinx, and to the maximum extent permitted by applicable
-- law: (1) THESE MATERIALS ARE MADE AVAILABLE "AS IS" AND
-- WITH ALL FAULTS, AND XILINX HEREBY DISCLAIMS ALL WARRANTIES
-- AND CONDITIONS, EXPRESS, IMPLIED, OR STATUTORY, INCLUDING
-- BUT NOT LIMITED TO WARRANTIES OF MERCHANTABILITY, NON-
-- INFRINGEMENT, OR FITNESS FOR ANY PARTICULAR PURPOSE; and
-- (2) Xilinx shall not be liable (whether in contract or tort,
-- including negligence, or under any other theory of
-- liability) for any loss or damage of any kind or nature
-- related to, arising under or in connection with these
-- materials, including for any direct, or any indirect,
-- special, incidental, or consequential loss or damage
-- (including loss of data, profits, goodwill, or any type of
-- loss or damage suffered as a result of any action brought
-- by a third party) even if such damage or loss was
-- reasonably foreseeable or Xilinx had been advised of the
-- possibility of the same.
-- 
-- CRITICAL APPLICATIONS
-- Xilinx products are not designed or intended to be fail-
-- safe, or for use in any application requiring fail-safe
-- performance, such as life-support or safety devices or
-- systems, Class III medical devices, nuclear facilities,
-- applications related to the deployment of airbags, or any
-- other applications that could lead to death, personal
-- injury, or severe property or environmental damage
-- (individually and collectively, "Critical
-- Applications"). Customer assumes the sole risk and
-- liability of any use of Xilinx products in Critical
-- Applications, subject only to applicable laws and
-- regulations governing limitations on product liability.
-- 
-- THIS COPYRIGHT NOTICE AND DISCLAIMER MUST BE RETAINED AS
-- PART OF THIS FILE AT ALL TIMES.
-- 
-- DO NOT MODIFY THIS FILE.

-- IP VLNV: xilinx.com:ip:mdm:3.2
-- IP Revision: 16

LIBRARY ieee;
USE ieee.std_logic_1164.ALL;
USE ieee.numeric_std.ALL;

LIBRARY mdm_v3_2_16;
USE mdm_v3_2_16.MDM;

ENTITY skrach_design_mdm_1_3 IS
  PORT (
    Debug_SYS_Rst : OUT STD_LOGIC;
    Dbg_Clk_0 : OUT STD_LOGIC;
    Dbg_TDI_0 : OUT STD_LOGIC;
    Dbg_TDO_0 : IN STD_LOGIC;
    Dbg_Reg_En_0 : OUT STD_LOGIC_VECTOR(0 TO 7);
    Dbg_Capture_0 : OUT STD_LOGIC;
    Dbg_Shift_0 : OUT STD_LOGIC;
    Dbg_Update_0 : OUT STD_LOGIC;
    Dbg_Rst_0 : OUT STD_LOGIC;
    Dbg_Disable_0 : OUT STD_LOGIC
  );
END skrach_design_mdm_1_3;

ARCHITECTURE skrach_design_mdm_1_3_arch OF skrach_design_mdm_1_3 IS
  ATTRIBUTE DowngradeIPIdentifiedWarnings : STRING;
  ATTRIBUTE DowngradeIPIdentifiedWarnings OF skrach_design_mdm_1_3_arch: ARCHITECTURE IS "yes";
  COMPONENT MDM IS
    GENERIC (
      C_FAMILY : STRING;
      C_JTAG_CHAIN : INTEGER;
      C_USE_BSCAN : INTEGER;
      C_BSCANID : INTEGER;
      C_DEBUG_INTERFACE : INTEGER;
      C_USE_CONFIG_RESET : INTEGER;
      C_AVOID_PRIMITIVES : INTEGER;
      C_INTERCONNECT : INTEGER;
      C_MB_DBG_PORTS : INTEGER;
      C_USE_UART : INTEGER;
      C_DBG_REG_ACCESS : INTEGER;
      C_DBG_MEM_ACCESS : INTEGER;
      C_USE_CROSS_TRIGGER : INTEGER;
      C_EXT_TRIG_RESET_VALUE : STD_LOGIC_VECTOR;
      C_TRACE_OUTPUT : INTEGER;
      C_TRACE_DATA_WIDTH : INTEGER;
      C_TRACE_CLK_FREQ_HZ : INTEGER;
      C_TRACE_CLK_OUT_PHASE : INTEGER;
      C_TRACE_ASYNC_RESET : INTEGER;
      C_TRACE_PROTOCOL : INTEGER;
      C_TRACE_ID : INTEGER;
      C_S_AXI_ADDR_WIDTH : INTEGER;
      C_S_AXI_DATA_WIDTH : INTEGER;
      C_S_AXI_ACLK_FREQ_HZ : INTEGER;
      C_M_AXI_ADDR_WIDTH : INTEGER;
      C_M_AXI_DATA_WIDTH : INTEGER;
      C_M_AXI_THREAD_ID_WIDTH : INTEGER;
      C_ADDR_SIZE : INTEGER;
      C_DATA_SIZE : INTEGER;
      C_M_AXIS_DATA_WIDTH : INTEGER;
      C_M_AXIS_ID_WIDTH : INTEGER
    );
    PORT (
      Config_Reset : IN STD_LOGIC;
      Scan_Reset : IN STD_LOGIC;
      Scan_Reset_Sel : IN STD_LOGIC;
      Scan_En : IN STD_LOGIC;
      S_AXI_ACLK : IN STD_LOGIC;
      S_AXI_ARESETN : IN STD_LOGIC;
      M_AXI_ACLK : IN STD_LOGIC;
      M_AXI_ARESETN : IN STD_LOGIC;
      M_AXIS_ACLK : IN STD_LOGIC;
      M_AXIS_ARESETN : IN STD_LOGIC;
      Interrupt : OUT STD_LOGIC;
      Ext_BRK : OUT STD_LOGIC;
      Ext_NM_BRK : OUT STD_LOGIC;
      Debug_SYS_Rst : OUT STD_LOGIC;
      Trig_In_0 : IN STD_LOGIC;
      Trig_Ack_In_0 : OUT STD_LOGIC;
      Trig_Out_0 : OUT STD_LOGIC;
      Trig_Ack_Out_0 : IN STD_LOGIC;
      Trig_In_1 : IN STD_LOGIC;
      Trig_Ack_In_1 : OUT STD_LOGIC;
      Trig_Out_1 : OUT STD_LOGIC;
      Trig_Ack_Out_1 : IN STD_LOGIC;
      Trig_In_2 : IN STD_LOGIC;
      Trig_Ack_In_2 : OUT STD_LOGIC;
      Trig_Out_2 : OUT STD_LOGIC;
      Trig_Ack_Out_2 : IN STD_LOGIC;
      Trig_In_3 : IN STD_LOGIC;
      Trig_Ack_In_3 : OUT STD_LOGIC;
      Trig_Out_3 : OUT STD_LOGIC;
      Trig_Ack_Out_3 : IN STD_LOGIC;
      S_AXI_AWADDR : IN STD_LOGIC_VECTOR(3 DOWNTO 0);
      S_AXI_AWVALID : IN STD_LOGIC;
      S_AXI_AWREADY : OUT STD_LOGIC;
      S_AXI_WDATA : IN STD_LOGIC_VECTOR(31 DOWNTO 0);
      S_AXI_WSTRB : IN STD_LOGIC_VECTOR(3 DOWNTO 0);
      S_AXI_WVALID : IN STD_LOGIC;
      S_AXI_WREADY : OUT STD_LOGIC;
      S_AXI_BRESP : OUT STD_LOGIC_VECTOR(1 DOWNTO 0);
      S_AXI_BVALID : OUT STD_LOGIC;
      S_AXI_BREADY : IN STD_LOGIC;
      S_AXI_ARADDR : IN STD_LOGIC_VECTOR(3 DOWNTO 0);
      S_AXI_ARVALID : IN STD_LOGIC;
      S_AXI_ARREADY : OUT STD_LOGIC;
      S_AXI_RDATA : OUT STD_LOGIC_VECTOR(31 DOWNTO 0);
      S_AXI_RRESP : OUT STD_LOGIC_VECTOR(1 DOWNTO 0);
      S_AXI_RVALID : OUT STD_LOGIC;
      S_AXI_RREADY : IN STD_LOGIC;
      M_AXI_AWID : OUT STD_LOGIC_VECTOR(0 DOWNTO 0);
      M_AXI_AWADDR : OUT STD_LOGIC_VECTOR(31 DOWNTO 0);
      M_AXI_AWLEN : OUT STD_LOGIC_VECTOR(7 DOWNTO 0);
      M_AXI_AWSIZE : OUT STD_LOGIC_VECTOR(2 DOWNTO 0);
      M_AXI_AWBURST : OUT STD_LOGIC_VECTOR(1 DOWNTO 0);
      M_AXI_AWLOCK : OUT STD_LOGIC;
      M_AXI_AWCACHE : OUT STD_LOGIC_VECTOR(3 DOWNTO 0);
      M_AXI_AWPROT : OUT STD_LOGIC_VECTOR(2 DOWNTO 0);
      M_AXI_AWQOS : OUT STD_LOGIC_VECTOR(3 DOWNTO 0);
      M_AXI_AWVALID : OUT STD_LOGIC;
      M_AXI_AWREADY : IN STD_LOGIC;
      M_AXI_WDATA : OUT STD_LOGIC_VECTOR(31 DOWNTO 0);
      M_AXI_WSTRB : OUT STD_LOGIC_VECTOR(3 DOWNTO 0);
      M_AXI_WLAST : OUT STD_LOGIC;
      M_AXI_WVALID : OUT STD_LOGIC;
      M_AXI_WREADY : IN STD_LOGIC;
      M_AXI_BRESP : IN STD_LOGIC_VECTOR(1 DOWNTO 0);
      M_AXI_BID : IN STD_LOGIC_VECTOR(0 DOWNTO 0);
      M_AXI_BVALID : IN STD_LOGIC;
      M_AXI_BREADY : OUT STD_LOGIC;
      M_AXI_ARID : OUT STD_LOGIC_VECTOR(0 DOWNTO 0);
      M_AXI_ARADDR : OUT STD_LOGIC_VECTOR(31 DOWNTO 0);
      M_AXI_ARLEN : OUT STD_LOGIC_VECTOR(7 DOWNTO 0);
      M_AXI_ARSIZE : OUT STD_LOGIC_VECTOR(2 DOWNTO 0);
      M_AXI_ARBURST : OUT STD_LOGIC_VECTOR(1 DOWNTO 0);
      M_AXI_ARLOCK : OUT STD_LOGIC;
      M_AXI_ARCACHE : OUT STD_LOGIC_VECTOR(3 DOWNTO 0);
      M_AXI_ARPROT : OUT STD_LOGIC_VECTOR(2 DOWNTO 0);
      M_AXI_ARQOS : OUT STD_LOGIC_VECTOR(3 DOWNTO 0);
      M_AXI_ARVALID : OUT STD_LOGIC;
      M_AXI_ARREADY : IN STD_LOGIC;
      M_AXI_RID : IN STD_LOGIC_VECTOR(0 DOWNTO 0);
      M_AXI_RDATA : IN STD_LOGIC_VECTOR(31 DOWNTO 0);
      M_AXI_RRESP : IN STD_LOGIC_VECTOR(1 DOWNTO 0);
      M_AXI_RLAST : IN STD_LOGIC;
      M_AXI_RVALID : IN STD_LOGIC;
      M_AXI_RREADY : OUT STD_LOGIC;
      LMB_Data_Addr_0 : OUT STD_LOGIC_VECTOR(0 TO 31);
      LMB_Addr_Strobe_0 : OUT STD_LOGIC;
      LMB_Ready_0 : IN STD_LOGIC;
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
