docquantum/skrach-synth/(commit log)

2020-04-13 Added schematic for midi, added initial project for milestone 1
    [midiIn.fzz]
2020-04-22 Current version of final with non-op lab4 ip
2020-04-24 Verison with working decode and pitch shift
2020-04-27 Current Skrach implementation, no working audio codec in IP core
